Every-Flavor-Robotics/mm-launcher/mm-launch-hw/v3/renders/attempt-1/progress.md

tools: c2c282d
planner | PARTS line added to build_assembly.py; checks.json rewritten for v3 (rows tagged v3-A1) | cadcheck 0F/11W (--only flexures,assembly, run on the unchanged v2 A7 model: 10 vertical-hook flexure warns + 102 not-in-step objects that the work items delete) | 103 screws, 36 parts (PARTS 36 printed, 107 metal)

planner full check | v3 checks.json on the unchanged v2 A7 model (baseline for the work items; cadcheck_planner_baseline.json) | cadcheck 57F/111W: 24 fasteners + 15 slide + 5 clearance + 3 distances + 2 interference + 1 service are rows waiting for the v3 geometry; 7 parts fails are real layer-support fails under the c2c282d printcheck (base_shell 6.0 cantilever at world (-79.5,-108,45); jar_valve lug undersides 5.5 x3 at z 274.9; post_R 11.7 at z 244 and feeder_cover ears 10.5 x2, both removed by merges) | 103 screws, 36 parts

base | partition merged into PRT_base_floor (card guides 1.77+0.3, 2.0 header-side / 0.5 component-side, slot-bottom stop z 13; deck ribs x -62..-56 / -15..-9 end 0.5 over the MotorGo top); buck: flange strips under 2 floor hook rails (45 deg undercut lips, 0.2 gap) to +X end stops, -X held by 2 full-height shell wall ribs 0.3 off (CAPT, no tongue, no flexure); controller: +0.4 fences + 2 in-floor SNAP-IP tongues (L 32 w 2.5, lip 1.0 on the short-edge strips, 12.8/15.4 MPa); floor: 2 +Y SNAP-IP latches (L 35 w 2.5, square barb 1.5, finger-pad holes O9, 16.1/21.4 MPa) + 2 -Y 45/45 detents (L 30 w 3, 0.8, 14.0 MPa) in bridged keeper pockets on the shell wall feet (replaces the planner's -Y rigid hook tabs: a rigid hook cannot leave on the straight -Z drop the slide row tests), 8 shell columns removed; pan drive: plate on 4 deck-post pins O4 x 3.5 with 3 crush ribs (0.15), floor column top 27.8 under the idler boss, clamp deleted, pinion horn pocket 20.2 x 2.7 + 8 pins O2.0 x 2.4; FST_adapter = 2 x M3_pan x 10 (diagonal, cbore 2.4 flush) + 4 deck fences (+X fence from z 76 so the rail stem exits); base_shell anchor top 45 deg (baseline 6.0 cantilever gone); USB-C opening gable top; checks.json: flexures x6 exact, allows floor x shell 58 mm3 / pan mount x shell 3 mm3, 6 new slide rows (buck x4, controller, MotorGo out), 4 accepted_warns (barb/lip ledges, anchor knife edge). Base fails left are other items': FST_post_0..6 blocked by base_shell and base_shell x turntable 0.26 (pan_stage: posts merge, hub tube to hub_gear) | cadcheck 48F/106W full (baseline 57F/111W); --only parts,interference,clearance,fasteners,slide,assembly,insertion,flexures,distances 47F/98W, 0 on base-owned joints; printcheck base_shell,base_floor,pan_servo_mount,pan_pinion 0F/4W | 75 screws, 34 parts (79 metal)

pan_stage | posts merged into PRT_turntable (R_ID, bottom-down; 45 deg cone hub cavity + flat R12.3 roof z 100, 2 closed tunnels 93.6..100.3 with R15 bends, release-slotted hook slots); R20 hub tube on PRT_hub_gear (chamfered top, 3 SNAP-V fingers 12.6 MPa, 3 dogs); groove cap, post_R_cover, feeder_housing gone (beam z 252..263 with feeder.housing_geom, 4 SNAP-V hooks 9.2/12.9 MPa, 3 IF_CROWN_HOOKS slots, servo + idler tongues); servo pocket/idler/passage open to the top, journal plate top-open fork (IF_TILT_FORK_*, launcher.py 4-line edit); adapter HORN pocket 2.7 + 8 pins, key-down cone; splice l 20 z 72..92, every bus lead its own filleted route (params fillet_path); FST_feedmount/FST_fplate deleted with the housing (feeder adds crown hooks) | cadcheck --only interference,clearance,fasteners,slide,service,assembly,insertion,flexures,cables,distances 23F/52W (pan_stage-owned 0F; left: FST_jp x3 launcher, crown/feeder-servo slides + feeder_cover feeder, nip/gate/cover/enc/hinge rows launcher+feeder); printcheck turntable,hub_gear,beam,tilt_horn_adapter,thrust_ring 0F/2W | 38 screws, 29 parts (42 metal)

pan_stage full check | front beam hooks y 18.0 w 3.0 with 1.4 release slots (cleared the 1.9 ledges and 0.16 walls), adapter one solid of revolution, 5 wall/bevel warns triaged in accepted_warns, allow beam x turntable 8.5 (slide measures 7.97) | cadcheck 28F/80W full (45 untriaged; 0 F on pan_stage-owned rows; FST_jp_0..2 launcher, the rest launcher/feeder as before); printcheck turntable,hub_gear,beam,tilt_horn_adapter 0F/0W; stability 31.1 deg; held_poses [] | 38 screws, 29 parts (42 metal)

launcher | FST_nacelle/enc/jp/cover/hinge+nut/nipstop/nipcover/leaf deleted (launcher metal now FST_motor x4 M3_pan x10, FST_fw_bolt x2 M3_cap x20 + 2 nuts, FST_nip_stud M3_hex x16 + FST_tw_nut); nip_stop merged into launcher_body (v2 pad section over x 7.5..31.5; hood end face relieved 0.3 above the pad's top edge so the stop touches face-only, fits contact_normal [0,0.998,0.058]); nip_stop_sleeve = integral R3.6 spigot on nip_wheel (nut slides in a side slot); hinge: O5 body stub into the hood -X bore + hood O5 stub into a journal-plate bore (0.15 radial); journal plate on 3 O5 body pegs (3 crush ribs 0.1 per hole); encoder cap in a nacelle rear counterbore (nacelle +4 rearward, lobe keys the Plink) with 2 SNAP-IP arc arms L18 w1.5 0.6 (14.6 MPa) into groove segments; nip cover: +x 45 deg tongue (1.0 deep) in a land rebate + -x skirt lip in a 45 deg groove in the body's x 4 face (the -x undercut could not print left-wall-down), feet 0.15 off the land, slides off +V (rebates stop it at -V), SNAP-IP detent arm L16 w1.5 0.45 (13.8 MPa); leaf root block down to 0.25 over the land (captive: roof/land/end walls/stud fork); wheel cover: 2 hook tabs under journal-plate pockets + SNAP-IP latch L22 w1.5 hook 0.8 (13.0 MPa) behind a plate lip, slides +Y at tilt 45; checks: allows bounded (cover x jp 3, ecap x nacelle 8, nip cover x body 2.5, body x jp 2), hood bay rays replace the nearest rows, slide/insert dirs, flexure rows exact, stud captive, 6c merged into 6d, 13 accepted_warns (stale removed) | cadcheck 17F/73W full (29 untriaged; 0 F on launcher objects: all 17 are feeder-item rows); --only interference,clearance,fasteners,slide,service,flexures,distances,drop,sightlines,stacks,insertion,assembly 0 launcher F; swept entry arc 8.098/8.222/8.415 >= 8.0; drops 31/31 every pose, flattest 34.5; magnet stack 0.3; printcheck nacelle,launcher_body,journal_plate,launcher_cover,hood,nip_wheel,nip_cover,encoder_cap,nip_leaf 0F/3W | 21 screws, 27 parts (24 metal)

feeder | PRT_feeder_cover merged into PRT_feeder_crown (one top plane z 322: jar stack raised 36 mm, params JAR_LIFT, because the v2 lobe roof stood 36 over the 286 rim and could not print top-down; servo up into the open-bottom lobe, 4 crush ribs 0.1, roof stop + blind idler recess); 3 SNAP-V crown hooks (L16 t1.0 barb 0.55, 10.3/12.3 MPa) through the beam slots; pinion HORN pocket 2.7 + 8 pins, no centre screw; gate SNAP-IP finger (L15 w1.5 bump 0.4, 14.0 MPa) in a +Y cheek closed notch (open notch impossible: cheek face 30 long vs 52 travel; open = positive stop), ray row 0.1; valve-adapter option (b): push fit, key rib + groove, shoulder R28.3 on the cheek tops, 2 SNAP-V cheek fingers 11.0 MPa into a spout groove; valve lugs 50 deg undersides (baseline 5.5 mm cantilevers gone); FST_fcover/fhorn/valve/detent and PRT_gate_detent deleted; allows crown x beam 12, servo x crown 12; 7 accepted_warns (flexures x5 vertical, walls x3, 2 not-proven sampling) | cadcheck 0F/63W full (13 untriaged: 11 launcher/cable/insertion + 2 feeder not-proven, accepted after the run: --only interference 0F/18W, 4 untriaged, none feeder); printcheck beam,feeder_crown,feeder_pinion,feeder_disc,jar_adapter,jar_valve,jar_gate 0F/0W; stability 29.6 deg (31.1 before the jar lift) | 11 screws, 25 parts (PARTS 25 printed, 14 metal: 11 screws + 3 nuts; FASTENERS 4 distinct)

finish triage | 13 old substring accepts -> {check, kind, object, why} (summary.accept_suggestions, 2 stale v2 whys updated), 8 new accepts with measured whys (flywheel 2.9 nut-pocket roofs, journal-plate fork knife edges 0.22, launcher_cover edge-break clamp, 4 hood overtravel 'not proven' cells (cad q sweep >= 0.158/6.5/7.39/7.89), bundle/base hand-over 5.7 chord = v2 A6-02), stale allow BUY_horn_* x PRT_*horn_adapter removed, step 7 pose PIV_tilt 20 (pod insertion warn gone), CAB_encoder moved to S -1.6 in the journal bore (shared-tube warn gone), finish.bom_items rewritten (v3 splice z 72..92, roof z 100, bus z 92, encoder budget text), stale orient strings nip_wheel/nip_cover, v2-A5-03 splice why 25 -> 20 | cadcheck 0F/61W full (0 untriaged, 0 config, unused_allows {}, held_poses [], unordered []) | 11 screws, 25 parts (PARTS 25 printed, 14 metal: 11 screws + 3 nuts)

finish BOM | BOM_AND_ASSEMBLY.md rewritten for v3: evidence summary, purchased parts (17 + 14a), fastener table (5 screw rows + nut row), 25-part table with orientations / g / h / v3 change, assembly steps 1..16 in assembly_order order (24 labels), service table (tool-free except the 2.5 L-key and a flat screwdriver), renders, 61 triaged warns; cad bom PASS 5 rows, 0 disagree, 0 modelled screws in no row | cadcheck 0F/61W | 11 screws, 25 parts

finish renders + final | CAD_RENDER_FINAL view set (iso, iso_front_left, front, side, top, rear, exploded, 4 poses) + 4 sections (hub roof y 4.02, beam hook y 18, crown hook y 0, gate finger z 325.35) in renders/attempt-1; cad printcheck stl --manifest: PASS 25 parts 0F/9W, all fit P1S; final full cad check after the render rebuild: PASS 0F/61W, 0 untriaged, 0 config, unused_allows {}, held_poses [], unordered []; DESIGN_LOG 'Attempt 1 results (finish)' appended (joint table with measured rows, plan deltas, FASTENERS/PARTS lines) | cadcheck 0F/61W | 11 screws, 25 parts (PARTS 25 printed, 14 metal (11 screws, 3 nuts/pins); FASTENERS 11 screws, 4 distinct)

finish deliverables | cad printcheck stl --manifest re-run: PASS 25 parts 0F/9W (all 9 accepted); cad sheet -> renders/attempt-1/stl_sheet.png; blender/cadcheck.json (04:12 full run) copied to renders/attempt-1/cadcheck.json; cad bom PASS 5 rows 0 disagree; coverage/not_checked quotes appended to BOM section 8 and DESIGN_LOG Attempt 1 results | cadcheck 0F/61W | 11 screws, 25 parts

## Plan
Joint table and architecture: ../../DESIGN_LOG.md "Attempt 1: plan". Targets: 14 metal (10 screws + 4 nuts), 4 specs, 25 printed.
Kept metal: FST_motor x4 (M3 pan x10), FST_fw_bolt x2 + nut x2, FST_nip_stud + FST_tw_nut, FST_pinion_ctr + FST_tilt_horn_ctr (M3 cap x6), FST_adapter x2 (M3 pan x10, was 4 x csk 20).
Merges: post_L+post_R -> turntable; feeder_housing -> beam; feeder_cover -> crown; base_partition -> floor; nip_stop -> launcher_body; nip_stop_sleeve -> nip_wheel.
Eliminated: groove_cap (tunnels + bore roof, splice from below), post_R_cover (top-loaded tilt servo, beam locks it), pan_servo_clamp (floor column), gate_detent (finger in the gate).
Work items in order: 1 base, 2 pan_stage, 3 launcher, 4 feeder, 5 finish. Each: edit its module, cad build, cad check --only <its sections>, fix fails, append a line here.
Row ownership: every checks.json row tagged v3-A1 belongs to the item named in its text; `_todo` keys say what to make exact.

## Tool issues
- launcher: fits contact_normal only tests the first object's triangles, so any edge of the stop face lying inside the other part's face puts the neighbouring face in the contact and fails it (worked round with a 0.3 relief on the hood end face). slide_out `flex` names the stationary part, so a snap arm that rides ON the mover can only be bounded through its allow's max_mm3.
- none blocking. cadlib has no snap / bayonet / dovetail helper (snaps are built from G primitives); `flexures` warns (not fails) on vertical hooks under 15 MPa, so they go to accepted_warns with the stress.
- accepted_warns: all 22 carried entries use the deprecated substring "match" form (config warn); the finish item rewrites them as {check, kind, object, why}.
- feeder: distances `ray` rows cast +dir to b and -dir to a from the origin, so the origin must sit in the gap (an origin inside a reads the wrong face; checks-config does not say so). Planner joint-table items that were geometrically infeasible: crown top-down with the lobe roof on the bed (needs one top plane), gate open notch in the +Y cheek, valve bayonet keyed by the gate lug.
- finish: the acceptance line 'PARTS 25 printed, 14 metal (10 screws, 4 nuts/pins)' / 'FASTENERS 10 screws' cannot be met without relabelling the M3_hex nip stud as a pin; the build counts it as a screw (11 + 3 = the same 14 pieces, 4 specs). Left as built; DESIGN_LOG 'Deltas from the plan'.
