Every-Flavor-Robotics/mm-launcher/mm-launch-hw/DESIGN_BRIEF.md

# M&M Launcher Turret: Design Brief

> **Change notice (after attempt 1 started):** the encoder magnet goes on the motor's **rear** shaft, through the end-cap access hole. See the BLDC row. Any design that puts the magnet on the front shaft or flywheel must be updated, and reviewers should flag it.
>
> **Change notice 2:** the MotorGo Axis USB-C location is now confirmed. It is a vertical-mount port (see the MotorGo row), so the cable exits perpendicular to the board face. Designs must provide a plug cutout and cable exit path that match it, and reviewers should check it.
>
> **Change notice 4:** an exact MotorGo Axis model is now in `reference/mg_axis.step` / `.stl`. Use it for the placeholder, the standoff height (header pins reach 7.25 mm below the board), and the USB-C cutout position.
>
> **Change notice 3:** servo horn (round 8-hole disc, recess plus drill-through-as-template) and servo controller (58 x 42 PCB, drill-to-fit bosses plus a locating pocket) are now specified in the component table.

A desktop turret that holds a hopper of standard M&Ms (plain, about 13 mm across and 7 mm thick, lentil shaped), feeds them one at a time into a spinning flywheel, and launches them at an adjustable speed. Pan/tilt aiming. It's controlled from a browser over WebUSB, and the browser shows the CAD moving live, so moving parts must be separate objects with clean pivots.

## Hard constraints
- **Material:** all structure is PLA. No TPU. The wheel grip surface is hockey tape or similar wrapped on a PLA rim, so leave a tape land on the rim (flat, about 12–15 mm wide). Make wheel-to-hood compression adjustable (slots or shims), because grip and pressure will be tuned by hand.
- **Printers:** Bambu Lab H2D (single-nozzle build volume 325 x 320 x 325 mm) and P1S (256 x 256 x 256 mm). Prefer every printed part to fit the P1S. Parts must print without heavy supports: a flat face on the bed and overhangs of 45° or less, or bridges.
- **Assembly:** one person with a DeWalt hand drill and a full bit set, superglue, hot glue, M3 machine screws (use heat-set inserts only if needed; prefer nut traps or self-tapping M3 into 2.5 mm pilot holes), and self-tapping M3 screws. No other fasteners or bearings are assumed. If a 608 bearing or a lazy-susan bearing would help a lot, it may be listed as optional, but the design must work without it.
- **Cables:** every cable has a planned path: motor phase leads (3 x Ø4 bullet leads, 80 mm), JST 5-pin encoder cables, the servo bus daisy chain, 12 V power, and a USB-C cable from the MotorGo Axis out to a laptop. No visible loose wires. Cables crossing the pan axis need a defined pass-through and slack loop for ±90° pan or more.
- **Power:** a DeWalt 20V battery slides onto the DeWalt adapter, which feeds the 12 V buck converter, which feeds the MotorGo Axis (6–17 V input) and the servo controller board. The battery must be removable without tools. The buck converter needs airflow around its fins.

## Components (purchased, model as accurate placeholder solids in a `Purchased` collection)
Reference files are in `mm-launch-hw/reference/`. Read the PNG drawings.

| Part | Qty | Key dims (mm) | Notes |
|---|---|---|---|
| MotorGo Axis (ESP32-S3 BLDC driver) | 1 | **Exact model: `reference/mg_axis.step` / `mg_axis.stl` (user-supplied; import the STL as `BUY_motorgo_axis`, don't hand-model it).** Envelope 65.0 x 57.25 x 19.47. STEP frame: origin at the top-left mounting hole centre, +X along the 65 mm edge, the board extends toward -Y, and the PCB is at z 0 to about 1.7 (component side +Z). 4 x Ø3.4 mounting holes on a 58.0 x 49.0 rectangle. The tallest top part is the header strip along the top edge, reaching z = 9.0. **That header's pins stick out 7.25 mm under the board (to z = -7.25)**, so use standoffs of 8 mm or more, or a relief slot under that strip. Other undersides are flat. **USB-C measured from the STEP: a vertical receptacle centred at (57.6, -14.0) with its opening facing +Z at z = 7.97.** | `motorgo_axis_dims.png`. Motor phase pads (J6/J8) are along one long edge. **USB-C (user-confirmed, top-right of `motorgo_axis_dims.png`):** a **vertical-mount** receptacle. The cable plugs in perpendicular to the board face, not from an edge. In that image's orientation (header strip along the top edge, motor pads J6/J8 along the bottom edge), the port's centre sits 3.9 mm in from the right edge and 17.5 mm down from the top edge. Its 8.9 x 3.4 mm opening (r1.7 ends) runs with the long axis parallel to the 57.2 mm side. Mount the board so that, directly over the port, a cutout in the enclosure wall or lid clears a USB-C plug overmold (about 12.5 x 7 mm, 1 mm clearance all round). Leave about 25 mm of straight plug length, then a smooth exit path with a bend radius of 15 mm or more toward the rear of the base. A natural layout puts the board face against an enclosure wall so the plug passes straight through it. Add strain relief for the cable (a hot-glue or zip-tie anchor point) so tugs don't load the port. Two encoder JST connectors. |
| Plink magnetic encoder (MT6701), JST 5-pin cable | up to 2 | PCB 20.0 x 23.0 x 4.6 | `plink_encoder.step` / `.stl`. Sensor must face a diametric magnet (about Ø6 x 2.5) on the motor axis, 0.5–2 mm air gap, coaxial within 0.3 mm. `prior_plink*.stl` are earlier holders/cases you can learn from. |
| XTEAM XTI-3674 1900KV inrunner BLDC | 1 | Body Ø35.9 x 74; shaft Ø5 x 21 (14 mm D-flat), front only; front face 4 x M3 on a Ø25 circle; leads exit the rear side | `bldc_xteam_3674_drawing.png`. **Rear shaft access (user-confirmed):** the rear end cap has a small central opening that exposes the rear shaft end. Glue the diametric encoder magnet to the rear shaft end, and mount the Plink encoder behind the motor's rear face, coaxial and with a 0.5–2 mm air gap. Use parameters for the opening and shaft end: default access hole Ø8, shaft end flush to 1 mm recessed. The phase leads exit the rear side, so the encoder mount must clear them. Don't put the magnet on the front shaft or flywheel. |
| Hiwonder bus servo (HTS-35H class) | up to 3 | Body about 40 x 40 x 20.14; output spline on the top face (protrudes 3.9), a coaxial idler boss on the bottom face (3.9) | `servo_hiwonder_drawing.png`. The spline is offset toward one end. Mounting holes are tapped on the case faces, so take a pocket/clamp mount. **Horn (user-confirmed):** a standard round disc RC horn with 8 holes in a concentric pattern around the centre. Parameters: default disc Ø20 x 2.5 thick, 8 x Ø2.2 holes on a Ø14 bolt circle. Each driven part has a shallow (1.0 mm) locating recess sized to the disc (+0.2 mm) so the horn self-centres. Pilot marks only, no pre-printed holes: the user drills through using the horn as a template and fixes it with screws through the horn holes, plus superglue. Keep the horn interface a separate adapter part that's easy to modify. Daisy-chained 3-pin bus. |
| Hiwonder bus servo controller board | 1 | **PCB 58 x 42 (user-confirmed)**; about 14 mm tall components on top, 2 mm under; the white 3-pin ports overhang the long edges by about 1.5 mm | `servo_controller_board_photo.png`. **The M3 hole positions are unconfirmed.** From the photo, the best guess is 4 x Ø3.2 holes on a 51 x 35 rectangle, centred, about 3.5 mm from each edge. Design for drill-to-fit: solid bosses (Ø7) with only a centre-punch dimple at the guessed position, so the user drills pilot holes through the actual board and fixes it with self-tapping M3. Also add a perimeter lip or pocket (+0.4 mm) that locates the PCB without relying on hole position. Layout from the photo: 5 bus ports down each long edge (cables exit sideways), USB-A and micro-USB on the top edge, the power slide switch and Program/Run buttons on the bottom edge, and the blue 2-pole screw terminal at the bottom-right. Keep the power screw terminal, power switch, and 3-pin bus ports reachable. Connect its UART header to the MotorGo. |
| DeWalt 20V battery adapter | 1 | 86.6 x 59 x 23.4; 4 corner screw holes on top | `dewalt_adapter_buck_12v_dims.png`. The battery slides onto it (battery envelope about 115 x 76 x 70; keep clearance for 5Ah packs). |
| 12V buck converter (finned) | 1 | 73.8 x 73.8 x 31 with flange mounting holes | Same PNG. The wire bundle exits one side. |
| DeWalt 20V battery | 1 | about 115 x 76 x 70 envelope (fits both the user's 2Ah and 5Ah packs; keep it) | It's the heaviest item, so put it low for stability. |

## Functional requirements
1. The hopper holds at least 60 M&Ms and has a lid. It feeds reliably with no bridging: steep walls (≥ 50°), plus an agitating, indexed feeder (for example a pocketed rotary disk driven by servo #3) that releases exactly one M&M per fire command.
2. The feed path delivers the M&M into the wheel/hood nip at a defined point. A single PLA flywheel (rim about Ø60–80 mm with a tape land) is direct-driven by the 3674 on the 5 mm D-shaft (M3 set screw and nut trap, or a clamping hub). It needs a curved hood or backplate with an adjustable gap of about 9–12 mm before tape, and a muzzle that sets the exit direction. Target wheel speed is 3,000–6,000 rpm.
3. The wheel must be fully guarded except for the feed entry and the muzzle. Nothing should be able to fly off sideways.
4. Pan servo (≥ ±90°) and tilt servo (about 0 to +45° elevation), with the load path carried by printed structure, not the servo spline alone, wherever practical.
5. The encoder is mounted rigidly and coaxially with the motor shaft and is serviceable.
6. All electronics are mounted with screws and enclosed or tidily exposed, with access to the USB-C, servo controller ports, power switch, and battery. There is an air path for the buck converter and the MotorGo.
7. Stable: it doesn't tip at full tilt or pan, and it stays put when firing.

## Aesthetic goals
Looks designed, not slapped together: consistent fillets and chamfers, a coherent form language, aligned parting lines, hidden fasteners where practical, concealed cable channels, and visual unity between the base, turret, and launcher. Render with a restrained palette: printed parts in two coordinated PLA colors, and purchased parts in realistic neutral colors.

## Deliverables (all under `mm-launch-hw/`)
- `blender/build_assembly.py`: a **parametric** Blender Python script (Blender 5.1, run headless with `/Applications/Blender.app/Contents/MacOS/Blender -b --python <script>`) that builds the whole assembly from named parameters at the top. Use collections `Printed`, `Purchased`, and `Fasteners`. Name objects `PRT_<part>` / `BUY_<part>`. Moving links get empties as pivots: `PIV_pan`, `PIV_tilt`, `PIV_flywheel`, `PIV_feeder`, parented so that rotating an empty moves its subtree. Use bmesh/modifiers (booleans, bevels) so the printed parts are manifold solids.
- `blender/mm_launcher.blend`: the saved assembly.
- `stl/<part>.stl`: one file per printed part, in its print orientation, in mm.
- `blender/checks.py`: an automated report written to `renders/attempt-N/checks.json` covering every printed part's manifold status (non-manifold edge count), bounding box against the P1S and H2D volumes, pairwise interference between parts (BVH overlap), and estimated print time/filament (volume-based).
- `renders/attempt-N/`: PNG renders at 1600 px or more: iso, front, side, top, rear (cable side), exploded view, a section through the launcher (wheel, hood, feed), and pan at -90/+90 with tilt at 0/45.
- `BOM_AND_ASSEMBLY.md`: parts list, print settings per part (orientation, supports yes/no, infill), fastener list, and numbered assembly steps for one person.
