Every-Flavor-Robotics/mm-launcher/mm-launch-hw/v2/renders/attempt-2/progress.md

tools: 6b62667

## Tool issues
- Pin synced to 6b62667 (was 2197aac in attempt 1). The attempt-1 workaround for `distances` rows naming missing objects (KeyError in check_distances) still applies: every new distances row names only objects that already exist; rows for new parts (PRT_nip_stop, PRT_nip_stop_sleeve) are `fits` rows, which match by glob and don't crash.
- cadcheck can't express "line of sight from outside to a printed part is clear" (the ray_gap distances measure each object on its own BVH, `service` only tests FST_ objects, and `exposure` only covers cables and nuts). A1-02 (thumbwheel reachable through the nip cover) is therefore proved with `cad q ray` lines plus a section render, not a checks.json row.
- cadlib has no prismatic joint (asm.joint is rotary only), so the review's `PIV_gate 0..52` isn't possible. The gate's open (running) state is covered by the `slide_out` row "v2-A1-09 gate opens +X 52" with the valve present instead.
- cadcheck `slide_out` can't assert "must be blocked past X" (a blocked slide is always a fail), so the gate's open end stop is a design feature checked by a section, not a row.
- `cad q ray --pose` takes world-frame origin and direction, so a ray from a pod point has to be transformed by hand for tilt 45.
- Check config before modelling, run on the attempt-1 model.blend: 12 F / 36 W (/tmp/a2_precheck_full.json). New rows that fail on A1 geometry, and so would catch each issue: A1-01 (hood/body moving fit 0.39 at hood -0.51; hood/body 0.43 at the gap-5.3 stop, 0.23 at +1 deg past it; hood/wheel 3.23 at +1 deg past it), A1-03 (pocket rays 14.77/15.00 > 14.5), A1-04 (service FST_fhorn_ctr blocked by the housing at 8 mm), A1-05 (feedmount_0/1 to pinion 1.09/1.08 < 2.35), A1-11 (3 rays from the controller to the +X wall miss through the notch).

## Steps
checks | checks.json: attempt-2 rows (v2-A1-NN) for A1-01/02/03/04/05/06/07/09/11 plus the journal audit; precheck on the A1 model | cadcheck 12F/36W (expected: the new rows fail on A1 geometry)

## Plan
Attempt 2 fixes the 5 majors and the cheap minors from review 1 (7/7/6), without touching what it praised: the feed path and index, the jar handling, low CG, the service slides, and 0 fastener fails. Build order is params, pan_stage, launcher, feeder, base, then finish. For each one: edit, `cad build`, `cad check`, and append a line here. Every new row is tagged v2-A1-NN in checks.json.

0. **params (planner IF change).**
   - IF_FEED_BOLTS[0:2] (-36,±18) -> (-36,±21). The pilot sits 28.7 from the pinion axis, which leaves a 3.1 wall to the R24.35 chamber.
   - NIP_SET = (5.3, 7.0) and HOOD_GAP_MIN = 5.3, so HOOD_HI = solve_eps(5.3) = +1.315 deg.
   - New HOOD_LO = the leaf-lift limit above the static max: -0.558 - 1.49 = about -2.05 deg (gap about 8.4). Compute it in launcher_geom.report(). The leaf travel of 1.5 at the stud bottoms on the cover shell.
   - POCKET_D 15 -> 14.4, with POCKET_CH = 1.0.
   - JIG_SPIGOT_D 7.8 -> 7.9 and PLINK_PEG_D 2.4.
   - Gate tab params (R6, flush ±1).
   - Colour map: B (terracotta) = the candy path plus touch points: jar adapter, valve, gate, feeder housing/spout, disc, launcher_body (chute + muzzle), hood, flywheel, thumbwheel. A (grey) = static structure and drivetrain.
1. **pan_stage.** The beam holes follow IF_FEED_BOLTS. Add a step-7 note: the pod drops in nose-up at 20 deg (row v2-A1-06).
2. **launcher (A1-01, A1-02, A1-07, A1-08).**
   - Add PRT_nip_stop: a printed 3x20 land screwed to the guard bay floor (1 x M3 from outside), which the hood back face lands on at gap 5.3. It is a broad face away from the chute entry.
   - Open the bay so the hood keeps ≥ 0.5 to the body over the whole new PIV_hood range.
   - Add PRT_nip_stop_sleeve: a stud sleeve between the hood back face and the thumbwheel (carried on PIV_hood). The thumbwheel bottoms on it at gap 7.0.
   - Add a finger slot 22 x 7 in the nip cover over the thumbwheel rim, with the rim ≥ 2 proud. Put it where a 16 mm finger reaches at tilt 0 and 45; the -v end, away from the post, is the likely spot.
   - Hood nip edge ≥ 1.6; journal-plate ceiling as a 45 deg roof; declare the flywheel 1 mm flange ring.
3. **feeder (A1-03, A1-04, A1-05, A1-08, A1-09, A1-10).**
   - Pocket Ø14.4 + 1x45 rim chamfer.
   - Delete FST_fhorn_ctr: the 4 M2 screws hold the horn to the pinion, and the servo lifts +Z off the spline. Update BOM step 10b.
   - Crown pilots at ±21.
   - 0.8 flats on the baffle and blade knife edges (wall ≥ 1.2).
   - Gate: R6 EB1 tab flush with the valve OD ±1, a positive end stop at 52, and the valve guide clearance ≥ 0.3.
   - EB 1.0 on every feeder part; crown and cover corners R4 -> R6.
4. **base (A1-11).** Replace the 52x24 notch with switch and terminal cutouts plus a printed bezel, keeping them clear of the rows at y 32/50/68, z 14.
5. **finish (A1-12).** Reassign the colours, make BUY_jar a transmissive (alpha) material in the view set, rebuild cg_grid, renders + sections (nip stop, finger slot, pocket with --lentil pair), BOM/DESIGN_LOG.

Acceptance: 0 F, and every v2-A1 row passes. The reviewer's lentil-pair probe (review/add_mm_probe.py, moved to x 7.2/14.4) must overlap. Run `cad q ray` through the finger slot and confirm the first hit is PRT_nip_wheel at tilt 0 and 45.
Deferred:
- Gate detent bumps: a snap overlaps its guide by design, and an `allow` would hide the gate/valve fit. The end stop is enough for now.
- The base_shell x turntable contact fit, which hides the R20 journal: the thrust and journal faces share one pair, and the tool has no per-region fits.
- Stability pose cap (a tool limit); the 64-pose cg_grid stays as the evidence.
params (planner IF change) | IF_FEED_BOLTS -X pair y +/-21 (pilot 28.66 from pinion, wall 3.06; feedmount 3.52 >= 2.35 pass); NIP_SET (5.3,7.0), HOOD_GAP_MIN 5.3, HOOD_HI +1.315, HOOD_LO = -0.558 - 1.493 leaf lift = -2.051 (gap 8.35, HOOD_GAP_MAX derived; printed by launcher_geom.report()); POCKET_D 14.4 + POCKET_CH 1.0 (pocket rays 14.22/14.28 pass); JIG_SPIGOT_D 7.9, PLINK_PEG_D 2.4/HOLE 2.5; gate X1 34.5 flush with valve OD (+0.5), GATE_TAB_R 6, GATE_EB 1, GATE_STOP_X 25; COLOUR_B map + apply_colours() in build_assembly; stacks magnet 0.30<=0.30 no warn, pocket 0.67<=0.8 pass. New fail for launcher: body x nip_cover 29.4 mm3 (narrower bay hull pokes 0.75 past the land face at v 12..20) | cadcheck 9F/37W
pan_stage | beam csk holes already loop over IF_FEED_BOLTS, so the -X pair moved to (-36,±21) with the params change (cad q inside: (-36,±21,256) -> FST_feedmount_0/1 only; old (-36,18,256) -> PRT_beam solid); feedmount_0 straight 54-58 reach, feedmount_1 L-key arc 180 (nacelle at 23.9), both pass; feedmount-pinion 3.52 >= 2.35; step-7 nose-up 20 deg note in pan_stage docstring + BOM step 7 (slide v2-A1-06 passes, 0.2 to post_L at tilt 20); BOM step 11 text updated. No fails involve pan_stage objects; pan_stage warns (beam overhang 205 mm2, hub_gear wall 1.54, post_R x journal_plate at 47.5) identical to precheck | cadcheck 9F/37W
launcher (A1-01/02/08) pass 1 | PIV_nip_lift (leaf lift, thumbwheel+nut) splits PIV_hood (setting -0.558..+1.315, hood/stud/sleeve); PRT_nip_stop pad under the muzzle floor + hood front lug (3.4 x 20 land, contact at +1.315), FST_nipstop M3x6; PRT_nip_stop_sleeve R3.8 x 8.86 (contact at -0.558); STUD_L 16, STUD_HOLE_R 4.4; bay to +2.415 with true normal offset 0.55 (funnel was 0.46) and 48-gon boss; hood flange relief (arc about the flange corner, hood/flywheel 4.10 at +2.315); land-face slab cut (body x nip_cover 0); nip cover -v wall at v -6.5 + finger slot 22 x 7.5, leaf tip -3.5 (open fork); journal plate 1.6/45deg/1.6 lap, journal base re-added after the chamfer; checks.json: fits body x nip_wheel contact, 6c/6e assembly objects | cadcheck 4F/48W (no launcher fails; 4 = feeder FST_fhorn_ctr + 3 base servo_controller rays)
launcher (A1-01/02/08) pass 2 | hood: -v half of the stud hex pocket opened as a U-slot through the 26 deg back face (min wall 0.91 -> 2.25), spot 1.6 deep; relief as an R4.1 arc about each flange corner (step groove stalled 5/31 rays) -> drops 31/31; journal plate lap 1.6/45/1.6 + journal re-added after the chamfer (bridge 47 -> 11.4); nip stop pocket floor-cut 3 mm behind the face (0.2 sliver gone), pilot to the screw tip; DESIGN_LOG attempt-2 launcher section + flywheel flange ring declared | cadcheck 4F/47W (no launcher fails)
launcher acceptance (cad q, model after pass 2) | dist PRT_hood/PRT_nip_stop @hood+1.315 = 0.000 (+0.815: 0.603); dist PRT_nip_stop_sleeve/PRT_nip_wheel @hood-0.558 = 0.000 (-0.458: 0.107); sweep hood/body hood -0.558..2.4 (lift 0) and -0.558..1.315 (lift -1.493) min 0.50 (x wall); finger-slot rays origin nip(x 15.5/19.5/23.5, u 1/2.5/4, v -22) dir +V: tilt 0 first hit PRT_nip_wheel 9/9 (14.4-15.5 mm, e.g. 19.5,-2.330,111.274 -> 19.5,-6.917,124.924), tilt 45 first hit PRT_nip_wheel 9/9 (e.g. 19.5,77.315,143.401 dir 0,-0.895,0.445 -> 19.5,64.42,149.81) | cadcheck 4F/47W
feeder (A1-03/04/05/08/09/10) pass 1 | disc pockets as revolves Ø14.4 + 1x45 top rim chamfer, land top EB 1.0; FST_fhorn_ctr deleted (checks.json step 10b: no centre screw); crown lobe + cover plan corners R6, G.bevel EB 1.0 on housing, crown, cover before cuts; valve profile EBs (skirt foot 0.6, top 1.0), lead-in r0 30.4 -> 29.8, cheeks rooted 1 mm down + EB; baffle outer R31 -> R30.4 (coincident R31 facets with the skirt were the 0.02 slivers) + 0.8 ramp-foot flat; gate R6 plan corners, EB 0.6 blade / 1.0 tab, R6 tab to z 297, GATE_Z +0.35, CHEEK_Y 28.4, slot X0 -27.4, spout Z0 290.7; first open stop = lug under the blade in valve-floor grooves | cadcheck 3F/49W (feeder service fail gone; gate lug on the bed: 18 mm2 bed contact + 55 bridge; cover R6 corners 1.08 over the pocket corners)
feeder pass 2 | stop lug moved on top of the blade's -X end (1.5 x 6 x 1.2) riding in two spout-tip notches (through at -X, blind at +X, shoulder x 26.85 backed by a R28.6 OD boss, 45 deg back), pads raised clear of the lug; gate knife flat 0.8 -> 1.0 (0.8 left a 1.15 probe where the chamfer meets the side EB); COVER_BOX x0 -1, hy +1 (R6 keeps 2.2 over the pocket corners) | cadcheck 3F/47W
feeder pass 3 | adapter flange EB 1.0 -> 0.6 (1.6 flange keeps 1.6), pad bottoms at 292.0 (1.7 under the screw hole); crown land-bore/pinion-chamber fin removed for |y| < 7.3 (was 0.95) | cadcheck 3F/45W (no feeder fails; 3 = base servo_controller rays)
feeder acceptance (cad q / cadcheck, final model) | pocket rays x 14.40 / y 14.40 (13.6..14.5); lentil pair (add_mm_probe.py copy, /tmp/feeda2/probe.py) x 7.0/14.0 overlaps disc 0.577 mm3 each, x 7.2/14.4 0.073/8.439; index +60 1 window [50,60], -60 1 window [-60,-50], column 0 windows at drift 0/5/10/15; service FST_fhorn_ctr row matches nothing (8 ops), slide 'v2-A1-04 feeder servo lifts +Z' not blocked (0.00 = pocket floor); feedmount_0/1 to pinion 3.517/3.517; crown 0 wall samples < 1.6 anywhere (thin probe /tmp/feeda2/thin.py); slide 'v2-A1-09 gate opens +X 52' min 0.35 (adapter), probe slide to 54 blocked by PRT_jar_adapter at 52.5 (shoulder 52.35); gate +X end x 34.5 vs valve OD 34.0 (+0.5); walls: gate 1.31, valve 1.29, adapter 0 samples < 1.6 | cadcheck 3F/45W
base (A1-11) | 52x24 +X notch replaced by a switch window (y 42..57) and a terminal window (y 60..73.5), both z 15.5..22 (1.5 above the z 14 rows), square world-bottom edge (16 mm bridge printed deck-down), 0.8x45 lead-in, one integral bezel frame 2.5 wide x 1.2 proud (world-top side 32 deg from vertical, bottom side 0.5 bp so the rail under the windows keeps 1.6); CTRL_SW / CTRL_TB / CTRL_WIN_* / CTRL_BEZEL in params; BUY_servo_controller gains slide switch + lever (OFF) and 2-pole terminal on its +X (bottom) edge from the REF photo. Rows v2-A1-11 y 32/50/68 = 0.5/0.5/0.5 (0.3..6.0); battery slide 120 min 1.6 (>= 1.0); cad q ray 200,{32,50,68},14 -1,0,0 -> PRT_base_shell at x 120/121.2/121.2; ray 200,47.6,17.5 -> controller lever at x 112.5; ray 200,66,18 -> terminal at x 115.5; preview renders/attempt-2/base_ctrl_bezel.png. Earlier passes: lead-in rounded corners gave 156 mm2 overhang, bezel bottom rail 1.44 wall -> both fixed | cadcheck 0F/44W
finish pass 1 | parts/finish.py added as the last subsystem (owns apply_colours, moved out of build_assembly; BUY_jar glass JAR_GLASS_RGBA alpha 0.25, Workbench honours it: fill visible through the glass in /tmp/fin2/jar_test.png); cg_grid 64 poses worst tip 29.9 deg (jar 0, tilt 46, pan 180, 3935 g incl. jar 350 + fill 400 + band 15) -> renders/attempt-2/cg_grid.txt; cadcheck stability 33.5 deg | cadcheck 0F/44W
finish renders + sections | view set (iso, iso_front_left, front, side, top, rear, pan+90_tilt45; jar glass reads transmissive, fill visible), sections sec_nip_stop_x19.75_hood+1.315 (hood lug on the pad), sec_finger_slot_x19.5, sec_pocket_y18.19_lentil_pair (--lentil 7.2/14.4); cad q: hood/nip_stop @+1.315 0.000, sleeve/nip_wheel @-0.558 0.000, finger-slot rays tilt 0/45 first hit PRT_nip_wheel at 14.4, lentil pair 7.2/14.4 overlaps disc 0.073/8.439 mm3; 12 renders total | cadcheck 0F/44W
finish docs | BOM_AND_ASSEMBLY.md -> attempt 2 (evidence summary, nip stops, pocket/lentil probe, colour table from manifest + COLOUR_B, nipstop fastener, 6c/6e steps, finger-slot service row, renders, 44 warns, not-done); DESIGN_LOG '## Attempt 2' with every v2-A1 row -> value and the cg_grid result; no geometry change | cadcheck 0F/44W
finish final renders | 6c step label M3 x 10 -> M3 x 6 (matches FST_nipstop); CAD_RENDER_FINAL view set 1800x1350 (11 views incl. exploded, jar_unlocked, tilt45, pan-90_tilt0); stl_sheet.png 35 STLs; cadcheck.json copied | cadcheck 0F/44W
finish close-out | checks.json step 7 label (nose-up 20, v2-A1-06); BOM section 6 final set + stl_sheet, section 8 resolved items removed, line-of-sight note for v2-A1-02; DESIGN_LOG attempt 2 close-out + verbatim not_checked; cadcheck.json recopied (03:13) | cadcheck 0F/44W
