Every-Flavor-Robotics/mm-launcher/mm-launch-hw/reference/bldc_xteam_3674_drawing.png

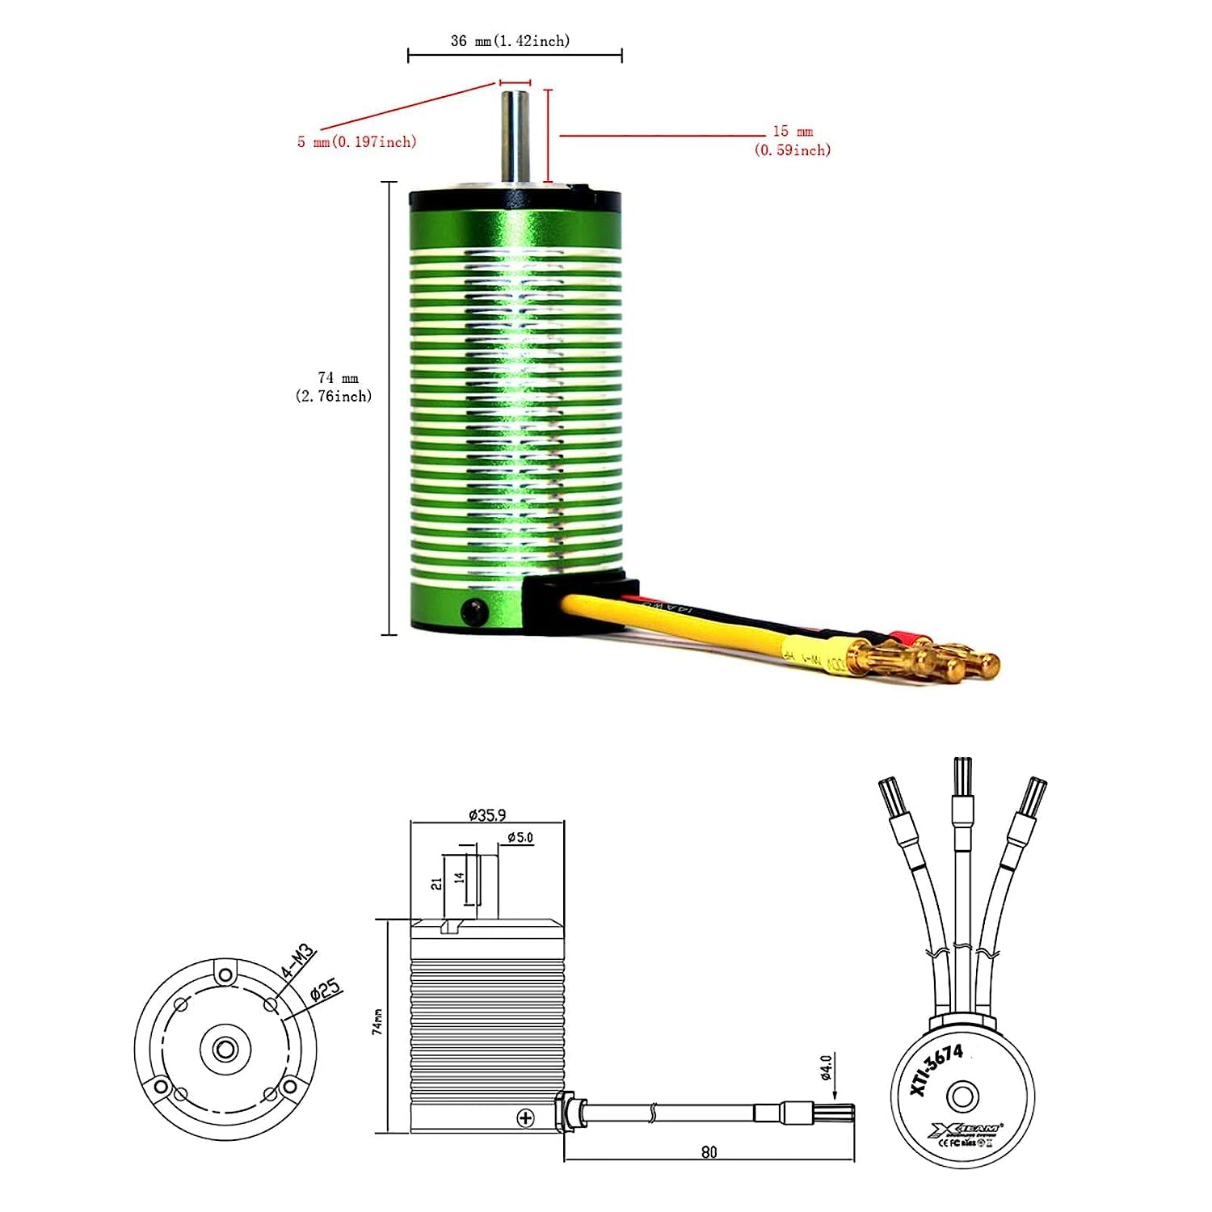
mm-launch-hw/reference/bldc_xteam_3674_drawing.png
