Every-Flavor-Robotics/mm-launcher/mm-launch-hw/reference/dewalt_adapter_buck_12v_dims.png

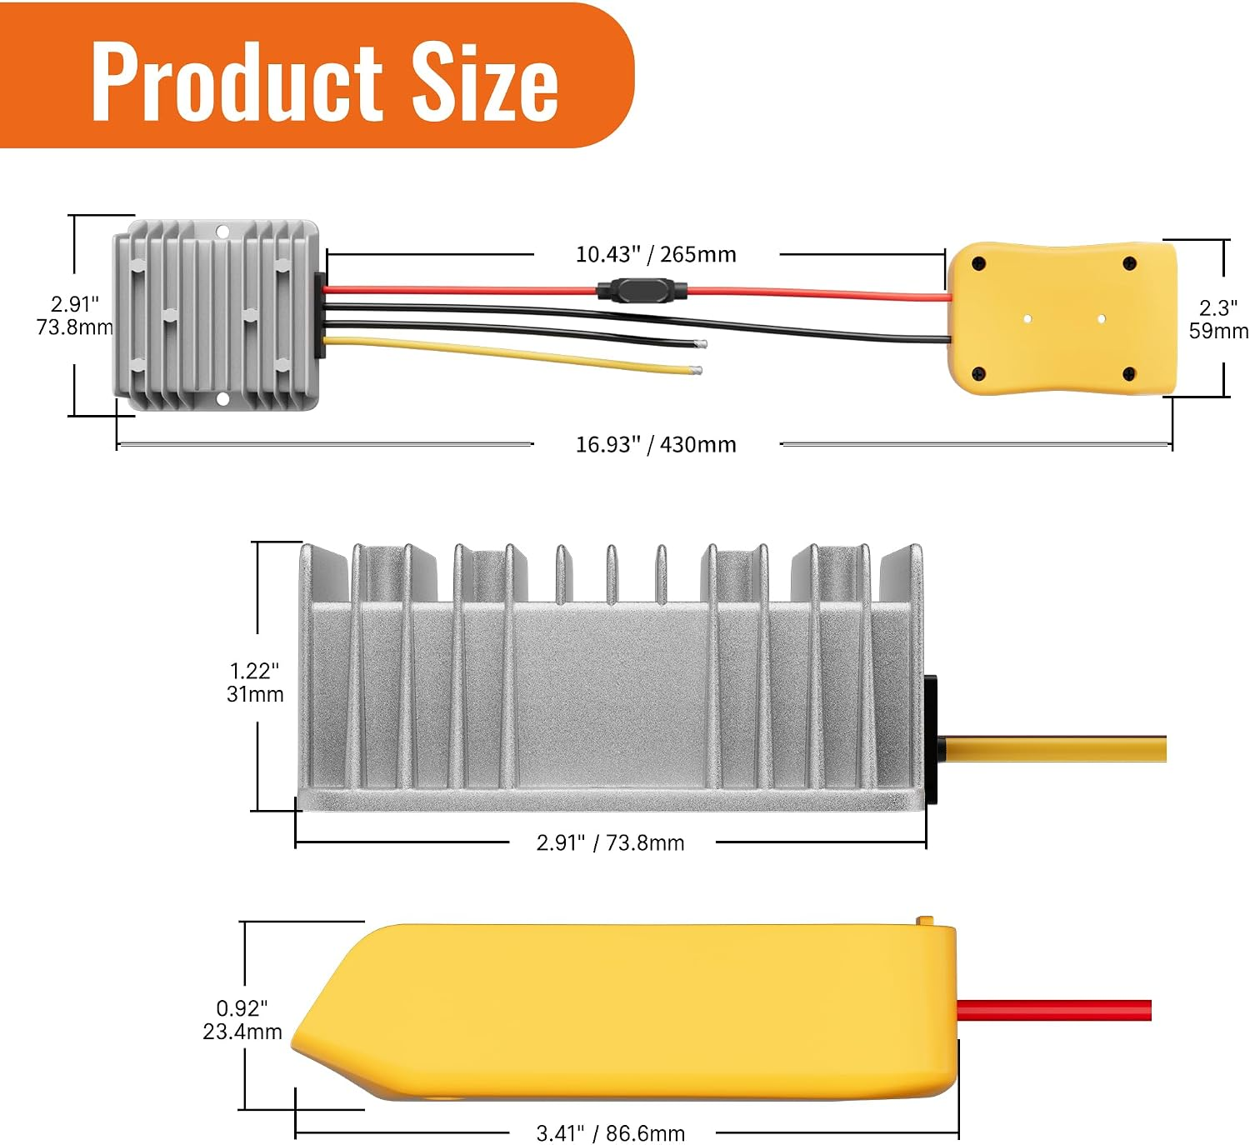
mm-launch-hw/reference/dewalt_adapter_buck_12v_dims.png
