Every-Flavor-Robotics/mm-launcher/mm-launch-hw/reference/motorgo_axis_dims.png

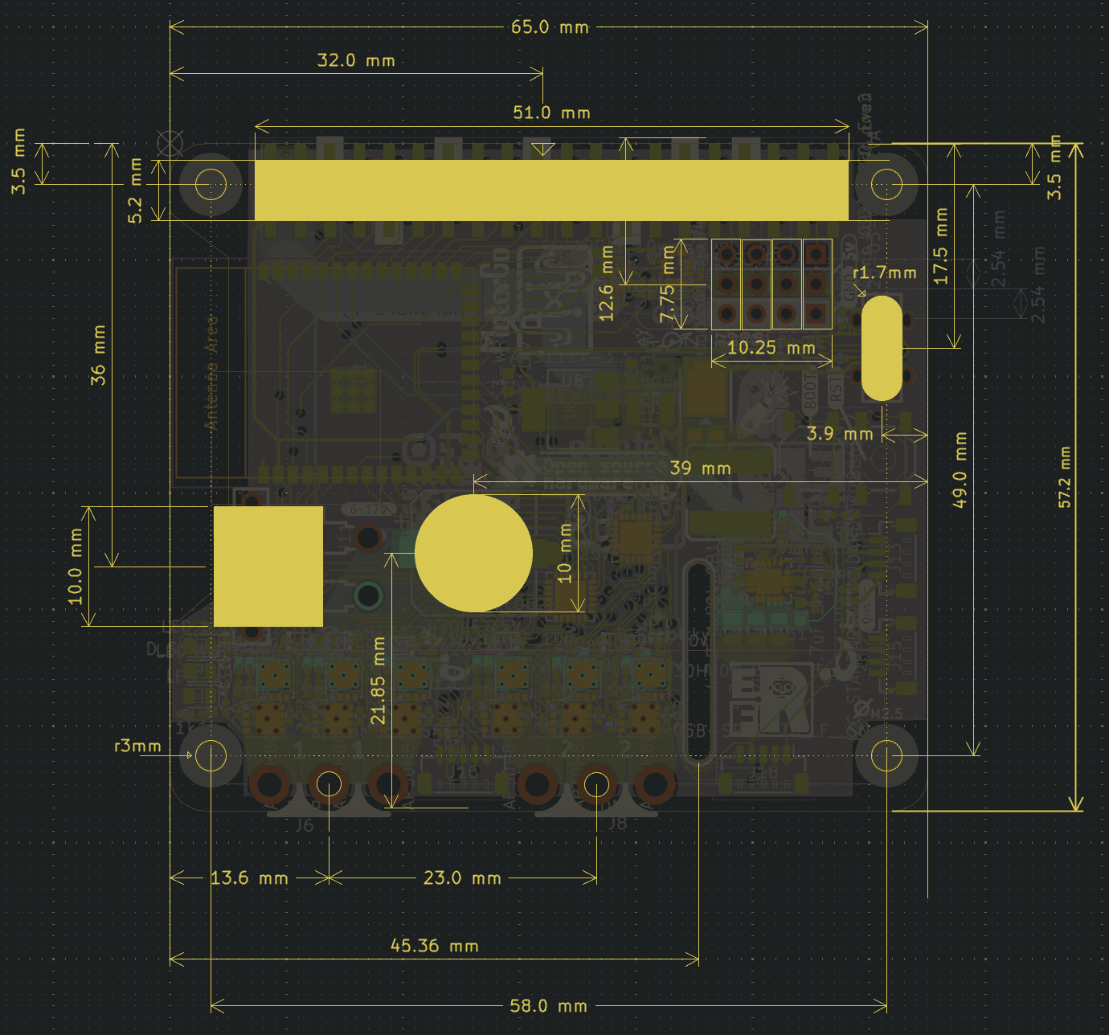
mm-launch-hw/reference/motorgo_axis_dims.png
