Every-Flavor-Robotics/mm-launcher/mm-launch-hw/reference/servo_controller_board_photo.png

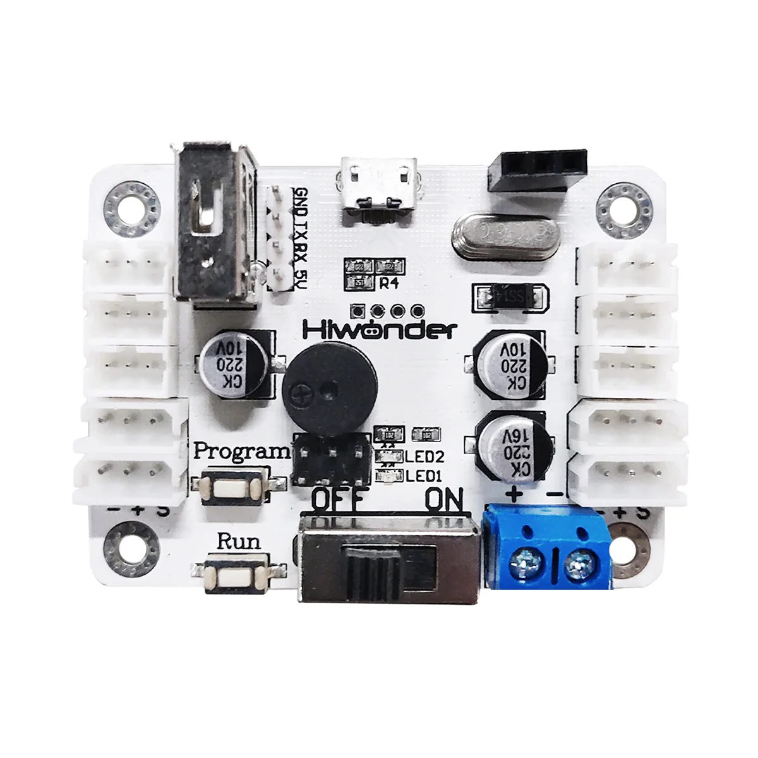
mm-launch-hw/reference/servo_controller_board_photo.png
