Every-Flavor-Robotics/mm-launcher/mm-launch-hw/reference/servo_hiwonder_drawing.png

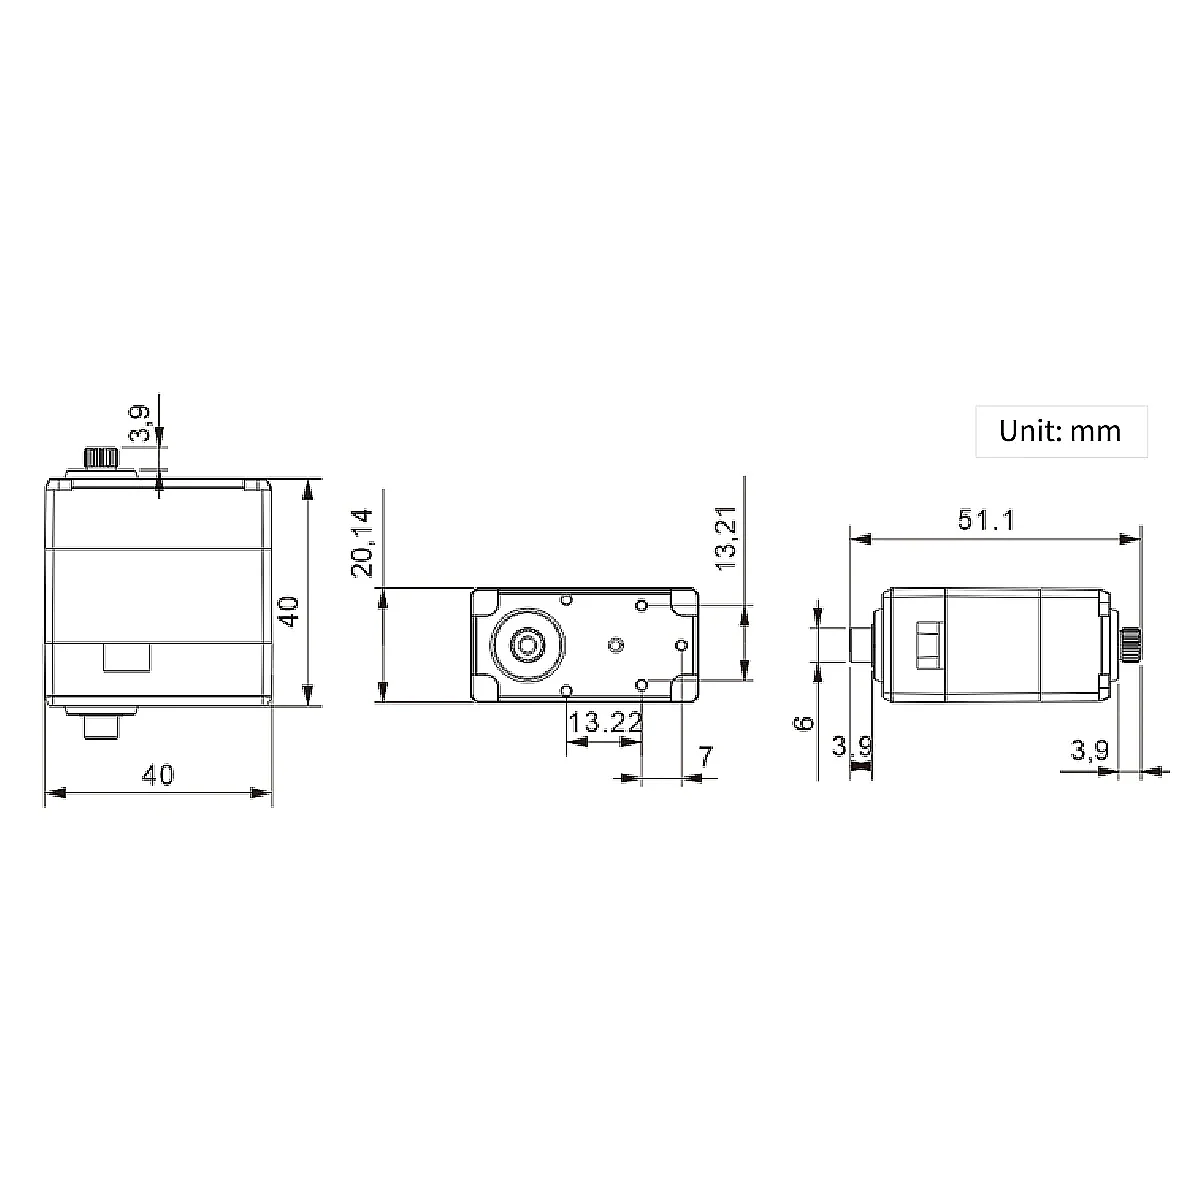
mm-launch-hw/reference/servo_hiwonder_drawing.png
