Every-Flavor-Robotics/mm-launcher/mm-launch-hw/renders/attempt-1/exploded.png

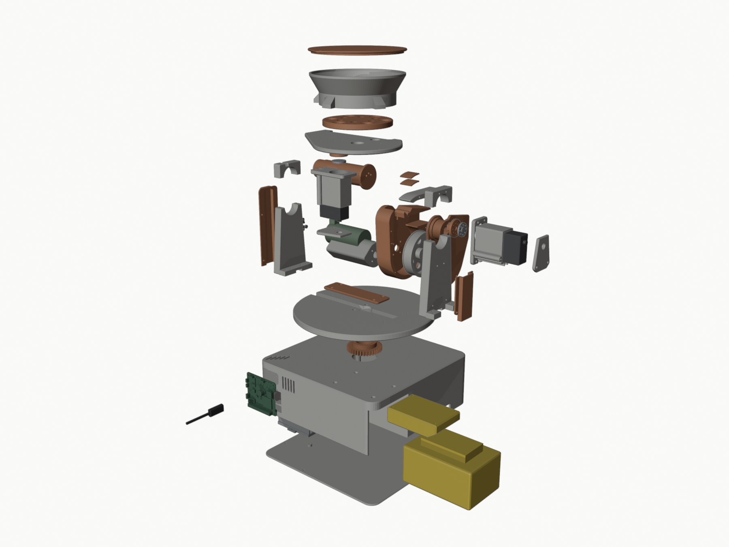
mm-launch-hw/renders/attempt-1/exploded.png
