Every-Flavor-Robotics/mm-launcher/mm-launch-hw/renders/attempt-1/front.png

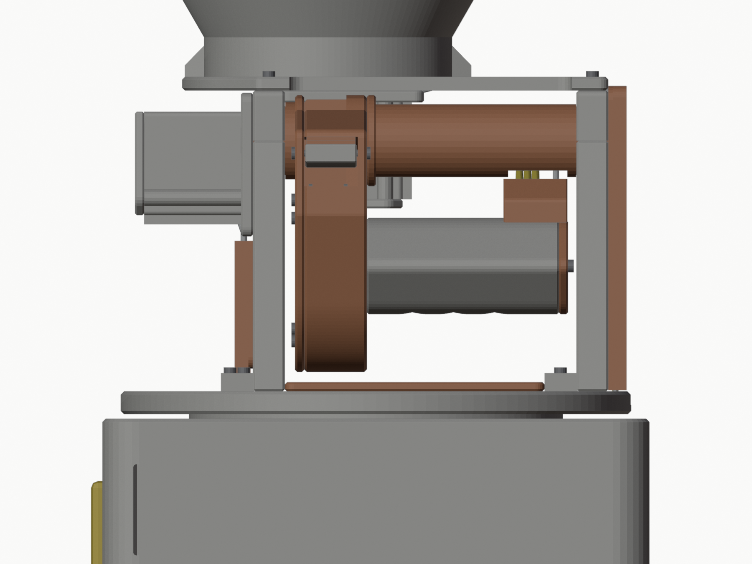
mm-launch-hw/renders/attempt-1/front.png
