Every-Flavor-Robotics/mm-launcher/mm-launch-hw/renders/attempt-1/iso.png

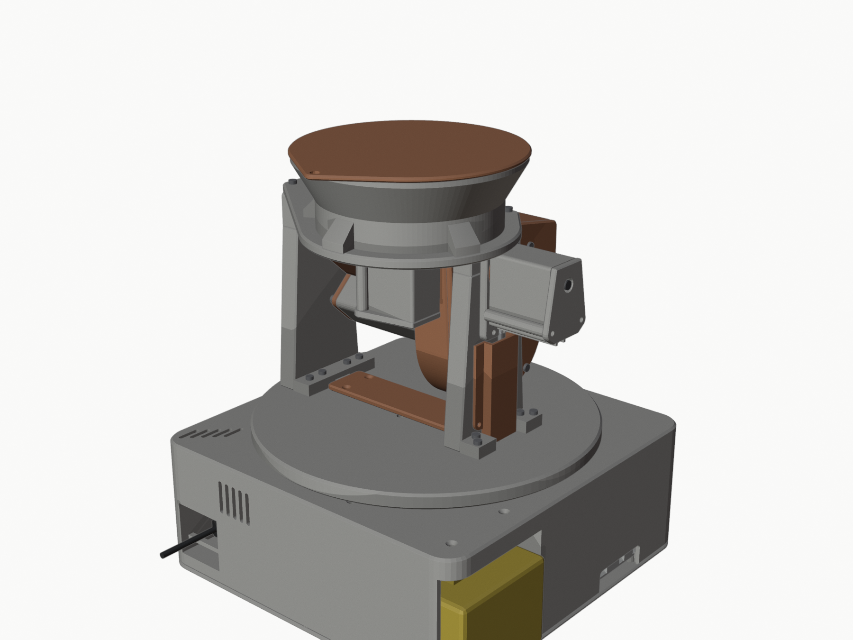
mm-launch-hw/renders/attempt-1/iso.png
