Every-Flavor-Robotics/mm-launcher/mm-launch-hw/renders/attempt-1/iso_front_left.png

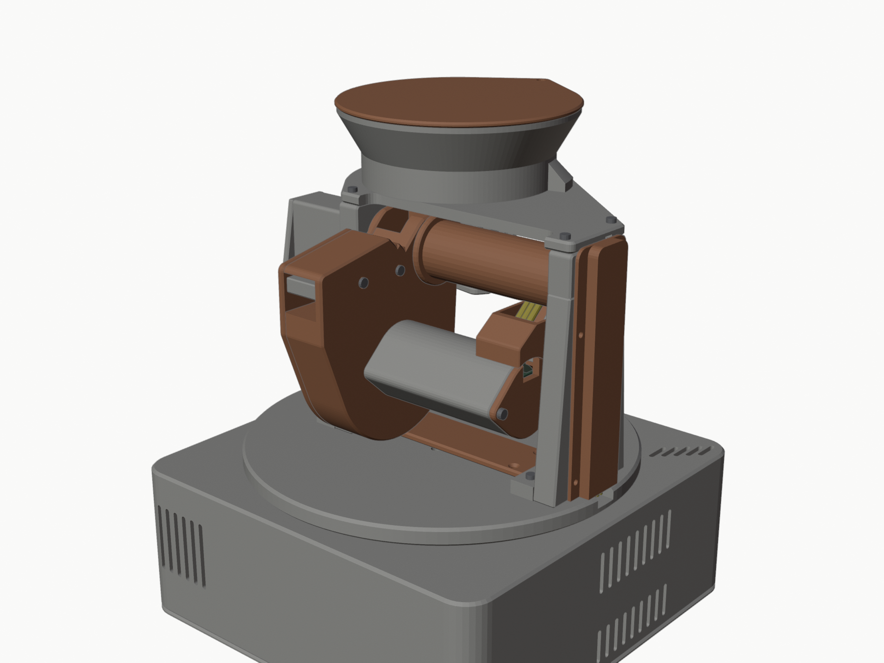
mm-launch-hw/renders/attempt-1/iso_front_left.png
