Every-Flavor-Robotics/mm-launcher/mm-launch-hw/renders/attempt-1/rear.png

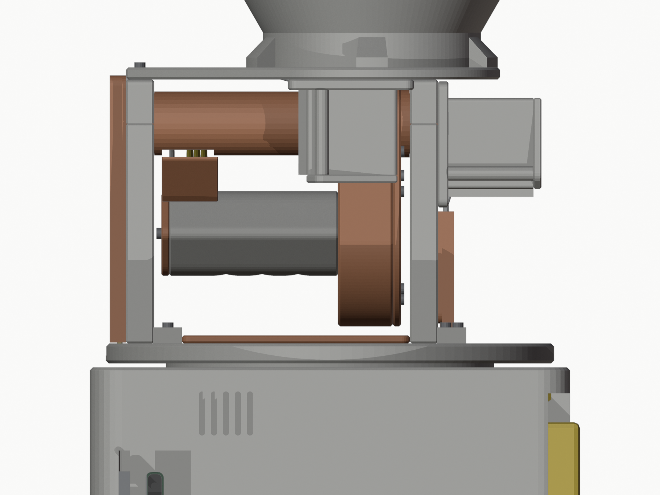
mm-launch-hw/renders/attempt-1/rear.png
