Every-Flavor-Robotics/mm-launcher/mm-launch-hw/renders/attempt-1/rear_cable_side.png

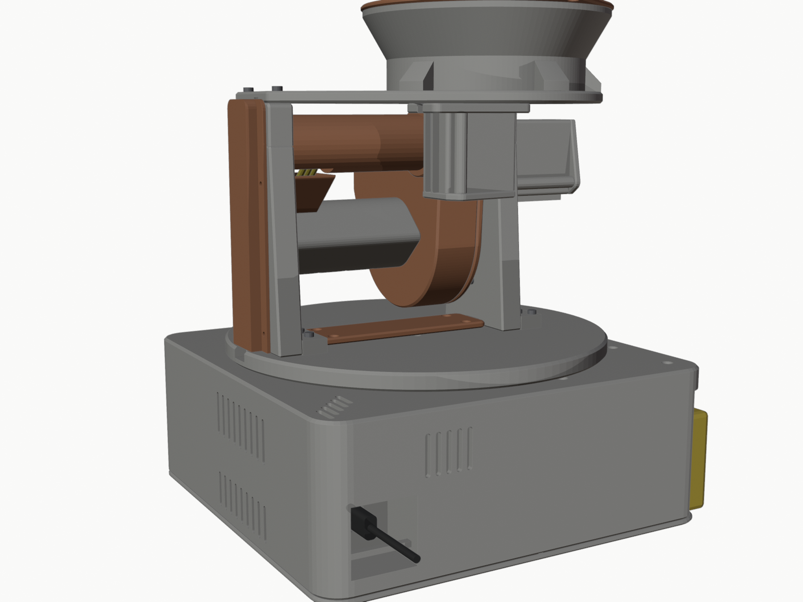
mm-launch-hw/renders/attempt-1/rear_cable_side.png
