Every-Flavor-Robotics/mm-launcher/mm-launch-hw/renders/attempt-1/review/battery_right_rear_corner.png

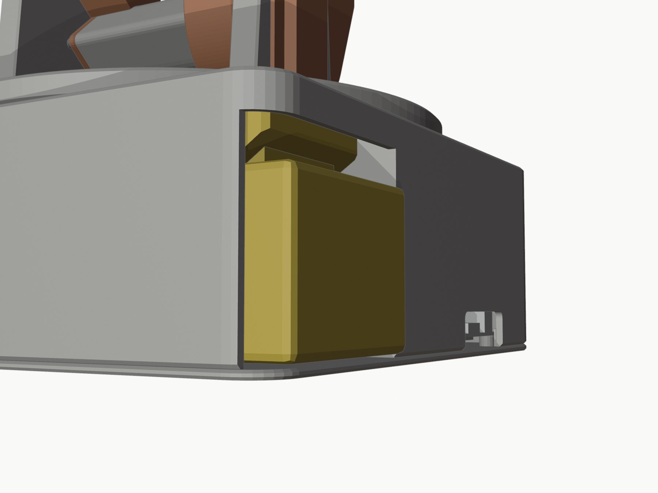
mm-launch-hw/renders/attempt-1/review/battery_right_rear_corner.png
