Every-Flavor-Robotics/mm-launcher/mm-launch-hw/renders/attempt-1/review/battery_right_side.png

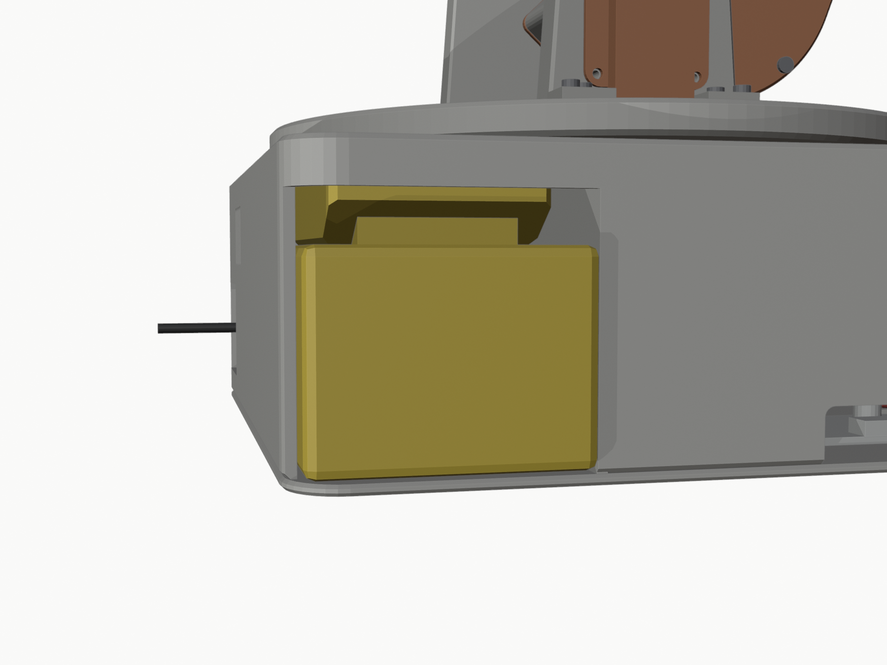
mm-launch-hw/renders/attempt-1/review/battery_right_side.png
