Every-Flavor-Robotics/mm-launcher/mm-launch-hw/renders/attempt-1/review/bonnet_cable_turn_closeup.png

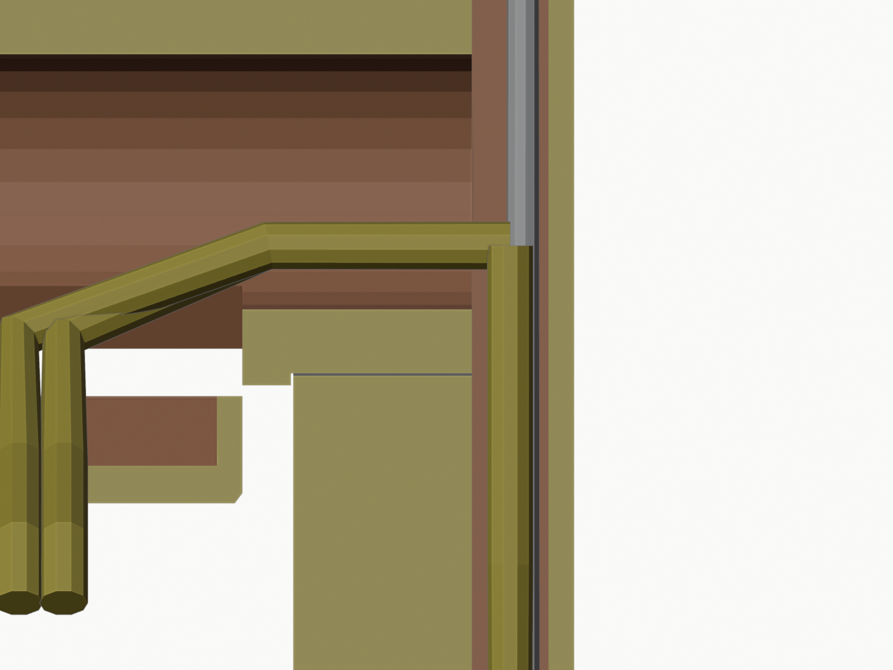
mm-launch-hw/renders/attempt-1/review/bonnet_cable_turn_closeup.png
