Every-Flavor-Robotics/mm-launcher/mm-launch-hw/renders/attempt-1/review/drum_fan_top_front_tilt0.png

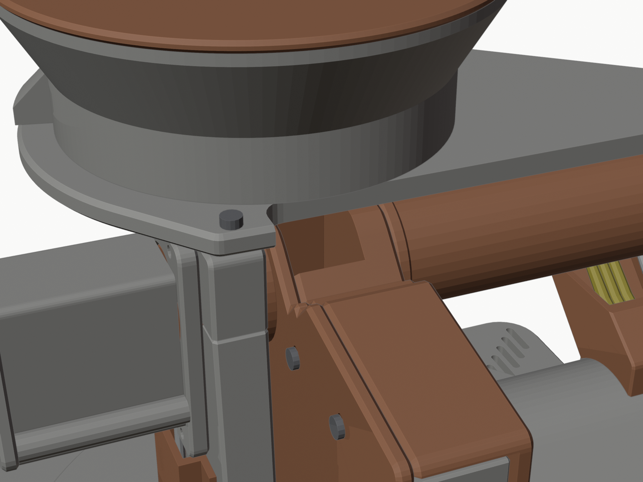
mm-launch-hw/renders/attempt-1/review/drum_fan_top_front_tilt0.png
