Every-Flavor-Robotics/mm-launcher/mm-launch-hw/renders/attempt-1/review/encoder_closeup.png

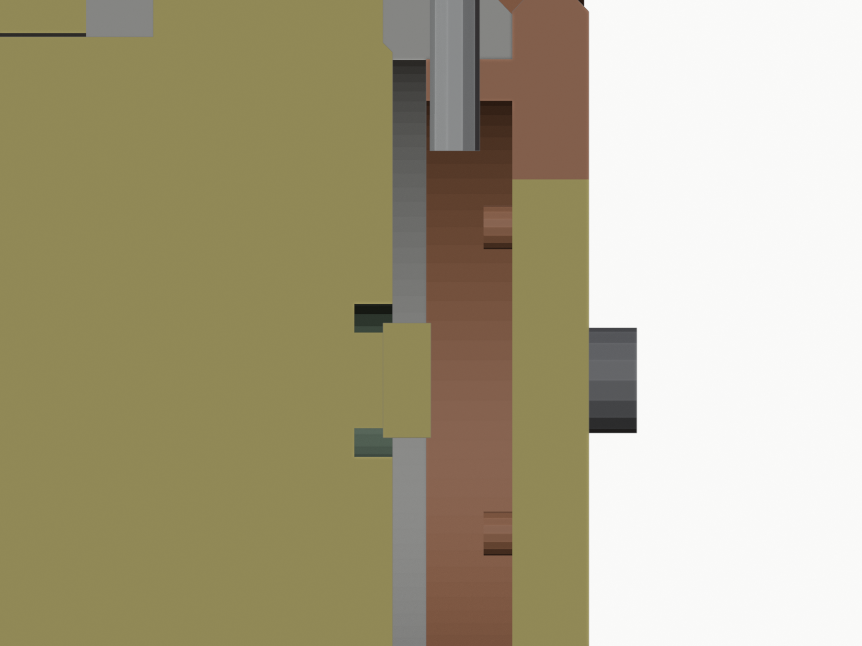
mm-launch-hw/renders/attempt-1/review/encoder_closeup.png
