Every-Flavor-Robotics/mm-launcher/mm-launch-hw/renders/attempt-1/review/feeder_disc_vs_cap_screw.png

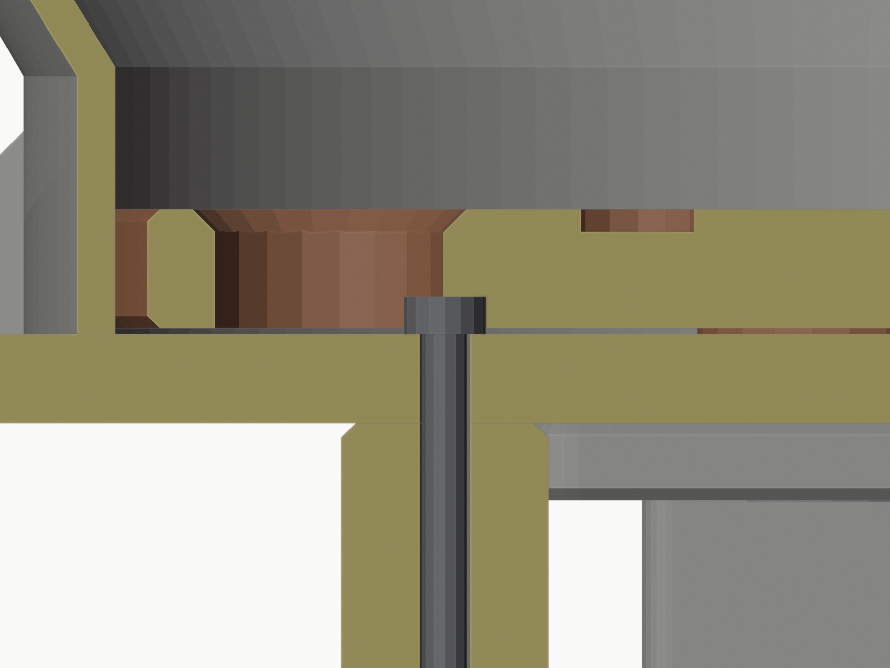
mm-launch-hw/renders/attempt-1/review/feeder_disc_vs_cap_screw.png
