Every-Flavor-Robotics/mm-launcher/mm-launch-hw/renders/attempt-1/review/muzzle_front.png

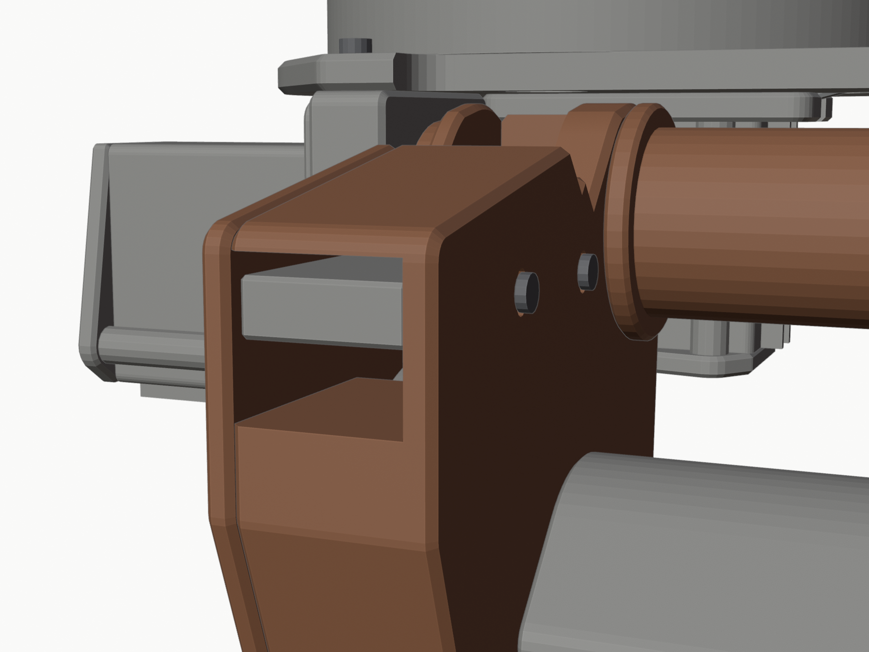
mm-launch-hw/renders/attempt-1/review/muzzle_front.png
