Every-Flavor-Robotics/mm-launcher/mm-launch-hw/renders/attempt-1/review/nip_section_tilt0.png

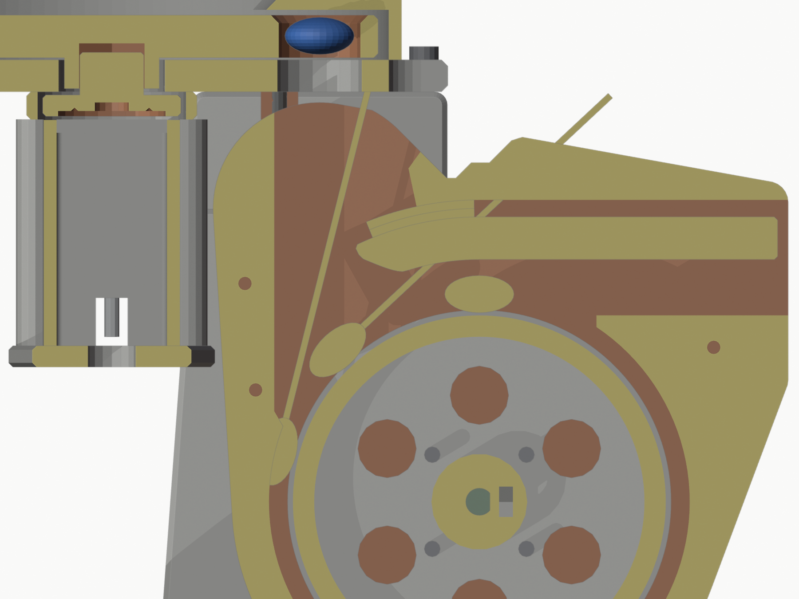
mm-launch-hw/renders/attempt-1/review/nip_section_tilt0.png
