Every-Flavor-Robotics/mm-launcher/mm-launch-hw/renders/attempt-1/review/nip_section_tilt45.png

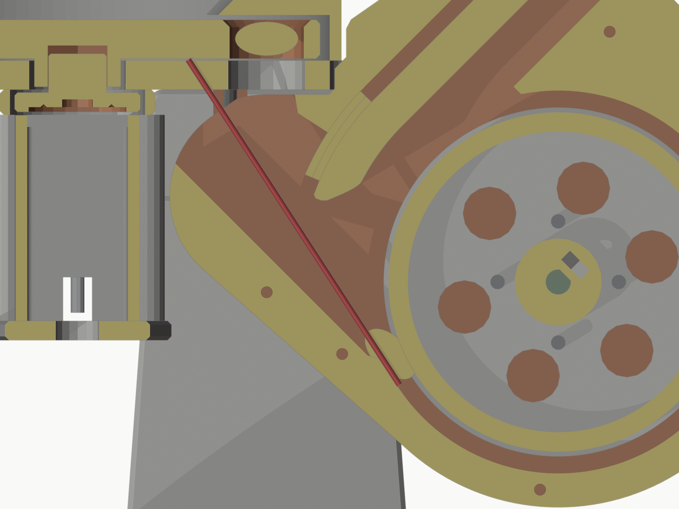
mm-launch-hw/renders/attempt-1/review/nip_section_tilt45.png
