Every-Flavor-Robotics/mm-launcher/mm-launch-hw/renders/attempt-1/review/tilt_axis_section_y0.png

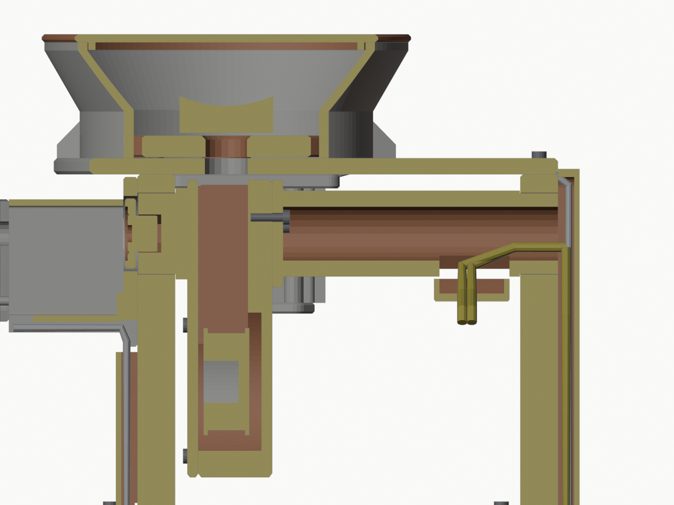
mm-launch-hw/renders/attempt-1/review/tilt_axis_section_y0.png
