Every-Flavor-Robotics/mm-launcher/mm-launch-hw/renders/attempt-1/review/tilt_horn_adapter_closeup.png

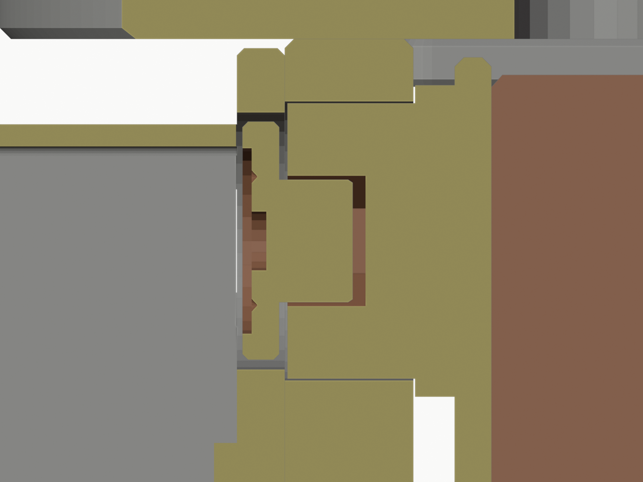
mm-launch-hw/renders/attempt-1/review/tilt_horn_adapter_closeup.png
