Every-Flavor-Robotics/mm-launcher/mm-launch-hw/renders/attempt-1/section_base_plan_z60.png

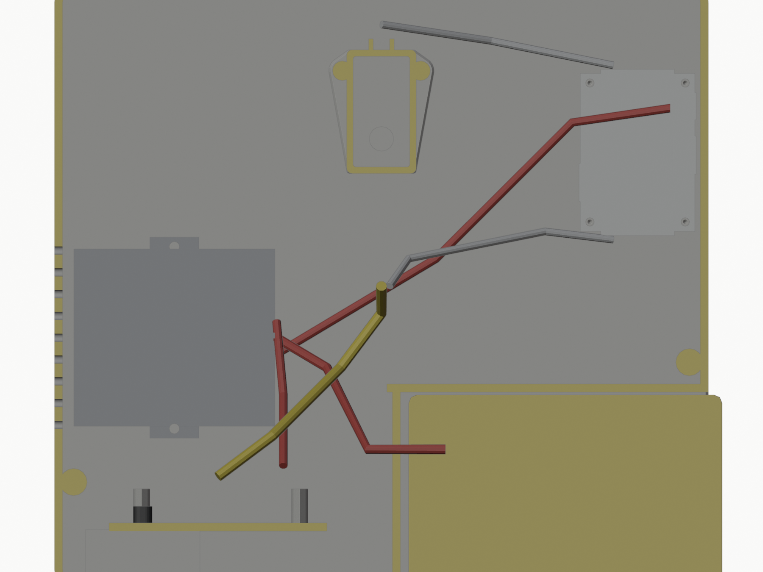
mm-launch-hw/renders/attempt-1/section_base_plan_z60.png
