Every-Flavor-Robotics/mm-launcher/mm-launch-hw/renders/attempt-1/section_full_wheel_plane.png

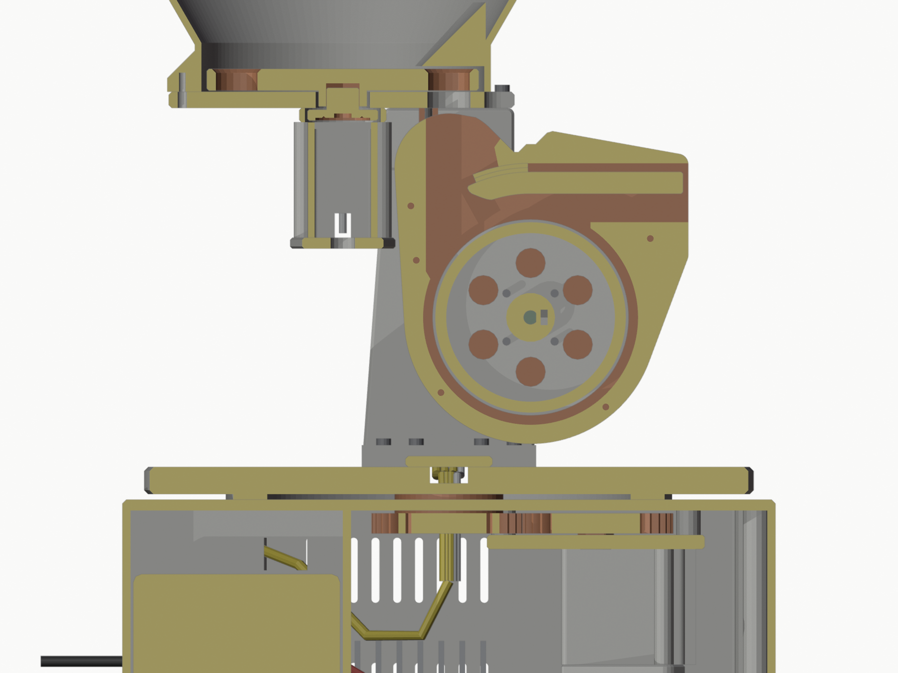
mm-launch-hw/renders/attempt-1/section_full_wheel_plane.png
