Every-Flavor-Robotics/mm-launcher/mm-launch-hw/renders/attempt-1/section_motor_encoder_axis.png

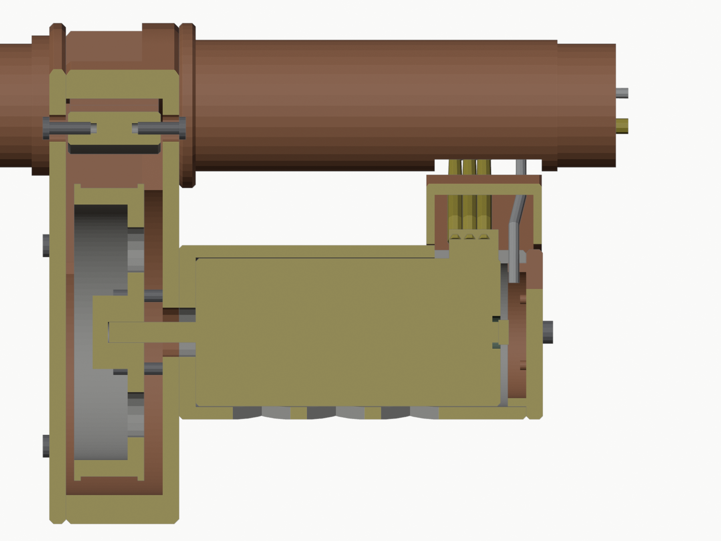
mm-launch-hw/renders/attempt-1/section_motor_encoder_axis.png
