Every-Flavor-Robotics/mm-launcher/mm-launch-hw/renders/attempt-1/side.png

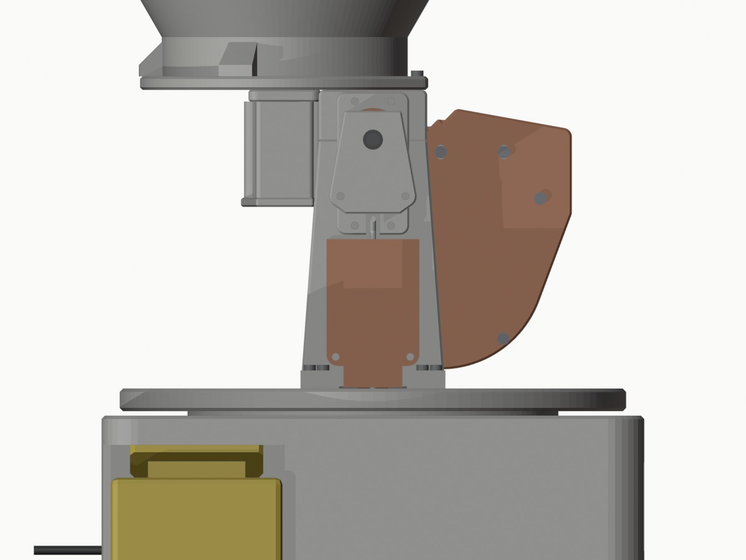
mm-launch-hw/renders/attempt-1/side.png
