Every-Flavor-Robotics/mm-launcher/mm-launch-hw/renders/attempt-1/top.png

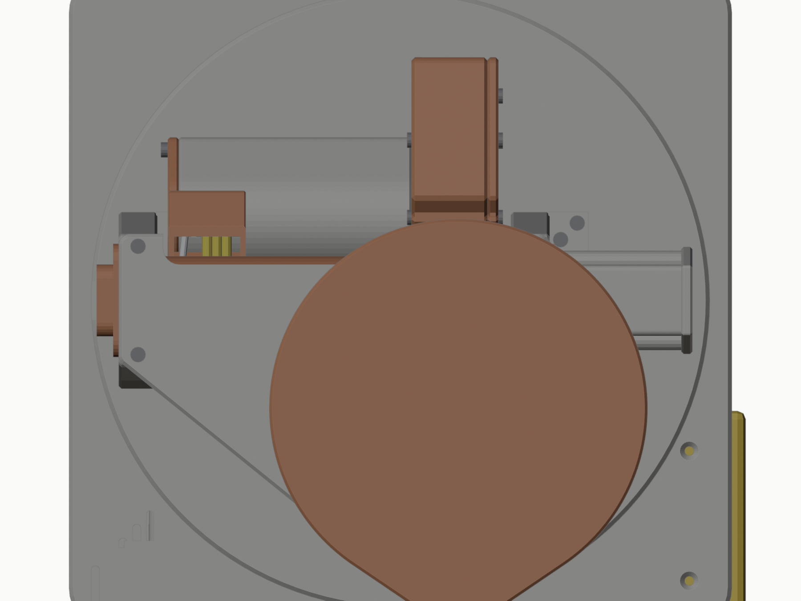
mm-launch-hw/renders/attempt-1/top.png
