Every-Flavor-Robotics/mm-launcher/mm-launch-hw/renders/attempt-2/exploded.png

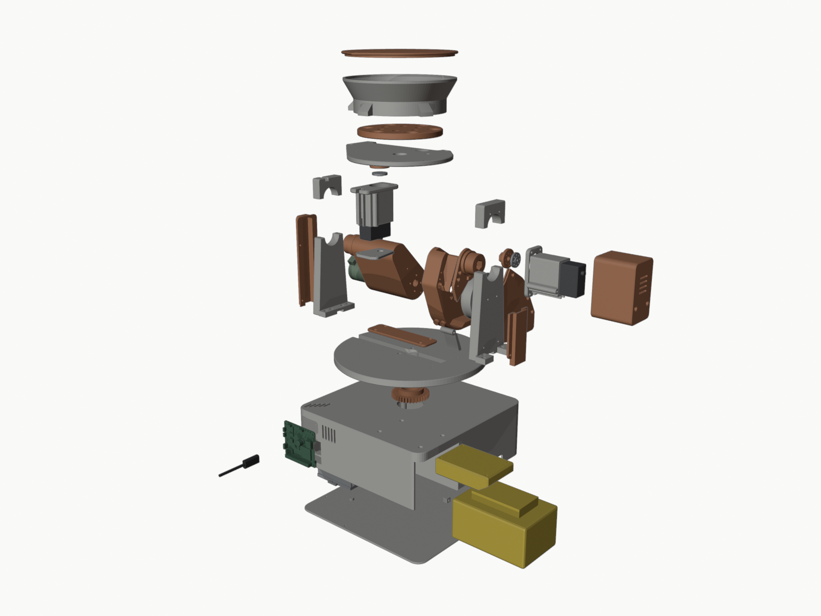
mm-launch-hw/renders/attempt-2/exploded.png
