Every-Flavor-Robotics/mm-launcher/mm-launch-hw/renders/attempt-2/front.png

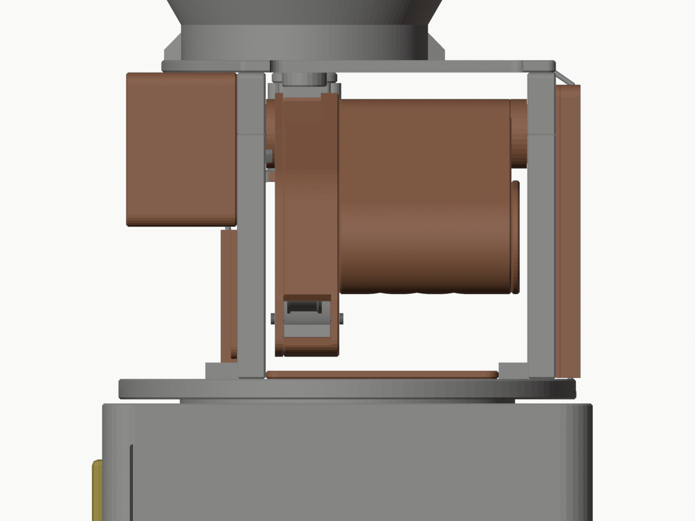
mm-launch-hw/renders/attempt-2/front.png
