Every-Flavor-Robotics/mm-launcher/mm-launch-hw/renders/attempt-2/pan-90_tilt0.png

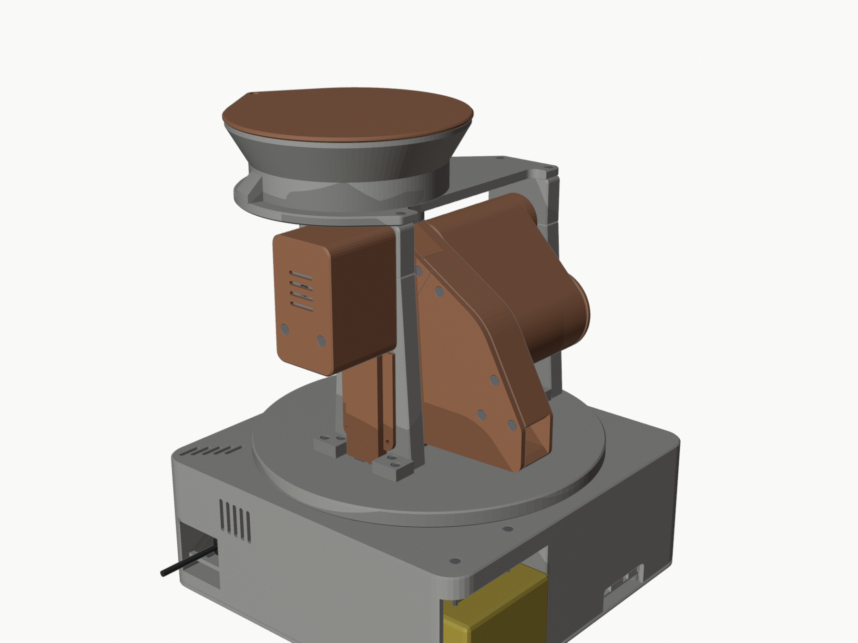
mm-launch-hw/renders/attempt-2/pan-90_tilt0.png
