Every-Flavor-Robotics/mm-launcher/mm-launch-hw/renders/attempt-2/rear.png

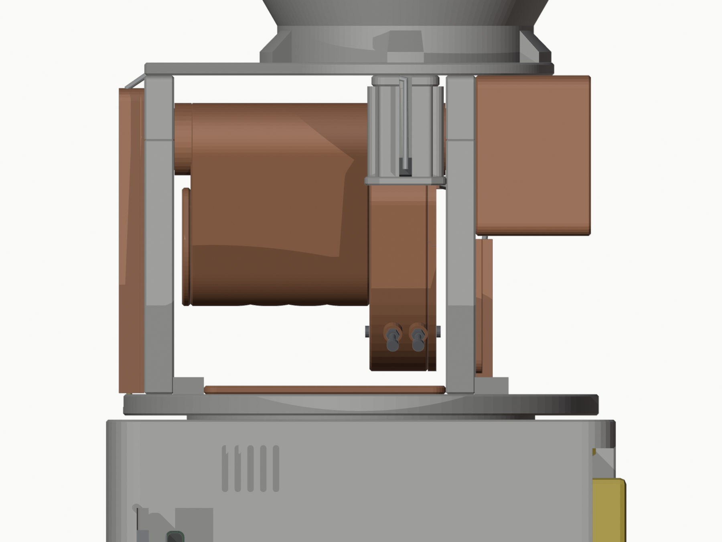
mm-launch-hw/renders/attempt-2/rear.png
