Every-Flavor-Robotics/mm-launcher/mm-launch-hw/renders/attempt-2/review/adapter_bolts_vs_battery_section.png

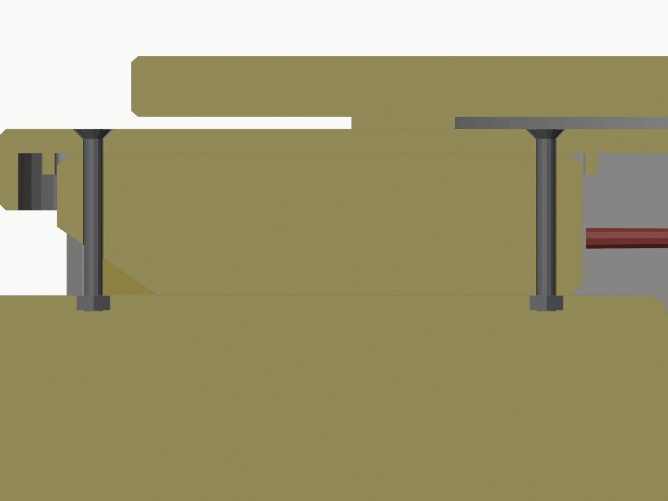
mm-launch-hw/renders/attempt-2/review/adapter_bolts_vs_battery_section.png
