Every-Flavor-Robotics/mm-launcher/mm-launch-hw/renders/attempt-2/review/exposed_bus_above_left_bonnet.png

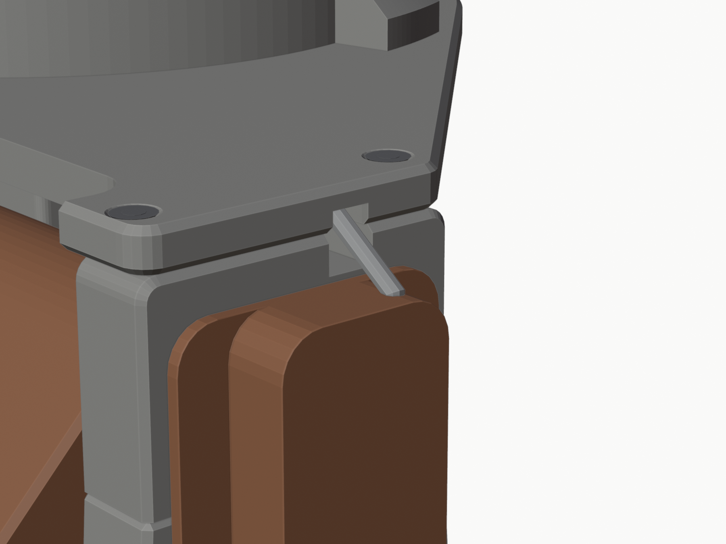
mm-launch-hw/renders/attempt-2/review/exposed_bus_above_left_bonnet.png
