Every-Flavor-Robotics/mm-launcher/mm-launch-hw/renders/attempt-2/review/feeder_documented_fire_60deg.png

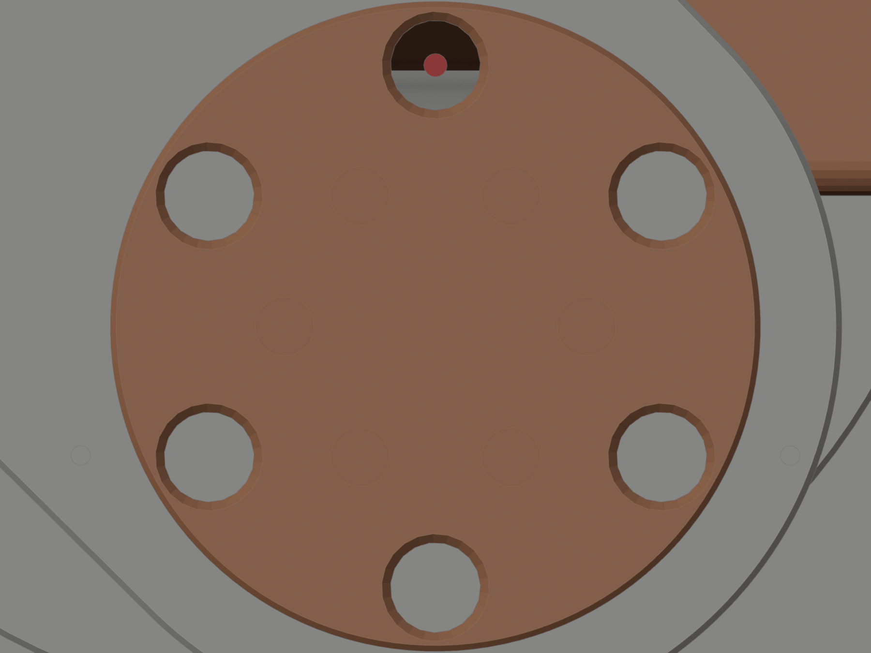
mm-launch-hw/renders/attempt-2/review/feeder_documented_fire_60deg.png
