Every-Flavor-Robotics/mm-launcher/mm-launch-hw/renders/attempt-2/review/feeder_suggested_park_30deg.png

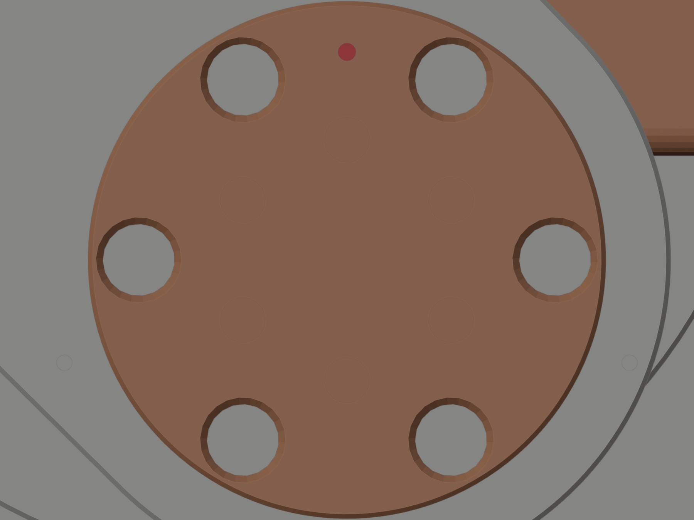
mm-launch-hw/renders/attempt-2/review/feeder_suggested_park_30deg.png
