Every-Flavor-Robotics/mm-launcher/mm-launch-hw/renders/attempt-2/review/flywheel_lkey_long_leg_vs_web.png

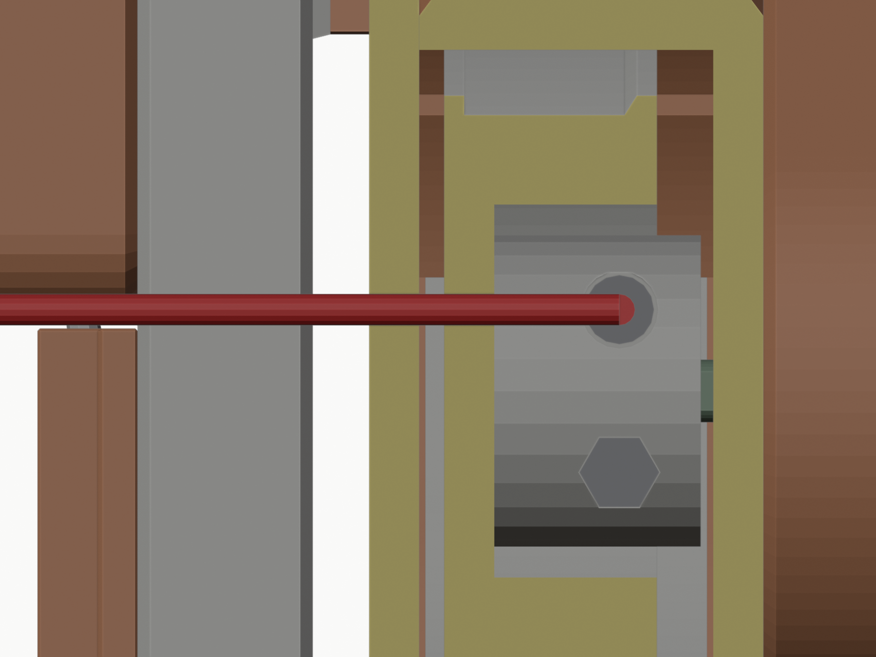
mm-launch-hw/renders/attempt-2/review/flywheel_lkey_long_leg_vs_web.png
