Every-Flavor-Robotics/mm-launcher/mm-launch-hw/renders/attempt-2/review/flywheel_pinch_bolt_plane_lkey.png

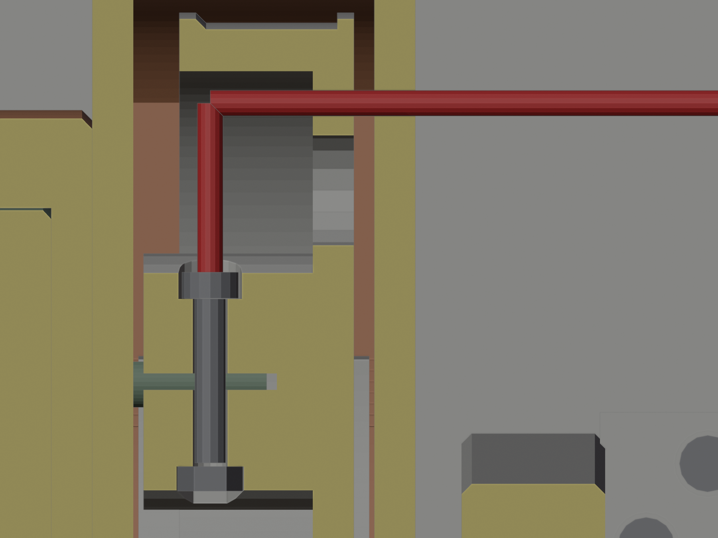
mm-launch-hw/renders/attempt-2/review/flywheel_pinch_bolt_plane_lkey.png
