Every-Flavor-Robotics/mm-launcher/mm-launch-hw/renders/attempt-2/review/pod_underside_jack_screws.png

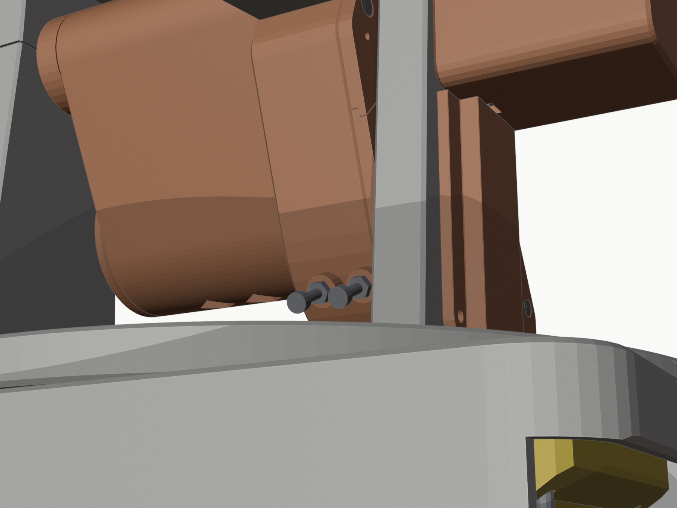
mm-launch-hw/renders/attempt-2/review/pod_underside_jack_screws.png
