Every-Flavor-Robotics/mm-launcher/mm-launch-hw/renders/attempt-2/review/right_clamp_screw_vs_arm_tilt0.png

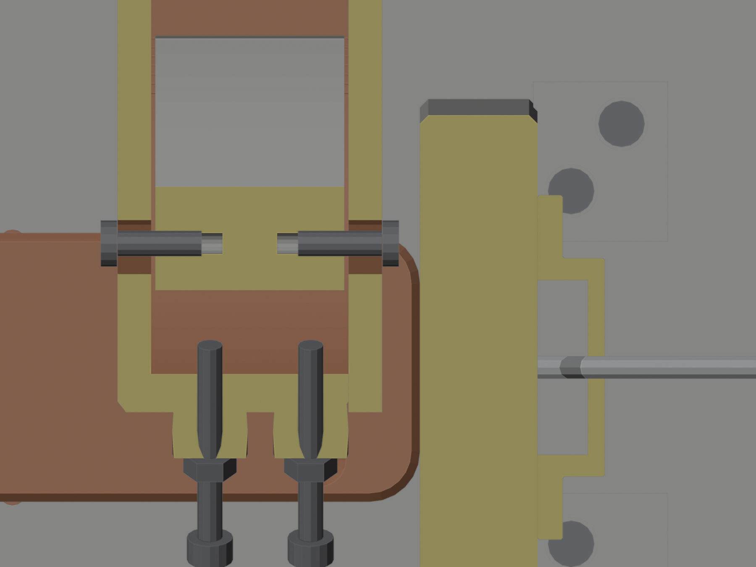
mm-launch-hw/renders/attempt-2/review/right_clamp_screw_vs_arm_tilt0.png
