Every-Flavor-Robotics/mm-launcher/mm-launch-hw/renders/attempt-2/section_launcher_tilt45.png

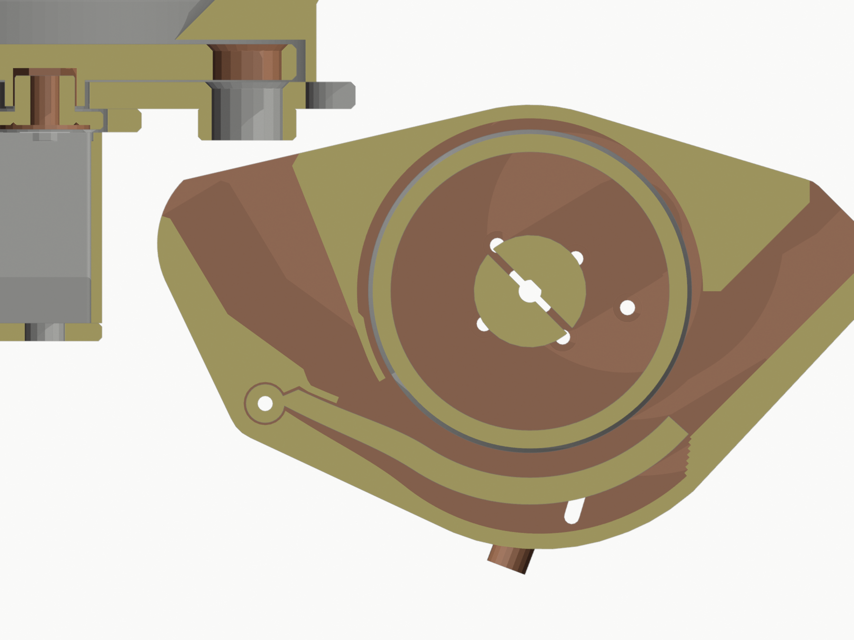
mm-launch-hw/renders/attempt-2/section_launcher_tilt45.png
