Every-Flavor-Robotics/mm-launcher/mm-launch-hw/renders/attempt-2/section_launcher_wheel_plane.png

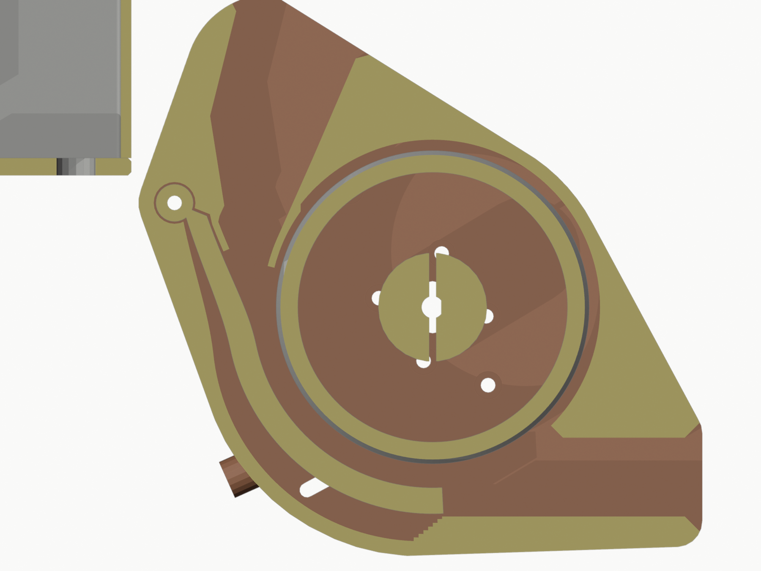
mm-launch-hw/renders/attempt-2/section_launcher_wheel_plane.png
