Every-Flavor-Robotics/mm-launcher/mm-launch-hw/renders/attempt-2/section_nacelle_duct.png

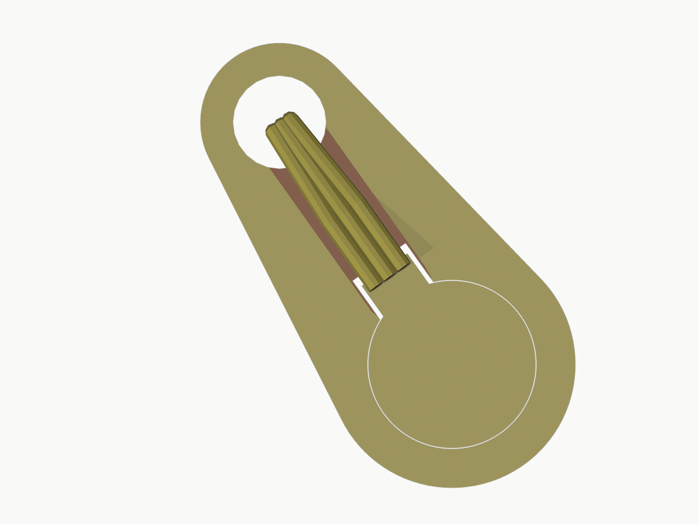
mm-launch-hw/renders/attempt-2/section_nacelle_duct.png
