Every-Flavor-Robotics/mm-launcher/mm-launch-hw/renders/attempt-2/service_cover_off_tilt45.png

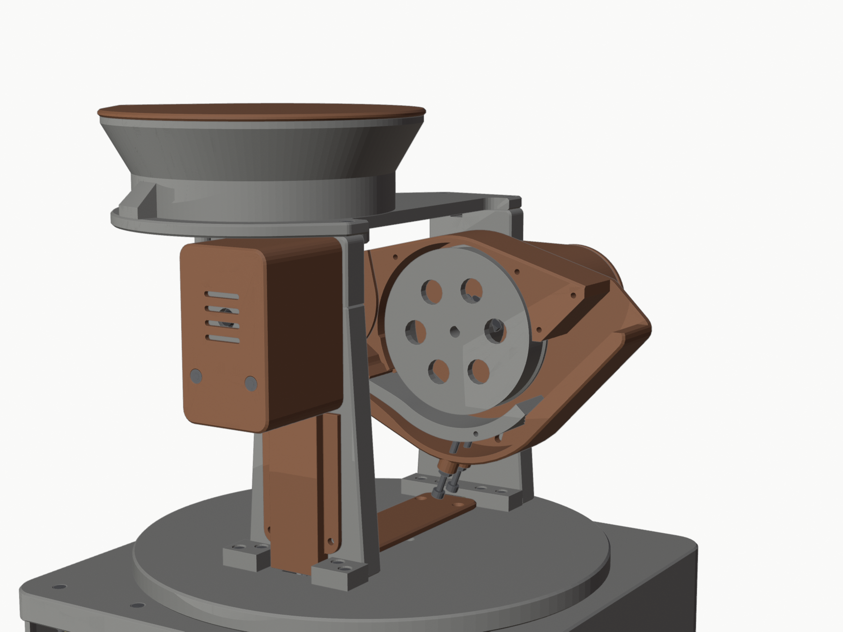
mm-launch-hw/renders/attempt-2/service_cover_off_tilt45.png
