Every-Flavor-Robotics/mm-launcher/mm-launch-hw/renders/attempt-2/side.png

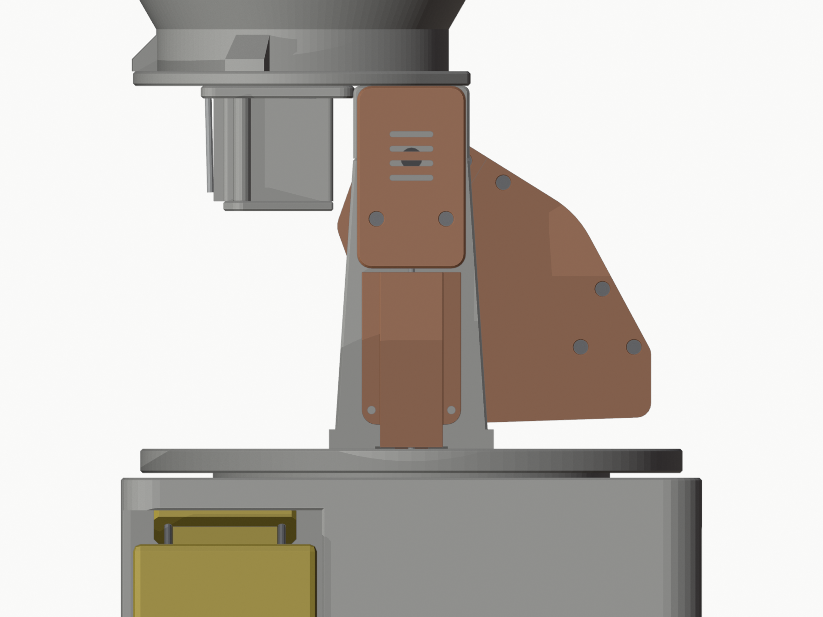
mm-launch-hw/renders/attempt-2/side.png
