Every-Flavor-Robotics/mm-launcher/mm-launch-hw/renders/attempt-2/top.png

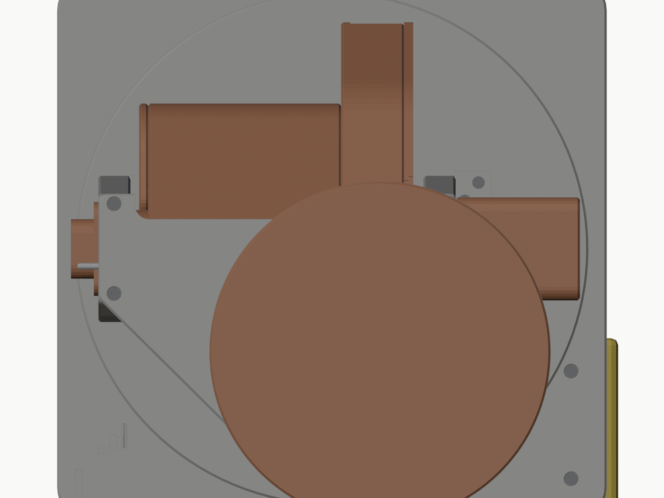
mm-launch-hw/renders/attempt-2/top.png
