Every-Flavor-Robotics/mm-launcher/mm-launch-hw/renders/attempt-3/flywheel_lkey_access_tilt45.png

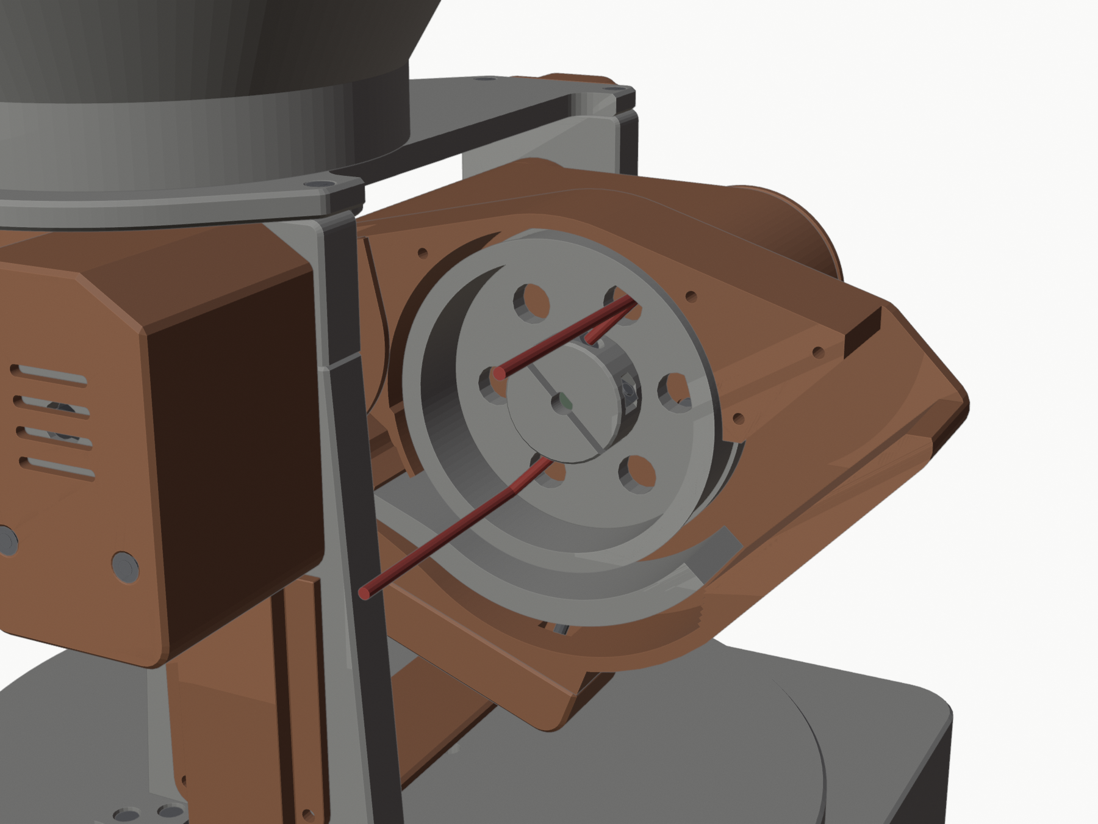
mm-launch-hw/renders/attempt-3/flywheel_lkey_access_tilt45.png
