Every-Flavor-Robotics/mm-launcher/mm-launch-hw/renders/attempt-3/front.png

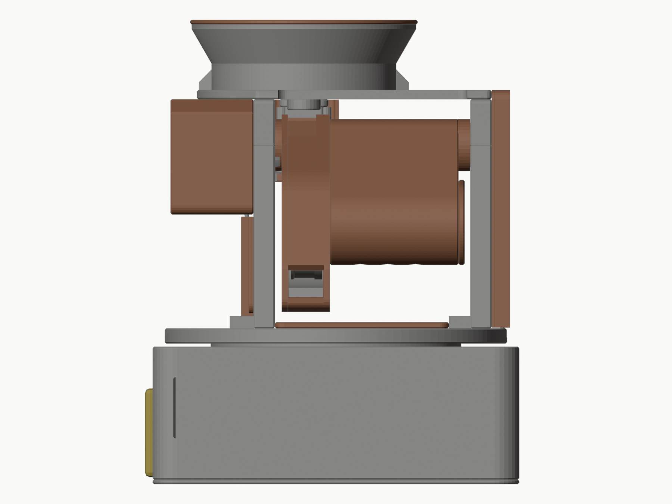
mm-launch-hw/renders/attempt-3/front.png
