Every-Flavor-Robotics/mm-launcher/mm-launch-hw/renders/attempt-3/pod_underside_nip_cover.png

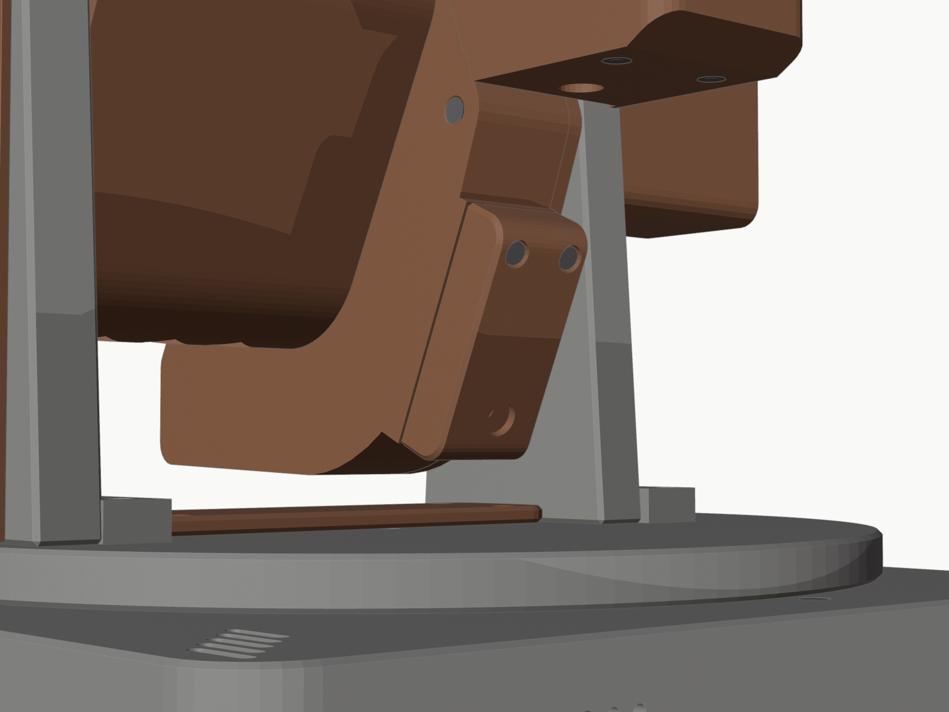
mm-launch-hw/renders/attempt-3/pod_underside_nip_cover.png
