Every-Flavor-Robotics/mm-launcher/mm-launch-hw/renders/attempt-3/rear.png

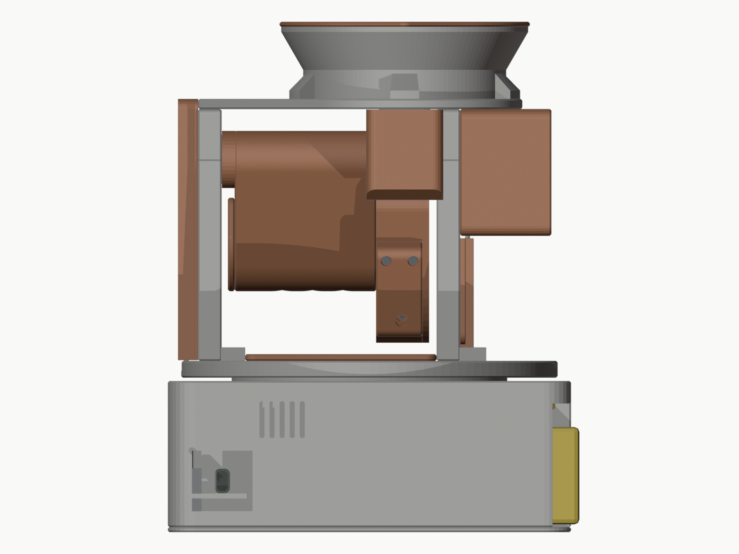
mm-launch-hw/renders/attempt-3/rear.png
