Every-Flavor-Robotics/mm-launcher/mm-launch-hw/renders/attempt-3/review/battery_bay_side.png

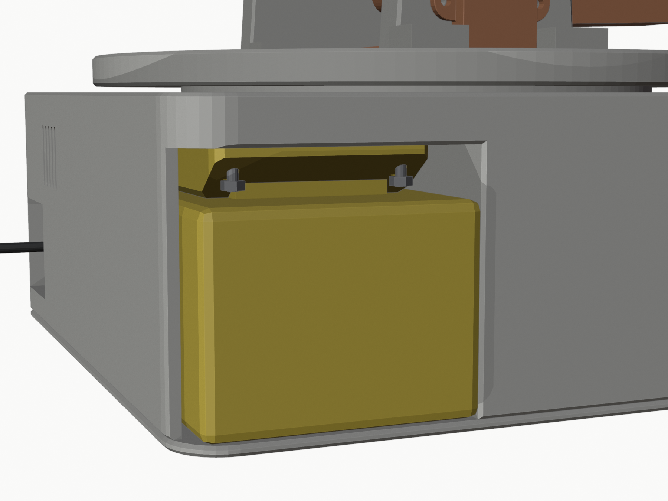
mm-launch-hw/renders/attempt-3/review/battery_bay_side.png
