Every-Flavor-Robotics/mm-launcher/mm-launch-hw/renders/attempt-3/review/bonnet_foot_turntable_closeup.png

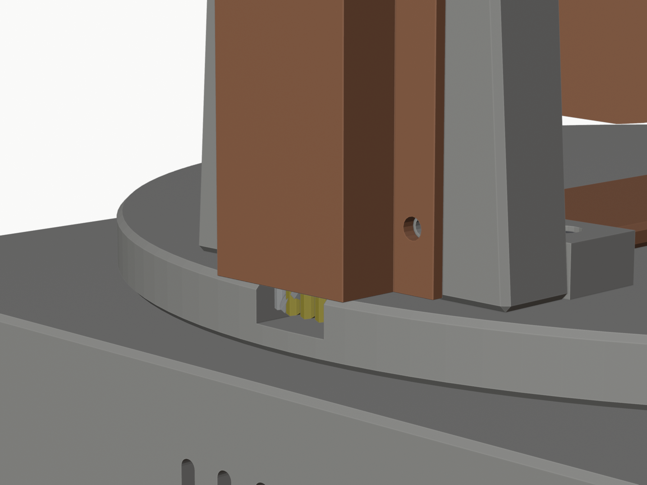
mm-launch-hw/renders/attempt-3/review/bonnet_foot_turntable_closeup.png
