Every-Flavor-Robotics/mm-launcher/mm-launch-hw/renders/attempt-3/review/bonnet_top_feeder_bus_closeup.png

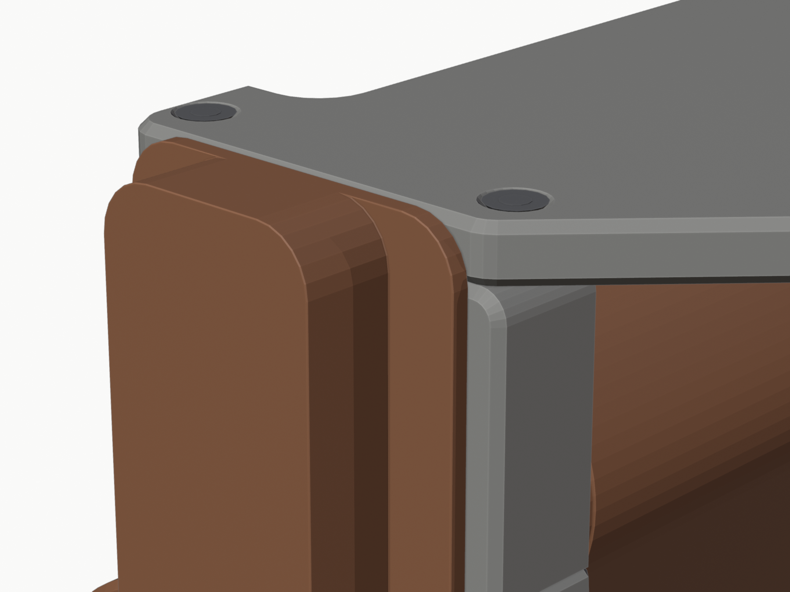
mm-launch-hw/renders/attempt-3/review/bonnet_top_feeder_bus_closeup.png
