Every-Flavor-Robotics/mm-launcher/mm-launch-hw/renders/attempt-3/review/feed_path_closeup_tilt0.png

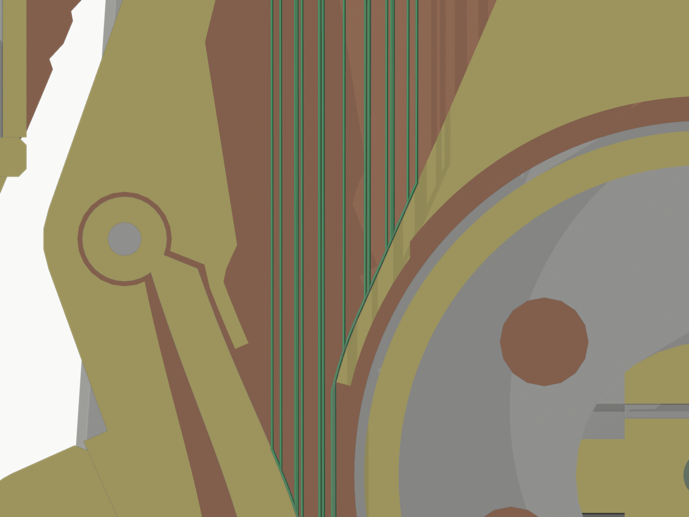
mm-launch-hw/renders/attempt-3/review/feed_path_closeup_tilt0.png
