Every-Flavor-Robotics/mm-launcher/mm-launch-hw/renders/attempt-3/review/feed_path_closeup_tilt22_5.png

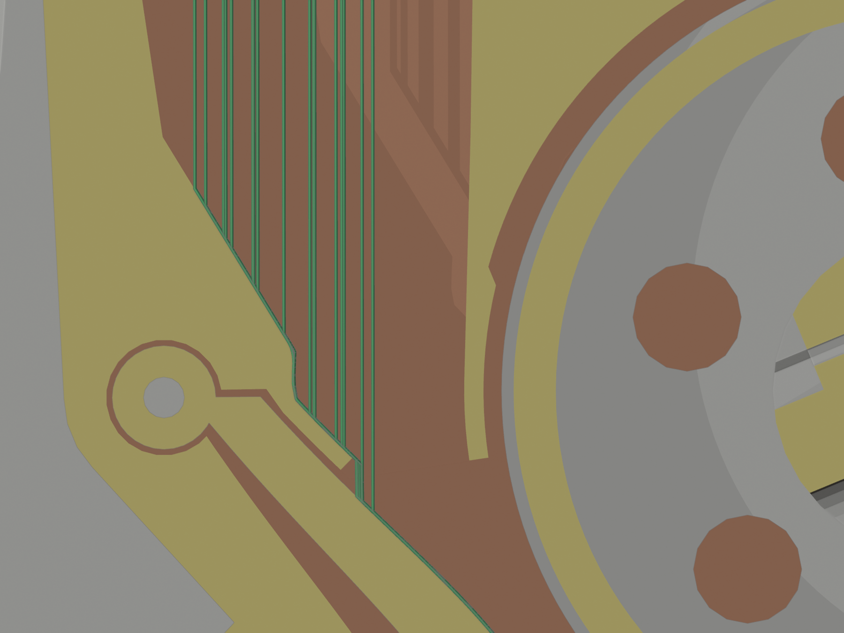
mm-launch-hw/renders/attempt-3/review/feed_path_closeup_tilt22_5.png
