Every-Flavor-Robotics/mm-launcher/mm-launch-hw/renders/attempt-3/review/feed_slide_on_backplate_tilt45.png

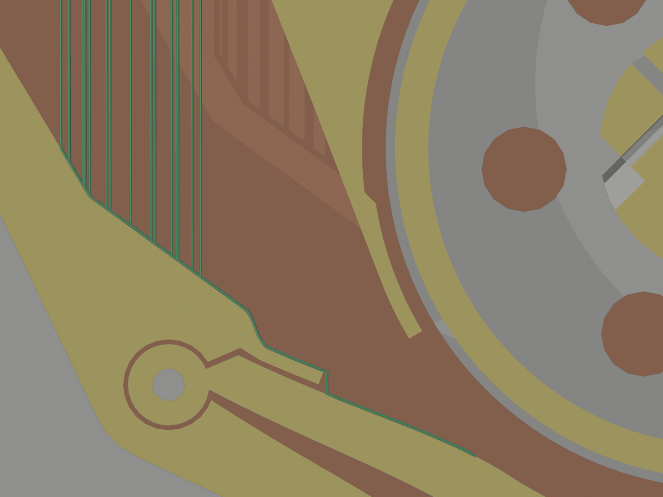
mm-launch-hw/renders/attempt-3/review/feed_slide_on_backplate_tilt45.png
