Every-Flavor-Robotics/mm-launcher/mm-launch-hw/renders/attempt-3/review/nip_cover_on_tilt0_rear_low.png

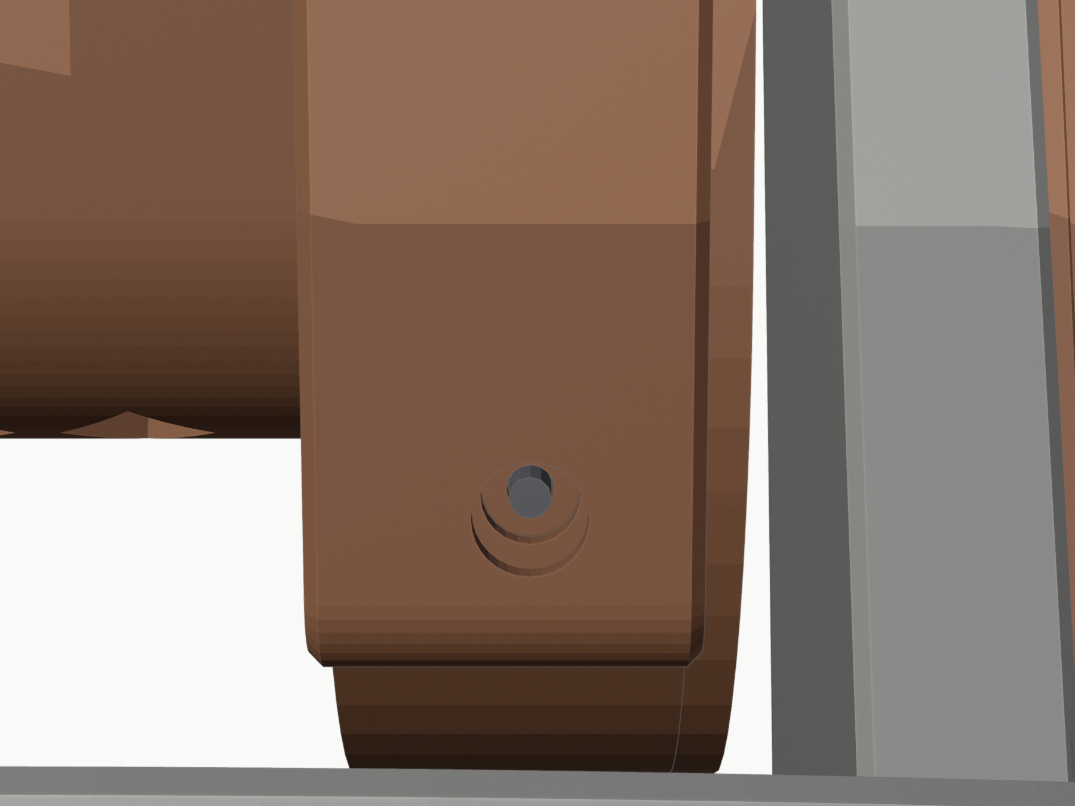
mm-launch-hw/renders/attempt-3/review/nip_cover_on_tilt0_rear_low.png
