Every-Flavor-Robotics/mm-launcher/mm-launch-hw/renders/attempt-3/section_flywheel_pinch_bolts.png

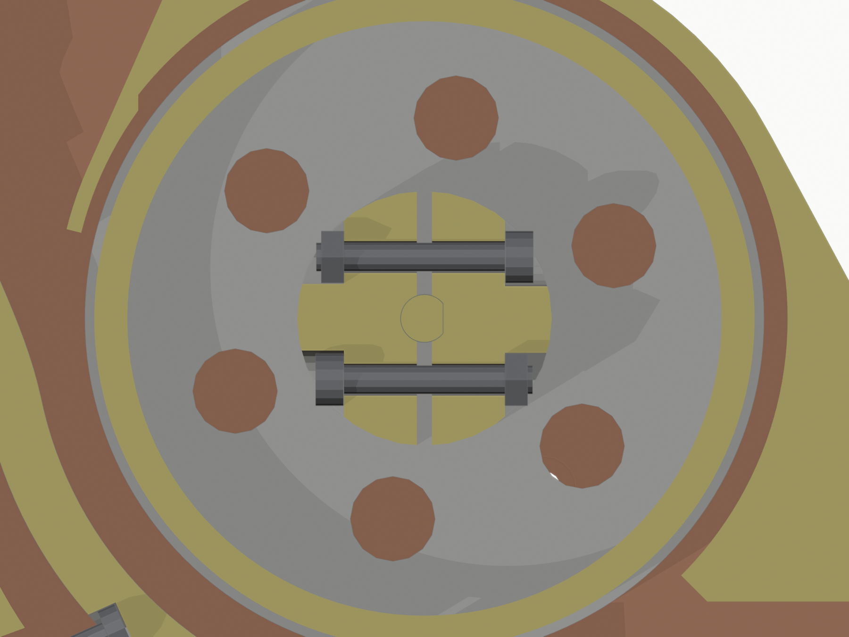
mm-launch-hw/renders/attempt-3/section_flywheel_pinch_bolts.png
