Every-Flavor-Robotics/mm-launcher/mm-launch-hw/renders/attempt-3/section_launcher_tilt45.png

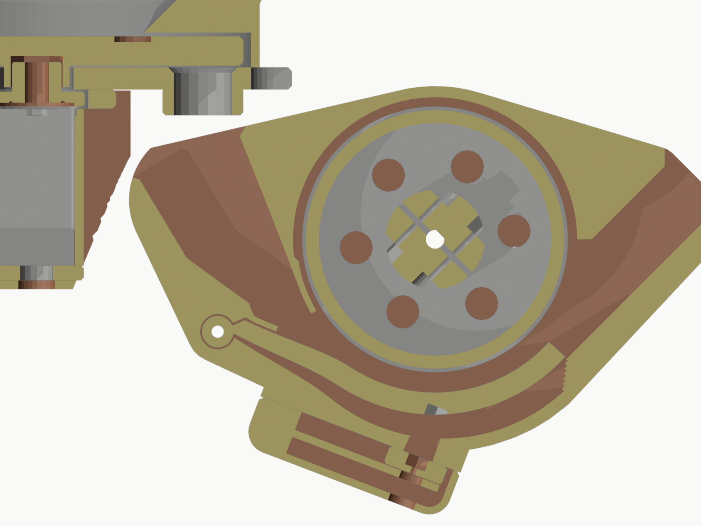
mm-launch-hw/renders/attempt-3/section_launcher_tilt45.png
