Every-Flavor-Robotics/mm-launcher/mm-launch-hw/renders/attempt-3/section_nip_stud_thumbwheel.png

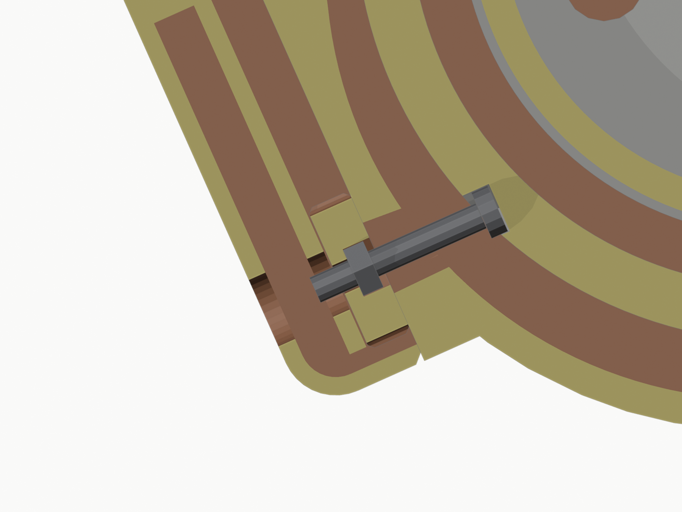
mm-launch-hw/renders/attempt-3/section_nip_stud_thumbwheel.png
