Every-Flavor-Robotics/mm-launcher/mm-launch-hw/renders/attempt-3/side.png

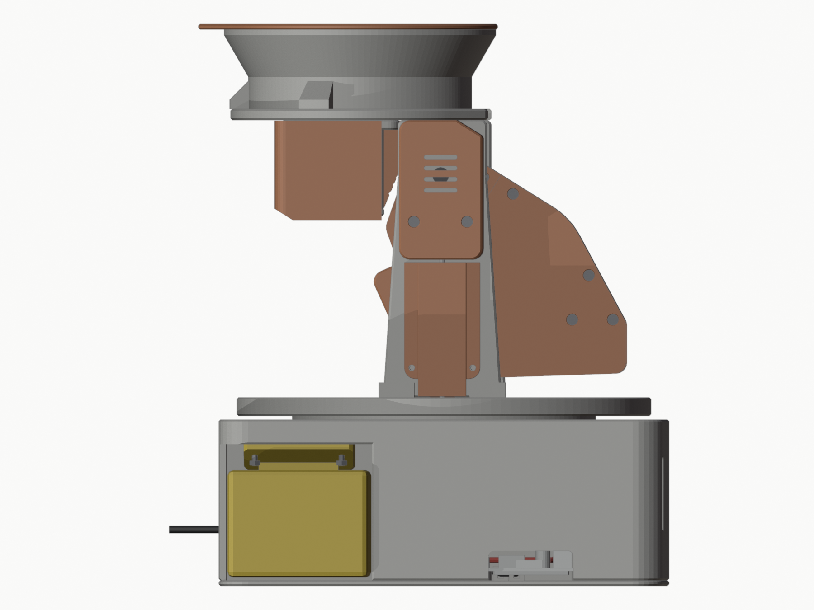
mm-launch-hw/renders/attempt-3/side.png
