Every-Flavor-Robotics/mm-launcher/mm-launch-hw/renders/attempt-3/side_left.png

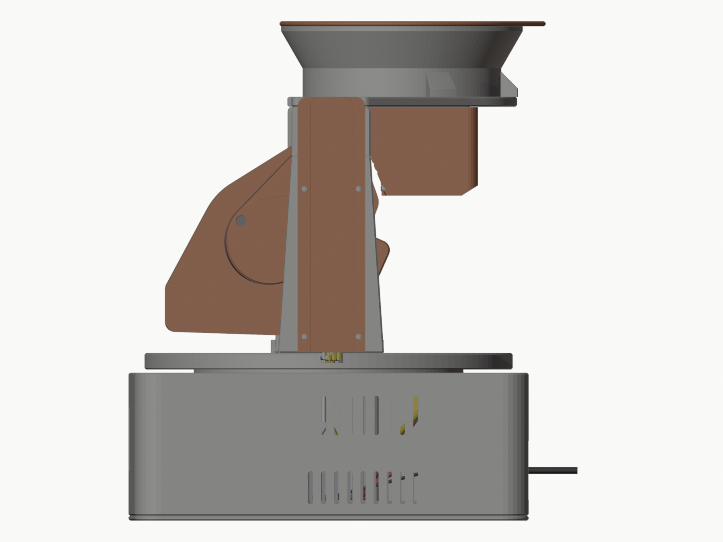
mm-launch-hw/renders/attempt-3/side_left.png
