Every-Flavor-Robotics/mm-launcher/mm-launch-hw/v3/BUILD/guide/screenshots/6_overview.png

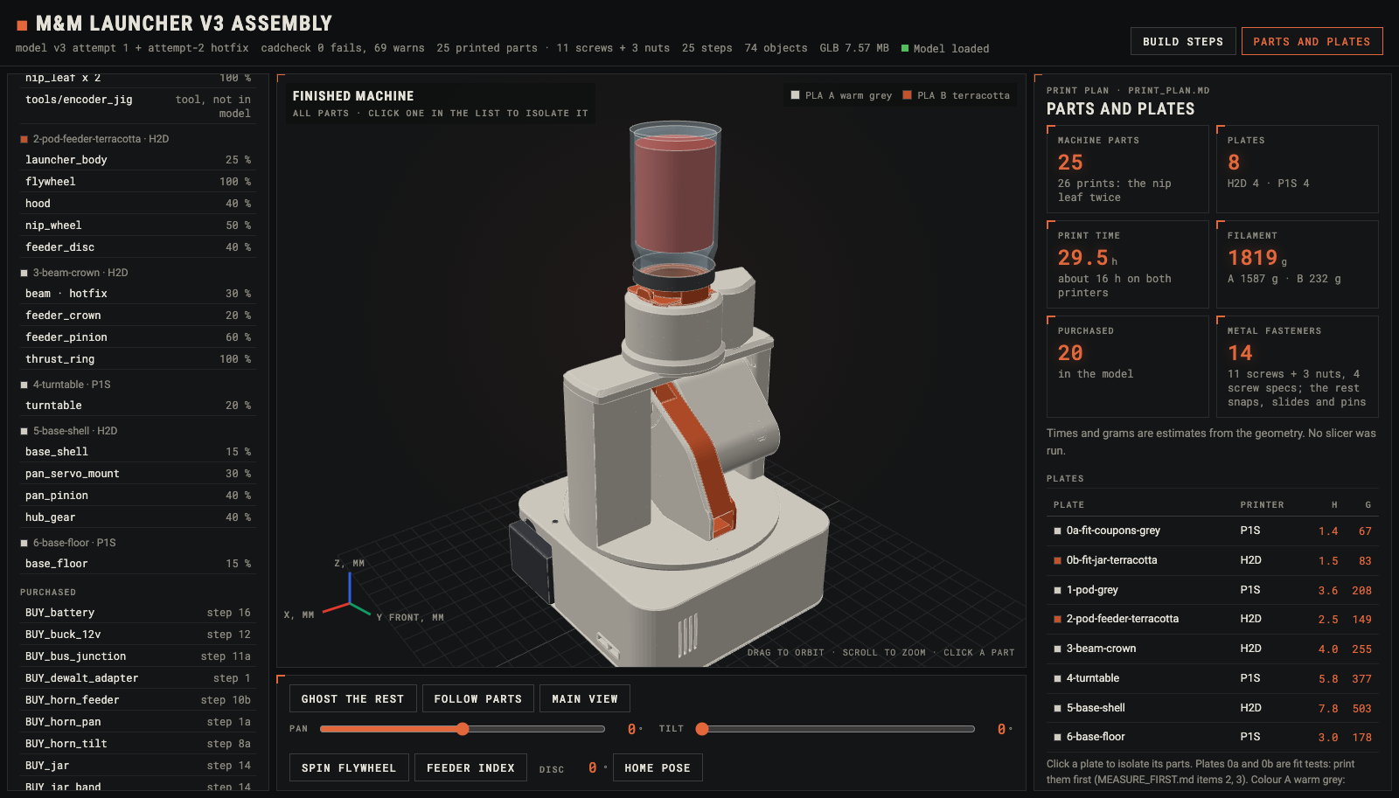
mm-launch-hw/v3/BUILD/guide/screenshots/6_overview.png
