Every-Flavor-Robotics/mm-launcher/mm-launch-hw/v3/renders/attempt-1/front.png

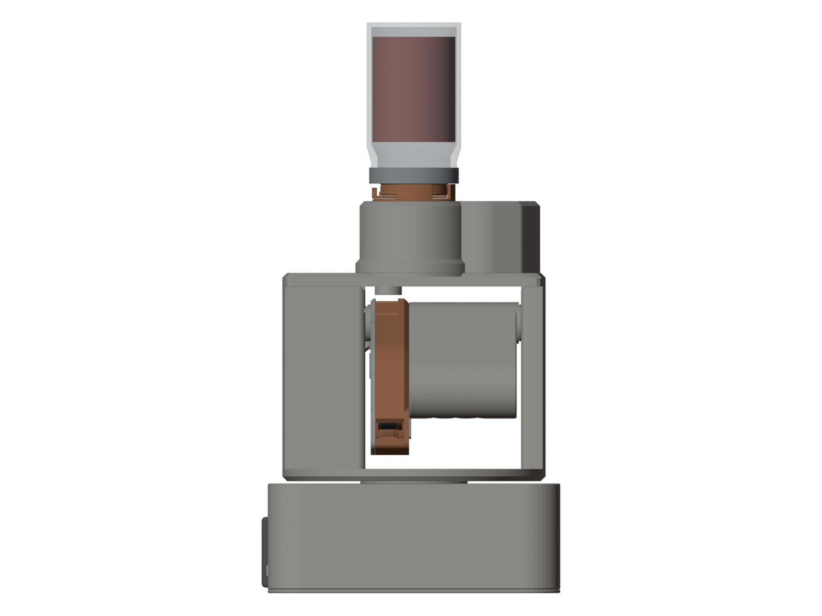
mm-launch-hw/v3/renders/attempt-1/front.png
