Every-Flavor-Robotics/mm-launcher/mm-launch-hw/v3/renders/attempt-1/pan_stage/sec_x2_hub.png

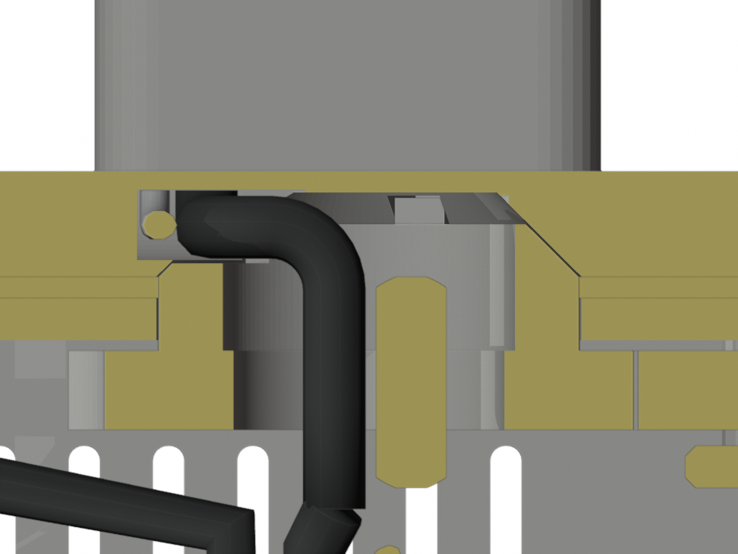
mm-launch-hw/v3/renders/attempt-1/pan_stage/sec_x2_hub.png
