Every-Flavor-Robotics/mm-launcher/mm-launch-hw/v3/renders/attempt-1/rear.png

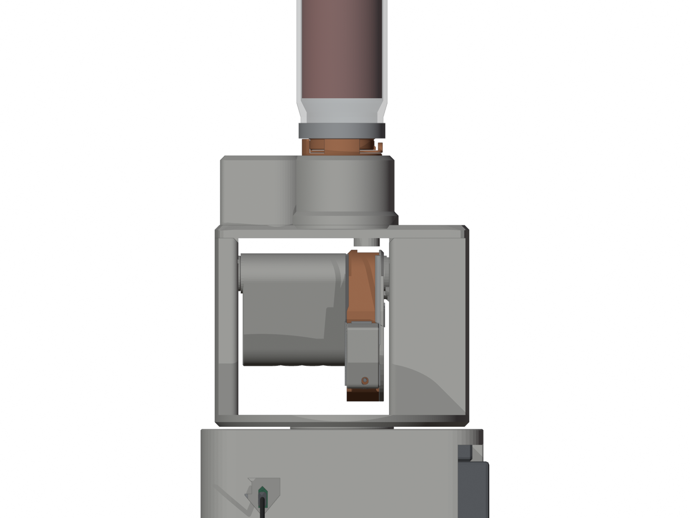
mm-launch-hw/v3/renders/attempt-1/rear.png
