Every-Flavor-Robotics/mm-launcher/mm-launch-hw/v3/renders/attempt-1/review/r02_sec_x42.7_beam_barb_in_release_slot.png

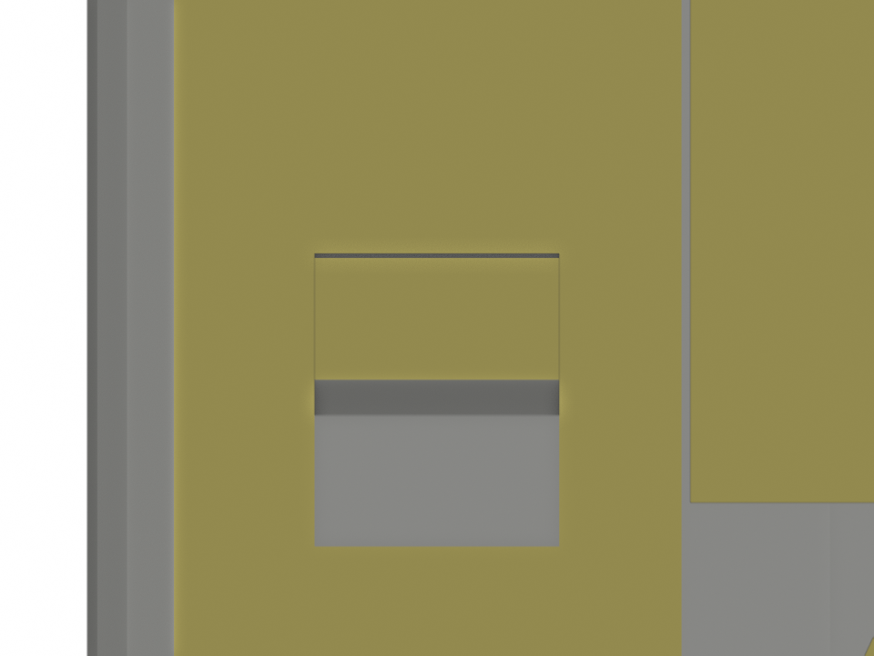
mm-launch-hw/v3/renders/attempt-1/review/r02_sec_x42.7_beam_barb_in_release_slot.png
