Every-Flavor-Robotics/mm-launcher/mm-launch-hw/v3/renders/attempt-1/sec_beam_hook_y18_xR.png

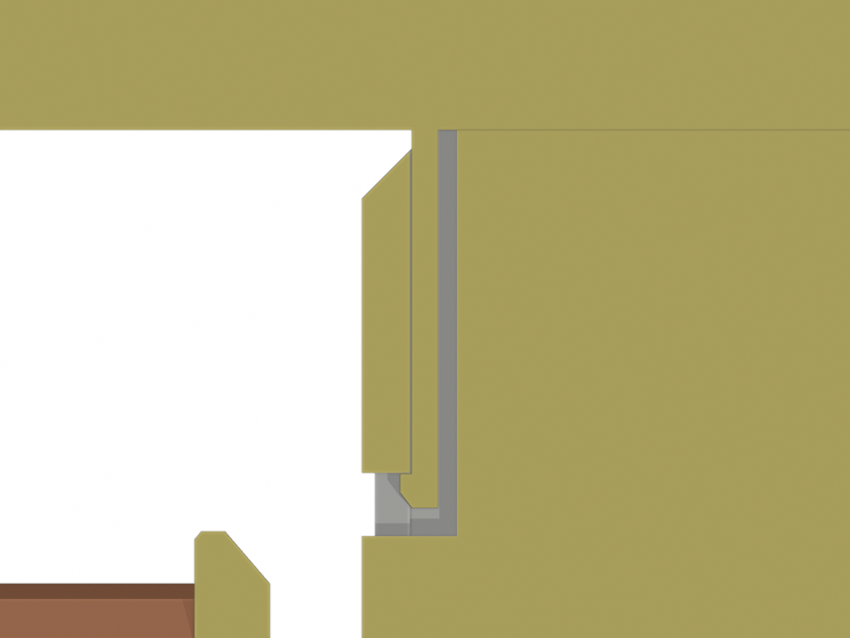
mm-launch-hw/v3/renders/attempt-1/sec_beam_hook_y18_xR.png
