Every-Flavor-Robotics/mm-launcher/mm-launch-hw/v3/renders/attempt-1/sec_crown_hook_y0_xR.png

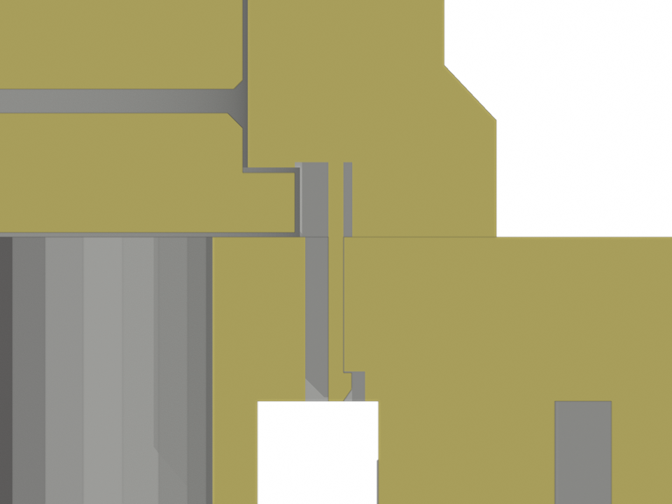
mm-launch-hw/v3/renders/attempt-1/sec_crown_hook_y0_xR.png
