Every-Flavor-Robotics/mm-launcher/mm-launch-hw/v3/renders/attempt-1/sec_gate_finger_z325.png

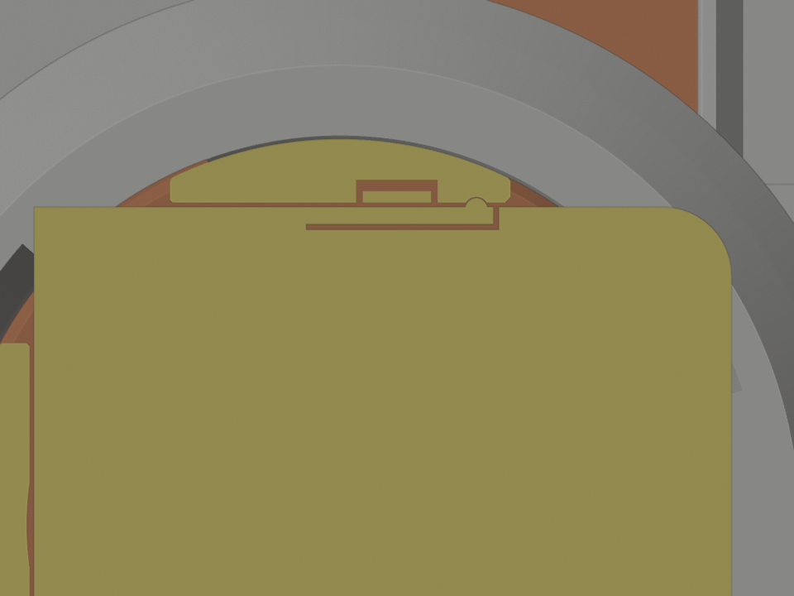
mm-launch-hw/v3/renders/attempt-1/sec_gate_finger_z325.png
