Every-Flavor-Robotics/mm-launcher/mm-launch-hw/v3/renders/attempt-1/sec_hub_roof_y4.0.png

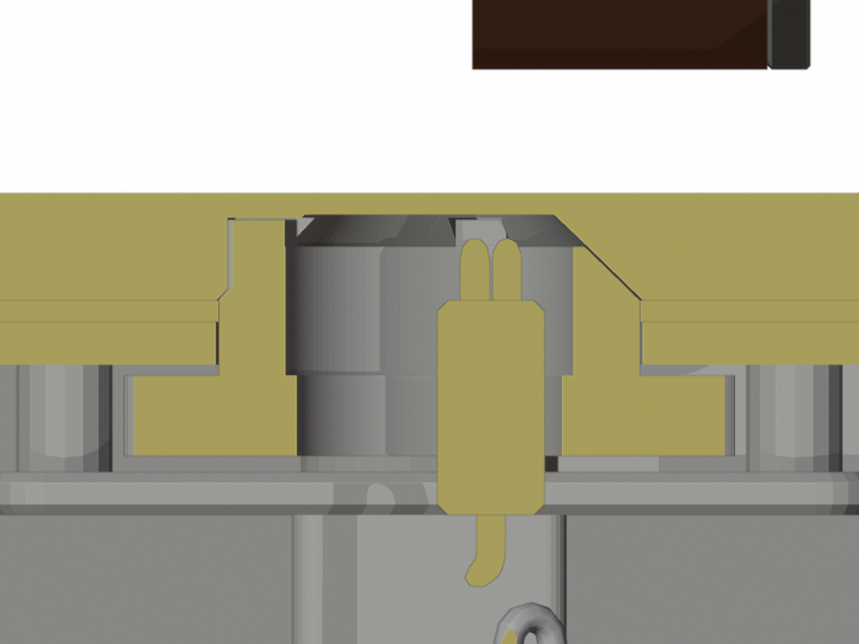
mm-launch-hw/v3/renders/attempt-1/sec_hub_roof_y4.0.png
