Every-Flavor-Robotics/mm-launcher/mm-launch-hw/v2/BOM_AND_ASSEMBLY.md

# M&M Launcher Turret v2: BOM and Assembly (attempt 7, print freeze)

**Print freeze (after review 7, 9/8/9).** The printed geometry is attempt 7's, byte for byte: the rebuild reproduced all
36 machine STLs, the encoder jig and the coupon, and `manifest.json`. Changes since review 7 do not touch a printed part:
step 11a.0 and the printed `stl/tools/tilt45_prop` (A7-01), the bus-lead dress text (A7-02), three new check rows and two
corrected `why` strings (A7-03), and the bundle hand-over swing note (A6-02). The print package is in `BUILD/`.

All dimensions in mm. Source of truth: `blender/params.py` (every number) and `blender/parts/*.py` (one module per subsystem).
Printed parts are in `stl/` in print orientation (36 STLs). Tool prints are in `stl/tools/`: the magnet jig, the pocket test
coupon and the 45 deg assembly prop (`tilt45_prop`, step 11a.0; `blender/tools/tilt45_prop.py`). Evidence: `blender/cadcheck.json` (tools 6025133, full run after the print-freeze rows; `renders/attempt-7/cadcheck.json` is the
run review 7 scored, identical except the new rows). Rows added after review 7 carry the tag `v2-A7-NN`. Rows added in attempt 7 carry the tag
`v2-A6-NN` (the review-6 item they close). Attempt-6 rows keep `v2-A5-NN`, attempt-5 rows `v2-A4-NN`, attempt-4 rows `v2-A3-NN`,
attempt-3 rows `v2-A2-NN`, attempt-2 rows `v2-A1-NN`. Each claim
below names the row it comes from:
`[slide: ...]`, `[service: ...]`, `[index: ...]`, `[distances: a-b @pose]`, `[payload: ...]`, `[sightlines: ...]`,
`[fasteners: FST_x]`, `[drop]`, `[stacks: ...]`, `[flexures: ...]`, `[stability]`, `[cables]`, or `[cad q ...]`.
`manifest.json` `parts.<name>.bom_item` names the purchased item behind `FST_nip_stud`, `FST_detent_0`, `CAB_encoder`,
`CAB_bus_*` (including `CAB_bus_pan_tail`, v2-A6-02) and `BUY_bus_junction` (v2-A5-03; its text is built from `params.BUS_JCT`,
and its step label, 11a, is read from `checks.json` `assembly_order`); `parts.PRT_hood.nip` holds the entry-arc minima and `parts.PRT_nip_leaf.operating` the leaf stress table (all
written by `parts/finish.py`, which re-asserts `NIP_PASS` over the entry arc).

## Evidence summary (cadcheck.json, quoted)

- **0 fails, 37 warns, 0 untriaged, 0 stale accepts** (`summary.pass: true`, tools 6025133; print-freeze run 2026-10-25, same
  37 warns as attempt 7).
  Every warn is in `accepted_warns` with a measured reason; section 7 groups them. `summary.poses_past_limits` is `[]` (the
  rows that pose a joint past its limit on purpose carry `past_limit_ok`). `assembly.unordered_solids_assumed_present` is `[]`
  (every solid has an assembly step). `cad bom BOM_AND_ASSEMBLY.md blender/manifest.json`: 18 rows, 0 disagree, 0 modelled
  screws in no row.
- **What was covered (`coverage`, quoted):**
  - parts: 36 printed objects (36 unique STLs): manifold, bed fit ['P1S', 'H2D'], overhang, wall probe, bed contact.
  - interference/clearance: 178 objects in ['Printed', 'Purchased', 'Fasteners', 'Cables'], 5046 pair-pose tests, joints swept
    ['PIV_feeder', 'PIV_flywheel', 'PIV_gate', 'PIV_hood', 'PIV_jar', 'PIV_nip_lift', 'PIV_pan', 'PIV_tilt'] with 2.5 deg overtravel
    (`PIV_gate` is the new prismatic gate joint, swept with 1 mm overtravel).
  - fasteners: 103 screws, 4 nuts; head-buried, thread engagement (bolt-to-nut pairing), shanks/nuts inside purchased parts, head
    stand-off, protruding thread, access (Ø6 bit to 14 mm hand clearance, else a 18/56 mm L-key with a 60 deg swing) at 16 poses,
    parts present per assembly_order (30 steps).
  - service: 10 ops, 38 screw accesses with the built assembly present (v2-A7-01 adds one op, 6 accesses).
  - drop: 4 tests (fall + slide on walls, no bounce or rolling).
  - index: 6 indexer timing tests (probe through the moving parts over the motion sequence).
  - slide: 18 slide-out sweeps (v2-A7-03 cap exit forward-up, v2-A7-01 post cover off).
  - payload: 4 payload-fit probes (rigid probe, no settling).
  - sightlines: 3 first-hit ray rows.
  - assembly: 30 steps, 178 objects placed, 0 in no step.
  - stacks: 4 tolerance stacks (declared terms only), 0 with a measured limit.
  - flexures: 2 declared springs or snap arms against print orientation.
  - stability: CG and tip angle over 3456 poses, footprint from static parts' lowest faces.
  - cables: 15 routes, 15 with path length, 3 chains; junctions on 15 routes with known ends (cadlib cab_ends), 2 waived with no
    modelled part (cable_junctions_ok); exposure (>= 8 of 26 rays escape, or 10% of the directions toward a viewer) at home pose.
  - (Not listed in `coverage`, but run: 90 `distances` rows, all passing. Of these, 9 are the three swept entry-arc rows at 3
    settings (psi 1..105 since v2-A6-03), 6 are the v2-A5-03 bus-junction rows and 7 are the v2-A6-02 pan-tail rows. New in
    attempt 7 elsewhere: 1 service op and 3 slide rows for v2-A6-01, 1 cable chain for v2-A6-02.)
- **What was not checked (`not_checked`, quoted):**
  - "fasteners: pilot/clearance hole diameters (use cadlib.features for those); wrench access to nuts"
  - "stability: dynamic loads (recoil, pan acceleration), friction/sliding"
  - "cables: bend radius, slack across joints, connector positions (review by section render)"
  - "not geometric: teardown step count, alignment-jig datums (declare stacks), aesthetics, BOM correctness"
- **Stability.** Worst tip 31.2 deg over 3456 poses (unchanged from attempt 6), at feeder -60, hood -0.558, jar 0, nip_lift -2.19, pan -90, tilt 45, gate 0
  (3948 g with the 8 g bus junction, CG (16.1, -13.8, 169.6), edge 102.9) [stability]. The supplementary `blender/tools/cg_grid.py`
  (same mass model, pan 0..315/45 x tilt -3/0/22.5/46 x jar 0/30, 64 poses, `renders/attempt-6/cg_grid.txt`, not re-run in attempt 7) reaches tilt 46 and
  -3, past the joint range: **worst 29.9 deg** at jar 0, tilt 46, pan 180 (3948 g, CG (8.6, -21.4, 169.8), edge 97.6). Acceptance
  (>= 20 deg) holds.
- **Pocket payload fit (v2-A3-A1-03).** Four `payload_fit` rows at the candy size limits (`MM_D` 12.5..13.5, `MM_T` 6.3..7.5) in the
  Ø13.75 pocket:
  - an edge-on MIN pair 12.5 x 6.3 is blocked, 0.253 mm3 overlap, margin 0.06, along x and along y;
  - an edge-on NOMINAL pair 13 x 7 is blocked, 17.553 mm3, margin 0.34;
  - one flat MAX 13.5 x 7.5 fits, margin 0.14 [payload: v2-A3-A1-03].
  - Section `renders/attempt-4/sec_pocket_y18.19_lentil_pair_12.5x6.3.png` (pocket geometry unchanged in attempt 5).
- **Estimated print totals** [parts]: about 1500 g PLA, about 31.6 h, from geometry only; no slicer was run.

## 0. How it works

- **Jar = hopper.** The user's Ball/Kerr regular-mouth pint jar hangs upside down on the pan axis. Its own metal band clamps a printed
  lid disc (`PRT_jar_adapter`). Nothing printed touches the glass or the band:
  - band to crown 14.5 at home and at jar 30 [distances: BUY_jar_band-PRT_feeder_crown];
  - glass to crown 16.6 [distances: BUY_jar-PRT_feeder_crown];
  - glass to the feeder servo cover 7.6 at home and 7.605 at jar 30 [distances: BUY_jar-PRT_feeder_cover].

  The worst-case radial stack from band to housing is 2.4 against a 3.0 design gap [stacks: jar band clears the housing].
- **Feeder index.** A 3-pocket disc (`PRT_feeder_disc`, PIV_feeder) sits under the column. Park is servo 0, where the disc is solid over the outlet.
  - **To fire:** disc +60, then back to 0. **Next shot:** -60, then 0.
  - Each stroke opens exactly one window: +60 opens at 50..60 deg, -60 at -60..-50 deg [index: feeder_fire_plus60_one_candy, feeder_fire_minus60_one_candy].
  - Over the whole 0, +60, 0, -60, 0 sequence the column is never open straight to the outlet, also with the jar drifted 5, 10 or 15 deg
    [index: feeder_column_never_open_to_outlet, v2 column never open, jar drifted 5/10/15 deg].
  - Pockets are Ø13.75 (v2-A3-A1-03, A3 Ø13.9) with a 1 x 45 rim chamfer: 13.75 along x and y at z 267.3 and 269.3, window
    13.65..13.85 [distances: v2-A3-A1-03 pocket diameter]. Two edge-on 12.5 x 6.3 M&Ms cannot sit side by side, and one flat
    13.5 x 7.5 drops through (payload rows above). Ø13.75 is a model value: set it from the printed coupon (section 8).
  - Pocket-over-outlet stack: worst case 0.67 against 1.125 = (16 - 13.75) / 2 [stacks: pocket over outlet at fire: v2-A1-03 / v2-A3-A1-03].
  - The disc is driven by servo #3 through a 30T pinion onto a 44T ring. Disc ±60 = servo ∓88 (`PIV_feeder_pinion` coupled -1.467).
- **Drop path.** The outlet sits at (21, 0), over the tilt axis in the wheel plane. The flywheel tape is modelled (`BUY_tape`, R35..35.5
  on the land, v2-A4), and every drop row lands on `PRT_flywheel` or `BUY_tape` (A1-A4 ended on the bare land, 0.5 conservative).
  - At tilt 0 / 15 / 22.5 / 30 / 40 / 45 / 46: 31/31 traced candies land, 0 stalls, flattest slide 64.7 / 65.5 / 58 / 50.5 / 40.5 /
    35.5 / 34.5 deg [drop: outlet_to_descending_rear_tape].
  - At both nip stops (gap 6.2 at hood +0.327, gap 7.0 at hood -0.558) and tilt -3 / 0 / 22.5 / 45 / 46: 31/31, 0 stalls, flattest
    34.5 at tilt 46 [drop: v2-A2-01/A2-05 drop at the min-gap stop; v2-A2-01 drop at the thumbwheel max].
  - The thickest candy (`MM_T` max 7.5) at both stops and tilt -3 / 0 / 45 / 46: 31/31, flattest 34.5 [drop: v2-A3-A2-01 thick
    candy drop at both hood stops].
  - The flattest slide anywhere is 34.5 deg, 6.5 above the 28 deg stall (target >= 33). The leaf is at rest in these drops: it
    lifts only while a candy is in the nip (`PIV_nip_lift` is `home_only_ok` with that reason); the full-lift case is the gap
    rows below.
- **Undershot nip** (v1 attempt-3 rig geometry, v2 deltas in params.py).
  - The gap is set by the thumbwheel inside the printed window **`NIP_SET` 6.2..7.0**. The minimum is `HOOD_GAP_MIN` 6.2. At full
    leaf lift the nip must pass the **declared thickest** candy on tape: `NIP_PASS` = `MM_T` max 7.5 + `TAPE_T` 0.5 = **8.0**.
  - **`NIP_PASS` is asserted over the whole entry arc** (v2-A4-A2-01 / A4-02). The hood pivots about `HINGE` at psi 112 for both the
    thumbwheel setting and the leaf lift, so the lift opens the arc near the hinge less than at BDC. A4 asserted only at BDC
    (`gap_bdc`, psi -2..+2) and the review found 7.50 at psi 80. `params.gap_arc(eps)` takes the minimum radial gap of the rotated
    hood profile over psi `BP_PSI0` -3 .. `PSI_TOP` 112 in 0.5 deg steps; params asserts `HOOD_GAP_LIFT` = gap_arc at the min stop,
    leaf solid = **8.105 >= `NIP_PASS` + 0.1**, and `parts/finish.py` re-asserts it at all three settings (manifest
    `parts.PRT_hood.nip`):

    | Setting | Hood (deg) | `gap_arc` at rest | `gap_arc` at full lift | Swept ray at full lift: min (psi) | Hood to tape at full lift: min (psi) | Swept ray at rest: min (psi) |
    |---|---|---|---|---|---|---|
    | min stop (printed `PRT_nip_stop`) | +0.327 | 6.180 | 8.105 | **8.098 (63)** | **7.598 (63)** | 6.175 (27) |
    | home (model pose) | 0 | 6.500 | 8.206 | 8.222 (91) | 7.722 (91) | 6.494 (27) |
    | max stop (stop sleeve) | -0.558 | 6.983 | 8.380 | 8.415 (91) | 7.915 (91) | 6.986 (49) |

    **Swept rows (v2-A5-02; stations moved to psi 1..105 in attempt 7, v2-A6-03).** One ray per row, radial through R38 in the
    wheel plane (x 21), turned about the wheel axis over psi **1..105** in 2 deg steps (53 stations); cadcheck reports the worst
    station and the whole profile. A6 swept psi 0..104, and at home and the max stop the psi 0 station ran past the hood's entry
    edge (`missed_deg [0]`, review 6, A6-03); from psi 1 every station lands on the hood at all 3 settings (0 missed). Psi 105
    adds the funnel station past the old 104. Profiles at the min stop, leaf solid (`renders/attempt-7/cadcheck.json`):
    - [distances: v2-A5-02 bare gap at FULL leaf lift over the whole ENTRY ARC, swept 1..105, min `NIP_PASS` 8.0]: psi 1 8.183,
      21-23 8.318 (max), 41 8.225, 51 8.108, 53..61 8.105..8.101, **63 8.098**, 71 8.105, 81 8.099, 91 8.108, 93 8.124, 95 8.269,
      101 9.425, 105 10.519. Home: 8.412 at psi 49, 8.340 at 63, 8.264 at 81, **8.222 at 91**, 8.232 at 93. Max stop: 8.904 at 49,
      8.544 at 81, **8.415 at 91** and 93 (psi 1 reads 14.26: the ray meets the hood's entry chamfer, not the land).
    - [distances: v2-A5-02 the physical pass criterion, hood to `BUY_tape`, swept 1..105, min `MM_T[1]` 7.5]: min stop 7.625 at
      psi 49, **7.598 at 63**, 7.599 at 81, 7.608 at 91; home 7.722 at 91; max stop 7.915 at 91 (each 0.5 = `TAPE_T` under the
      bare row).
    - [distances: v2-A5-02 REST grip profile, swept 1..105, min `HOOD_GAP_MIN` - 0.1 = 6.1]: min stop 6.204 at psi 1, **6.175 at
      27**, 6.218 at 49, 6.646 at 69, 7.267 at 89; home 6.494..6.504 to psi 49; max stop 6.986 at 49 (7.008 at 1).
    - The swept minimum (8.098 at psi 63; 8.099 at psi 81) is 0.007 under the `gap_arc` assert (8.105): the ray samples the
      faceted mesh, the helper the analytic profile. Both are >= `NIP_PASS` 8.0. A4 read 7.50 / 7.72 / 7.94 at psi 80 / 70 / 60
      at the min stop; A6's even stations read 8.099 at psi 90.
    - **Margin at the min stop is 0.098** (psi 63, swept row). That is about FDM tolerance on the hood's inner face and less than one extra
      tape layer, so the tape seam is butt-joined (step 6f) and the thickest-candy rule in section 8 moves the setting off the
      min stop when the calipered `MM_T` max is over 7.3.
  - **The hood profile.** The plan was `PSI_C` 78 -> 45 (the review's fix). That passed the arc (8.14) but stalled 14 drop rows: the
    7.0 candy met the tape only at psi 63-66, a 15-27 deg slide at tilt 45. The shipped profile is the lift-matched one
    (`params.GAP_PROFILE` "lift"): 6.5 to psi about 50; then, to psi about 94, the gap whose point, turned to the min stop with the
    leaf solid, sits `LIFT_FLOOR` 8.105 off the land; then a funnel to `G_IN` 13 at psi 112 whose taper angle stays <= psi - 82
    (`FUNNEL_PSI0`), so the hood slide is never flatter than 34 deg at tilt 46. Rest gap at psi 0..47 is the A4 6.18..7.05.
    `PSI_C` 45 now only feeds `gap_quad` (kept for reference).
  - **BDC at full lift** (A4 rows, unchanged): 8.282 / 8.592 / 8.781 / 9.123 at hood +0.327 / 0 / -0.2 / -0.558, lift -2.19, all
    >= 8.0 [distances: v2-A3-A2-01 bare gap at FULL leaf lift].
  - Section `renders/attempt-5/sec_nip_x21_minstop_fulllift_lentil13x7.5_psi50_80.png` (nip geometry unchanged in attempts 6 and 7): the nip in the wheel plane (x 21) at the
    min stop with the leaf solid, with a 13 x 7.5 candy marker on the tape at psi 50 and psi 80. Ellipsoid marker to the hood 0.113
    (psi 50) and 0.100 (psi 80), to the tape 0.004 / 0.007, no overlap (BVH probe in the section script, `DESIGN_LOG` attempt 5).
  - Two hard stops bound the setting:
    - min gap: the hood's front lug lands on `PRT_nip_stop` at hood +0.327; nip ray 6.202 (6.0..6.4)
      [distances: v2-A2-01 nip ray at the printed min-gap stop]; hood to stop 0.000 [distances: v2-A2-01 the hood lug lands on
      PRT_nip_stop].
    - max gap: the thumbwheel bottoms on `PRT_nip_stop_sleeve` at hood -0.558; nip ray 7.007 (6.8..7.2)
      [distances: v2-A1-01 nip ray at the thumbwheel static max].
  - **Jam relief: the leaf-solid lift stop (v2-A3-A2-01).** A jam lifts the leaf (`PIV_nip_lift` -2.190..0) with the thumbwheel
    riding along. The lift ends when the leaf stack goes solid: pad + strip (`LEAF_PAD_H` 2.0 + `LEAF_T` 2.3 = 4.3) between the
    thumbwheel top and the cover roof. Along the stud axis that gap is 6.500 at rest (6.4..6.6) and 4.288 at -2.19 (4.2..4.4)
    [distances: v2-A3-A2-01 hard stop / home].
    - **A jam opens the nip to about 9.0** at the gap-7.0 setting: 9.124 by the ray (8.8..9.3) [distances: v2-A3-A2-01 jam claim];
      9.0 is the solved `HOOD_GAP_MAX` 8.991.
    - The thumbwheel keeps 1.143 to the cover at full lift [cad q dist PRT_nip_wheel PRT_nip_cover --pose PIV_nip_lift=-2.18977].
  - **Leaf numbers** (`launcher_geom.leaf_numbers`, manifest `parts.PRT_nip_leaf.notes` and `.operating`): 21.9 wide x 34.0 long x
    2.3 thick, PLA E 3.5 GPa, rate 5.93 N/mm. Preload 7.1 N (12.5 MPa at the root) at `LEAF_PRE` 1.2; 20.2 N and **35.5 MPa** with
    the leaf solid (2.2 lift) [flexures: nip leaf spring, 2.2 deg to the bed, in the layer plane]. **Operating stress** (v2-A4-02:
    the lift each candy needs so that the entry-arc minimum `gap_arc` reaches candy + tape, not the BDC gap):

    | Setting | Nominal 7.0 candy: lift (of 2.2) / root stress | Thickest 7.5 candy: lift / root stress |
    |---|---|---|
    | min stop (gap 6.2) | 0.68 / 28.1 MPa | 0.94 / 34.2 MPa |
    | home (gap 6.5) | 0.53 / 24.7 MPa | 0.79 / 30.8 MPa |
    | max stop (gap 7.0) | 0.27 / 18.8 MPa | 0.54 / 24.9 MPa |
    | leaf solid | - | 35.5 MPa |

    A4 quoted 26.9 (nominal) / 30.4 (thickest) at the min stop from the BDC helper; at the min stop the thickest candy now uses 94%
    of the travel and keeps the 6% (0.13 mm at the stud) before solid. Preload is a rig-feedback value (A3 9.1 N).
  - **Leaf creep (v2-A5-04).** The PLA leaf holds 12.5 MPa of preload all the time and sees 28.1 MPa per shot at the min stop
    (34.2 with the thickest candy), about 50-60 % of printed PLA strength, so expect it to relax. Print a **spare leaf** (section 3,
    3.1 g) and keep it unloaded as the reference. **Preload log:** on day 0 and after 1 week in the rig, (a) read the force that
    starts the lift with a push gauge pushing the hood along the stud axis (7.1 N nominal at the leaf; log the same point each time); (b) take the leaf out and caliper its free set at the pad
    against the unused spare (`LEAF_PRE` 1.2 nominal). If either has dropped by more than about 10 % (under 6.4 N, or 0.12 less
    set), the leaf is relaxing: set `LEAF_L` 34 -> 40 (same deflection, x0.72 stress: about 20 MPa nominal at the min stop),
    rebuild and re-run `cad check`. The 40 leaf is not modelled or checked yet: the nip cover and screw block length must be
    re-checked when it is.
  - **`NIP_SET` table** (thumbwheel setting -> hood angle -> bare gap at BDC, stud tip u; `launcher_geom.report`):

    | Setting | Hood (deg) | Gap at rest (BDC ray) | Gap at full lift, BDC ray | Entry-arc min at full lift | Stud tip u at rest |
    |---|---|---|---|---|---|
    | min stop (printed `PRT_nip_stop`) | +0.327 | 6.2 (6.202) | 8.282 | 8.105 | 5.72 |
    | home (model pose) | 0 | 6.5 (6.493) | 8.592 | 8.206 | 6.05 |
    | - | -0.2 | about 6.7 | 8.781 | - | - |
    | max stop (stop sleeve) | -0.558 | 7.0 (7.007) | 9.123 | 8.380 | 6.61 |
    | max + full lift (jam) | -2.748 (`HOOD_LO`) | - | 8.991 solved, 9.124 ray | - | 8.82 |

  - **Rig feedback (v2-A4).** The brief keeps the rig and the turret on the same params, so the test rig's backplate must take the
    same hood profile: the lift-matched `gap_at` table (`GAP_PROFILE` "lift", `LIFT_FLOOR` 8.105, `FUNNEL_PSI0` 82, `G_IN` 13), not
    the A1-A4 `PSI_C` 78 quadratic. The review's `PSI_C` 45 (quadratic) passes the arc too but stalls the 7.0-candy drop at tilt
    >= 40 (progress.md params step), so do not use it on the rig either. Rig numbers still wanted: `NIP_SET`, `G_IN`, `LEAF_*`
    (preload 7.1 N), `STUD_L` 16, tape thickness.
  - The hood keeps 0.54 to the body at the min-gap stop and 0.541 1 deg past it, and 4.723 to the wheel 1 deg past it
    [distances: hood keeps 0.5 to the body; hood never nears the wheel, at +0.327 / +1.327]. At the static max it keeps 0.54 with
    the leaf at rest and 0.532 with the leaf solid [distances: v2-A3-A2-01 fix step 3].
  - Wheel to guard: 1.594 [distances: PRT_flywheel-PRT_launcher_body].
- **Motor direction:** the bottom of the wheel moves forward (+Y), so the rear of the tape descends into the nip (DESIGN_LOG payload path). This is
  design intent; cadcheck does not simulate it.
- **Tilt** 0..45 with hard stops at -3/+46. The firmware must clamp to 0..45.
  - Spout to the pod drum: 3.01 at -3, 3.0 at 0, 2.99 at 45, 2.71 at 46 [distances: PRT_feeder_housing-PRT_launcher_body].
  - Beam to the pod: 4.88 or more [distances: PRT_beam-PRT_launcher_body].
  - Left post to the encoder cap: 3.75 or more [distances: PRT_post_L-PRT_encoder_cap].

## 1. Purchased parts

| # | Part | Qty | Model object | Mass (g, model) | Notes |
|---|---|---|---|---|---|
| 1 | MotorGo Axis (ESP32-S3 BLDC driver) | 1 | `BUY_motorgo_axis` | 25 | On the rear partition, components toward the partition. **M2.5 screws** (see the fastener table). |
| 2 | XTEAM XTI-3674 1900KV inrunner | 1 | `BUY_motor` | 200 | Nacelle bore, crush ribs. |
| 3 | Plink MT6701 encoder + JST cable | 1 | `BUY_plink_encoder` | 3 | On the encoder cap pegs. |
| 4 | Diametric magnet Ø6 x 2.5 | 1 | `BUY_magnet` | 1 | Glued to the motor rear shaft with `stl/tools/encoder_jig`. |
| 5 | Hiwonder bus servo + round horn | 3 | `BUY_servo_pan/tilt/feeder`, `BUY_horn_*` | 66 + 4 each | Pan in the base, tilt inside the right post, feeder in the crown lobe. |
| 6 | Hiwonder bus servo controller | 1 | `BUY_servo_controller` | 30 | Floor plate. Located by +0.4 fences and drill-to-fit bosses; its holes are unconfirmed, so `FST_ctrl_*` is not modelled. Only its slide switch (y 42..57) and terminal (y 60..73.5) show, through two +X windows in a printed bezel; the wall stays closed over the PCB at y 32/50/68, 0.5 from the board [distances: v2-A1-11 +X wall closed]. |
| 7 | DeWalt 20V battery adapter | 1 | `BUY_dewalt_adapter` | 90 | 4 x M3 x 20 csk self-tap from the deck top, no nuts. |
| 8 | DeWalt 20V battery | 1 | `BUY_battery` | 620 | Slides out +X (section 5). |
| 9 | 12 V buck converter, finned 73.8 x 73.8 x 31 | 1 | `BUY_buck_12v` | 180 | Floor plate, flange holes ±33.4 (estimate, see section 8). |
| 10 | USB-C cable, straight plug | 1 | `BUY_usbc_plug`, `CAB_usb` | 10 | Vertical into the MotorGo, out through the rear niche. |
| 11 | Ball/Kerr regular-mouth pint jar + its metal band | 1 | `BUY_jar`, `BUY_jar_band` | 350 + 15 | The user's own. All `JAR_*` values are nominal; confirm them with calipers. About 400 g of M&Ms (`BUY_mm_fill`). |
| 12 | **Cloth hockey tape, 1 in (25 mm)**, trimmed to the land (v2-A5-05) | about 0.25 m | `BUY_tape` (v2-A4) | - | Flywheel land, modelled R35..35.5 (`TAPE_T` 0.5) and **13.8 wide** (x 14.1..27.9, between the flanges) on `PIV_flywheel` [cad q list BUY_tape]; the drop rows land on it. A5 listed 1/2 in (12.7) tape, 1.1 narrower than the model. Buy 1 in, wrap it, and trim it with a knife against the two flanges to the 13.8 land, so the model width (and every drop row) is what you build. **Butt-join the ends with no overlap** and caliper the wrapped tape at **0.5 or less** (v2-A5-02, step 6f): an overlapped seam doubles `TAPE_T` to 1.0 there, more than the 0.098 min-stop margin. |
| 13 | 16 AWG silicone wire, 3 colours, + braided sleeve | 3 x 700 | `CAB_phase_*`, `CAB_launcher_bundle`, `CAB_launcher_base` | - | Motor leads cut to about 55 and extended in the journal bore (lead 80, path 62.4). Bundle down the left post to the hub: lead 350, path 269.8. Base lead from the bundle/base meeting point to the MotorGo J6/J8 pads: lead 250, path 156.1 [cables] (v2-A6-02: inner U leg moved out to r 6.5). Each phase is one 16 AWG wire from the journal-bore splice to the pad, unspliced at the hub: 488.3 of 700 [cables.chains: phase conductors (BOM item 13)]. The encoder lead (item 15) shares the sleeve, on the far side from the phases. |
| 14 | 3-pin Hiwonder servo bus leads | 3 | `CAB_bus_pan` + `CAB_bus_pan_tail`, `CAB_bus_tilt`, `CAB_bus_feeder` | - | **Pan 350** (v2-A3-A2-02: the next stock length up; 300 left 9.5 spare), tilt 300, feeder 500. **The pan lead is one wire in two routes (v2-A6-02):** the static `CAB_bus_pan` (base pocket, riser, arch, U-loop) ends **on the pan axis** at (0, 0, 63) (`params.BUS_PAN_AX`), and `CAB_bus_pan_tail` (14.6, on `PIV_pan`, step 11a) carries on from there to the splice's bottom face at (5.73, 4.02, 74). The hand-over point is on the axis, so the two ends stay together at every pan: 0.011 / 0.008 / 0.013 at pan -90 / 0 / +90 (<= 1.0) [distances: v2-A6-02 CAB_bus_pan-CAB_bus_pan_tail]. A6 ended the static lead 1.2 under a splice at r 7 that swings 9.9 over ±90 (review 6, A6-02). The 350 lead covers both: 277.5 + 14.6 = **292.1 of 350** [cables.chains: pan bus lead (BOM item 14, CAB_bus_pan 350)]. Tilt and feeder routed 206.5 / 319.6 [cables]. Spare: pan 57.9, tilt 93.5, feeder 180.4. Each lead's hub-end plug is cut off and the wires go into the junction (14a) at step 11a. **Lead dress (v2-A7-02, text only):** before soldering, trim the tilt and feeder leads to their route + 70 (tilt about 277, so about 23 off the 300 lead's hub end; feeder about 390, about 110 off the 500 lead), measured from the servo plug to the bore centre at turntable-top level plus 70. The 70 is the solder working length; once the splice is seated it becomes a service loop: the tilt lead's in a flat S-fold in the turntable groove at x 10..60 (only the tilt lead runs there: `CAB_bus_tilt` is the one route with x > 7.1 in the groove), the feeder lead's pushed back up the left-post channel beside the launcher bundle. The pan lead is not trimmed: its 57.9 spare goes back into the U-loop under the hub gear (not modelled; cable slack is in `not_checked`). |
| 14a | **3-way bus junction** (v2-A5-03; made and seated at **step 11a**, v2-A6-01) | 1 | `BUY_bus_junction` | 8 | The Hiwonder bus is a parallel 3-wire bus, so a star is valid: cut the hub-end plug off each bus lead and join like wires, 3 x 3-to-1 solder splices, each under heat shrink, the three sleeved together. Modelled as a **Ø10 x 25 envelope on `PIV_pan`** (it turns with the turntable); **make it 20 long or less** (v2-A7-02): seated with its bottom at z 74, a 20 splice leaves 8.0 under the groove cap for the tilt and feeder leads to turn down onto its top at about R 4 (the 25 envelope leaves 3.0, and the model's lead tubes cross 0.11 under the cap). The model keeps 25: a params-only `BUS_JCT` `l` 20 build fails the captive-splice row (stopped at 8.5 by the cap, window 2.0..4.5), and offsetting the two lead tubes needs per-lead hub lists in `parts/` (review 7, A7-02 items 1-3, deferred), axis Z, in the R14 hub bore at r 7 / az 35, centre (5.73, 4.02), z 74..99 (`params.BUS_JCT`). `CAB_bus_tilt` and `CAB_bus_feeder` end on its top face (z 99); `CAB_bus_pan_tail` ends on its bottom face (z 74). **Installed at step 11a, after every lead is in the groove and before the groove cap** (A6 placed it at 10d, in a bore the cap at 2c and the floor at 3 had already closed: review 6, A6-01). Rows: the splice goes down into the bore with the cap off at tilt 45, min 1.0 to the hub gear [slide: v2-A6-01 bus splice lowered into the hub bore to its seat]; the cap then comes on and stops the splice at 3.5 if it rises [slide: v2-A6-01 the refitted groove cap keeps the splice captive, blocked by `PRT_groove_cap` at 3.5 (2.0..4.5)]; cap to splice 3.0 [cad q dist BUY_bus_junction PRT_groove_cap 3.0]. Clearances: turntable bore 1.945, hub-gear bore 1.000, launcher bundle 2.846 [distances: v2-A5-03]; static launcher base lead 3.286 / 6.979 / 5.203 at pan -90 / 0 / +90 (>= 1.0) [distances: v2-A5-03]; tail to the launcher base lead 1.362 / 2.789 / 2.430 (>= 1.0) [distances: v2-A6-02], swept min 1.236 at pan -92.5 [cad q sweep CAB_bus_pan_tail CAB_launcher_base PIV_pan -92.5 92.5 2.5]; tail to the hub gear 5.825 [distances: v2-A6-02]. 0 cable junction warns. `renders/attempt-7/sec_hub_bore_x5.73_pan-90.png`, `..._pan+90.png`. |
| 15 | **5-wire JST-SH encoder lead, >= 550, one piece, twisted** (v2-A3-A2-02) | 1 | `CAB_encoder` (+ the encoder conductors in `CAB_launcher_bundle`, `CAB_launcher_base`) | - | From the Plink's JST-SH to the MotorGo encoder JST, unspliced across the tilt and pan joints. Buy it twisted (or shielded) and route it **on the far side of the sleeve from the three phase wires**, tied to the sleeve wall opposite them, through the journal bore, the left post channel and the base. Length budget `ENC_LEAD` 550 = bundle 269.8 + base 156.1 + the Plink-to-journal route + 5 spare; `parts/finish.py` writes the Plink-to-journal share, 119.1, as `CAB_encoder` `lead_len` and asserts it covers that route (84.1, 35.0 spare) [cables: CAB_encoder 84.1 / 119.1]. The A3 150 mm extension ended at the journal bore, so 430 mm of encoder lead was in no row (A2-02). Since v2-A4 the whole run is one `cable_chains` row: Plink route + bundle + base 510.0 against the lead less 5 for the plugs, 545 [cables.chains: encoder signal (BOM item 15)]. |
| 16 | UART lead, 4-wire | 1 | `CAB_uart` | - | Lead 300, routed 213.8 [cables]. |
| 17 | 12 V leads | 3 | `CAB_12v_in/mg/ctrl` | - | Leads 200 / 100 / 250, routed 119.4 / 45.2 / 168.8 [cables]. |

**Lead lengths and the pan U-loop (v2-A2-02).** Every `A.cable` carries `lead_len` from `params.CABLE_LEADS` (the same table as
checks.json `cable_leads`), and every route is shorter than its lead [cables]. The pan axis gets its slack in a hanging U-loop under
the hub gear, on the static side of each hub junction:
- `CAB_launcher_base`: the bundle/base meeting point, moved off the pan axis in v2-A5-03 to az 235 / r 4, z 70 (-2.29, -3.28, 70;
  `params.BUS_LB_JCT`), the half of the bore away from the bus junction. From there the inner leg drops at r 6.5 (v2-A6-02, was
  r 3: near the axis it sat where the pan-bus tail now runs), a U of radius 4.75 centred at r 11.25 (bottom centreline z 41.75)
  under the hub gear, the outer leg up at r 16, then across the base to 0.5 over the MotorGo encoder JST and the J6/J8 phase pads.
  Loop 60.6 against a 12.2 chord: **+48.4** (>= `PAN_LOOP_ADD` 45, asserted) [manifest `parts.CAB_launcher_base.loop`]. It
  reaches the board (0.722 to `BUY_motorgo_axis`, <= 3.0) and meets the moving bundle at pan -90 / 0 / +90 (0.916 / 0.006 /
  0.760, <= 1.0) [distances: v2-A2-02].
  **The hand-over is off the pan axis (review 7, A6-02, kept as is).** At r 4 the moving bundle end swings a 2 x 4 x sin 45 =
  **5.66 chord** over ±90 pan while the static base end stays put. The row passes because the two Ø6 sleeves overlap, not
  because the ends coincide (0.916 at pan -90 against max 1.0). On the bench: join the bundle and base conductors with the
  sleeve loose over the joint (no zip tie at the hand-over) so it can flex 6 mm side to side. At step 11a, with the groove
  cap off, turn the turntable slowly to both pan stops and watch the joint through the hub bore: nothing should pull tight.
- `CAB_bus_pan` hub end (v2-A6-02): pocket exit, riser, arch, U, then in to (3, 59) and up the pan axis to `BUS_PAN_AX` (0, 0,
  63): 114.1 against a 55.9 chord, **+58.2** [manifest `parts.CAB_bus_pan.loop`]. The last 14.6 (`CAB_bus_pan_tail`) turns with
  the turntable. Static pan lead to the static launcher base lead 2.585 [cad q dist CAB_bus_pan CAB_launcher_base].
- 45 mm covers ±90 pan on an R14 path (π/2 x 14 x 2 = 44). Bend radius and slack across the joint are in `not_checked`; the
  routes are drawn, not simulated.

## 2. Fasteners (from `manifest.json`)

"ST" = self-tapping into a Ø2.5 printed pilot (M3) or a Ø2.1 pilot (M2.5). Clearance holes are Ø3.4 (M3) or Ø2.7 (M2.5).

| Size | Qty | Objects (assembly step) |
|---|---|---|
| M3 x 20 csk ST | 4 | `FST_adapter_*` (1) |
| M2 x 8 pan | 12 | `FST_pinion_*` (1a), `FST_tilt_horn_*` (8a), `FST_fhorn_*` (10a): horn to printed part |
| M3 x 6 cap | 3 | `FST_pinion_ctr` (1b), `FST_tilt_horn_ctr` (8b): servo centre screws. The feeder has none (v2-A1-04). `FST_nipstop` (6c): retains the nip stop pad, up from the skin (the pocket wall takes the load). |
| M3 x 12 cap ST | 9 | `FST_panclamp_*` (1b), `FST_panservo_*` (1c), `FST_hub_*` (2d) |
| **M2.5 x 10 cap ST** | 4 | `FST_mg_*` (2a). Board holes measure Ø2.5 in `REF/mg_axis.stl` (v2 brief); `MG_SCREW` / `MG_HOLE_D` / `MG_PILOT_D` in params. Engagement 8.0 [fasteners: FST_mg_*]. Access was checked with the M3 tool geometry (Ø6 bit, 2.5 mm L-key); the real driver is a 2 mm key. |
| M3 x 10 csk ST | 10 | `FST_partition_*` (2a), `FST_gcap_*` (**11a**, v2-A6-01: was 2c), `FST_leaf_*` (6e) |
| M3 x 8 pan ST | 2 | `FST_buck_*` (2b) |
| M3 x 16 csk ST | 18 | `FST_post_*` (2c), `FST_beam_*` (9), `FST_feedmount_*` (11) |
| M3 x 12 csk ST | 19 | `FST_floor_*` (3), `FST_enc_*` (6b), `FST_jp_*` (6d), `FST_cover_*` (6g), `FST_fcover_*` (10d) |
| M3 x 10 pan | 4 | `FST_motor_*` (6a), into the motor face |
| M3 x 12 pan ST | 2 | `FST_nacelle_*` (6a) |
| **M3 x 16 hex head, ISO 4017 (AF 5.5 x 2.0)** (stud) | 1 | `FST_nip_stud` (6c), `STUD_L` 16, modelled with the cadlib `M3_hex` spec (v2-A4: closes the A3-02 tool-limit deferral; A1-A4 carried an `M3_cap` stand-in). Captive head in the hood's hex pocket, never driven; the three +v flats key it against the thumbwheel's turning torque. Head stand-off 0, thread 2.4 in `FST_tw_nut`, hood pocket fit 0.1 [fasteners: FST_nip_stud; cad q dist]. `manifest parts.FST_nip_stud.spec` = `M3_hex`. |
| M3 x 35 csk | 1 | `FST_hinge` (6d), into `FST_hinge_nut` |
| M3 x 14 cap ST | 6 | `FST_nipcover_*` (6e), `FST_postcover_*` (8) |
| M3 x 20 cap | 2 | `FST_fw_bolt_*` (6f), through `FST_fw_nut_*` |
| M3 hex nut | 4 | `FST_fw_nut_0/1`, `FST_hinge_nut`, `FST_tw_nut` (captive in the thumbwheel) |
| M3 x 8 csk ST | 2 | `FST_fplate_*` (10c) |
| M3 x 10 cap ST | 3 | `FST_valve_*` (12), radial, counterbored flush with the valve OD |
| **M3 x 10 pan self-tap** (stock) | 1 | `FST_detent_0` (12): radial -Y through the gate detent clip's tab into the +Y valve cheek, head **flush** in a Ø6.6 x 2.4 counterbore (v2-A4-01; A4 sank 1.0 and stood 1.4 proud): back face y 39.9 = head top y 39.9 [cad q list FST_detent_0], bearing face y 37.5, tip y 27.5 as before. Engagement 4.0, stand-off 0 [fasteners: FST_detent_0]. Tip 2.652 above the closed gate blade and 14.867 at the open notch (>= 2.4), 1.142 off the adapter spout (>= 0.5) [distances: v2-A3-A3-01, v2-A4 FST_detent_0 to gate]. `renders/attempt-6/sec_detent_tab_x9.5_band.png`. |
| (not modelled) | 4 | `FST_ctrl_*`: drill to fit on the bench |

Every modelled screw passes head-buried, engagement (4.0 or more into plastic; `FST_nip_stud` takes the full 2.4 of `FST_tw_nut`), bolt-to-nut, purchased-part and access checks, at its step and at the
service poses [fasteners] (0 fails). One fastener warn remains, accepted (section 7): `FST_hinge` needs a 104 mm bit (bench step 6d;
the bit is in the tool list).

## 3. Printed parts (36, PLA, no supports)

Colour map (v2-A1-12, `params.COLOUR_B`, applied by `parts/finish.py` after every subsystem): **B = terracotta (`pla_b`) for the candy
path and the touch points** (jar adapter, valve, gate, feeder housing/spout, disc, launcher body with chute and muzzle, hood, flywheel,
thumbwheel). **A = warm grey (`pla_a`) for static structure and drivetrain** (base, turntable, posts, beam, crown, covers, nacelle,
journal plate, encoder cap, gears, pinions, stops). Grams and hours are the cadcheck estimates [parts]. Every part fits the P1S (256³) [parts].

| STL | Colour | Infill % | Orientation (from the manifest) | g | h |
|---|---|---|---|---|---|
| base_shell | A | 15 | upside down: deck face on the bed, walls up | 374.5 | 7.09 |
| base_floor | A | 15 | flat, bosses up | 135.4 | 2.63 |
| base_partition | A | 25 | rear face on the bed, standoffs up | 18.5 | 0.45 |
| pan_servo_mount | A | 30 | plate top on the bed, pocket walls up | 29.0 | 0.64 |
| pan_servo_clamp | A | 30 | flat | 4.8 | 0.19 |
| pan_pinion | A | 40 | gear top on the bed, horn recess up | 13.1 | 0.34 |
| thrust_ring | A | 100 | flat | 11.9 | 0.32 |
| turntable | A | 15 | top face on the bed, hub up (groove and cap rebate open to the bed) | 137.1 | 2.66 |
| groove_cap | A | 40 | flat, countersinks up | 12.6 | 0.34 |
| hub_gear | A | 40 | flat, screw heads' face down | 10.6 | 0.30 |
| post_L | A | 25 | upright, foot on the bed (U-bore opens to the top; channel cavity roofs bridge 6 mm) | 54.8 | 1.12 |
| post_R | A | 25 | upright, foot on the bed (servo pocket roof bridges 21 mm, teardrop passage, stop lugs drafted) | 157.1 | 3.03 |
| post_R_cover | A | 25 | flat inner face on the bed, arc face up | 15.5 | 0.39 |
| beam | A | 30 | top face on the bed, tongues up | 60.8 | 1.23 |
| tilt_horn_adapter | A | 60 | horn recess face on the bed, hex key up | 3.4 | 0.16 |
| nacelle | A | 25 | front plate on the bed, journal up (duct roof bridges 15 mm) | 121.5 | 2.37 |
| launcher_body | B | 25 | left (motor) wall outer face on the bed; profile extruded so every wall is vertical | 69.1 | 1.39 |
| journal_plate | A | 30 | inner face on the bed; lap step, journal, socket and stop lug grow up | 10.2 | 0.29 |
| launcher_cover | A | 25 | inner face on the bed; rebated edge steps in toward the top | 25.0 | 0.57 |
| hood | B | 40 | on its side face (profile extruded, all walls vertical; stud hex pocket has a vertex up); v2-A4 lift-matched inner profile | 10.2 | 0.29 |
| nip_stop | A | 100 | bottom (screw) face on the bed: pilot vertical, contact face a vertical wall | 1.1 | 0.12 |
| nip_stop_sleeve | A | 100 | end on the bed (tube upright) | 0.4 | 0.11 |
| nip_wheel | B | 50 | outer face on the bed, nut trap up (press the nut in) | 1.0 | 0.12 |
| nip_leaf | A | 100 | flat: strip's outer face on the bed, root block and pads up (bending stress in the layer plane); v2-A3-A2-01 `LEAF_T` 2.3, fork half width 4.0 round `FST_tw_nut`. **Print 2: one fitted, one spare** (v2-A5-04, see "Leaf creep" in section 0) | 3.1 | 0.16 |
| nip_cover | A | 30 | screw-block end on the bed; shell and end walls grow up as vertical walls; skirt bridges at the top; finger slot 22 x 8.3 (v2-A3-A2-01, A3 7.5) in the -v end wall over the thumbwheel rim (v2-A1-02); roof 0.5 higher (`SHELL_U0` 11.5) for the 2.2 leaf lift | 7.7 | 0.24 |
| flywheel | B | 100 | motor-side web face on the bed; rim and hub grow up (top flange has a 45 deg underside) | 41.2 | 0.87 |
| encoder_cap | A | 40 | back face on the bed, spigot and pegs up | 8.7 | 0.26 |
| feeder_housing | B | 30 | disc running face on the bed, spout up | 27.0 | 0.60 |
| feeder_crown | A | 25 | top (z 286) on the bed: lip, socket cone, slot ceilings and pocket floors all print as floors | 51.1 | 1.05 |
| feeder_cover | A | 20 | chamfered top on the bed, ears up | 14.7 | 0.37 |
| feeder_pinion | A | 60 | gear face on the bed, horn recess up | 11.5 | 0.32 |
| feeder_disc | B | 40 | gear band on the bed, fins up; 3 pockets Ø13.75 with a 1 x 45 rim chamfer (v2-A3-A1-03) | 17.0 | 0.42 |
| jar_adapter | B | 40 | lid disc (glass side) on the bed, spout up | 8.6 | 0.26 |
| jar_valve | B | 40 | skirt + baffle bottom on the bed (lug undersides bridge 5.5 mm) | 21.2 | 0.50 |
| jar_gate | B | 100 | flat, chamfer, tab and stop lug up; two R1.1 x 0.6 detent notches on the blade top (x 29.5 closed, -22.5 open) | 9.0 | 0.27 |
| gate_detent | A | 100 | flat +Y back face (screw-head face) on the bed: the beam along x and its bending lie in the layer plane (v2-A2-A1-09). v2-A3-A3-01: tab EB 1.0, plate EB 0.4, R3 plan end on the plate. v2-A5-01: the tab top is flat at z 299.5, 1.0 under the jar band lip (z 300.5), with EB 1.0 on every tab edge (A5's 45 deg chamfer sat 0.322 from the band) [distances: v2-A5-01 band to detent 1.000; stacks: v2-A5-01 worst case 0.8 / 1.0]; back face y 39.9 with a Ø6.6 x 2.4 counterbore, so the pan head sits flush; 1.7 of tab over the counterbore top (z 297.8), 0.7 at the back-face edge under the EB | 1.5 | 0.13 |

## 4. Assembly (the same steps, in the same order, as `checks.json` `assembly_order`)

cadcheck tests tool access for every screw at the step where it is driven, with only the parts listed up to that step present
[fasteners, 30 steps]. "Bench" steps are sub-assemblies, merged later. Step labels are the checks.json labels (there are no
steps 4 and 5). Every solid is in a step: `assembly.unordered_solids_assumed_present` is `[]` (v2-A2-04: A2 left
`PRT_nip_stop_sleeve`, `FST_valve_*` and `BUY_battery` present from step 1).

- **1** **Base shell upside down.** Put the adapter into its fence. Drive the 4 M3 x 20 self-tappers from the deck top. Tips sit 4.56 above the
    battery face [distances: FST_adapter_0/1-BUY_battery].
  - **1a** **Pan drive on the bench:** screw the horn into the pinion recess (4 x M2 x 8). With the horn hub in the way, cadcheck passes these
    only with the L-key fallback. Use a small Phillips.
  - **1b** **Pan drive on the bench:** servo into the pocket + clamp (2 x M3 x 12). Pinion onto the spline. Centre screw through the pinion.
  - **1c** **Pan drive onto the deck posts** (4 x M3 x 12).
- **2** **Floor plate on the bench.**
  - **2a** Partition (2 x M3 x 10 csk from below). MotorGo on its standoffs (4 x **M2.5 x 10** cap).
  - **2b** Buck (2 x M3 x 8 pan), servo controller (drill to fit).
  - **2c** **Turntable on the bench:** posts from the turntable underside (7 x M3 x 16 csk). **Posts only: the groove cap goes on
    at 11a** (v2-A6-01), after every bus lead is in the groove; leave it and its 6 screws in the bag.
  - **2d** Thrust ring on the hub. Turntable assembly into the deck hole. Hub gear meshed under the deck and screwed up into the hub
    (3 x M3 x 12). The floor is still off. The gear (R28.5) is wider than the R20.3 deck hole, so it goes on from below.
- **3** **Floor into the shell** (8 x M3 x 12 csk from below). Cables: 12 V, UART, USB-C, pan bus (with its U-loop under the hub
    gear and its hub-end plug still on; feed the plug end up through the hub bore and leave it coiled above the turntable: it is
    spliced at 11a), and the launcher base lead (v2-A2-02): from the bundle/base meeting point at (-2.29, -3.28, 70), inner leg
    down at r 6.5 (v2-A6-02), through a hanging U-loop under the hub gear, then
    across the base to the MotorGo J6/J8 phase pads and its encoder JST. Leave the loops hanging free: they are the ±90 pan slack.
- **6** **Pod on the bench.**
  - **6a** Motor into the nacelle bore (crush ribs). Body onto the nacelle plate. Motor screws (4 x M3 x 10 pan) and nacelle screws (2 x M3 x 12)
    from inside the guard. Phase leads into the journal bore.
  - **6b** Glue the magnet on the rear shaft with the jig (spigot in the 8 mm access hole). Plink onto the cap pegs. Encoder cap into the bore
    (2 x M3 x 12 csk). Centring stack: worst case 0.30 against a 0.30 limit, with the 7.9 jig spigot and 2.4 Plink pegs (v2-A1-07) [stacks: magnet centring], a pass.
  - **6c** Drop the **M3 x 16 hex head (ISO 4017, AF 5.5 x 2.0)** stud head into the hood's hex pocket, flats keyed (modelled as
    `M3_hex`, pocket fit 0.1). It is captive and never driven. Press the nip stop pad
    (`PRT_nip_stop`) into its pocket under the muzzle floor, top flush with the floor, and retain it with 1 x M3 x 6 cap up from the skin
    (v2-A1-01).
  - **6d** Backplate into its bay. Journal plate on (3 x M3 x 12 csk). Hinge axle M3 x 35 through the wall, boss and plate into its trapped nut.
    The bit needs 104 mm of reach from -X (warn); do this on the bench.
  - **6e** Stop sleeve over the stud (v2-A1-01), then the thumbwheel onto the stud (set the gap). Leaf screwed under the nip cover from outside (2 x M3 x 10 csk). Cover onto the land
    (2 x M3 x 14 cap).
  - **6f** **Tape the flywheel land first (v2-A5-02 / A5-05):** wrap 1 in cloth hockey tape once round the land, sticky side down,
    and **butt-join the ends with no overlap** (cut both ends square on the wheel). Trim both edges with a knife against the
    flanges to the 13.8 land. Caliper the tape over the land at three places and at the seam: it must read **0.5 or less** (`TAPE_T`).
    A thicker tape, or any overlap, eats the 0.098 min-stop entry-arc margin (section 0); re-wrap it. Then the flywheel onto the
    D-shaft. Two M3 x 20 pinch bolts through their nuts, with an L-key from +X.
  - **6g** Wheel-side cover (4 x M3 x 12 csk).
- **7** **Pod into the post U-slots, nose-up about 20 deg.** Hold the pod tilted nose-up about 20 deg and lower it straight down until
    both journals seat in the U-slots, then level it. Reversed, this is the +Z lift-out at tilt 20: it clears with 0.2 to post_L
    [slide_out: v2-A1-06 step 7 reversed].
  - **8a** **Tilt drive on the bench:** horn screwed to the adapter (4 x M2 x 8).
  - **8b** **Tilt drive on the bench:** adapter + horn onto the servo spline. Centre screw through the Ø6.5 key hole.
- **8** **Tilt servo + horn adapter slide in -X through the right post.** The hex key goes into the journal-plate socket. Then the post cover
    (4 x M3 x 14 cap).
- **9** **Beam closes the journal U-slots** (7 x M3 x 16 csk). Launcher bundle into the left post channel.
  - **10a** **Feeder drive on the bench:** horn screwed into the pinion recess (4 x M2 x 8).
  - **10b** **Crown upside down:** pinion + horn in from below. Then servo #3 goes into its pocket from the top, spline pressed into the
    horn. There is no centre screw (v2-A1-04): the 4 x M2 `FST_fhorn_*` hold the horn in the pinion recess, and the lobe cover (10d)
    holds the servo down on its pocket floor.
  - **10c** Disc in from below (the band meshes with the pinion). Floor plate on with 2 x M3 x 8 csk from below.
  - **10d** Feeder upright: bus into the channel, servo cover (2 x M3 x 12 csk). **Feeder cover only** (v2-A6-01): the feeder
    bus lead hangs free, plug on, until 11a.
- **11** **Feeder onto the beam:** 4 x M3 x 16 csk, up through the beam into the crown.
    - The -X pair sits at (-36, ±21) (v2-A1-05), 3.52 from the feeder pinion [distances: FST_feedmount_0/1-PRT_feeder_pinion].
      (-36, -21) takes a straight bit (58 mm reach). (-36, +21) takes the 2.5 mm L-key: the nacelle blocks a straight bit at 23.9, and
      the L-key arc is 180 deg. The (34, ±20) pair takes the L-key (journal plate at about 21 mm, arc 150-170 deg). Drive at tilt 0
      [fasteners: FST_feedmount_0..3].
- **11a** **Bus splice and groove cap (v2-A6-01, BOM 14a).** Every bus lead reaches the turntable groove only after step 8 (tilt),
    9 (bundle) or 11 (feeder), and the groove cap closes that groove and the hub bore, so the splice and the cap come last. Each
    sub-step cites its row; the step's objects (`BUY_bus_junction`, `CAB_bus_pan_tail`, `PRT_groove_cap`, `FST_gcap_*`) are
    checks.json step "11a" [assembly: 11a (v2-A6-01), 0 findings, 30 steps].
    0. **Free the pod and put it on the 45 deg prop (v2-A7-01, review 7).** The tilt servo is engaged in the journal-plate socket
       since step 8 and cannot be powered here (its lead is spliced at 11a.4, the battery goes in at step 14), so do not force the
       pod round against it: that back-drives the servo's gear train. Instead:
       - Take the right post cover off (4 x M3 x 14 cap, straight bit, reach 18) [service: tilt servo swap: right post cover
         off]; it slides off +X, 0.3 from the servo [slide: v2-A7-01 right post cover off +X].
       - Slide the tilt servo, horn and adapter out +X about 10 mm. The 12 AF key leaves its socket after 6.5 [slide: tilt servo
         out +X, min 0.10]. Don't turn the servo output while it is out.
       - The pod now swings freely. Unpowered, its motor end swings it nose-down onto the -3 stop. Lift the nose to the +46 stop,
         slide the printed prop (`stl/tools/tilt45_prop`, blue in `BUILD/renders/s11a0_*`) in on the turntable from the front,
         pad under the nip cover and foot against the right post's front face, and let the pod settle on it.
       - Seated (measured in a scratch copy of the model with the prop added, `blender/tools/tilt45_prop.py --blend`): the pad
         top is the plane of the nip cover's underside at tilt 45 (z = 168.98 - 0.497 y, flat to 0.000 over the pad); prop to
         nip cover -1.0 mm3 (face contact) at 45 and 1.04 at 46, so it slides in at the stop; foot 0.3 from the post (it bears
         after 0.3 of slide; the pod pushes it back as well as down); prop to the groove cap 8.5, to `FST_gcap_5` 12.3, to the
         thumbwheel 8.5 and to the leaf 5.4, so it never presses the gap setting. With the prop in place all 6 cap screws still
         take a straight bit at 14 [cad check --only service on the scratch blend: 0 fail, 0 warn], and the cap's
         forward-up exit still passes (min 0.2).
    1. **Pod at 45 on the prop.** All cap screws and the cap's lift-off are checked at this pose [service: v2-A6-01 groove cap off
       for the bus splice, pose tilt 45; service: v2-A7-01 groove cap screws at tilt 45 with the right post cover off: 6/6
       straight 14].
    2. Lay the tilt and feeder bus leads and the launcher bundle in the turntable groove, down to the hub bore [assembly: 11a
       (v2-A6-01): the cap and its screws are absent until this step, so the groove is open].
    3. **Pull the pan lead up the hub bore** until about 60 stands above the turntable: the 350 lead has **57.9 spare** over its
       292.1 route [cables.chains: pan bus lead (BOM item 14, CAB_bus_pan 350), v2-A6-02]. The bore is open from above because
       the cap is not on yet [assembly: 11a (v2-A6-01)]. Bring the tilt and feeder ends down to it (93.5 / 180.4 spare) [cables].
    4. Cut the three hub-end plugs off. **Trim the tilt and feeder leads to route + 70** (v2-A7-02, item 14: hold each end at the
       bore centre at turntable-top level and cut 70 beyond it); leave the pan lead long. Strip, solder like wires 3-to-1 (V+, GND,
       signal) **above the turntable** (lay card or foil round the bore so the iron never touches the PLA), heat-shrink each
       splice and sleeve the three together, **Ø10 x 20 or smaller** (the model's envelope is Ø10 x 25) [BOM 14a envelope,
       `params.BUS_JCT`]. Working above the
       turntable is possible because nothing closes the bore before this step: `BUY_bus_junction` first exists at 11a [assembly:
       11a (v2-A6-01)], and the splice then has its whole +Z 40 path out of the bore clear [slide: v2-A6-01 bus splice lowered
       into the hub bore].
    5. **Lower the splice into the hub bore at az 35** (the side away from the launcher bundle) until its bottom is at **z 74**
       (its top at z 99, 3.0 under the cap's underside). Going down it clears the hub gear by 1.0 and nothing else is closer
       [slide: v2-A6-01 bus splice lowered into the hub bore to its seat (z 74, az 35), reversed +Z 40, min 1.000 to
       `PRT_hub_gear`, at tilt 45]. Seated: turntable bore 1.945, hub gear 1.000, bundle 2.846 [distances: v2-A5-03].
    6. **Tie it to the bundle sleeve** so it turns with the turntable (2.846 apart in the bore [distances: v2-A5-03]), still at
       tilt 45 with the cap off [slide: v2-A6-01 bus splice lowered into the hub bore to its seat, pose tilt 45].
    7. **Push the spare pan lead back down into its U-loop** under the hub gear; the static loop carries +58.2 of slack for ±90 pan
       [manifest `parts.CAB_bus_pan.loop`], and the last 14.6 (`CAB_bus_pan_tail`, step 11a) runs from the pan axis at z 63 up to
       the splice [distances: v2-A6-02 CAB_bus_pan-CAB_bus_pan_tail 0.011 / 0.008 / 0.013 at pan -90 / 0 / +90]. The tail is an
       11a object [assembly: 11a (v2-A6-01)], so it is placed with the splice, before the cap.
    8. **Groove cap on: 6 x M3 x 10 csk, straight bit, pod still at tilt 45.** All 6 take a straight bit at 14 reach there
       [service: v2-A6-01 groove cap off for the bus splice: 6/6 straight 14 at tilt 45]; at home `FST_gcap_5` is blocked by the
       pod and `FST_gcap_2/3` need the L-key (accepted warn `FST_gcap_5 reachable only at tilt=45`) [fasteners: FST_gcap_*].
       The cap goes down over the posts with 0.2 to `PRT_post_L` [slide: v2-A6-01 groove cap lifts +Z off the turntable at tilt
       45, reversed, min 0.2].
    9. **Retention:** the cap's underside is 3.0 over the splice top [cad q dist BUY_bus_junction PRT_groove_cap 3.0] and stops it
       at 3.5 if it rides up [slide: v2-A6-01 the refitted groove cap keeps the splice captive: blocked at 3.5 by
       `PRT_groove_cap`, inside the row's 2.0..4.5 window]. With a 20 splice seated at z 74 the gap is 8.0, so it stops at
       about 8.5 instead: still captive, outside the model's row window (the model carries the 25 envelope).
       Before the cap goes on: dress the service loops (item 14: tilt S-fold in the groove at x 10..60, feeder back up the
       left-post channel) and check the bundle hand-over swing (U-loop paragraph, A6-02).
    10. **Back to tilt 0 (v2-A7-01).** Lift the pod nose to the +46 stop, take the prop out, and lower the pod onto the -3 stop.
       Slide the tilt servo back -X until its hex key re-enters the journal-plate socket (rock the pod a degree to line up the
       flats), then refit the post cover (4 x M3 x 14). The pod now holds wherever the servo was left; set the true zero at
       power-up (`ASSEMBLY.md` step 15).
- **12** **Jar on the bench:** adapter in the band. Lay the gate on the valve's gate floor, closed, with its stop lug up at the -X end.
    Then put the valve on the spout (3 x M3 x 10 cap, radial). The spout tip closes over the lug, so the gate is captive from here on
    (v2-A1-09). **Gate detent clip** (v2-A2-A1-09): hold `PRT_gate_detent`'s tab on the +Y cheek's outside face, with the gate closed,
    so its R1 bump drops into the blade's closed notch (x 29.5), and drive 1 x **M3 x 10 pan self-tap** radially (-Y) into the cheek,
    head down into the tab's Ø6.6 x 2.4 counterbore until it sits flush with the tab back face (v2-A4-01) [fasteners: FST_detent_0,
    engagement 4.0, stand-off 0];
    the tip ends 2.652 above the blade and 1.142 off the spout [distances: v2-A3-A3-01]. Seated bump to blade 0.10 in the closed
    notch and 0.10 in the open notch at `PIV_gate` 52 (<= 0.15) [distances: v2-A2-A1-09 detent clip bump seated; v2-A4 detent bump
    seated in the open notch]. The clip's 1.2 x 12.5 plate lifts 0.4 to ride the blade between the notches: 16.1 MPa, beam in the layer plane
    [flexures: gate detent clip, 0.0 deg to the bed].
- **13** **Jar onto the feeder:** drop it in at +30 and twist to 0. The twist is swept in the interference check (PIV_jar 0..30, no fails).
- **14** **Battery** slides onto the adapter rail, +X to -X, last (checks.json step 14, v2-A2-04). Reversed, it slides out +X 120 past
    every fastener with 1.60 to the floor [slide: battery out +X].

## 5. Service (each row is a cadcheck `service` or `slide_out` result)

| Task | How | Evidence |
|---|---|---|
| Set the nip gap | **Cover on.** Roll the thumbwheel with a fingertip through the 22 x 8.3 slot in the nip cover's -v end wall. The slot top sits 0.3 over the rim, and an R8.5 finger scallop (v2-A2-03) is cut from the guard shelf beside it, so an R8 fingertip resting on the rim crest clears the shelf. Travel is bounded by the two printed stops: **gap 6.2..7.0** (`NIP_SET`). | [distances: v2-A2-03 thumbwheel rim crest on the finger approach line] 24.511 (24.0..25.0); [distances: v2-A2-03 R8 fingertip clears the guard shelf at u -4.5 / -6 / -8] 25.160 / 24.637 / 22.999 (>= 24.9 / 24.4 / 22.7); [cad q ray 19.5,-2.33,111.274 0,-0.316,0.949 -> PRT_nip_wheel at 14.4 (tilt 0)]; [cad q ray 19.5,77.315,143.401 0,-0.895,0.445 --pose PIV_tilt=45 -> PRT_nip_wheel at 14.4]; [sightlines: v2-A3-A2-03 fingertip line reaches the thumbwheel rim first] 3/3 rays hit `PRT_nip_wheel` first at home (13.75 / 14.4 / 13.75), at tilt 45 (same) and at full lift nip_lift -2.19 (14.58 / 14.84 / 14.58; v2-A4: origins moved 0.25 along U with the nip); the rim keeps 1.143 to the cover at full lift [cad q dist]; `renders/attempt-3/sec_x19p5_finger_scallop.png` |
| Nip leaf | Tilt to 45. Remove the nip cover (2 x M3 x 14 cap) and the leaf (2 x M3 x 10 csk), straight bit. Swap in the spare (v2-A5-04) if the preload log shows relaxation (section 0, leaf creep). | [service: v2-A1-02 replace the nip leaf] reach 18 / 14, straight |
| Tape / flywheel | Tilt to 45. Remove the pod cover (4 screws, straight bit). Loosen the pinch bolts with the L-key (arc 80 / 100 deg). The wheel slides off +X. | [service: pod cover off], [service: re-tighten the flywheel pinch bolts], [slide: flywheel off +X at tilt 45] 140 mm, min 1.59 |
| Encoder | Tilt to 45. Remove 2 screws. The cap comes off -X. | [service: encoder cap off], [slide: encoder cap off -X] not blocked (0.00 is the seat it slides off, row min 0.0) |
| Nip cover + leaf removal path | The cover and leaf drop out downward at tilt 45. | [slide: nip cover + leaf off] not blocked (0.00 is the seat, row min 0.0) |
| Tilt servo | Remove the right post cover (4 screws). The servo, horn and adapter slide out +X 60 mm. The pod stays in. | [service: tilt servo swap] reach 18, straight; [slide: tilt servo out +X] not blocked, min 0.10 (accepted warn: at rest, the tips of the four M2 x 8 horn screws 0.10 from the journal plate's counterbore floor, same body; then the 12 AF key leaves its 12.3 AF socket at 0.15 per flat for 6.5 mm) |
| Feeder servo | Remove the lobe cover (2 screws, reach 44). The servo lifts +Z off the horn spline; the horn and pinion stay in the crown. No other screw is involved (v2-A1-04: A1's centre screw was only reachable with the feeder off the beam). | [service: v2-A1-04 feeder servo swap: lobe cover off] reach 44, straight; [slide: v2-A1-04 feeder servo lifts +Z] 60 mm, not blocked (0.00 is the pocket floor it rests on); the `FST_fhorn_ctr` service row matches nothing |
| Bus splice (v2-A6-01) | **Groove cap off at tilt 45.** If the bus works, command tilt 45 and leave the servo powered while you work. If the bus is the fault (the servo can't hold), power off and use step 11a.0: post cover off, tilt servo slid +X out of its socket, pod on the 45 deg prop. Then remove the 6 x M3 x 10 csk with a straight bit and lift the cap off forward-up (-Y +Z) [slide: v2-A7-03 groove cap leaves the machine forward-up, min 0.2]. Cut the tie, lift the splice +Z out of the hub bore (the pan lead's U-loop gives the slack), re-solder or swap it above the turntable, then step 11a 5-9 again. | [service: v2-A6-01 groove cap off for the bus splice (BOM 11a / 14a)] 6/6 straight 14 at tilt 45; [slide: v2-A6-01 groove cap lifts +Z off the turntable at tilt 45] 40 mm, min 0.2 to `PRT_post_L`; [slide: v2-A6-01 bus splice lowered into the hub bore to its seat] +Z 40 with the cap off, min 1.000 to `PRT_hub_gear`; [slide: v2-A6-01 the refitted groove cap keeps the splice captive] blocked at 3.5 by `PRT_groove_cap` |
| Base floor | 8 screws from below. The floor plate drops -Z with the partition, MotorGo, buck and servo controller on it (and their screws); unplug the leads as it comes down. | [service: base floor off]; [slide: v2-A3-A3-03 base floor plate with its electronics drops -Z after the 8 floor screws] 40 mm, not blocked (`blocked_at_mm` null; 0.00 is the seat, closest `PRT_base_shell`) |
| Refill | Push the gate closed with the R6 tab (the model's home pose). The tab is flush with the valve OD when closed. Twist the jar to 30 and lift it. Flip it, unscrew the band. To open, pull the tab +X until the lug meets the spout shoulder at +52.35 (the positive stop). The detent clip (v2-A2-A1-09) clicks into a notch at both ends, so the gate holds closed and open. v2-A4: the gate is the prismatic joint `PIV_gate` (0 closed .. 52 open notch), so its open state is in every interference sweep and has posed rows. | [slide: v2-A1-09/A2 gate opens +X 52] min 0.08 to `PRT_gate_detent`, which rides the blade on `flex` (<= 1.0 mm3), valve and clip present; [fits: v2-A5-06 detent x gate] contact only on the blade's top face (Z normal), min 0.10 over the gate sweep (A5's unbounded `allow` is deleted); [slide: v2-A4 gate open stop] blocked at 52.5 by `PRT_jar_adapter`; [distances: v2-A4 hard stop] lug to adapter 0.000 at 52.35, blade to valve 0.000 at the -0.4 closed stop; [distances: detent bump seated] 0.10 closed and 0.10 at 52; [distances: FST_detent_0-PRT_jar_gate] 2.652 at 0, 14.867 at 52 (>= 2.4); [fits] blade 0.35 to the valve and the adapter over the slide; [flexures: gate detent clip] 16.1 MPa, 0.0 deg; [slide: jar group lifts off when unlocked] not blocked (0.00 is the seat) |
| Battery | Last on (step 14). Slides out +X 120 mm past every fastener. | [slide: battery out +X] min 1.60 |

The pod cover, encoder cap, nip cover, jar group, feeder servo, lobe cover and base floor rows read 0.00: the resting contact at the start of each
move. Their rows now carry `min_clearance` 0.0 with that reason in the name, so they are not warns. Of the 16 slides, two are
blocked, as they expect (`expect: blocked`): the gate open stop (by `PRT_jar_adapter` at 52.5) and the captive bus splice (by
`PRT_groove_cap` at 3.5, v2-A6-01).

## 6. Renders and sections (`renders/attempt-7/`)

- Final view set, 1800 x 1350 (`CAD_RENDER_FINAL=1`): `iso`, `iso_front_left`, `front`, `side`, `top`, `rear`, `pan-90_tilt0`,
  `pan+90_tilt45`, `tilt45`, `jar_unlocked`, `exploded`. `BUY_jar` is a transmissive glass material (RGBA alpha 0.25,
  `params.JAR_GLASS_RGBA`, set in `parts/finish.py`), so the M&M fill shows through (v2-A1-11).
- **`front.png` and `side.png` are re-framed (v2-A5-05).** `render.view_set` sets the elevations' ortho width to 1.25 x the largest
  extent, which leaves a 0.94 x height window for the 432.6 tall machine, so A5's side (and front) cut off the jar top and the
  base bottom. `parts/finish.py elevations()` (called by `build_assembly.py` right after `view_set`) re-renders both with the
  frame fitted to the scene bounds + 8 %: z 0.0..432.6 inside a 467.2 tall window (ortho 622.9), 17.3 of margin above the jar
  and below the base (build log `FINISH elevation front/side`).
- `stl_sheet.png`: all 36 STLs in print orientation, with the P1S bed (256 x 256) for scale (`cad sheet stl ...`).
- `renders/attempt-6/cg_grid.txt`: the 64-pose tip-angle grid (worst 29.9 deg); not re-run, the mass model is unchanged (3948 g,
  the same worst cadcheck pose and CG [stability]).
- Sections (960 px):
  - `sec_hub_bore_x5.73_pan-90.png`, `sec_hub_bore_x5.73_pan+90.png` (v2-A6-01 / A6-02, attempt 7): cut at x 5.73 (the splice
    axis at pan 0), seen from +X, at pan -90 and +90. At -90 the splice is cut (it has swung to (4.02, -5.73)); at +90 it stands
    whole behind the plane. Both show the white pan-bus tail rising from the static lead's end on the pan axis (z 63) to the
    splice's bottom face (z 74), the launcher base lead's inner leg beside it, and the groove cap over the splice top.
    `cad q section x 5.73 ... 300,0,78 70 --pose PIV_pan=-90 / 90`. The numbers behind them are rows: tail to base lead 1.362 /
    2.430 at pan -90 / +90 [distances: v2-A6-02], splice to cap 3.0 [cad q dist].
  - From attempt 6 (geometry unchanged): `renders/attempt-6/sec_detent_tab_x9.5_band.png` (v2-A5-01): the detent tab on the screw axis with the jar band in view: the flat tab top
    (z 299.5) 1.0 under the band lip (z 300.5), EB 1.0, the pan head flush in the Ø6.6 x 2.4 counterbore, the shank into the +Y
    valve cheek, the tip above the gate blade. (`sec_detent_tab_x9.5_feeder_step.png` is the closer crop from the feeder step.)
  - `renders/attempt-6/sec_hub_bore_z88_bus_junction.png` (v2-A5-03): the hub bore cut at z 88, seen from above: the Ø10 bus junction at r 7 / az
    35 and the Ø6 launcher bundle on the az 235 side inside the turntable's R14 bore and the R13 hub-gear bore.
  - Still current from attempt 5: `renders/attempt-5/sec_nip_x21_minstop_fulllift_lentil13x7.5_psi50_80.png` (nip unchanged;
    the review's `review/r01_nip_x21_minstop_fulllift_lentil13x7.5_psi85_90.png` shows the psi 90 minimum); from attempt 4:
    `sec_pocket_y18.19_lentil_pair_12.5x6.3.png`, `launcher_tongue_hood_lo_x22.png`, `sec_stud_hex_pocket_y4.83.png` (A4
    cap-head stand-in; the model now carries `M3_hex`); from attempt 3: `sec_x19p5_finger_scallop.png`.

## 7. Warns (37, all triaged in `checks.json` `accepted_warns`)

Each accept is a substring of the warn plus a measured reason; a fixed warn would show up as a stale accept (there are none: the
six A4 accepts for bridges and ray-vs-nearest rows stopped matching under tools dea6536 and were removed).
- **Thin walls under 1.6 (A1-08), 12.** Each sample is located (cadcheck `where`) and explained:
  - gear tooth tips 1.54 (pan_pinion, hub_gear, feeder_disc, feeder_pinion): involute tips, not walls.
  - jar_valve 1.29: the roof between the three `FST_valve_*` cap-head counterbores (z 295.5) and the cheek tops (z 300).
  - journal_plate 1.29: the floor of the `FST_hinge_nut` trap (x 31.5..32.8), solid bottom layers loaded in compression.
  - gate_detent 1.20: all 64 samples on the 1.2 plate, the designed detent beam [flexures] (A5 66 with the chamfered tab); the
    flat-topped tab reads none (its counterbore rim, 1.65..1.7 under the top, is measured by `cad q ray`, see the accept). jar_gate 1.40: blade under the two detent notches.
  - feeder_cover 1.40: the roof over the servo idler-boss recess, printed first on the bed.
  - nip_cover 1.48: the 45 deg slot-end chamfer and one counterbore edge.
  - nip_wheel 1.50: the thumbwheel's outer face over the captive-nut trap. nip_leaf 1.49: between `FST_leaf_1`'s pilot and the
    leaf's +X end.
- **Overhang, 1.** beam 205 mm2: loft-seam facets at the four R6 plan corners where the top chamfer ends.
- **Overtravel, 20 (12 collide, 3 touch, 5 clearance).** All are 2.5 deg (1 mm on the gate slide) past a limit that is itself a
  printed stop: hood -3.06 or +2.83, nip_lift -4.69 or +2.5, tilt 47.5, gate -1 or 53. Each accept quotes the in-range value: hood
  to body 0.54 at both stops (0.532 with the leaf solid), sleeve to body 0.584-0.595, wheel to cover 1.143 at full lift, sleeve to
  leaf 1.782, hood to `FST_nipstop` 2.0, tilt lugs 0.000 at +46, hood to tape 5.674 at +0.327 (v2-A4), gate blade to valve 0.000 at
  the -0.4 closed stop and lug to adapter 0.000 at the 52.35 open stop (v2-A4). New in attempt 6: detent touches the gate at gate
  -1 only (v2-A5-06: the A5 `allow` became a `fits` rule, so this overtravel pose is now reported; -1 is past the -0.4 closed stop).
- **Fasteners, 2.** `FST_hinge` needs a 104 mm bit (bench step 6d). New in attempt 7: `FST_gcap_5 reachable only at tilt=45
  (blocked at home pose)`: the cap now goes on at 11a with the pod in place, and 11a is done at tilt 45, where all 6 take a
  straight bit at 14 [service: v2-A6-01 groove cap off].
- **Slide, 1.** Tilt servo 0.10: the horn-screw tips at rest, same body (section 5).
- **Cables, 1 (new in attempt 7).** `CAB_bus_pan_tail` has no `lead_len`: it is the last 14.6 of the pan 350 lead, not a
  separate purchase, and the `cable_chains` row "pan bus lead" (CAB_bus_pan + CAB_bus_pan_tail, 292.1 / 350) is its length
  check. The junction rule finds no shared end point (`cables.junctions` `[]`): the bus leads end on `BUY_bus_junction`
  (modelled, v2-A5-03), the pan lead's static/tail pair is declared by its chain, and the bundle/base pair meets at (-2.29,
  -3.28, 70), off the bus ends. `cable_junctions_ok` is `CAB_phase_*` only. One wire per conductor across each hand-over is
  checked by three `cable_chains` rows: encoder 510.0 / 545, phases 488.3 / 700, pan bus 292.1 / 350.
- **Drop, bridges.** None.

## 8. Not done / to confirm

- **After review 7 (print freeze, no printed geometry changed):**
  - A7-01 (major): step 11a.0 frees the pod (post cover off, tilt servo +X 10 out of its socket) and holds it on the printed
    `stl/tools/tilt45_prop` (`blender/tools/tilt45_prop.py`, 49 x 31 x 51, 24.6 cm3). Rows: [service: v2-A7-01 groove cap screws
    at tilt 45 with the right post cover off] 6/6 straight 14; [slide: v2-A7-01 right post cover off +X] min 0.3. The prop is a
    tool, not in the model (at tilt < 45 the pod would sweep through it, and cadcheck has no fixture concept), so its numbers
    come from a scratch blend: face contact with the nip cover at 45, 1.04 clear at 46, 8.5 to the cap, 12.3 to `FST_gcap_5`,
    and the cap service and slide rows re-run with it present: 0 fail, 0 warn (step 11a.0).
  - A7-02 (minor): BOM text only (item 14, 14a, step 11a.4 and 11a.9): tilt and feeder leads trimmed to route + 70 with stated
    service-loop homes, a 20 mm splice. The model change (`BUS_JCT` `l` 25 -> 20, lead tubes offset ±1.5, two lead-to-cap
    rows) is deferred: params-only `l` 20 fails the captive-splice row (8.5 against 2.0..4.5), and the offsets need parts/ edits.
  - A7-03 (minor): the reviewer's forward-up exit row is adopted [slide: v2-A7-03 groove cap leaves the machine forward-up]
    min 0.2 to `PRT_post_L`; the two v2-A6-02 `why` strings now say z 63 and r 6.5.
  - A6-02 (minor, kept): the 5.66 swing of the bundle hand-over is documented (U-loop paragraph, section 1); no model change.
- **Resolved in attempt 7** (each with its row):
  - v2-A6-01 (major): the splice went into a hub bore that the groove cap (2c) and the floor (3) had already closed. The cap and
    its 6 screws, the splice and the pan tail now go on at **step 11a**, after the feeder (11), at tilt 45: [assembly: 11a,
    0 findings]; [service: v2-A6-01 groove cap off] 6/6 straight 14 at tilt 45; [slide: v2-A6-01 groove cap lifts +Z] min 0.2
    (post_L); [slide: v2-A6-01 bus splice lowered into the hub bore] min 1.000 (hub gear); [slide: v2-A6-01 captive] blocked at
    3.5 by `PRT_groove_cap`. Step 2c is posts only, 10d the feeder cover only.
  - v2-A6-02: the static pan lead ends on the pan axis (0, 0, 63) and a 14.6 `PIV_pan` tail carries it to the splice:
    static-to-tail 0.011 / 0.008 / 0.013, tail to the launcher base lead 1.362 / 2.789 / 2.430 at pan -90 / 0 / +90, tail to
    the hub gear 5.825 [distances: v2-A6-02]; chain 292.1 / 350 [cables.chains: pan bus lead]. The launcher base lead's inner leg
    moved r 3 -> 6.5 to make room (loop +48.4 >= 45; meeting point unchanged, 0.916 / 0.006 / 0.760 to the bundle).
  - v2-A6-03: the three swept entry-arc rows run psi 1..105 (53 stations, 0 missed at all 3 settings): full lift 8.098 / 8.222
    / 8.415, tape 7.598 / 7.722 / 7.915, rest 6.175 / 6.494 / 6.986 (section 0).
- **Deferred in attempt 7:** the optional 2 mm tie slot in the hub-gear bore (A6-01 fix item 3). The cap stops the splice
  rising (3.5); downward it hangs from the tilt and feeder leads pinned in the groove and is tied to the bundle. The slot would
  need a radial window through the gear's bore ring (z 77.5..85), and the splice's lower 3.5 (z 74..77.5) hangs below the gear.
- **Resolved in attempt 6** (each with its row):
  - v2-A5-01 (major): detent tab capped flat at z 299.5: band to tab 1.000 (>= 1.0; A5 0.322) [distances: v2-A5-01]; vertical
    stack worst case 0.8 / RSS 0.418 against 1.0 [stacks: v2-A5-01]; head flush (stand-off 0, engagement 4.0), tip 2.652 / 14.867
    off the gate, seated 0.10 / 0.10.
  - v2-A5-02: entry arc swept psi 0..104 at 3 settings (A6 numbers; psi 1..105 since attempt 7): 8.099 / 8.211 / 8.397 (>= 8.0),
    hood to tape 7.599 / 7.711 / 7.897 (>= 7.5), rest 6.176 / 6.493 / 6.987 (>= 6.1). Tape seam butt-joined and calipered <= 0.5 (step 6f); the thickest-candy
    rule below.
  - v2-A5-03: the bus junction is modelled (`BUY_bus_junction`, item 14a) with 6 distance rows, 0 junction warns (step 10d in
    attempt 6; 11a since attempt 7).
  - v2-A5-04: spare leaf and the preload log (section 0, leaf creep). `LEAF_L` 40 stays conditional on the log.
  - v2-A5-05: item 12 is 1 in tape trimmed to the 13.8 land (model width kept, drops unchanged: 31/31, flattest 34.5); front and
    side re-framed (section 6).
  - v2-A5-06: the detent x gate `allow` is a `fits` rule (contact on Z faces only, min 0.10 over the gate sweep).
- **Thickest-candy rule for the nip setting (v2-A5-02).** After calipering (below), if the `MM_T` max is **over 7.3**, run the
  thumbwheel at **home or above** (gap 6.5..7.0), not at the min stop. At the min stop the declared 7.5 candy passes the full-lift
  entry arc with only **0.098** (8.098 at psi 63 against `NIP_PASS` 8.0, swept row psi 1..105), about the hood's FDM tolerance.
  At home the same candy keeps 0.222 (8.222 at psi 91) and at the max stop 0.415; a 7.3 candy at the min stop keeps 0.298. The min stop is
  for small candies only.
- **Resolved in attempt 5** (each with its row):
  - v2-A4-A2-01 (major): the full-lift entry arc. 15 rays at psi 50 / 55 / 60 / 70 / 80 x 3 settings, min 8.105 (>= 8.0);
    `NIP_PASS` asserted over `gap_arc` (8.105 >= 8.1); drops 31/31 at every row, flattest 34.5; BDC 8.282..9.123, jam 9.124.
  - v2-A4-01: detent tab chamfer (band 0.322) and flush pan head (stand-off 0, head top y 39.9 = back face).
  - v2-A4-02: leaf operating stresses from the entry arc (table above), `NIP_PASS` claim from `gap_arc`, `PRT_nip_cover` orient
    text from `FINGER_SLOT` (manifest: "finger slot 22 x 8.3").
  - A4 tool-limit deferrals: the gate is a prismatic joint with posed rows at both notches and both stops; the stud is `M3_hex`.
- **Bus junction (item 14a): modelled in attempt 6** as the solder star splice (Ø10 x 25). A bus hub board would also do if it
  fits that envelope; the daisy chain (controller -> pan -> tilt -> feeder servo) remains the alternative and would re-route
  `CAB_bus_feeder` to the tilt servo.
- **Calipering and the pocket coupon (do this before printing the feeder disc).**
  1. Caliper 20 M&Ms: diameter across the flat face and thickness at the centre. Write the min and max into `params.py` `MM_D` and
     `MM_T` (now 12.5..13.5 and 6.3..7.5, nominal).
  2. Print `stl/tools/test_pocket_coupon.stl` like the feeder disc (same PLA, same slicer profile, flat, chamfered face up). It is
     an 8 mm disc, OD 51.1, with four through pockets Ø13.6 / 13.75 / 13.9 / 14.1 (smallest first; pocket k has k + 1 rim notches),
     each with the disc's 1 x 45 rim chamfer. Re-export with `cd blender && cad py tools/pocket_coupon.py` (writes `stl/tools/`).
  3. For each pocket: one flat candy of the largest diameter must drop through; two of the thinnest candies stood edge-on side by
     side must not both enter (push gently; they ride on the rim).
  4. Set `POCKET_D` to the smallest pocket that passes the flat candy and still blocks the pair, rebuild and `cad check`: the 4
     `payload_fit` rows and the 4 pocket-diameter ray rows follow `POCKET_D` (the ray rows' 13.65..13.85 window must move with it).
  5. If `MM_T` max changes, `NIP_PASS` and the full-lift rows follow (params and `parts/finish.py` assert the entry-arc minimum
     >= `NIP_PASS` + 0.1; `LIFT_FLOOR` must move with it).
- **Nip window width.** The static window stays 6.2..7.0; the rig's 5..12 range waits for rig numbers. With the hood hinged at psi
  112, a wider static window costs entry-arc lift margin (progress.md params step: the static-max rest gap is tied to the
  min-stop full-lift gap by a fixed hood turn).
- **Not modelled:** `FST_ctrl_*` (drill to fit); the bayonet detent nub (the L-slots have hard ends with 3 deg of margin); the
  optional open-gate interlock; the encoder lead's position inside the sleeve (cables are drawn as one route each); the conditional
  `LEAF_L` 40 leaf (section 0, leaf creep).
- **Deferred (tool limit):** `post_R x journal_plate` `contact_normal` (the 0.156 journal row stays). A wafer- or button-head
  detent screw: cadlib has no such spec, and the 2.4 counterbore makes the pan head flush instead.
- **Confirm with calipers:** all `JAR_*`; `MM_D` / `MM_T` (above); the MotorGo hole size (`MG_*`: M2.5 now, components.json
  says Ø3.4) and its J6/J8 pad position (`MG_PHASE_PAD_STEP`, not in components.json); adapter corner holes (6 inset);
  `BATT_STEM_INSET`; buck flange holes ±33.4; the servo controller's switch and terminal positions (`CTRL_SW`, `CTRL_TB`).
- **Deviations from the plan:**
  - Attempt 5: the hood uses the lift-matched profile, not the planned `PSI_C` 45 quadratic (that stalled 14 drop rows); the tape
    is modelled (`BUY_tape`) and the drops land on it.
  - The baffle ramps are 45 deg from horizontal, not 30. 30 gave 325 mm² of supported overhang on the valve.
  - The baffle sits on the valve, so it covers the outlet only when the bayonet is locked at 0.
  - Detent plate edge break 0.4, not the review's 0.6 (0.6 on the 1.2 plate meets in a knife edge).
- **Launch rig feedback still to come:** `NIP_SET` 6.2..7.0, `G_IN`, `LEAF_*` (preload 7.1 N, and the 1-week preload log), `STUD_L` 16, tape thickness; the
  rig backplate takes the lift-matched hood profile (section 0).
