Every-Flavor-Robotics/mm-launcher/mm-launch-fw/web/model/feeder.stl

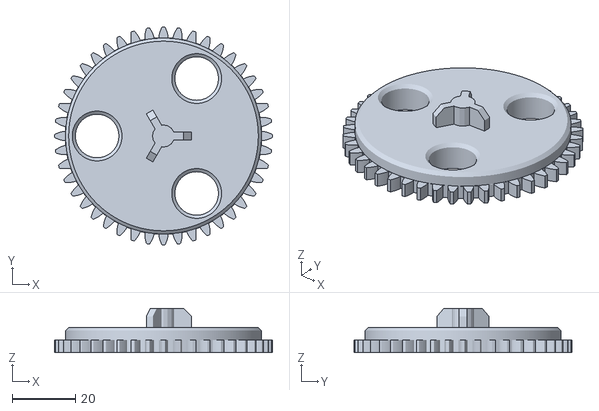
[picture p98: CAD file, 2026-11-02]
mm-launch-fw/web/model/feeder.stl
69.0 x 69.0 x 14.0
