Every-Flavor-Robotics/mm-launcher/mm-launch-hw/reference/prior_plink_case_-_part_2.stl

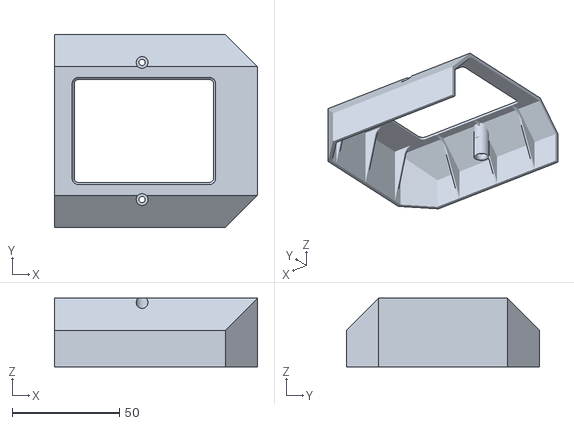
[picture p99: CAD file, 2026-11-02]
mm-launch-hw/reference/prior_plink_case_-_part_2.stl
94.7 x 90.0 x 32.0
