Every-Flavor-Robotics/mm-launcher/mm-launch-hw/stl/launcher_body.stl

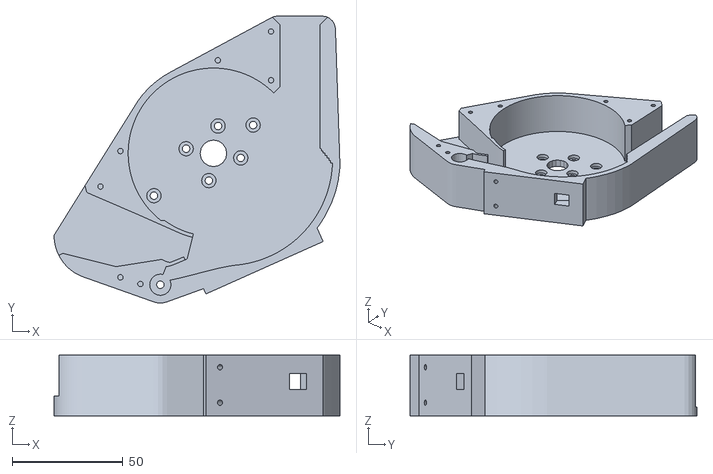
[picture p100: CAD file, 2026-11-02]
mm-launch-hw/stl/launcher_body.stl
129.1 x 129.6 x 27.5
