Every-Flavor-Robotics/mm-launcher/mm-launch-hw/test-prints/launch-rig/stl/backplate.stl

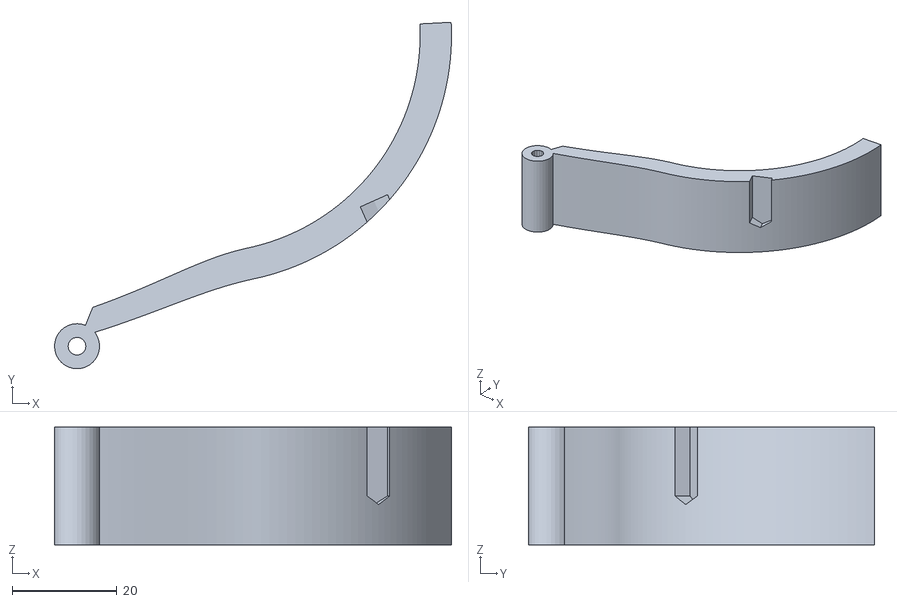
[picture p101: CAD file, 2026-11-02]
mm-launch-hw/test-prints/launch-rig/stl/backplate.stl
75.8 x 66.1 x 22.5
