Every-Flavor-Robotics/mm-launcher/mm-launch-hw/v3/BUILD/plates/0a-fit-coupons-grey/c2_hub_socket.stl

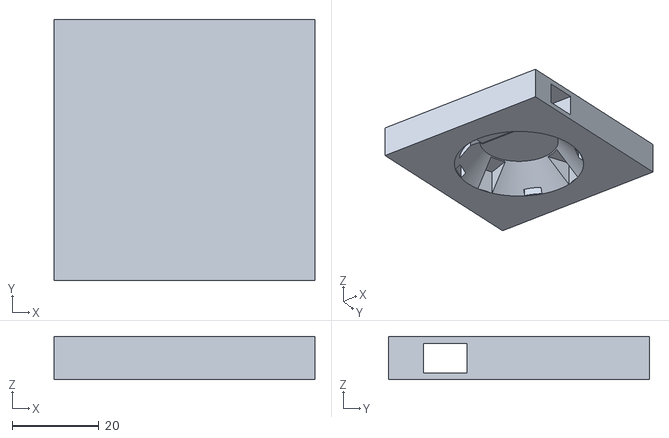
[picture p102: CAD file, 2026-11-02]
mm-launch-hw/v3/BUILD/plates/0a-fit-coupons-grey/c2_hub_socket.stl
60.0 x 60.0 x 10.0
