Every-Flavor-Robotics/mm-launcher/mm-launch-hw/v3/BUILD/plates/0b-fit-jar-terracotta/jar_adapter.stl

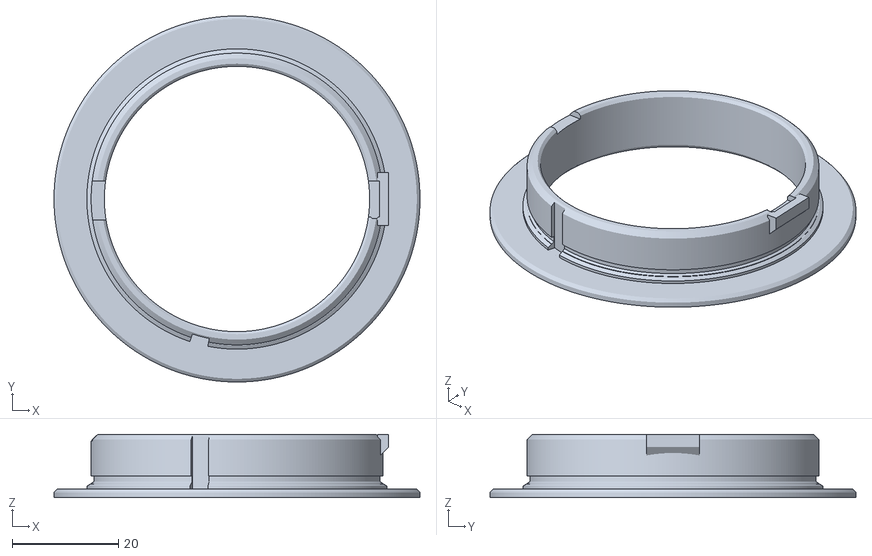
[picture p103: CAD file, 2026-11-02]
mm-launch-hw/v3/BUILD/plates/0b-fit-jar-terracotta/jar_adapter.stl
69.0 x 69.0 x 11.9
