Every-Flavor-Robotics/mm-launcher/mm-launch-hw/v3/BUILD/plates/1-pod-grey/nip_leaf_spare.stl

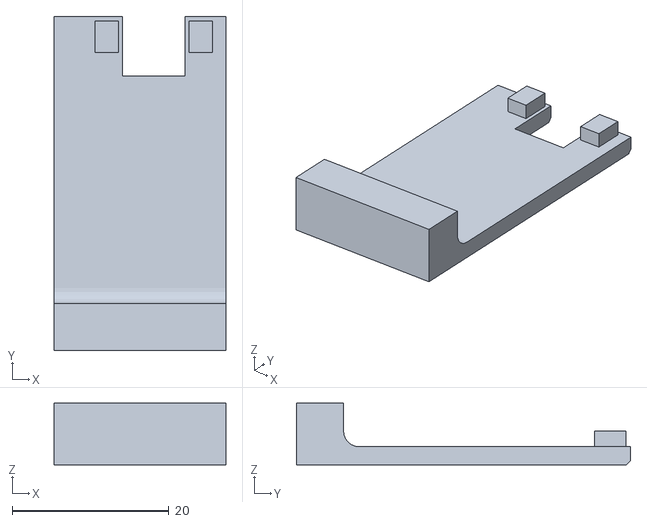
[picture p104: CAD file, 2026-11-02]
mm-launch-hw/v3/BUILD/plates/1-pod-grey/nip_leaf_spare.stl
21.9 x 42.6 x 7.85
