Every-Flavor-Robotics/mm-launcher/mm-launch-hw/v3/BUILD/plates/2-pod-feeder-terracotta/hood.stl

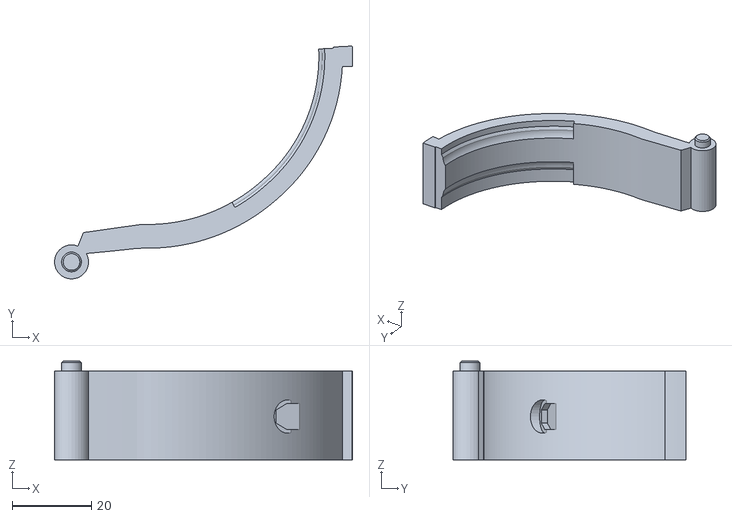
[picture p105: CAD file, 2026-11-02]
mm-launch-hw/v3/BUILD/plates/2-pod-feeder-terracotta/hood.stl
75.3 x 58.8 x 25.0
