Every-Flavor-Robotics/mm-launcher/mm-launch-hw/v3/BUILD/plates/3-beam-crown/feeder_pinion.stl

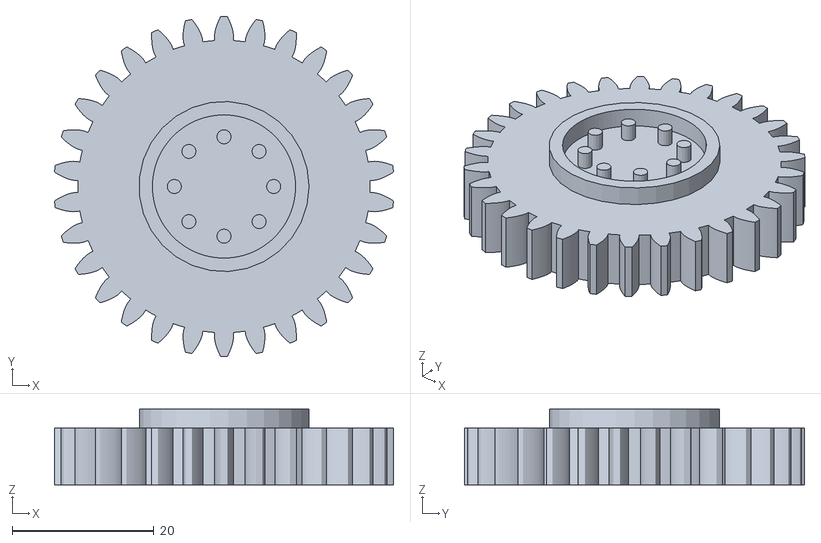
[picture p106: CAD file, 2026-11-02]
mm-launch-hw/v3/BUILD/plates/3-beam-crown/feeder_pinion.stl
47.8 x 48.0 x 10.7
