Every-Flavor-Robotics/mm-launcher/mm-launch-hw/v3/BUILD/plates/4-turntable/turntable.stl

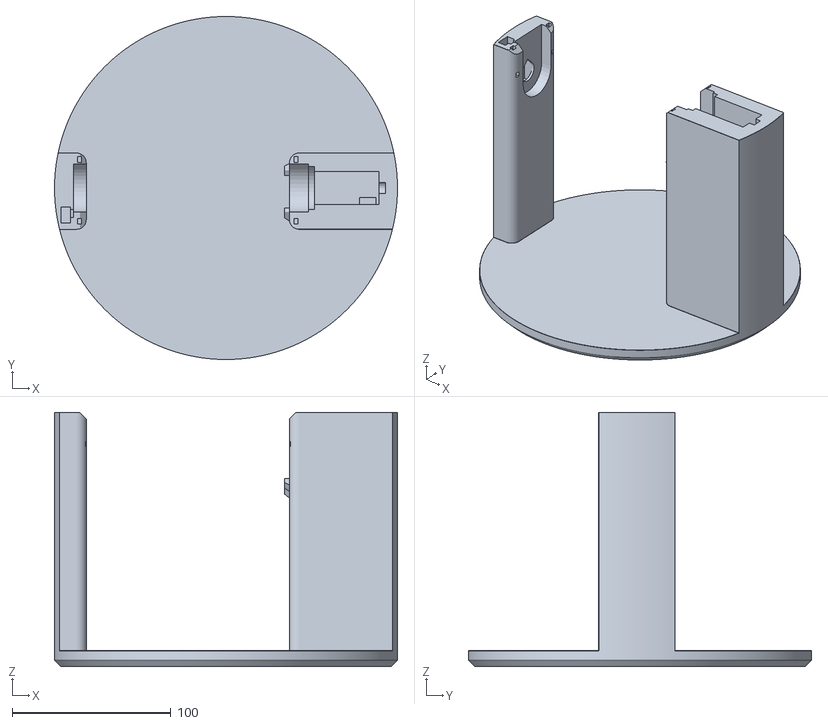
[picture p107: CAD file, 2026-11-02]
mm-launch-hw/v3/BUILD/plates/4-turntable/turntable.stl
216.0 x 216.0 x 160.0
