Every-Flavor-Robotics/mm-launcher/mm-launch-hw/v3/BUILD/plates/5-base-shell/hub_gear.stl

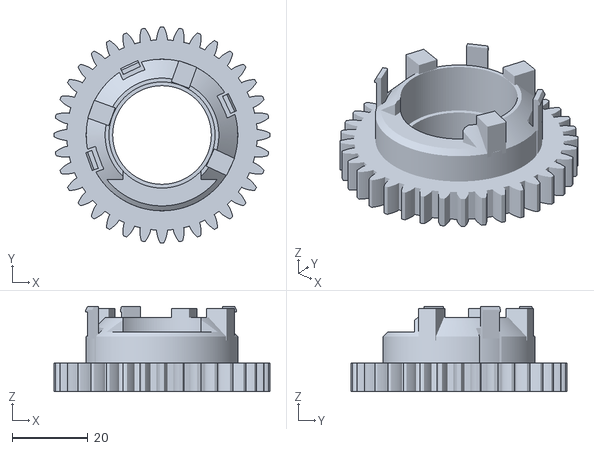
[picture p108: CAD file, 2026-11-02]
mm-launch-hw/v3/BUILD/plates/5-base-shell/hub_gear.stl
57.0 x 57.0 x 22.5
