Every-Flavor-Robotics/mm-launcher/mm-launch-hw/v3/BUILD/plates/6-base-floor/base_floor.stl

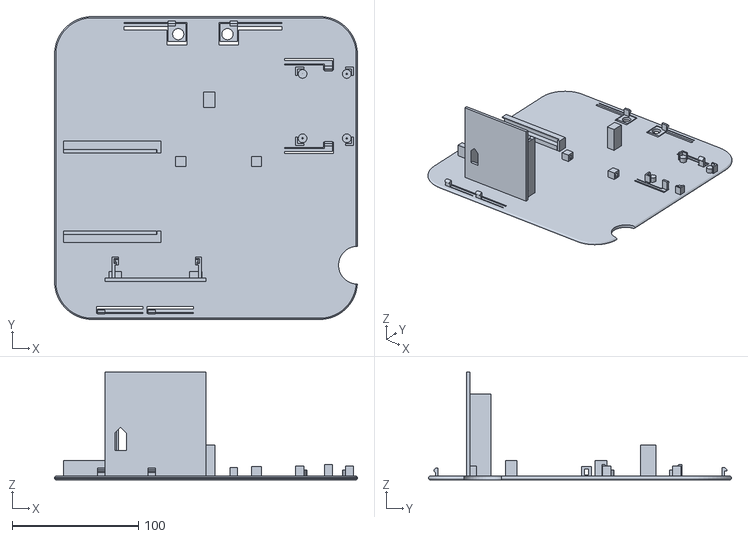
[picture p109: CAD file, 2026-11-02]
mm-launch-hw/v3/BUILD/plates/6-base-floor/base_floor.stl
240.0 x 240.0 x 85.5
