Every-Flavor-Robotics/mm-launcher/mm-launch-hw/v3/stl/tilt_horn_adapter.3mf

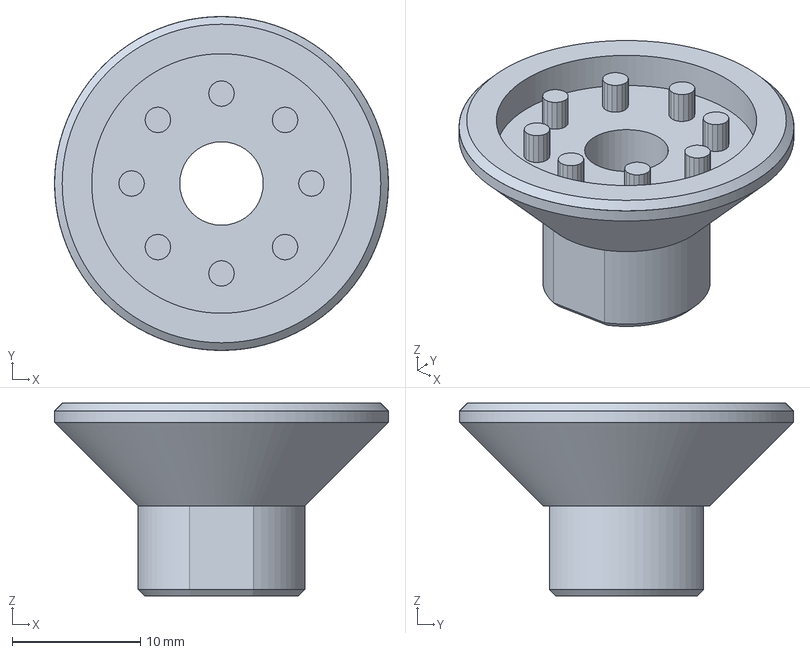
[picture p110: CAD file, 2026-11-02]
mm-launch-hw/v3/stl/tilt_horn_adapter.3mf
26.0 x 26.0 x 15.0 mm
