Every-Flavor-Robotics/mm-launcher/mm-launch-hw/v3/stl/tools/tilt45_prop.stl

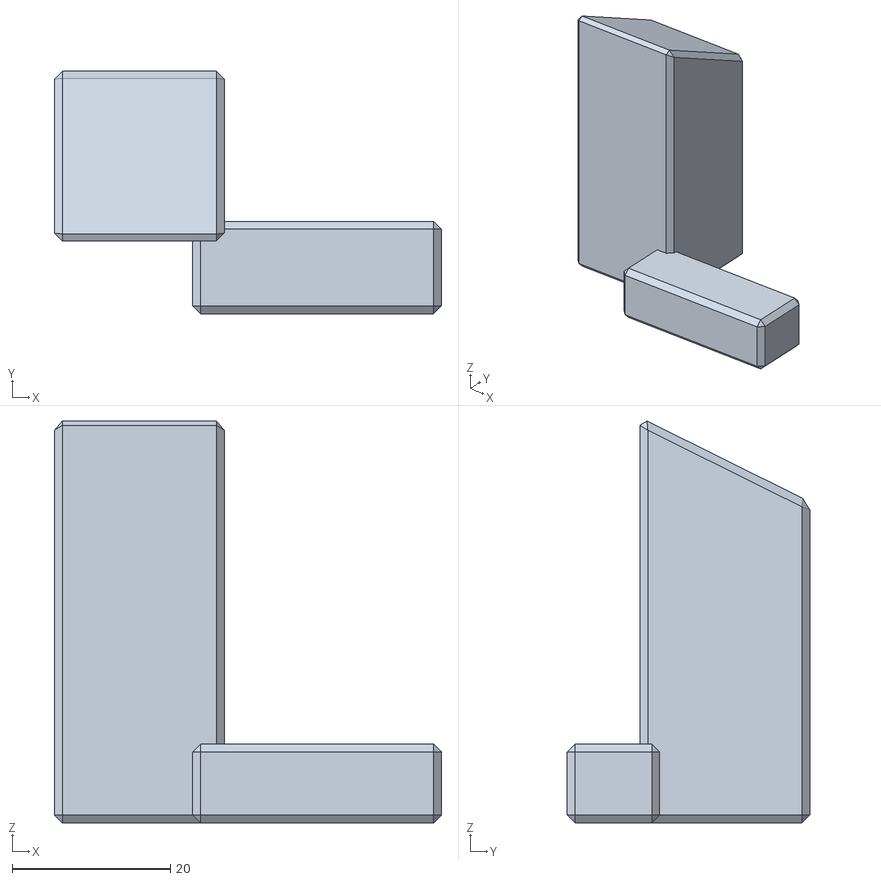
[picture p111: CAD file, 2026-11-02]
mm-launch-hw/v3/stl/tools/tilt45_prop.stl
49.0 x 30.7 x 50.9
