Every-Flavor-Robotics/mm-launcher/mm-launch-fw/web/model/flywheel.stl

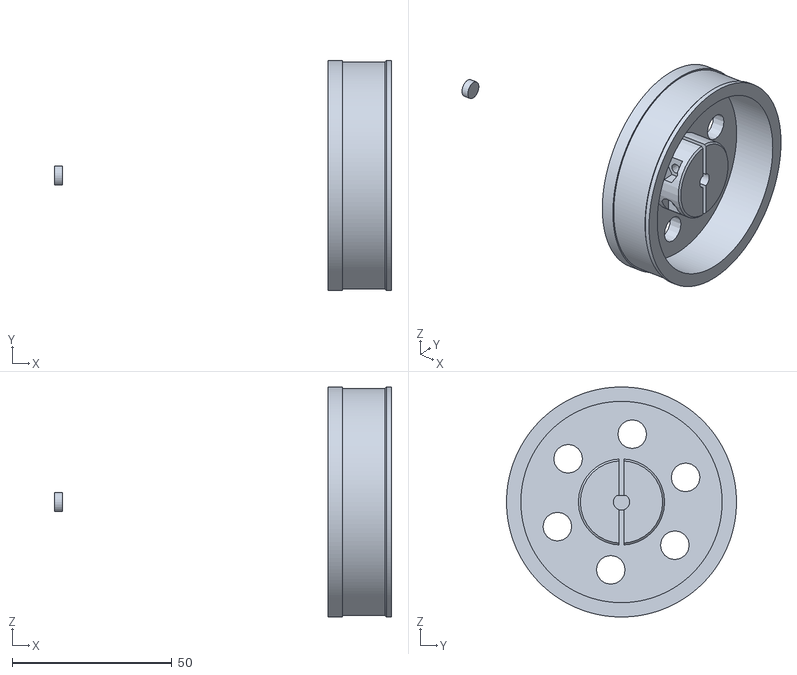
[picture p112: CAD file, 2026-11-02]
mm-launch-fw/web/model/flywheel.stl
105.5 x 72.0 x 72.0
