Every-Flavor-Robotics/mm-launcher/mm-launch-hw/reference/prior_plink_case_gooder.stl

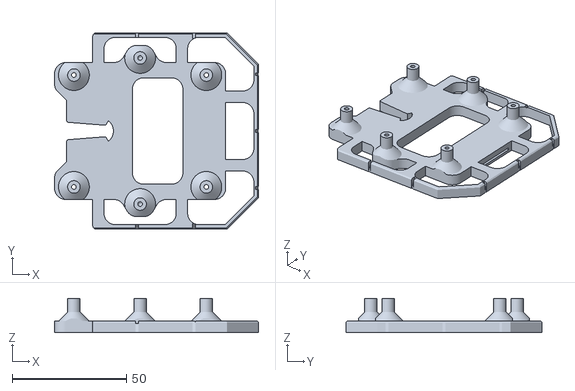
[picture p113: CAD file, 2026-11-02]
mm-launch-hw/reference/prior_plink_case_gooder.stl
89.3 x 86.0 x 15.0
