Every-Flavor-Robotics/mm-launcher/mm-launch-hw/stl/feeder_disc.stl

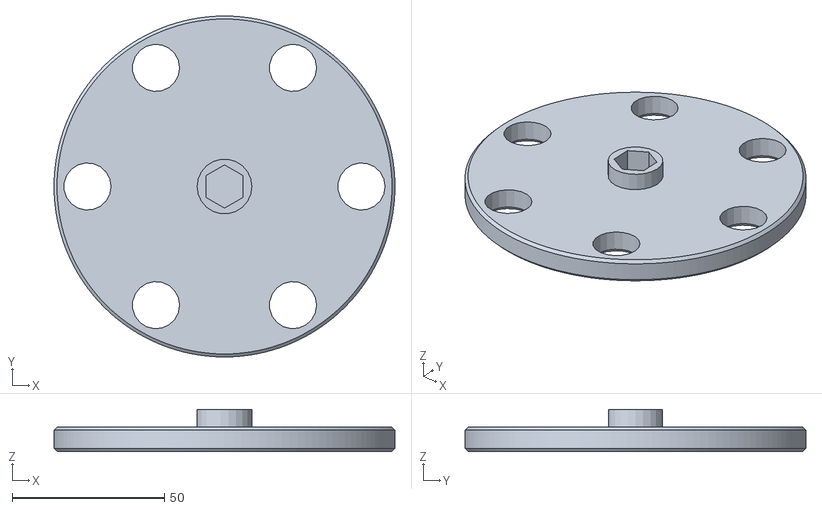
[picture p114: CAD file, 2026-11-02]
mm-launch-hw/stl/feeder_disc.stl
112.0 x 112.0 x 13.8
