Every-Flavor-Robotics/mm-launcher/mm-launch-hw/test-prints/launch-rig/stl/rig_cover.stl

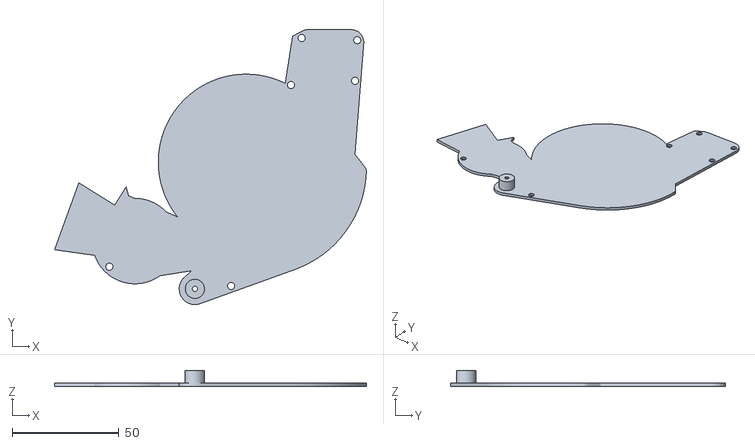
[picture p115: CAD file, 2026-11-02]
mm-launch-hw/test-prints/launch-rig/stl/rig_cover.stl
146.0 x 128.7 x 7.60
