Every-Flavor-Robotics/mm-launcher/mm-launch-hw/v3/BUILD/plates/0b-fit-jar-terracotta/jar_valve.stl

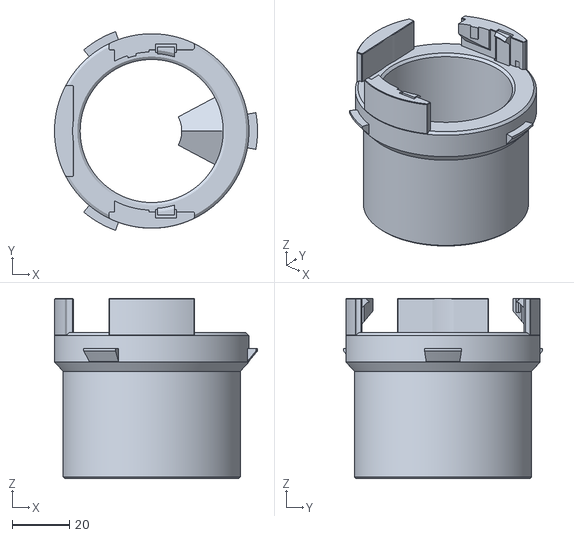
[picture p116: CAD file, 2026-11-02]
mm-launch-hw/v3/BUILD/plates/0b-fit-jar-terracotta/jar_valve.stl
71.0 x 69.5 x 63.1
