Every-Flavor-Robotics/mm-launcher/mm-launch-hw/v3/BUILD/plates/1-pod-grey/launcher_cover.stl

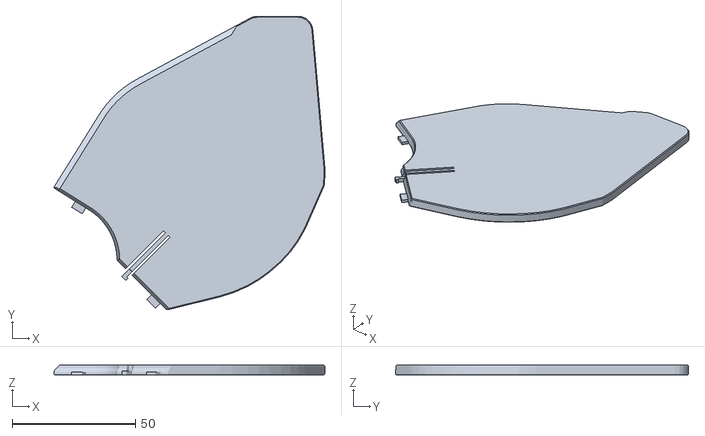
[picture p117: CAD file, 2026-11-02]
mm-launch-hw/v3/BUILD/plates/1-pod-grey/launcher_cover.stl
109.9 x 119.0 x 4.00
