Every-Flavor-Robotics/mm-launcher/mm-launch-hw/v3/BUILD/plates/2-pod-feeder-terracotta/flywheel.stl

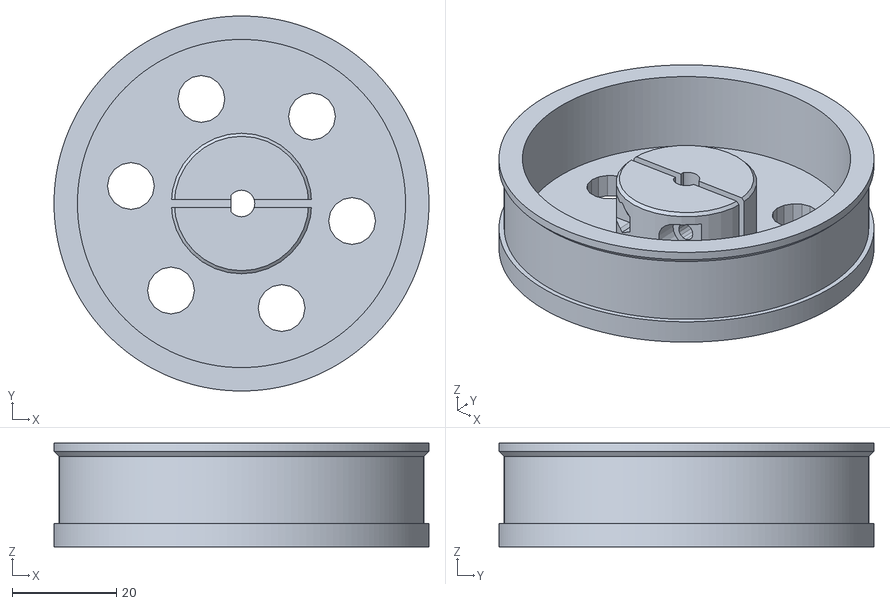
[picture p118: CAD file, 2026-11-02]
mm-launch-hw/v3/BUILD/plates/2-pod-feeder-terracotta/flywheel.stl
72.0 x 72.0 x 19.9
