Every-Flavor-Robotics/mm-launcher/mm-launch-hw/v3/BUILD/plates/3-beam-crown/thrust_ring.stl

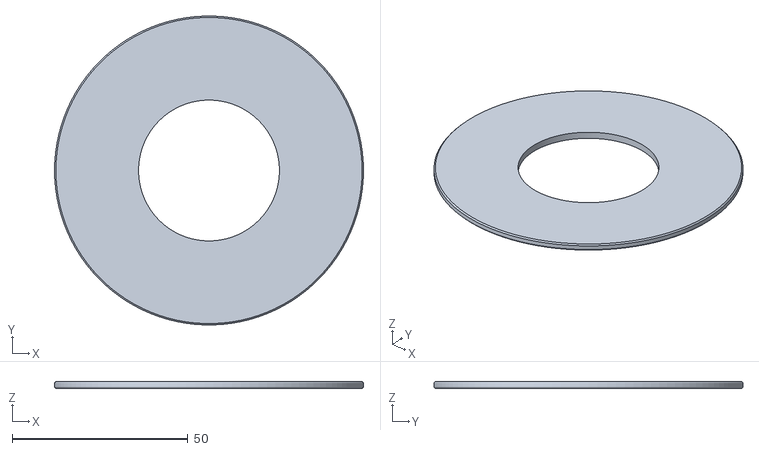
[picture p119: CAD file, 2026-11-02]
mm-launch-hw/v3/BUILD/plates/3-beam-crown/thrust_ring.stl
88.0 x 88.0 x 2.00
