Every-Flavor-Robotics/mm-launcher/mm-launch-hw/v3/BUILD/plates/5-base-shell/base_shell.stl

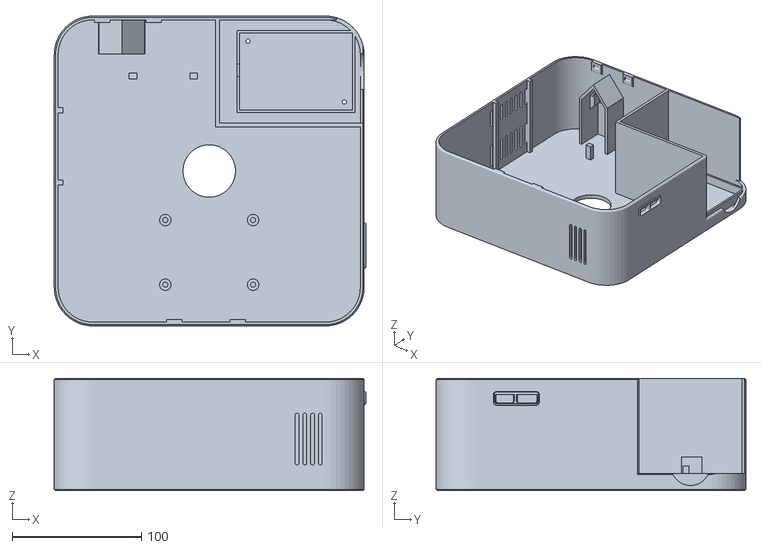
[picture p120: CAD file, 2026-11-02]
mm-launch-hw/v3/BUILD/plates/5-base-shell/base_shell.stl
241.2 x 240.0 x 87.0
