Every-Flavor-Robotics/mm-launcher/mm-launch-hw/v3/stl/jar_gate.3mf

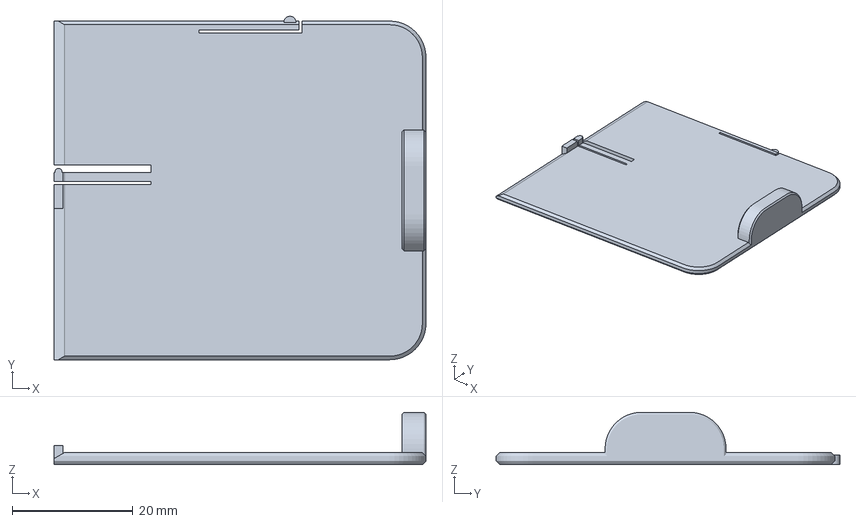
[picture p121: CAD file, 2026-11-02]
mm-launch-hw/v3/stl/jar_gate.3mf
61.5 x 56.8 x 8.65 mm
