Every-Flavor-Robotics/mm-launcher/mm-launch-fw/web/model/pan.stl

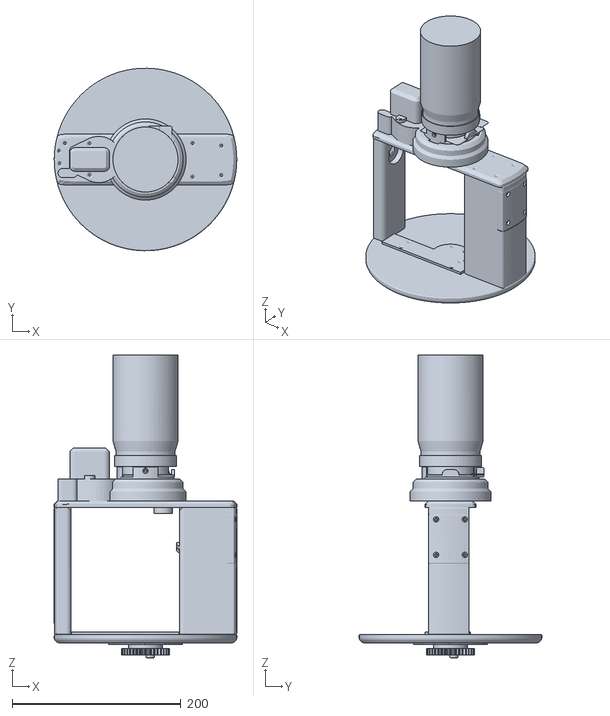
[picture p122: CAD file, 2026-11-02]
mm-launch-fw/web/model/pan.stl
216.0 x 216.0 x 358.6
