Every-Flavor-Robotics/mm-launcher/mm-launch-hw/reference/prior_plink_case_-_part_3.stl

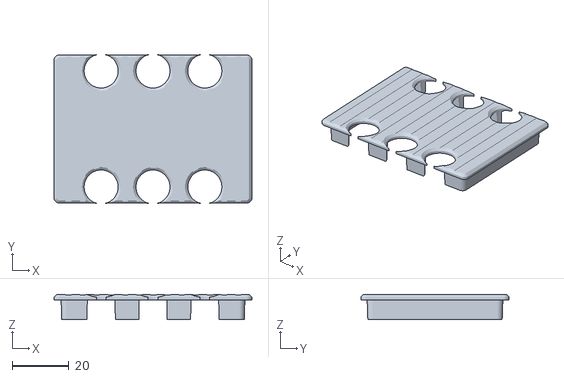
[picture p123: CAD file, 2026-11-02]
mm-launch-hw/reference/prior_plink_case_-_part_3.stl
70.0 x 52.5 x 9.00
