Every-Flavor-Robotics/mm-launcher/mm-launch-hw/stl/servo_pocket.stl

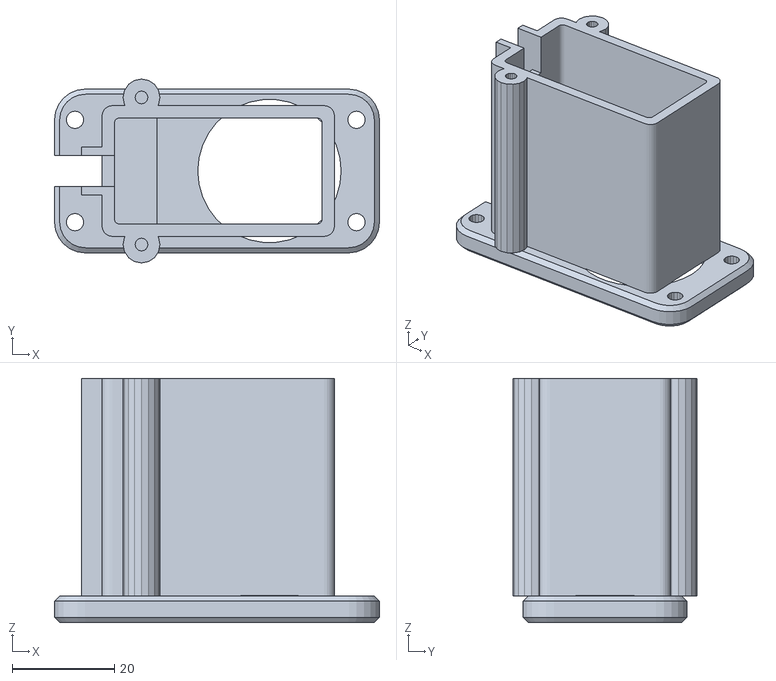
[picture p124: CAD file, 2026-11-02]
mm-launch-hw/stl/servo_pocket.stl
63.5 x 35.9 x 47.7
