Every-Flavor-Robotics/mm-launcher/mm-launch-hw/test-prints/launch-rig/stl/nip_wheel.stl

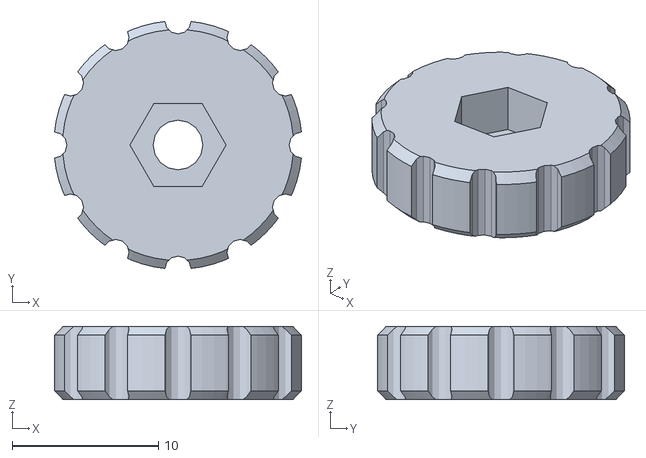
[picture p125: CAD file, 2026-11-02]
mm-launch-hw/test-prints/launch-rig/stl/nip_wheel.stl
16.9 x 16.9 x 5.00
