Every-Flavor-Robotics/mm-launcher/mm-launch-hw/v3/BUILD/plates/0a-fit-coupons-grey/c1_beam_hook_post.stl

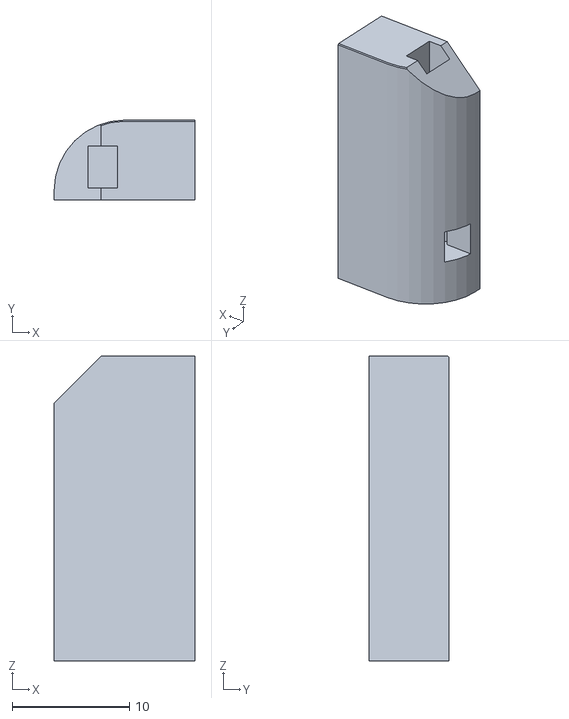
[picture p126: CAD file, 2026-11-02]
mm-launch-hw/v3/BUILD/plates/0a-fit-coupons-grey/c1_beam_hook_post.stl
12.0 x 6.80 x 26.0
