Every-Flavor-Robotics/mm-launcher/mm-launch-hw/v3/BUILD/plates/1-pod-grey/journal_plate.stl

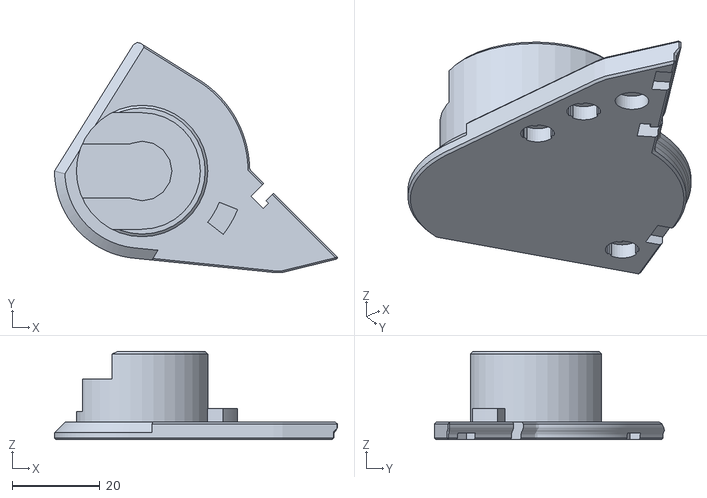
[picture p127: CAD file, 2026-11-02]
mm-launch-hw/v3/BUILD/plates/1-pod-grey/journal_plate.stl
64.6 x 52.5 x 20.2
