Every-Flavor-Robotics/mm-launcher/mm-launch-hw/v3/BUILD/plates/2-pod-feeder-terracotta/nip_wheel.stl

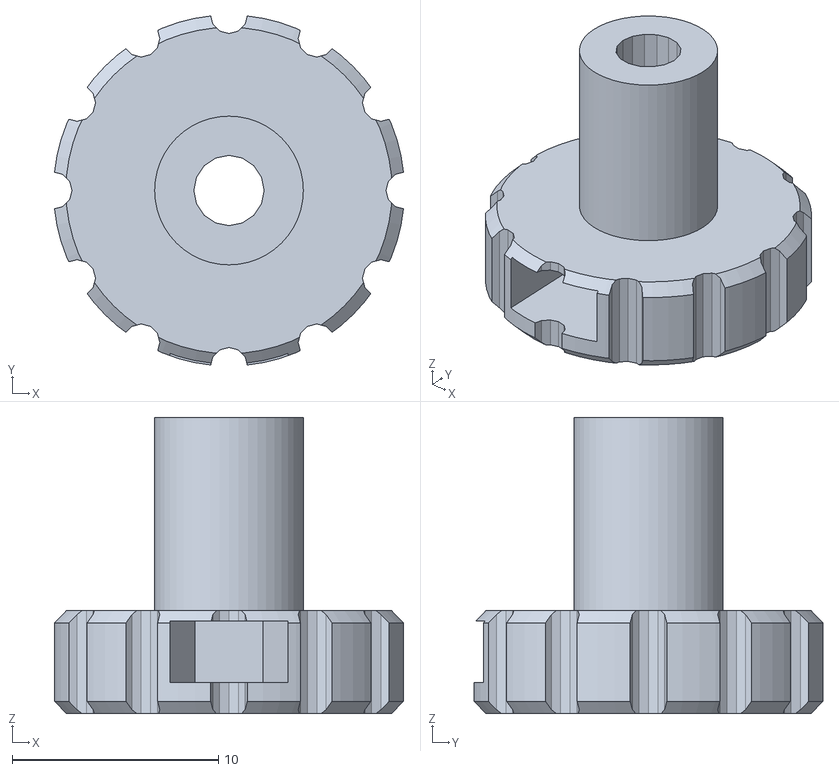
[picture p128: CAD file, 2026-11-02]
mm-launch-hw/v3/BUILD/plates/2-pod-feeder-terracotta/nip_wheel.stl
16.9 x 16.9 x 14.4
