Every-Flavor-Robotics/mm-launcher/mm-launch-hw/v3/BUILD/plates/3-beam-crown/beam.stl

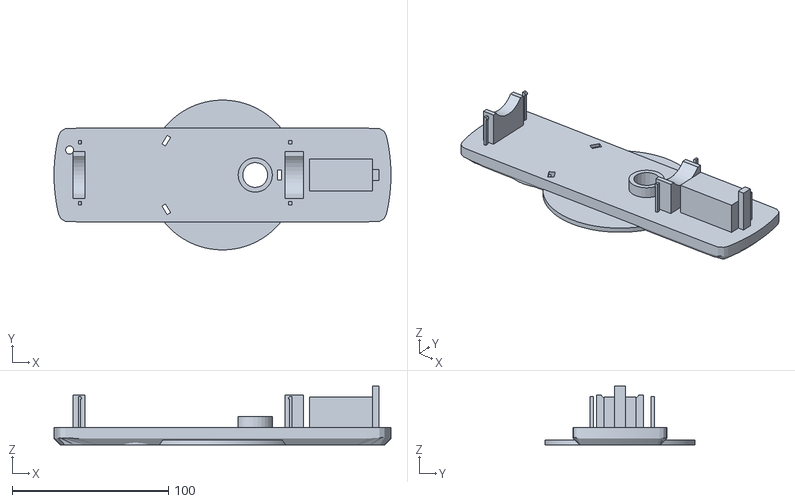
[picture p129: CAD file, 2026-11-02]
mm-launch-hw/v3/BUILD/plates/3-beam-crown/beam.stl
216.0 x 96.0 x 37.5
