Every-Flavor-Robotics/mm-launcher/mm-launch-hw/v3/BUILD/plates/5-base-shell/pan_pinion.stl

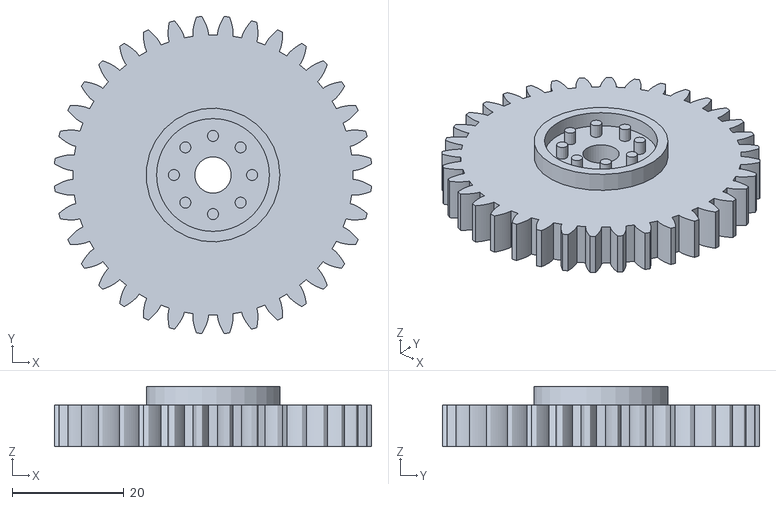
[picture p130: CAD file, 2026-11-02]
mm-launch-hw/v3/BUILD/plates/5-base-shell/pan_pinion.stl
56.9 x 56.9 x 10.8
