Every-Flavor-Robotics/mm-launcher/mm-launch-hw/v3/stl/encoder_cap.3mf

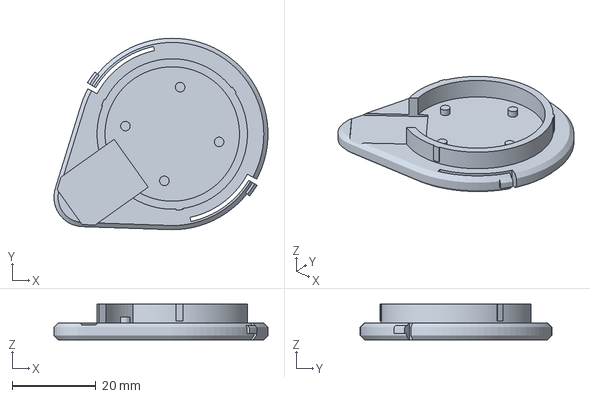
[picture p131: CAD file, 2026-11-02]
mm-launch-hw/v3/stl/encoder_cap.3mf
51.0 x 45.6 x 8.50 mm
