Every-Flavor-Robotics/mm-launcher/mm-launch-fw/web/model/feeder_pinion.stl

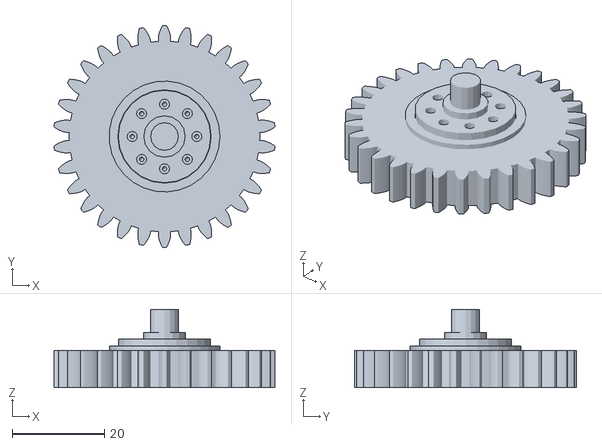
[picture p132: CAD file, 2026-11-02]
mm-launch-fw/web/model/feeder_pinion.stl
47.8 x 48.0 x 16.9
