Every-Flavor-Robotics/mm-launcher/mm-launch-hw/reference/plink_encoder.step

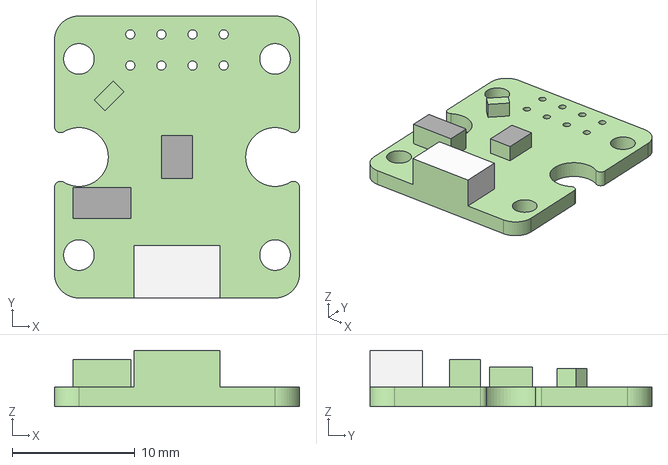
[picture p133: CAD file, 2026-11-02]
mm-launch-hw/reference/plink_encoder.step
20.0 x 23.0 x 4.60 mm
