Every-Flavor-Robotics/mm-launcher/mm-launch-hw/stl/pan_pinion.stl

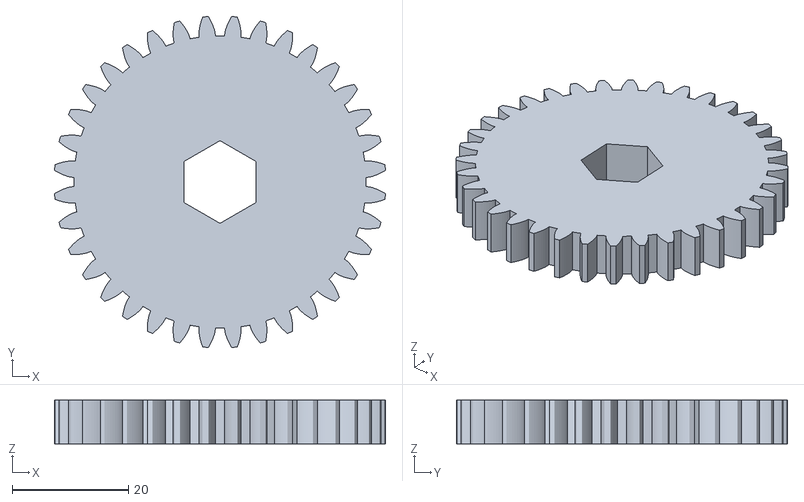
[picture p134: CAD file, 2026-11-02]
mm-launch-hw/stl/pan_pinion.stl
56.9 x 56.9 x 7.50
