Every-Flavor-Robotics/mm-launcher/mm-launch-hw/test-prints/launch-rig/stl/flywheel.stl

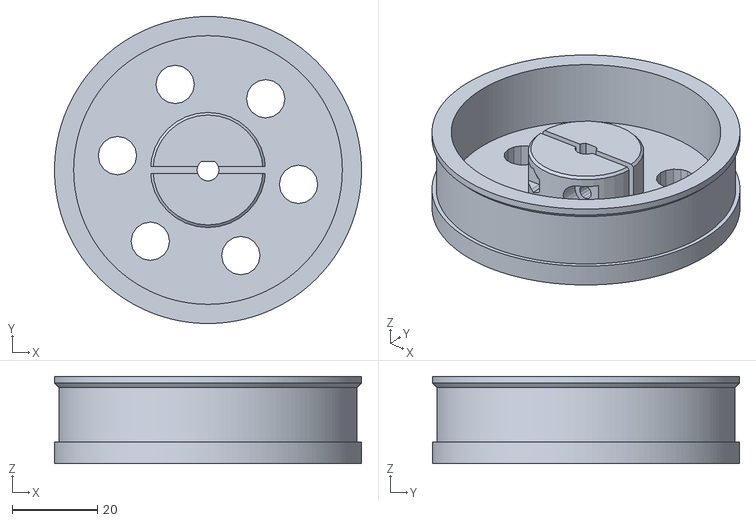
[picture p135: CAD file, 2026-11-02]
mm-launch-hw/test-prints/launch-rig/stl/flywheel.stl
72.0 x 72.0 x 20.5
