Every-Flavor-Robotics/mm-launcher/mm-launch-hw/v3/BUILD/plates/0a-fit-coupons-grey/c4_card_guides.stl

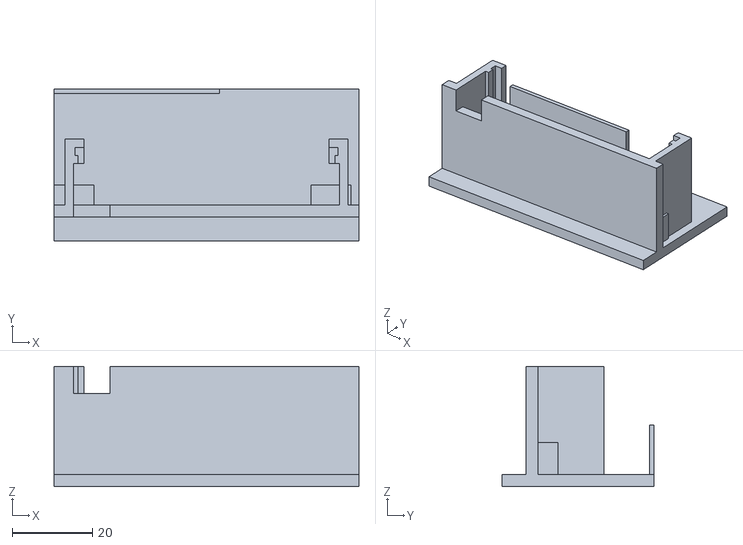
[picture p136: CAD file, 2026-11-02]
mm-launch-hw/v3/BUILD/plates/0a-fit-coupons-grey/c4_card_guides.stl
76.0 x 38.0 x 30.0
