Every-Flavor-Robotics/mm-launcher/mm-launch-hw/v3/BUILD/plates/0b-fit-jar-terracotta/test_pocket_coupon.stl

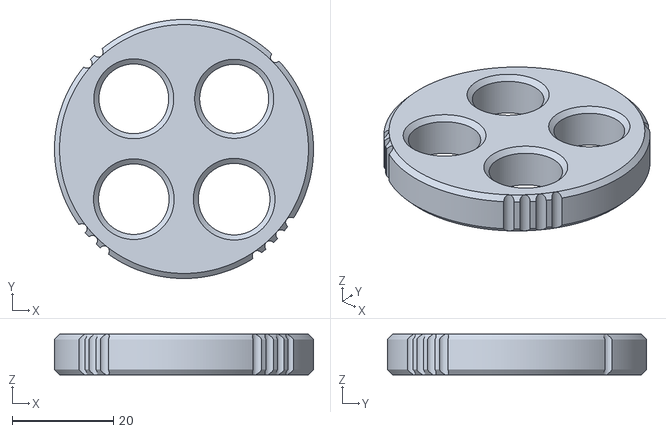
[picture p137: CAD file, 2026-11-02]
mm-launch-hw/v3/BUILD/plates/0b-fit-jar-terracotta/test_pocket_coupon.stl
51.1 x 51.1 x 8.00
