Every-Flavor-Robotics/mm-launcher/mm-launch-hw/v3/BUILD/plates/2-pod-feeder-terracotta/launcher_body.stl

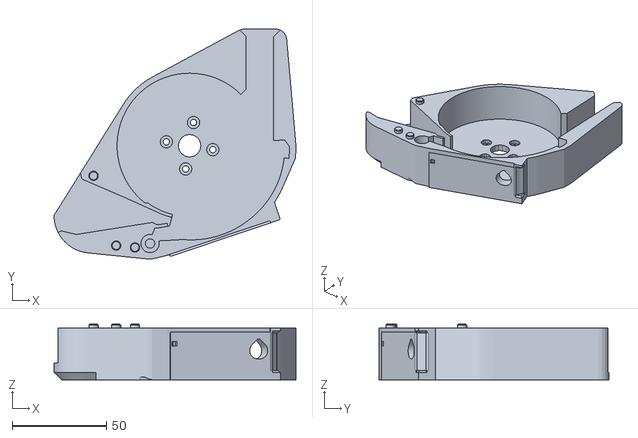
[picture p138: CAD file, 2026-11-02]
mm-launch-hw/v3/BUILD/plates/2-pod-feeder-terracotta/launcher_body.stl
128.5 x 122.2 x 29.6
