Every-Flavor-Robotics/mm-launcher/mm-launch-hw/v3/BUILD/plates/3-beam-crown/feeder_crown.stl

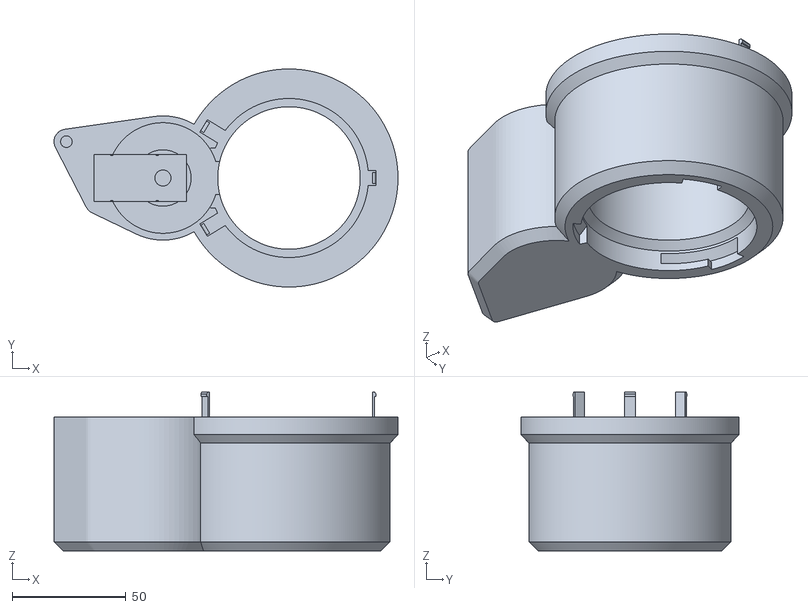
[picture p139: CAD file, 2026-11-02]
mm-launch-hw/v3/BUILD/plates/3-beam-crown/feeder_crown.stl
151.5 x 96.0 x 70.0
