Every-Flavor-Robotics/mm-launcher/mm-launch-hw/v3/BUILD/plates/5-base-shell/pan_servo_mount.stl

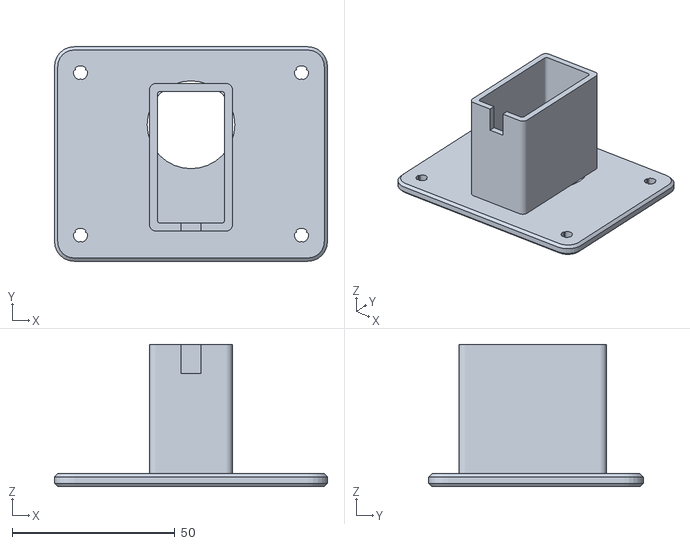
[picture p140: CAD file, 2026-11-02]
mm-launch-hw/v3/BUILD/plates/5-base-shell/pan_servo_mount.stl
84.0 x 66.0 x 43.7
