Every-Flavor-Robotics/mm-launcher/mm-launch-fw/web/model/tilt.stl

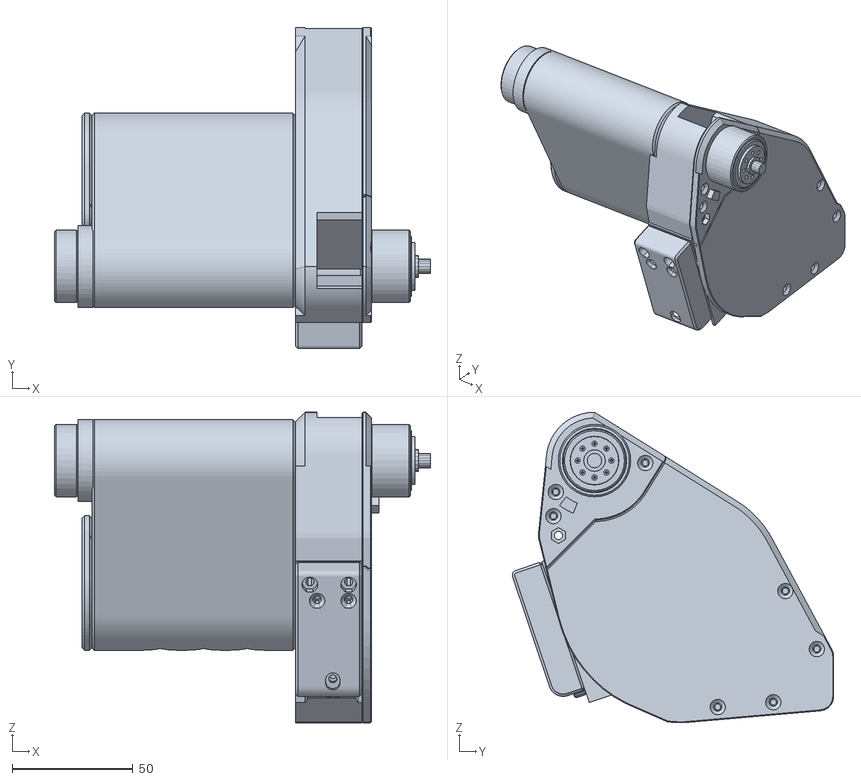
[picture p141: CAD file, 2026-11-02]
mm-launch-fw/web/model/tilt.stl
155.6 x 133.0 x 128.5
