Every-Flavor-Robotics/mm-launcher/mm-launch-hw/reference/mg_axis.step

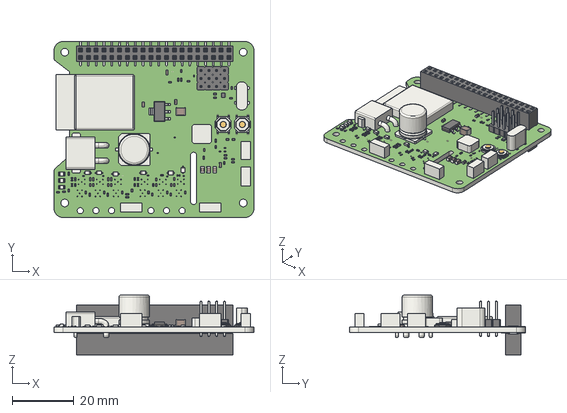
[picture p142: CAD file, 2026-11-02]
mm-launch-hw/reference/mg_axis.step
65.0 x 57.2 x 19.5 mm
