Every-Flavor-Robotics/mm-launcher/mm-launch-hw/stl/pan_hub.stl

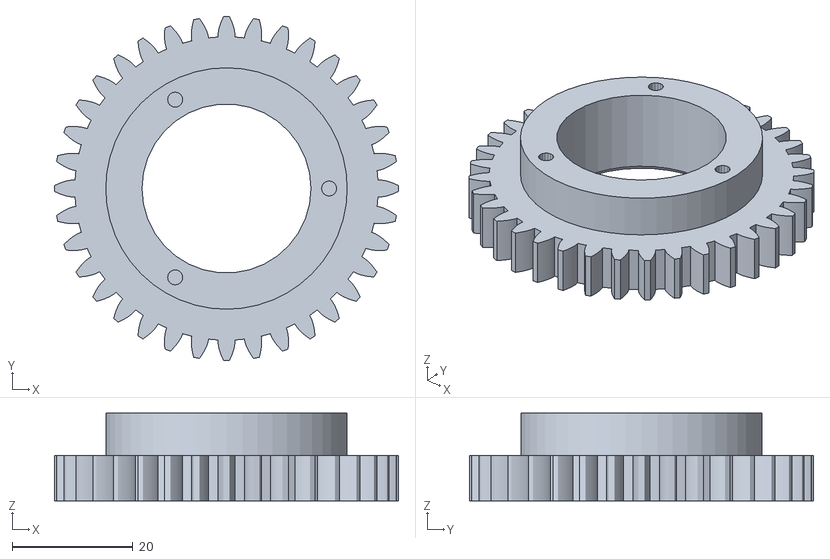
[picture p143: CAD file, 2026-11-02]
mm-launch-hw/stl/pan_hub.stl
57.0 x 57.0 x 14.5
