Every-Flavor-Robotics/mm-launcher/mm-launch-hw/test-prints/launch-rig/stl/rig_rear_cup.stl

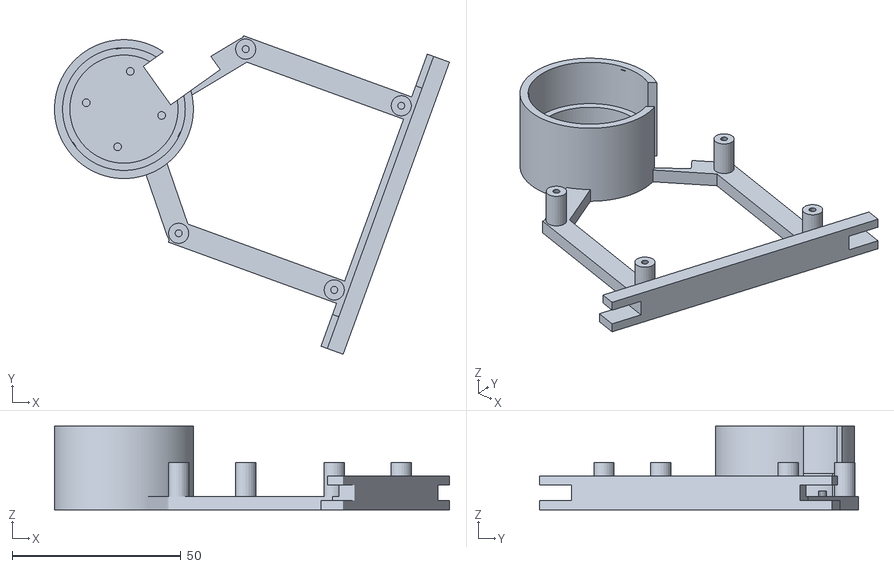
[picture p144: CAD file, 2026-11-02]
mm-launch-hw/test-prints/launch-rig/stl/rig_rear_cup.stl
116.9 x 94.3 x 24.8
