Every-Flavor-Robotics/mm-launcher/mm-launch-hw/v3/BUILD/plates/1-pod-grey/nip_cover.stl

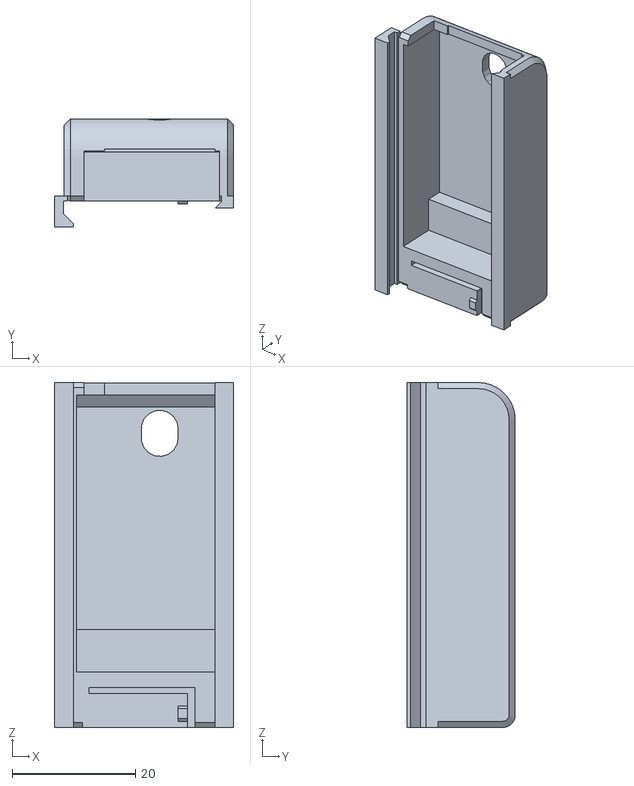
[picture p145: CAD file, 2026-11-02]
mm-launch-hw/v3/BUILD/plates/1-pod-grey/nip_cover.stl
29.1 x 17.6 x 56.0
