Every-Flavor-Robotics/mm-launcher/mm-launch-fw/web/model/base.stl

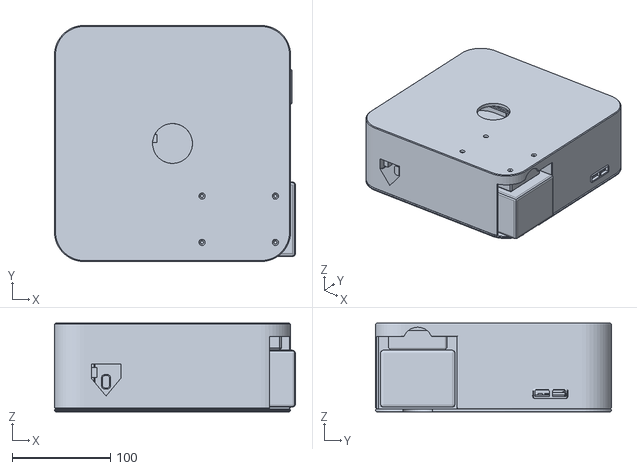
[picture p146: CAD file, 2026-11-02]
mm-launch-fw/web/model/base.stl
245.0 x 240.0 x 90.0
