Every-Flavor-Robotics/mm-launcher/mm-launch-hw/reference/prior_plinkholder.stl

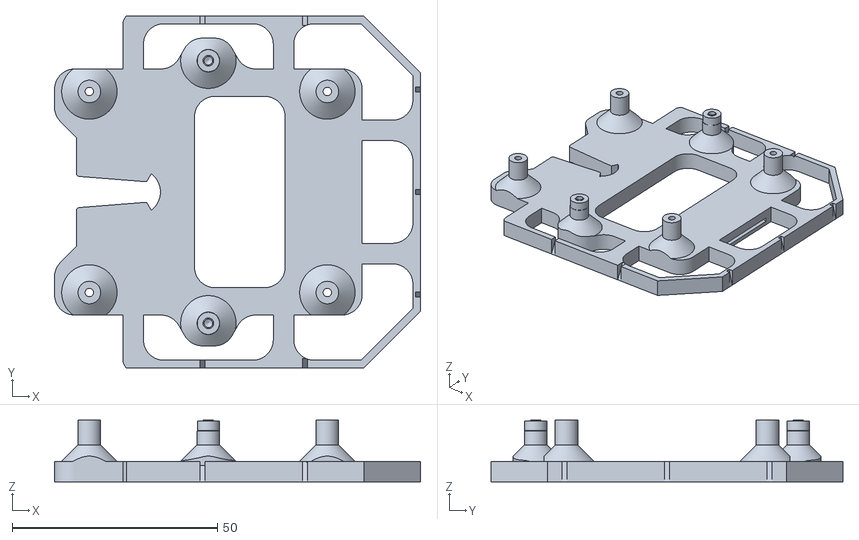
[picture p147: CAD file, 2026-11-02]
mm-launch-hw/reference/prior_plinkholder.stl
89.2 x 85.7 x 15.0
