Every-Flavor-Robotics/mm-launcher/mm-launch-hw/stl/launcher_cover.stl

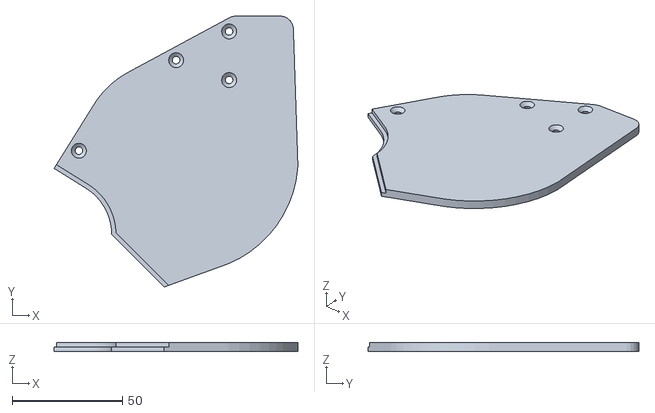
[picture p148: CAD file, 2026-11-02]
mm-launch-hw/stl/launcher_cover.stl
110.4 x 122.7 x 4.00
