Every-Flavor-Robotics/mm-launcher/mm-launch-hw/test-prints/launch-rig/stl/rig_guard.stl

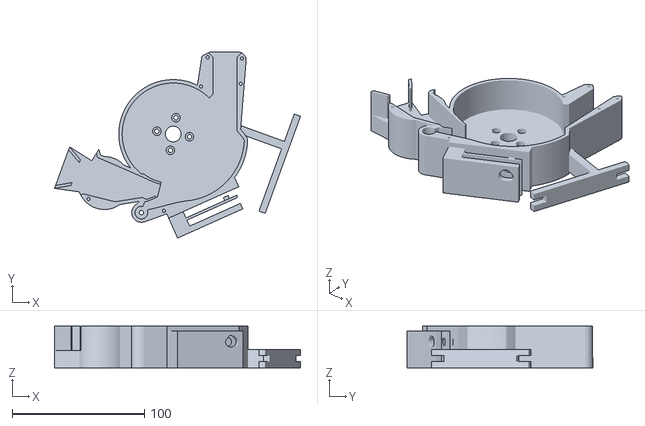
[picture p149: CAD file, 2026-11-02]
mm-launch-hw/test-prints/launch-rig/stl/rig_guard.stl
185.8 x 140.6 x 31.5
