Every-Flavor-Robotics/mm-launcher/mm-launch-hw/v3/BUILD/plates/0a-fit-coupons-grey/c1_beam_hook_beam.stl

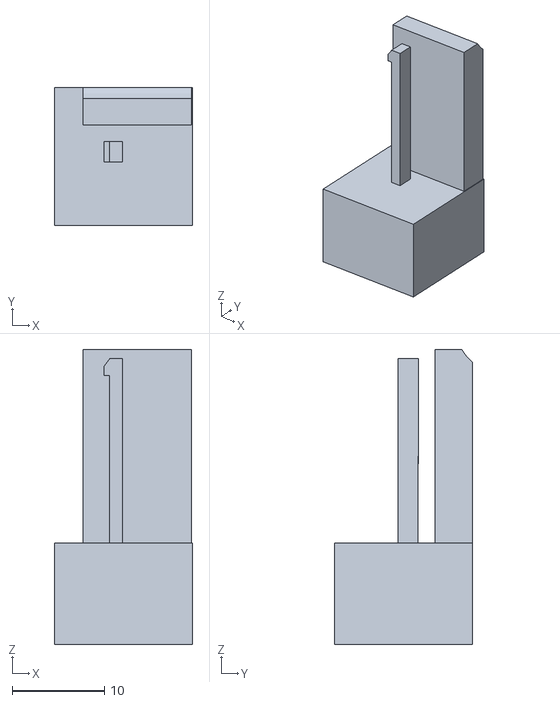
[picture p150: CAD file, 2026-11-02]
mm-launch-hw/v3/BUILD/plates/0a-fit-coupons-grey/c1_beam_hook_beam.stl
15.0 x 15.0 x 32.0
