Every-Flavor-Robotics/mm-launcher/mm-launch-hw/v3/BUILD/plates/1-pod-grey/nacelle.stl

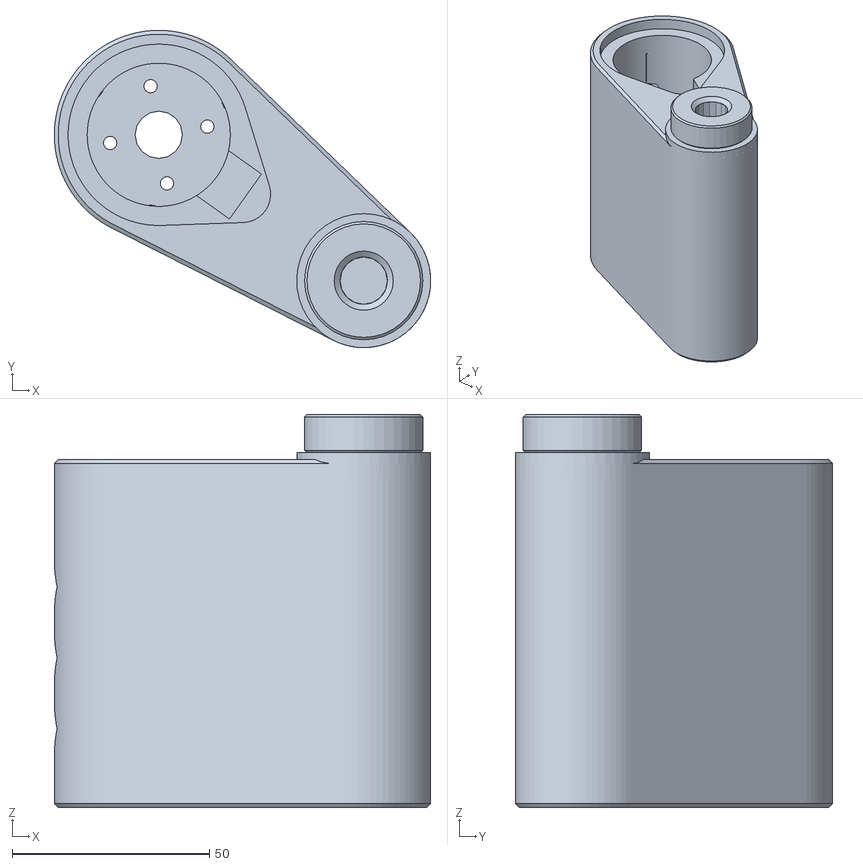
[picture p151: CAD file, 2026-11-02]
mm-launch-hw/v3/BUILD/plates/1-pod-grey/nacelle.stl
95.5 x 80.5 x 99.7
