Every-Flavor-Robotics/mm-launcher/mm-launch-fw/web/model/pan_pinion.stl

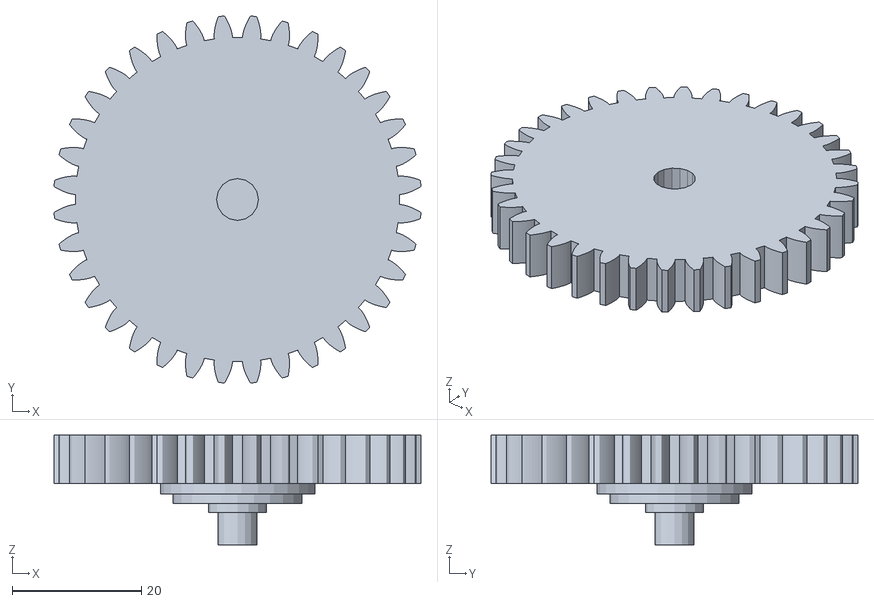
[picture p152: CAD file, 2026-11-02]
mm-launch-fw/web/model/pan_pinion.stl
56.9 x 56.9 x 17.0
