Every-Flavor-Robotics/mm-launcher/mm-launch-hw/v3/BUILD/plates/0a-fit-coupons-grey/c3_crown_hook_crown.stl

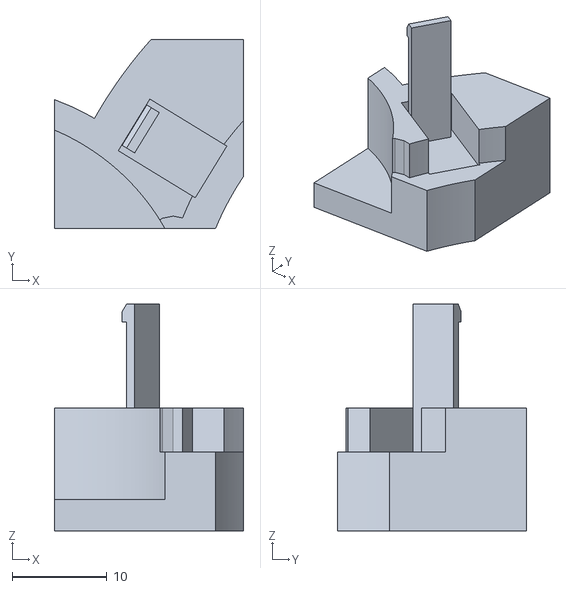
[picture p153: CAD file, 2026-11-02]
mm-launch-hw/v3/BUILD/plates/0a-fit-coupons-grey/c3_crown_hook_crown.stl
20.0 x 20.0 x 24.0
