Every-Flavor-Robotics/mm-launcher/mm-launch-hw/stl/nip_cover.stl

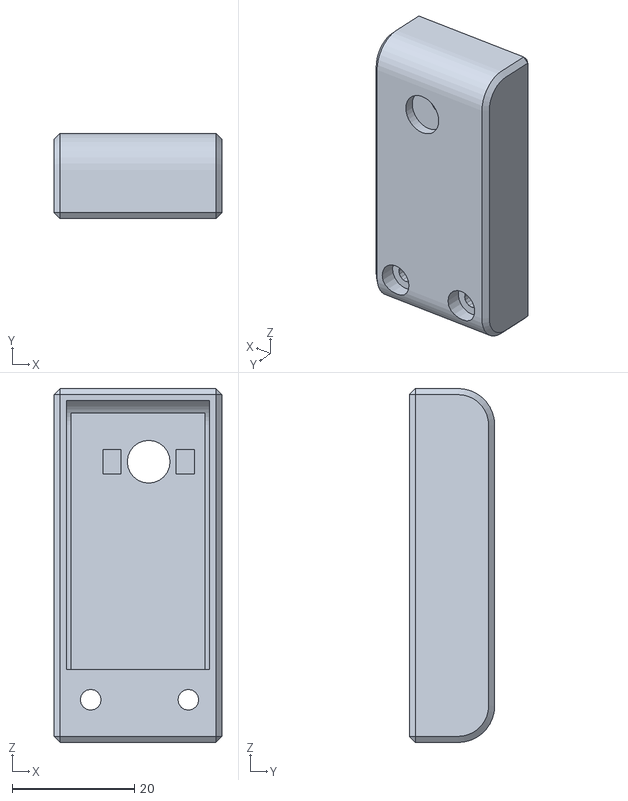
[picture p154: CAD file, 2026-11-02]
mm-launch-hw/stl/nip_cover.stl
27.5 x 14.0 x 58.0
