Every-Flavor-Robotics/mm-launcher/mm-launch-hw/v3/BUILD/plates/1-pod-grey/encoder_jig.stl

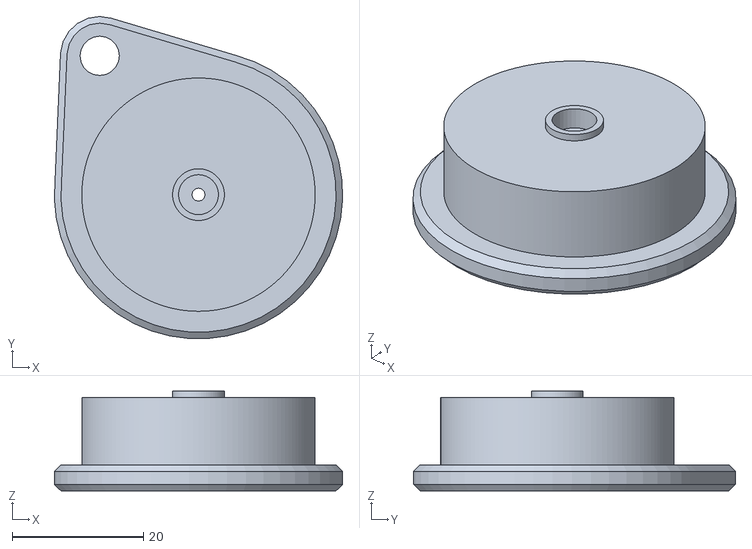
[picture p156: CAD file, 2026-11-02]
mm-launch-hw/v3/BUILD/plates/1-pod-grey/encoder_jig.stl
44.0 x 49.1 x 15.2
