Every-Flavor-Robotics/mm-launcher/mm-launch-hw/stl/journal_plate.stl

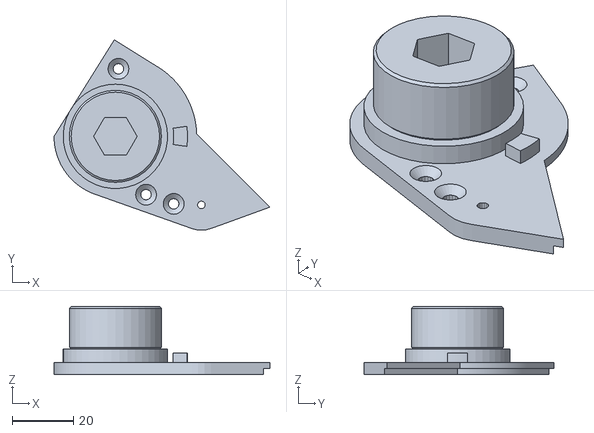
[picture p157: CAD file, 2026-11-02]
mm-launch-hw/stl/journal_plate.stl
70.4 x 62.0 x 22.2
