Every-Flavor-Robotics/mm-launcher/mm-launch-hw/stl/horn_adapter.stl

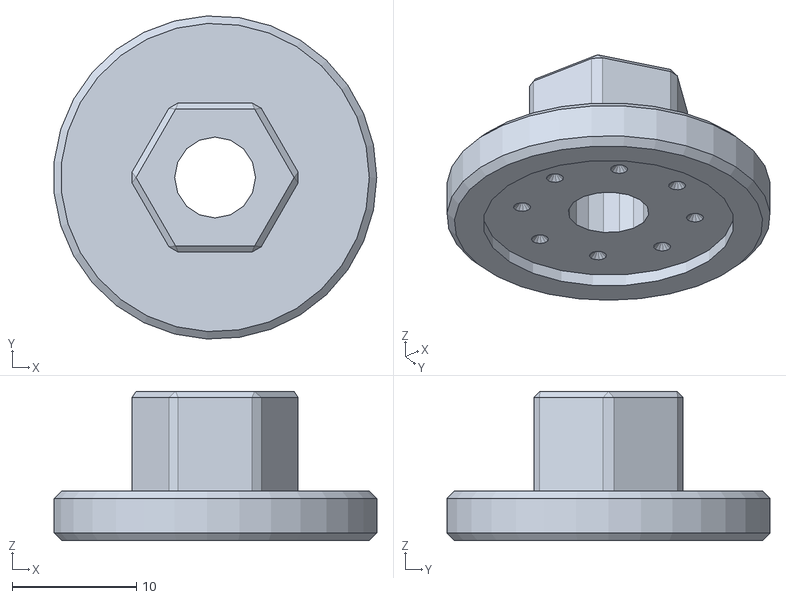
[picture p158: CAD file, 2026-11-02]
mm-launch-hw/stl/horn_adapter.stl
25.9 x 26.0 x 12.0
