Every-Flavor-Robotics/mm-launcher/mm-launch-hw/stl/yoke_arm_r.stl

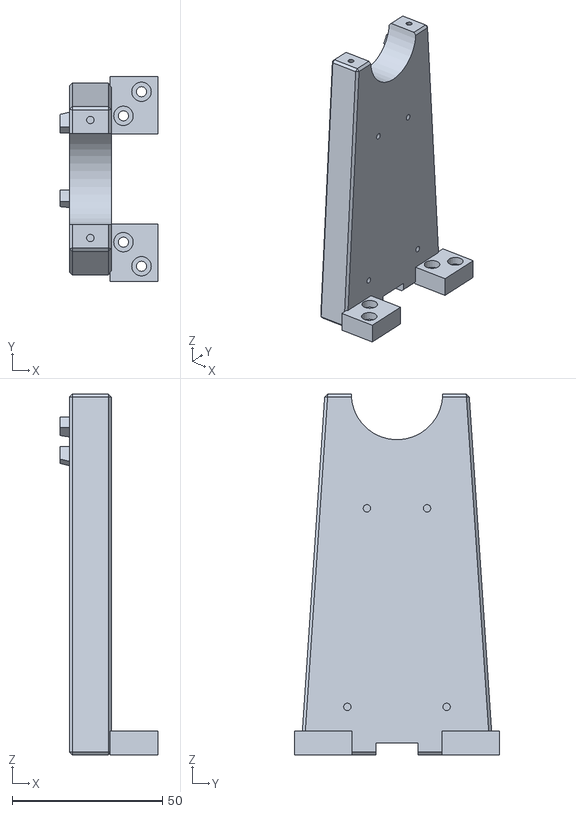
[picture p159: CAD file, 2026-11-02]
mm-launch-hw/stl/yoke_arm_r.stl
32.6 x 68.0 x 120.0
