Every-Flavor-Robotics/mm-launcher/mm-launch-hw/stl/arm_cover_r.stl

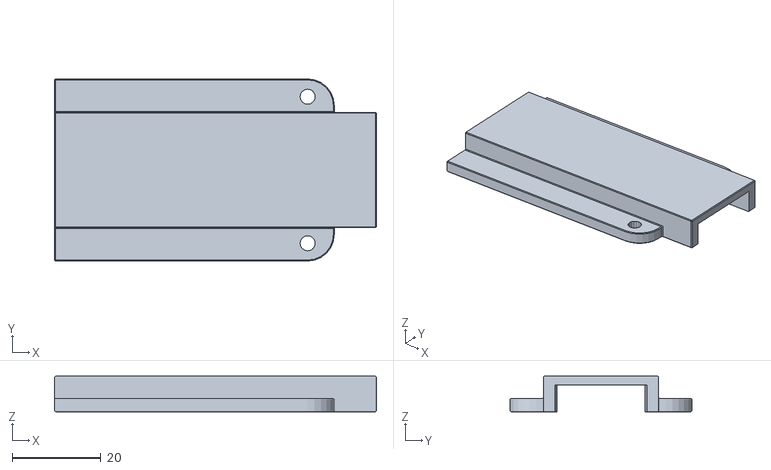
[picture p160: CAD file, 2026-11-02]
mm-launch-hw/stl/arm_cover_r.stl
72.5 x 41.0 x 8.00
