Every-Flavor-Robotics/mm-launcher/mm-launch-hw/stl/base_floor.stl

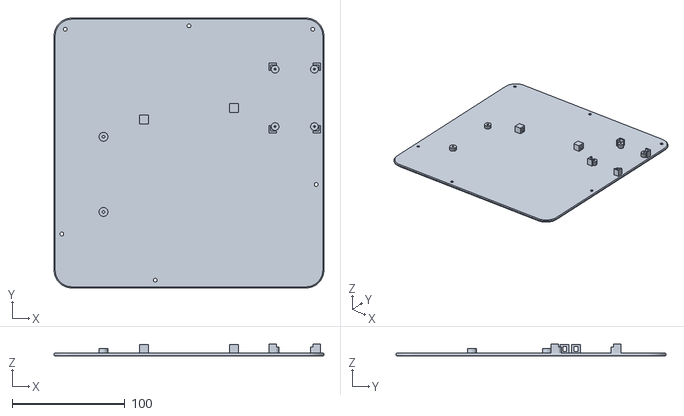
[picture p161: CAD file, 2026-11-02]
mm-launch-hw/stl/base_floor.stl
240.0 x 240.0 x 11.0
