Every-Flavor-Robotics/mm-launcher/mm-launch-hw/stl/tilt_servo_cover.stl

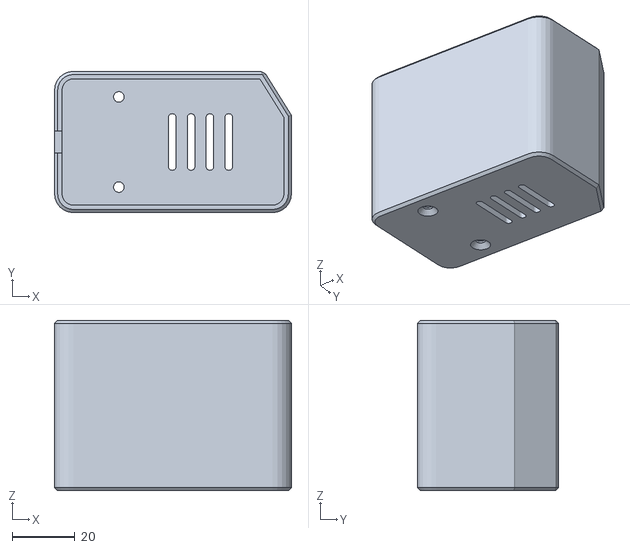
[picture p162: CAD file, 2026-11-02]
mm-launch-hw/stl/tilt_servo_cover.stl
75.5 x 45.0 x 54.3
