Every-Flavor-Robotics/mm-launcher/mm-launch-hw/stl/base_shell.stl

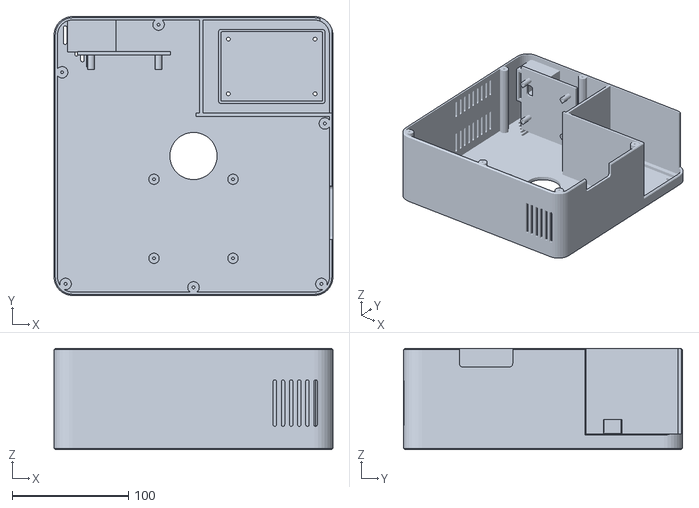
[picture p163: CAD file, 2026-11-02]
mm-launch-hw/stl/base_shell.stl
240.0 x 240.0 x 87.0
