Every-Flavor-Robotics/mm-launcher/mm-launch-hw/stl/feeder_shroud.stl

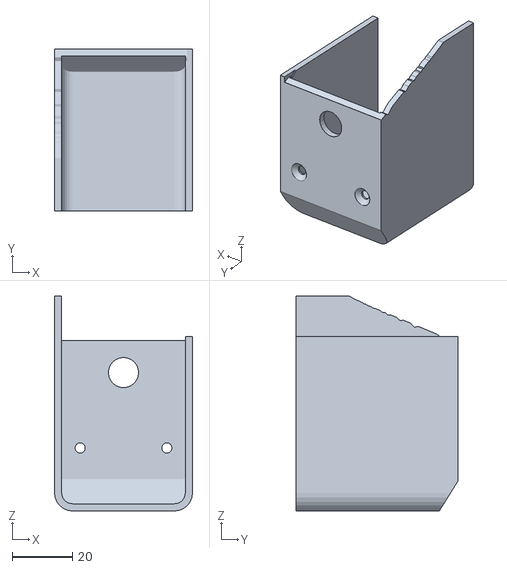
[picture p164: CAD file, 2026-11-02]
mm-launch-hw/stl/feeder_shroud.stl
45.8 x 53.8 x 71.3
