Every-Flavor-Robotics/mm-launcher/mm-launch-hw/stl/arm_cover_l.stl

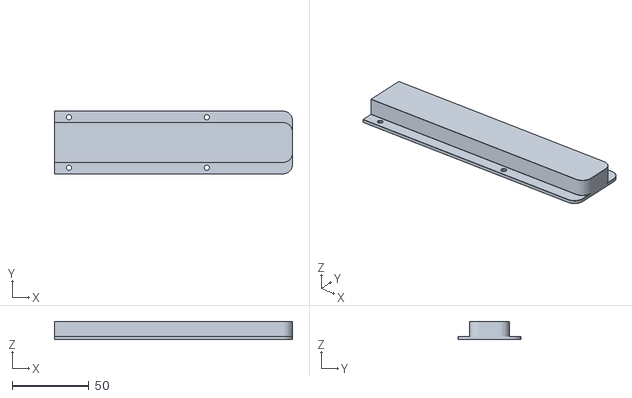
[picture p166: CAD file, 2026-11-02]
mm-launch-hw/stl/arm_cover_l.stl
155.5 x 41.0 x 12.0
