Every-Flavor-Robotics/mm-launcher/mm-launch-hw/stl/hopper.stl

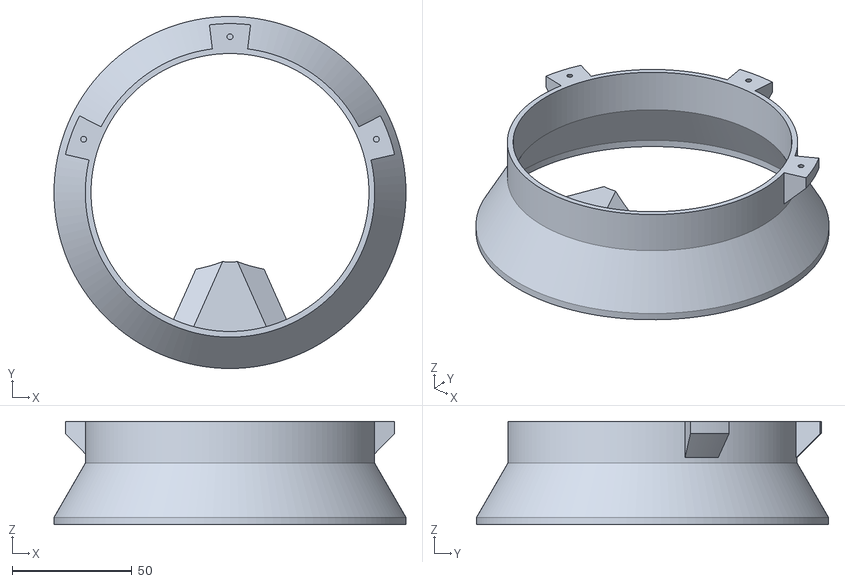
[picture p167: CAD file, 2026-11-02]
mm-launch-hw/stl/hopper.stl
146.9 x 146.9 x 43.0
