Every-Flavor-Robotics/mm-launcher/mm-launch-hw/stl/hopper_lid.stl

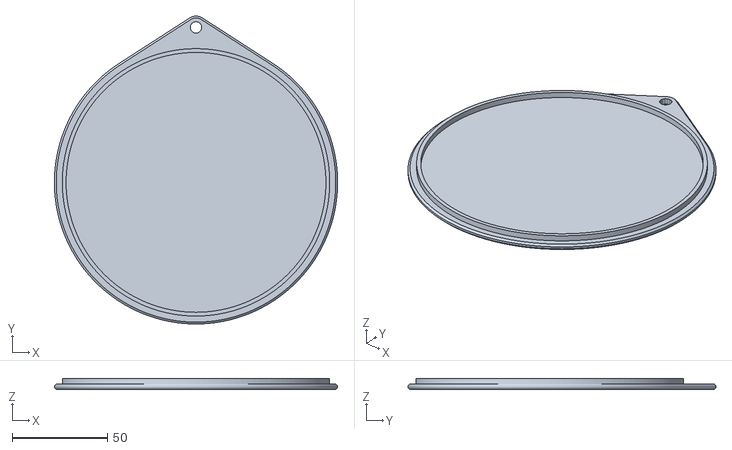
[picture p168: CAD file, 2026-11-02]
mm-launch-hw/stl/hopper_lid.stl
148.9 x 161.9 x 5.80
