Every-Flavor-Robotics/mm-launcher/mm-launch-hw/stl/turntable_spine.stl

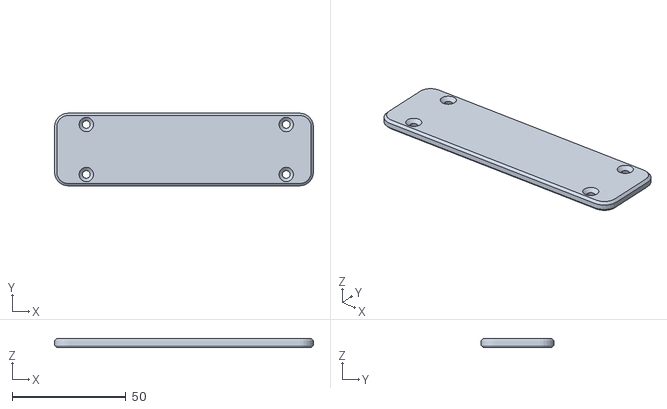
[picture p169: CAD file, 2026-11-02]
mm-launch-hw/stl/turntable_spine.stl
114.0 x 32.0 x 4.00
