Every-Flavor-Robotics/mm-launcher/mm-launch-hw/stl/yoke_arm_l.stl

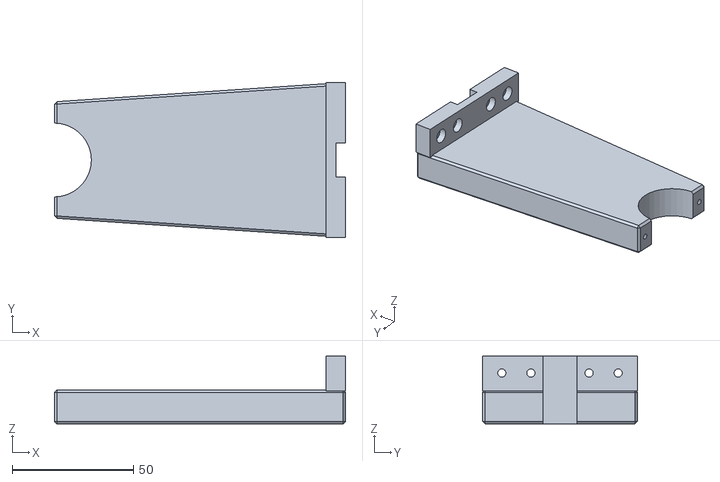
[picture p170: CAD file, 2026-11-02]
mm-launch-hw/stl/yoke_arm_l.stl
120.0 x 64.0 x 28.0
