Every-Flavor-Robotics/mm-launcher/mm-launch-hw/stl/turntable.stl

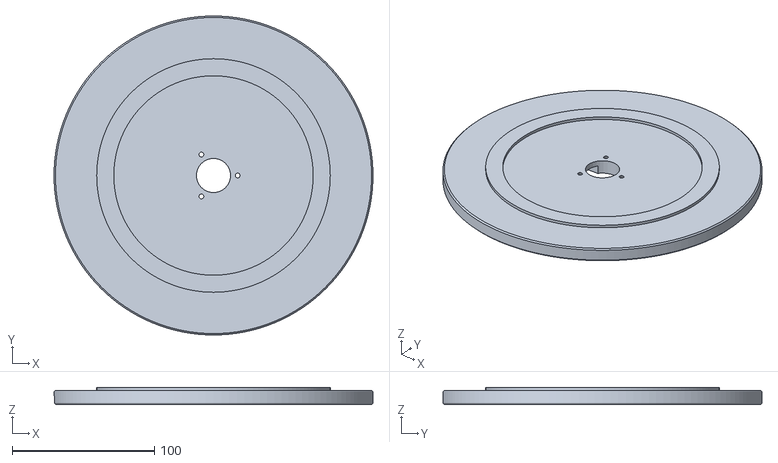
[picture p171: CAD file, 2026-11-02]
mm-launch-hw/stl/turntable.stl
224.0 x 224.0 x 12.0
