Every-Flavor-Robotics/mm-launcher/mm-launch-hw/stl/nacelle.stl

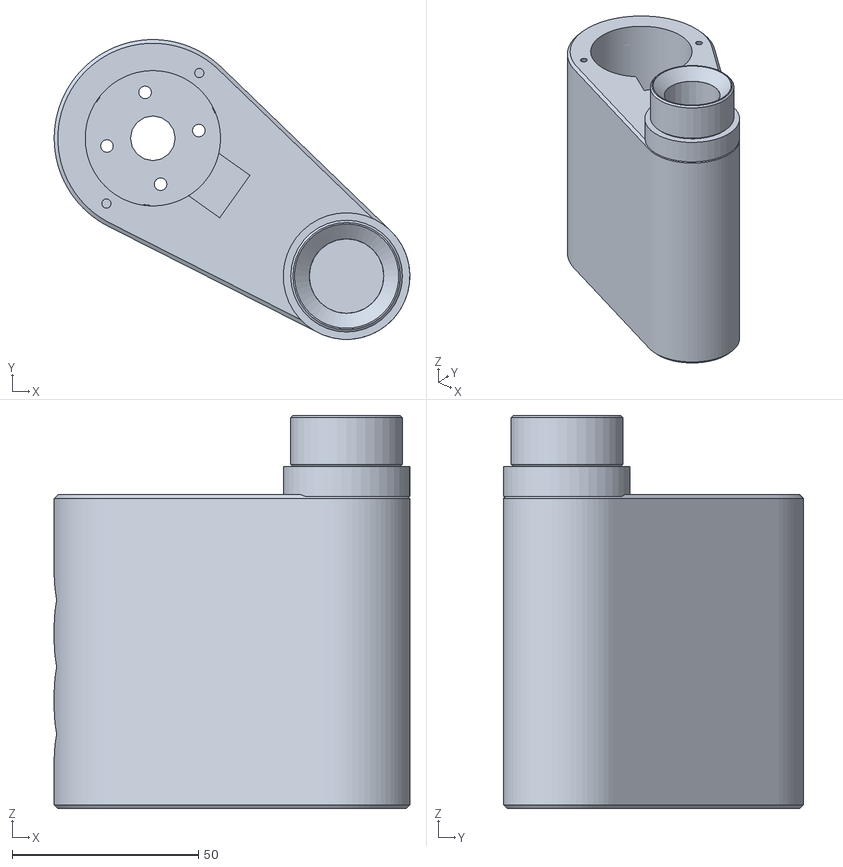
[picture p172: CAD file, 2026-11-02]
mm-launch-hw/stl/nacelle.stl
95.5 x 80.5 x 105.5
