Every-Flavor-Robotics/mm-launcher/mm-launch-hw/stl/arm_cap_l.stl

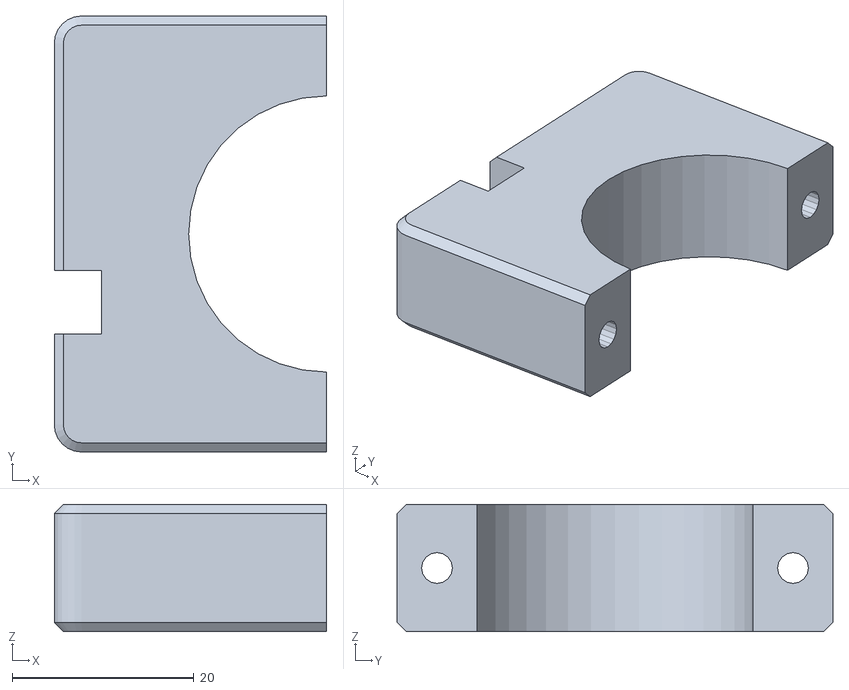
[picture p173: CAD file, 2026-11-02]
mm-launch-hw/stl/arm_cap_l.stl
30.0 x 48.0 x 14.0
