Every-Flavor-Robotics/mm-launcher/mm-launch-hw/stl/feeder_plate.stl

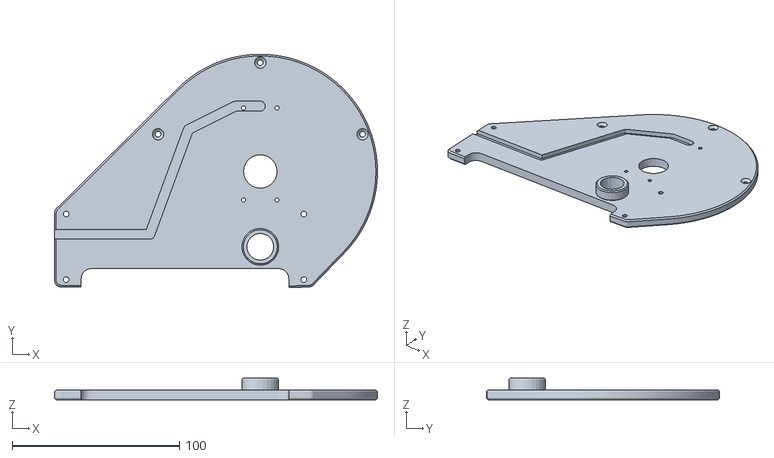
[picture p174: CAD file, 2026-11-02]
mm-launch-hw/stl/feeder_plate.stl
193.0 x 139.4 x 13.0
