Every-Flavor-Robotics/mm-launcher/mm-launch-hw/stl/servo_clamp.stl

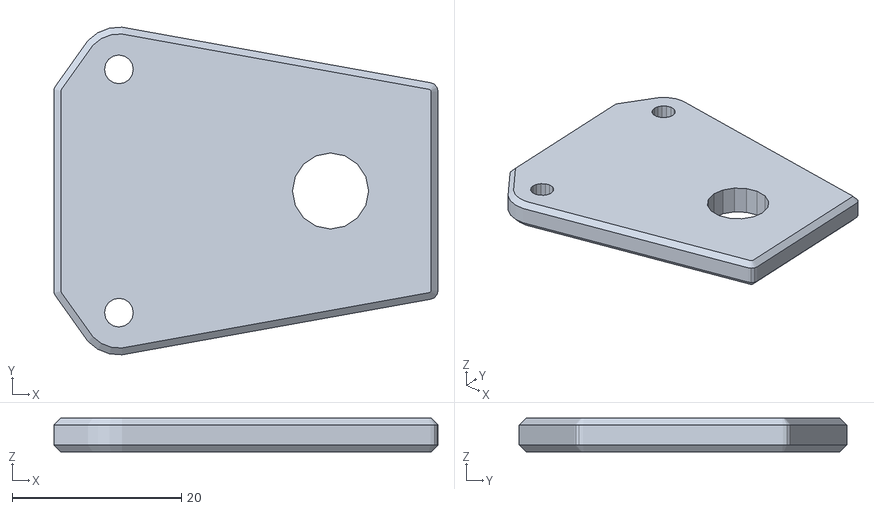
[picture p175: CAD file, 2026-11-02]
mm-launch-hw/stl/servo_clamp.stl
45.4 x 38.7 x 4.00
