Every-Flavor-Robotics/mm-launcher/mm-launch-hw/stl/encoder_cap.stl

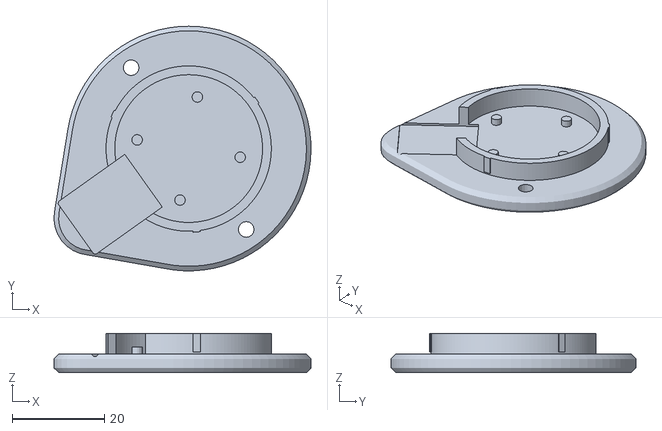
[picture p176: CAD file, 2026-11-02]
mm-launch-hw/stl/encoder_cap.stl
55.7 x 53.0 x 8.50
