Every-Flavor-Robotics/mm-launcher/mm-launch-hw/stl/encoder_jig.stl

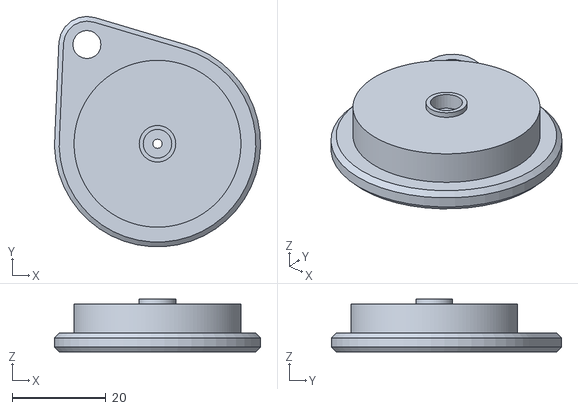
[picture p177: CAD file, 2026-11-02]
mm-launch-hw/stl/encoder_jig.stl
44.0 x 49.1 x 11.2
