Every-Flavor-Robotics/mm-launcher/mm-launch-hw/stl/servo_pocket_pan.stl

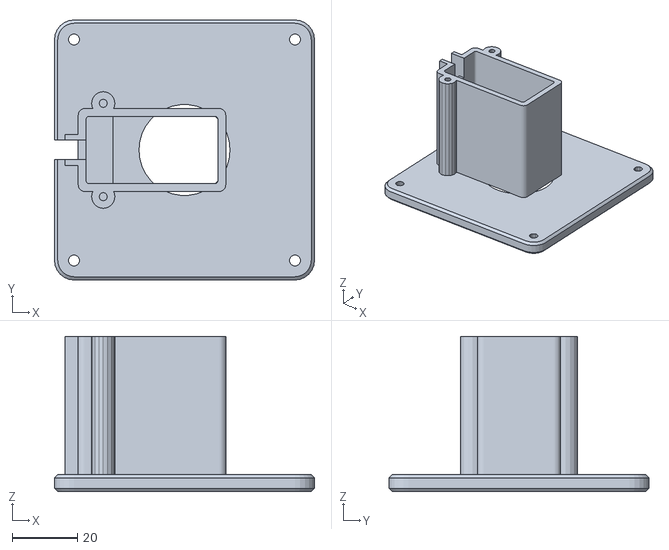
[picture p178: CAD file, 2026-11-02]
mm-launch-hw/stl/servo_pocket_pan.stl
80.0 x 80.0 x 47.7
