Every-Flavor-Robotics/mm-launcher/(list of files, cad)

Other CAD files:
mm-launch-hw/v3/BUILD/plates/0b-fit-jar-terracotta/jar_gate.stl
mm-launch-hw/v3/stl/pan_pinion.3mf
mm-launch-hw/v3/BUILD/plates/0a-fit-coupons-grey/tilt_horn_adapter.stl
mm-launch-hw/v3/BUILD/plates/2-pod-feeder-terracotta/feeder_disc.stl
mm-launch-hw/v3/stl/nip_cover.3mf
mm-launch-hw/v3/stl/beam.3mf
mm-launch-hw/stl/nip_wheel.stl
mm-launch-hw/v3/BUILD/plates/1-pod-grey/encoder_cap.stl
mm-launch-hw/v3/stl/feeder_crown.3mf
mm-launch-hw/v3/stl/jar_valve.3mf
mm-launch-hw/v3/stl/feeder_pinion.3mf
mm-launch-hw/v3/stl/journal_plate.3mf
mm-launch-hw/v3/stl/hub_gear.3mf
mm-launch-hw/v3/stl/hood.3mf
mm-launch-hw/v3/stl/thrust_ring.3mf
mm-launch-hw/v3/stl/launcher_body.3mf
mm-launch-hw/v3/stl/base_floor.3mf
mm-launch-hw/v3/stl/nip_wheel.3mf
mm-launch-hw/v3/stl/flywheel.3mf
mm-launch-hw/v3/stl/nip_leaf.3mf
mm-launch-hw/v3/stl/pan_servo_mount.3mf
mm-launch-hw/v3/stl/jar_adapter.3mf
mm-launch-hw/stl/flywheel.stl
mm-launch-hw/v3/stl/turntable.3mf
mm-launch-hw/v3/stl/launcher_cover.3mf
mm-launch-hw/v3/stl/nacelle.3mf
mm-launch-hw/v3/stl/base_shell.3mf
mm-launch-hw/v3/stl/feeder_disc.3mf
mm-launch-hw/stl/hood.stl
mm-launch-hw/blender/mm_launcher.blend
mm-launch-hw/reference/mg_axis.stl
mm-launch-hw/reference/plink_encoder.stl
mm-launch-hw/test-prints/launch-rig/launch_rig.blend
mm-launch-hw/v2/BUILD/plates/1-pod-grey/encoder_cap.stl
mm-launch-hw/v2/BUILD/plates/1-pod-grey/encoder_jig.stl
mm-launch-hw/v2/BUILD/plates/1-pod-grey/journal_plate.stl
mm-launch-hw/v2/BUILD/plates/1-pod-grey/launcher_cover.stl
mm-launch-hw/v2/BUILD/plates/1-pod-grey/nacelle.3mf
mm-launch-hw/v2/BUILD/plates/1-pod-grey/nacelle.stl
mm-launch-hw/v2/BUILD/plates/1-pod-grey/nip_cover.stl
mm-launch-hw/v2/BUILD/plates/1-pod-grey/nip_leaf.stl
mm-launch-hw/v2/BUILD/plates/1-pod-grey/nip_leaf_spare.stl
mm-launch-hw/v2/BUILD/plates/1-pod-grey/nip_stop.stl
mm-launch-hw/v2/BUILD/plates/1-pod-grey/nip_stop_sleeve.stl
mm-launch-hw/v2/BUILD/plates/2-pod-terracotta/hood.stl
mm-launch-hw/v2/BUILD/plates/2-pod-terracotta/launcher_body.stl
mm-launch-hw/v2/BUILD/plates/2-pod-terracotta/nip_wheel.stl
mm-launch-hw/v2/BUILD/plates/3-feeder-jar-terracotta/feeder_housing.stl
mm-launch-hw/v2/BUILD/plates/3-feeder-jar-terracotta/jar_adapter.stl
mm-launch-hw/v2/BUILD/plates/3-feeder-jar-terracotta/jar_gate.stl
mm-launch-hw/v2/BUILD/plates/3-feeder-jar-terracotta/jar_valve.stl
mm-launch-hw/v2/BUILD/plates/4-feeder-grey/feeder_cover.stl
mm-launch-hw/v2/BUILD/plates/4-feeder-grey/feeder_crown.stl
mm-launch-hw/v2/BUILD/plates/4-feeder-grey/feeder_pinion.stl
mm-launch-hw/v2/BUILD/plates/4-feeder-grey/gate_detent.stl
mm-launch-hw/v2/BUILD/plates/5-pan-turntable-beam/beam.stl
mm-launch-hw/v2/BUILD/plates/5-pan-turntable-beam/hub_gear.stl
mm-launch-hw/v2/BUILD/plates/5-pan-turntable-beam/thrust_ring.stl
mm-launch-hw/v2/BUILD/plates/5-pan-turntable-beam/tilt_horn_adapter.stl
mm-launch-hw/v2/BUILD/plates/5-pan-turntable-beam/turntable.stl
mm-launch-hw/v2/BUILD/plates/6-pan-posts/groove_cap.stl
mm-launch-hw/v2/BUILD/plates/6-pan-posts/post_L.stl
mm-launch-hw/v2/BUILD/plates/6-pan-posts/post_R.stl
mm-launch-hw/v2/BUILD/plates/6-pan-posts/post_R_cover.stl
mm-launch-hw/v2/BUILD/plates/7-base-shell/base_shell.stl
mm-launch-hw/v2/BUILD/plates/7-base-shell/pan_pinion.stl
mm-launch-hw/v2/BUILD/plates/7-base-shell/pan_servo_clamp.stl
mm-launch-hw/v2/BUILD/plates/8-base-floor/base_floor.stl
mm-launch-hw/v2/BUILD/plates/9-base-mounts/base_partition.stl
mm-launch-hw/v2/BUILD/plates/9-base-mounts/pan_servo_mount.stl
mm-launch-hw/v2/blender/model.blend
mm-launch-hw/v2/stl/base_floor.stl
mm-launch-hw/v2/stl/base_partition.stl
mm-launch-hw/v2/stl/base_shell.stl
mm-launch-hw/v2/stl/beam.stl
mm-launch-hw/v2/stl/encoder_cap.stl
mm-launch-hw/v2/stl/feeder_cover.stl
mm-launch-hw/v2/stl/feeder_crown.stl
mm-launch-hw/v2/stl/feeder_housing.stl
mm-launch-hw/v2/stl/feeder_pinion.stl
mm-launch-hw/v2/stl/gate_detent.stl
mm-launch-hw/v2/stl/groove_cap.stl
mm-launch-hw/v2/stl/hood.stl
mm-launch-hw/v2/stl/hub_gear.stl
mm-launch-hw/v2/stl/jar_adapter.stl
mm-launch-hw/v2/stl/jar_gate.stl
mm-launch-hw/v2/stl/jar_valve.stl
mm-launch-hw/v2/stl/journal_plate.stl
mm-launch-hw/v2/stl/launcher_body.stl
mm-launch-hw/v2/stl/launcher_cover.stl
mm-launch-hw/v2/stl/nacelle.stl
mm-launch-hw/v2/stl/nip_cover.stl
mm-launch-hw/v2/stl/nip_leaf.stl
mm-launch-hw/v2/stl/nip_stop.stl
mm-launch-hw/v2/stl/nip_stop_sleeve.stl
mm-launch-hw/v2/stl/nip_wheel.stl
mm-launch-hw/v2/stl/pan_pinion.stl
mm-launch-hw/v2/stl/pan_servo_clamp.stl
mm-launch-hw/v2/stl/pan_servo_mount.stl
mm-launch-hw/v2/stl/post_L.stl
mm-launch-hw/v2/stl/post_R.stl
mm-launch-hw/v2/stl/post_R_cover.stl
mm-launch-hw/v2/stl/thrust_ring.stl
mm-launch-hw/v2/stl/tilt_horn_adapter.stl
mm-launch-hw/v2/stl/turntable.stl
mm-launch-hw/v3/blender/model.blend
