Every-Flavor-Robotics/mm-launcher/mm-launch-hw/v3/BUILD/guide/assembly_guide.html

# M&M launcher v3 assembly

Build steps Parts and plates

Drag to orbit · scroll to zoom · click a part

◀ Prev Next step ▶

Step0/ 0

Hold apart 0%

Ghost the rest Follow parts Main view

Pan 0° Tilt 0°

Spin flywheel Feeder index

Disc0°

Home pose
