Every-Flavor-Robotics/mm-launcher/mm-launch-hw/renders/attempt-2/feed_trace_tilt45_operating.png

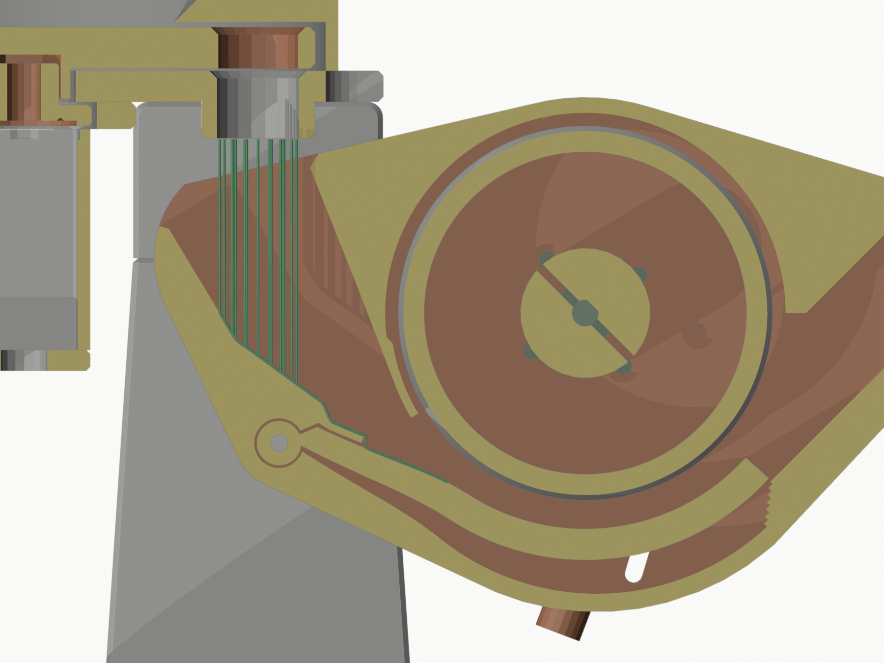
mm-launch-hw/renders/attempt-2/feed_trace_tilt45_operating.png
