Every-Flavor-Robotics/mm-launcher/mm-launch-hw/renders/attempt-3/review/nip_cover_print_orientation_section.png

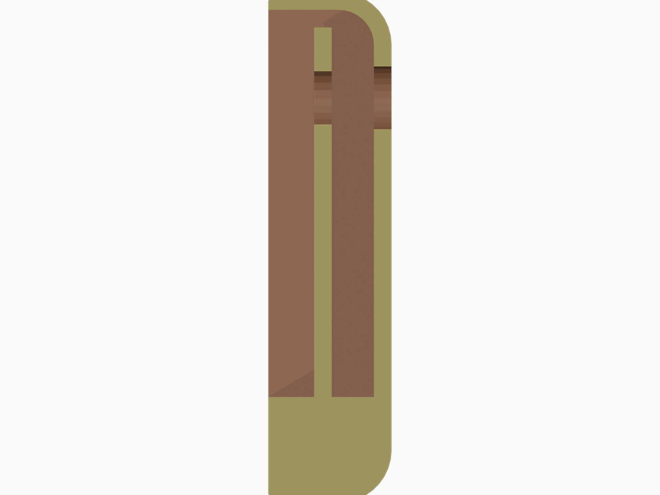
mm-launch-hw/renders/attempt-3/review/nip_cover_print_orientation_section.png
