Every-Flavor-Robotics/mm-launcher/mm-launch-hw/test-prints/launch-rig/renders/exploded.png

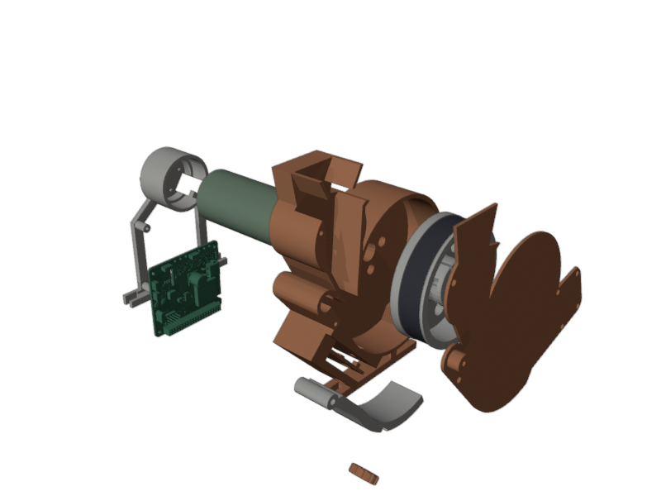
mm-launch-hw/test-prints/launch-rig/renders/exploded.png
