Every-Flavor-Robotics/mm-launcher/mm-launch-hw/test-prints/launch-rig/renders/iso.png

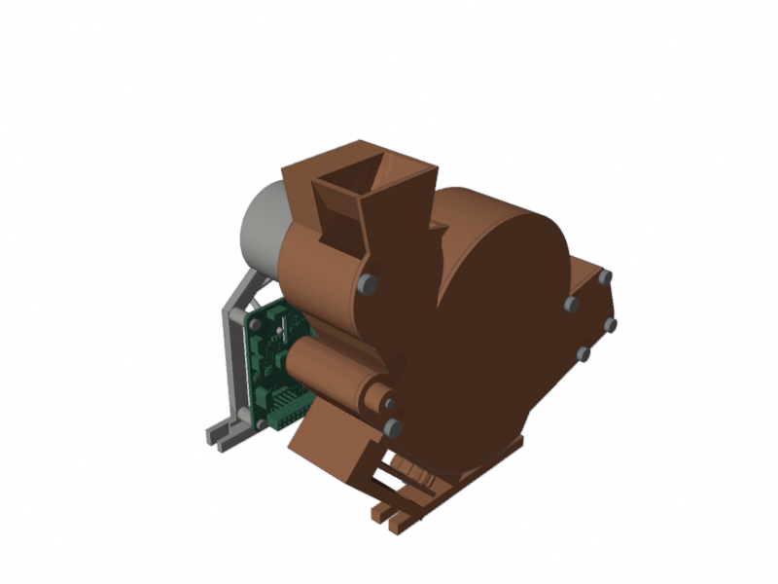
mm-launch-hw/test-prints/launch-rig/renders/iso.png
