Every-Flavor-Robotics/mm-launcher/mm-launch-hw/test-prints/launch-rig/renders/iso_low_cover_side.png

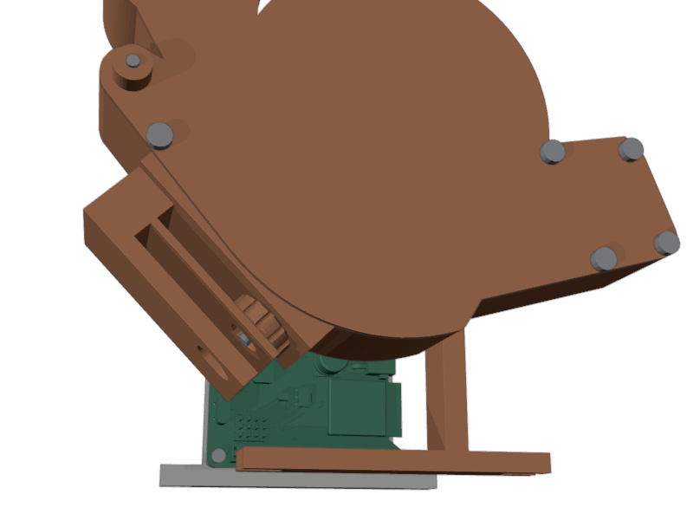
mm-launch-hw/test-prints/launch-rig/renders/iso_low_cover_side.png
