Every-Flavor-Robotics/mm-launcher/mm-launch-hw/test-prints/launch-rig/renders/iso_rear_left.png

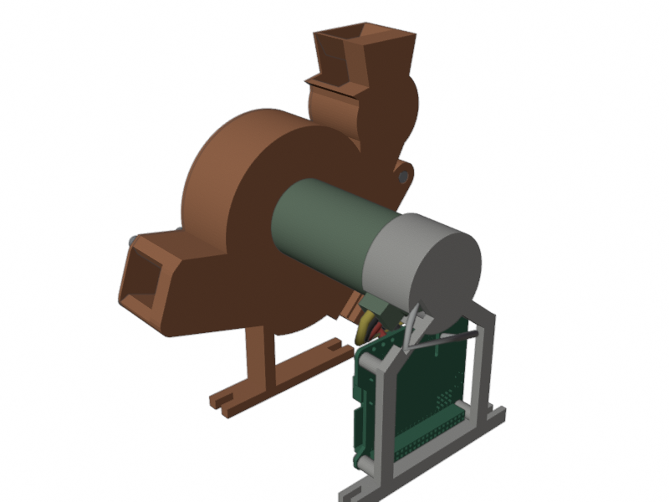
mm-launch-hw/test-prints/launch-rig/renders/iso_rear_left.png
