Every-Flavor-Robotics/mm-launcher/mm-launch-hw/test-prints/launch-rig/renders/section_motor_encoder_axis.png

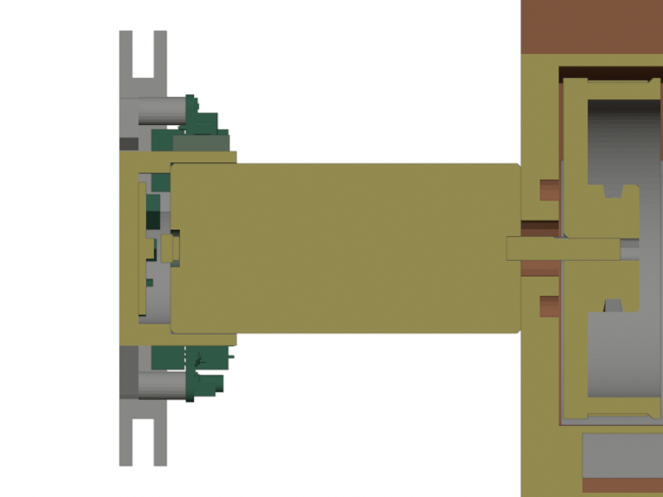
mm-launch-hw/test-prints/launch-rig/renders/section_motor_encoder_axis.png
