Every-Flavor-Robotics/mm-launcher/mm-launch-hw/test-prints/launch-rig/renders/section_nip_gap_5.png

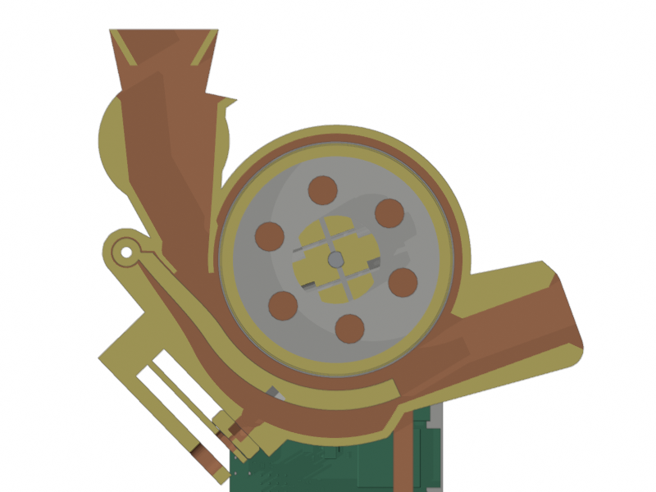
mm-launch-hw/test-prints/launch-rig/renders/section_nip_gap_5.png
