Every-Flavor-Robotics/mm-launcher/mm-launch-hw/test-prints/launch-rig/renders/section_stud_leaf_plane.png

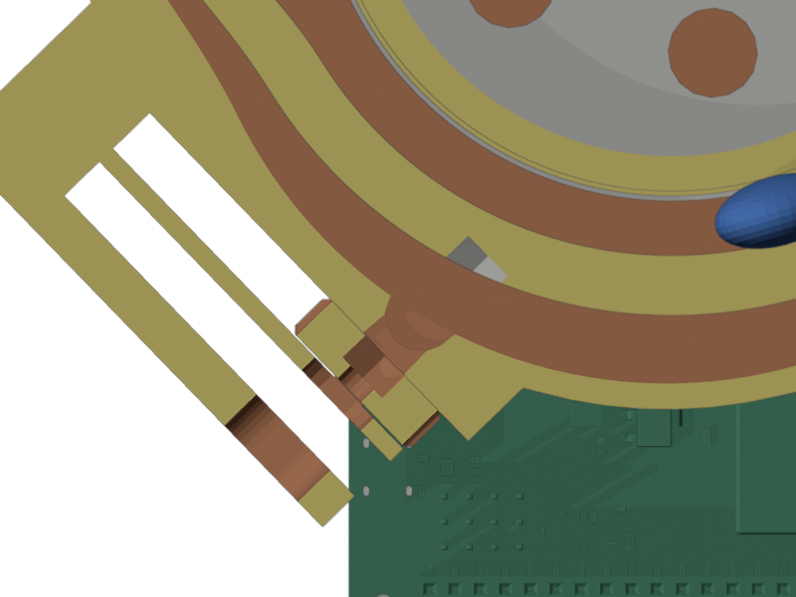
mm-launch-hw/test-prints/launch-rig/renders/section_stud_leaf_plane.png
