Every-Flavor-Robotics/mm-launcher/mm-launch-hw/v3/BUILD/guide/screenshots/0_start_lift_warning.png

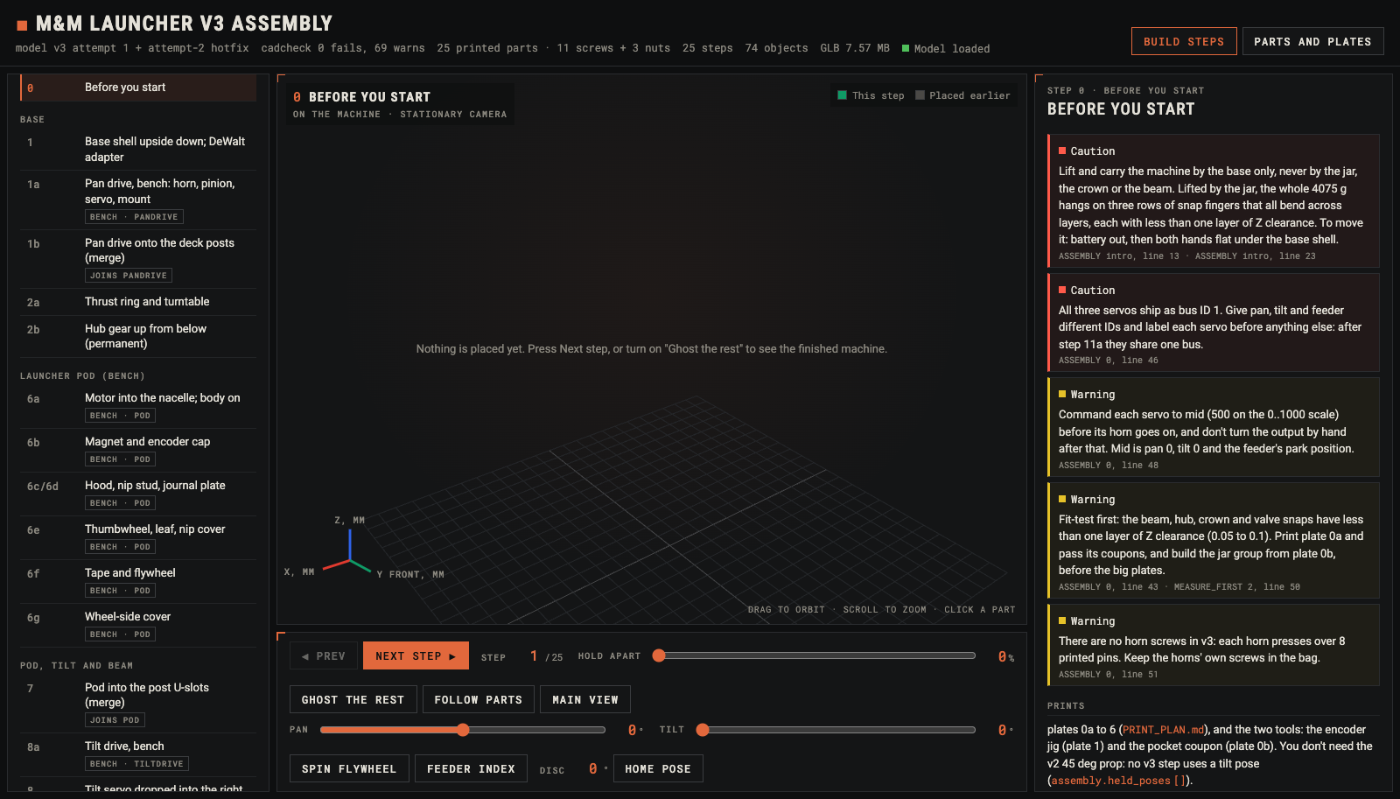
mm-launch-hw/v3/BUILD/guide/screenshots/0_start_lift_warning.png
