Every-Flavor-Robotics/mm-launcher/mm-launch-hw/v3/BUILD/guide/screenshots/4_follow_mid_6e.png

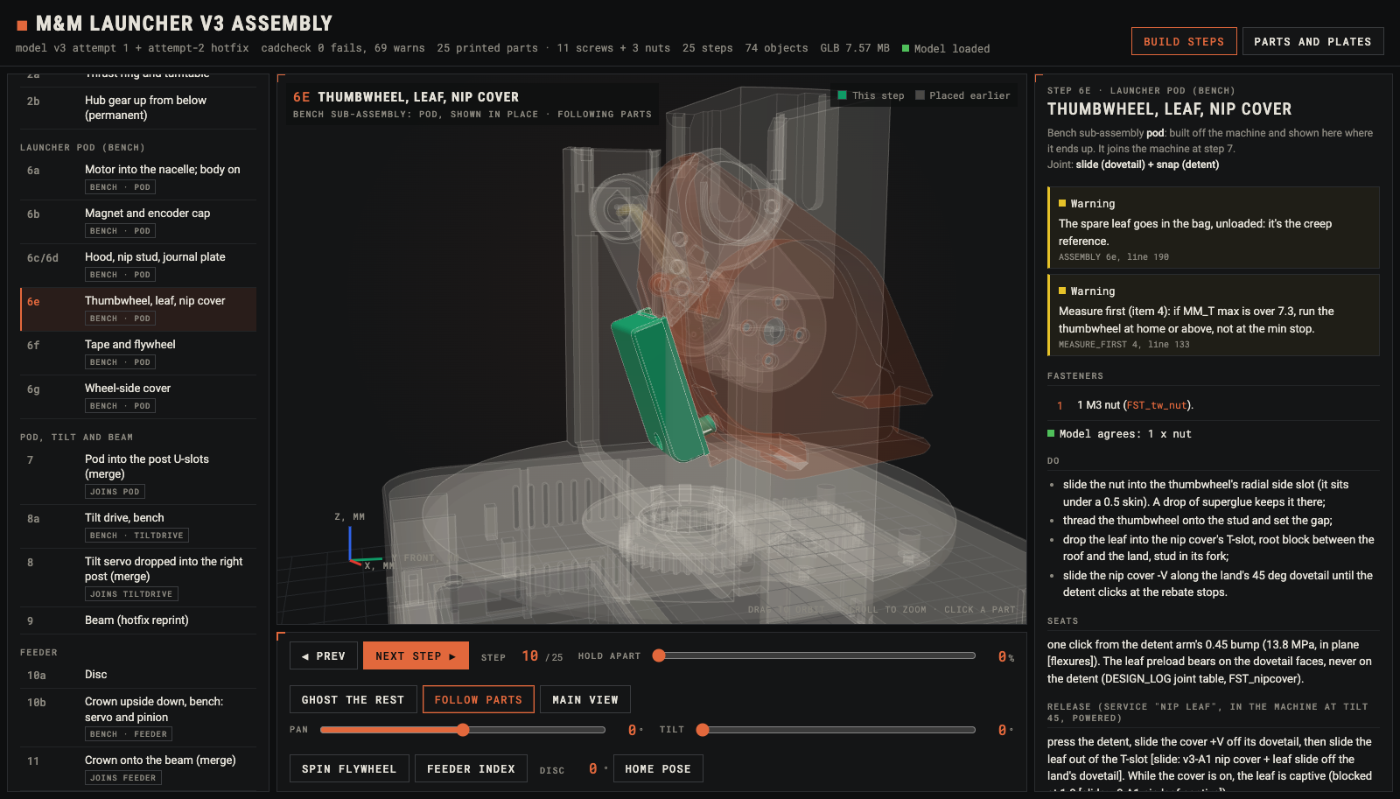
mm-launch-hw/v3/BUILD/guide/screenshots/4_follow_mid_6e.png
