Every-Flavor-Robotics/mm-launcher/mm-launch-hw/v3/BUILD/guide/screenshots/8_final_step16_pan45_tilt30.png

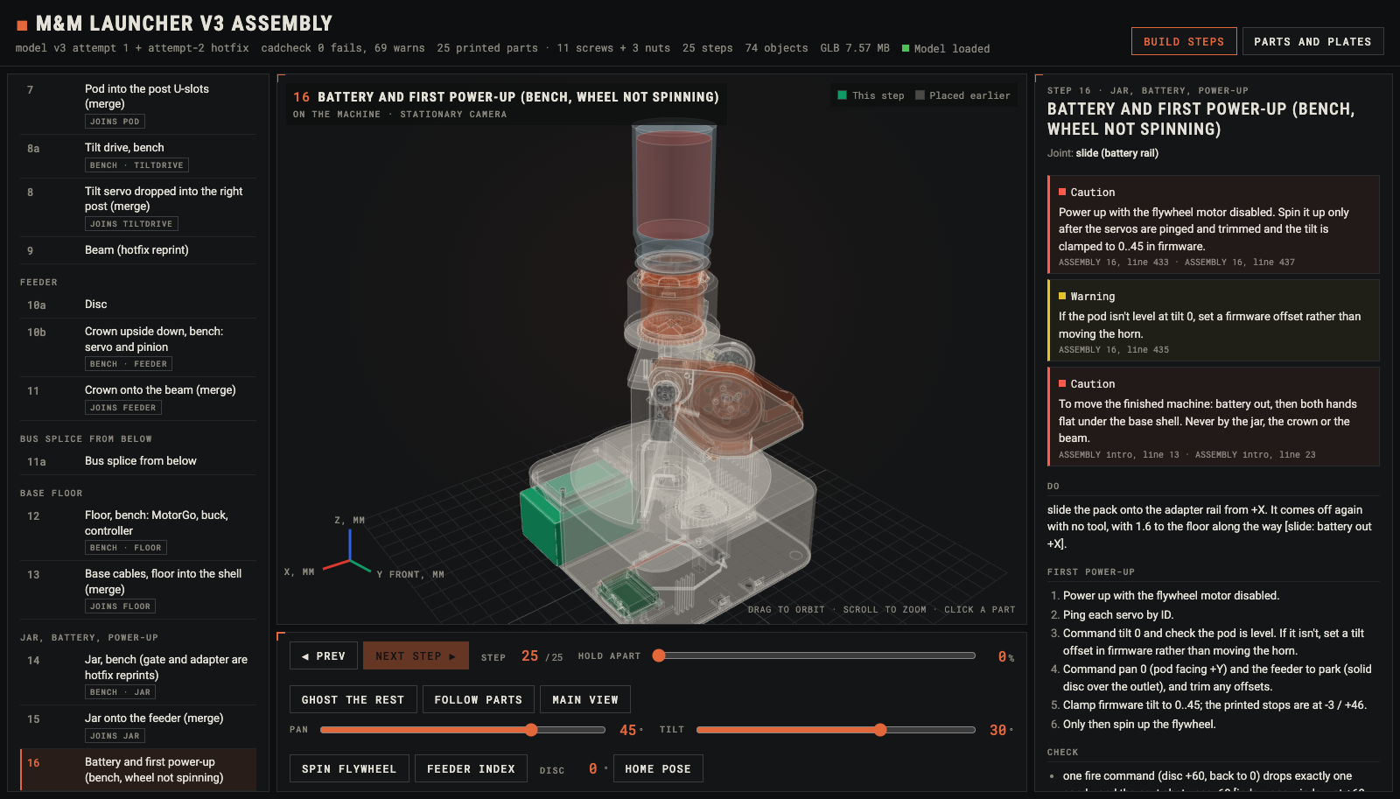
mm-launch-hw/v3/BUILD/guide/screenshots/8_final_step16_pan45_tilt30.png
