Every-Flavor-Robotics/mm-launcher/mm-launch-hw/v3/BUILD/guide/screenshots/steps/01_1_midflight.png

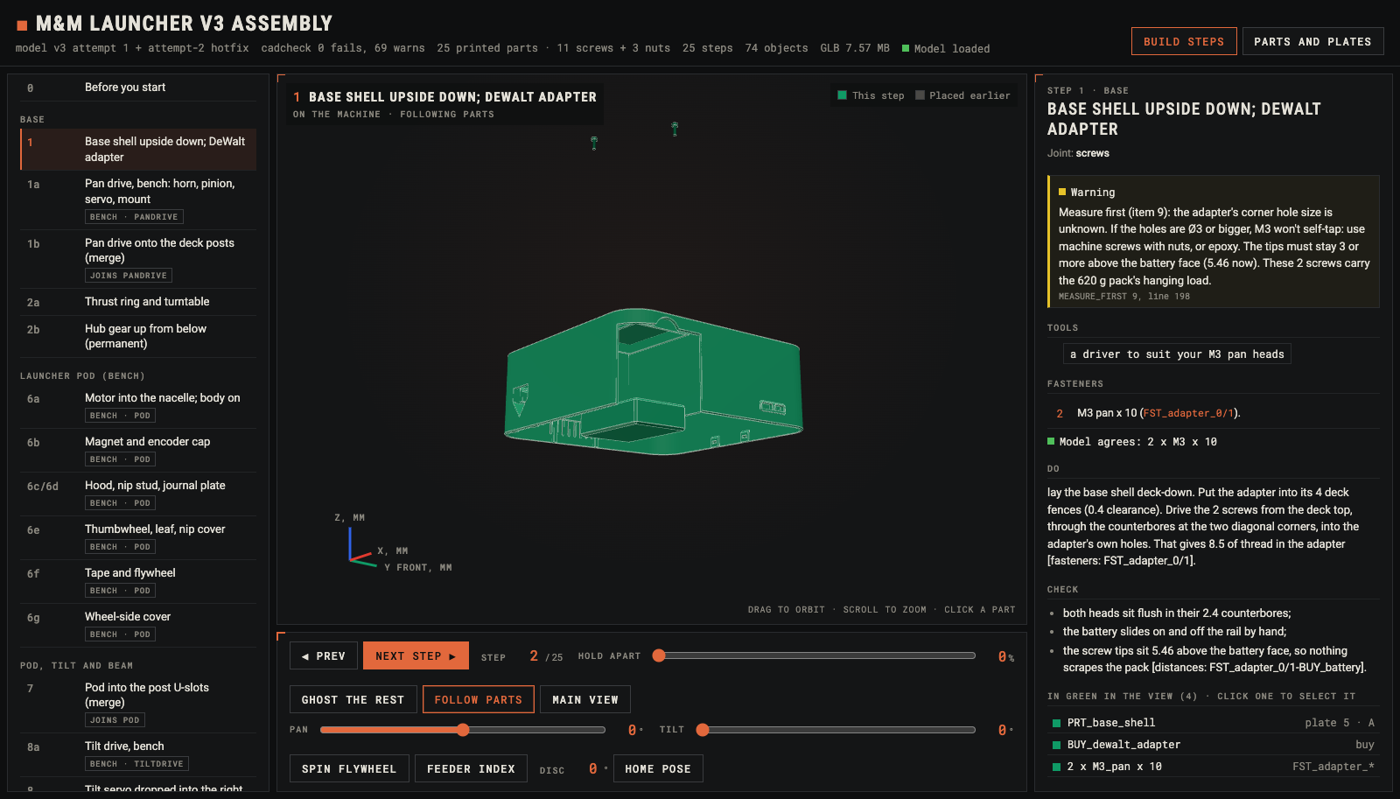
mm-launch-hw/v3/BUILD/guide/screenshots/steps/01_1_midflight.png
