Every-Flavor-Robotics/mm-launcher/mm-launch-hw/v3/BUILD/guide/screenshots/steps/03_1b_midflight.png

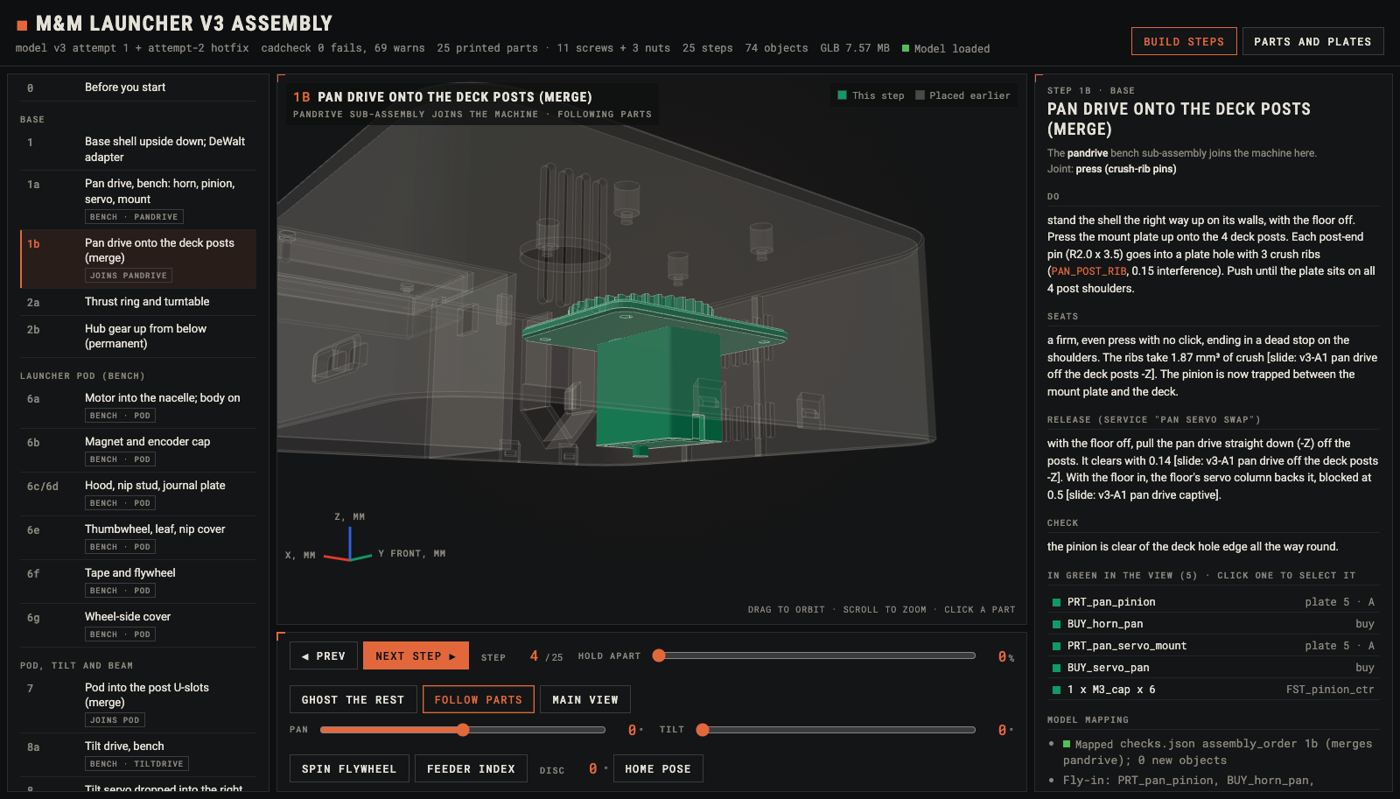
mm-launch-hw/v3/BUILD/guide/screenshots/steps/03_1b_midflight.png
