Every-Flavor-Robotics/mm-launcher/mm-launch-hw/v3/BUILD/guide/screenshots/steps/04_2a_midflight.png

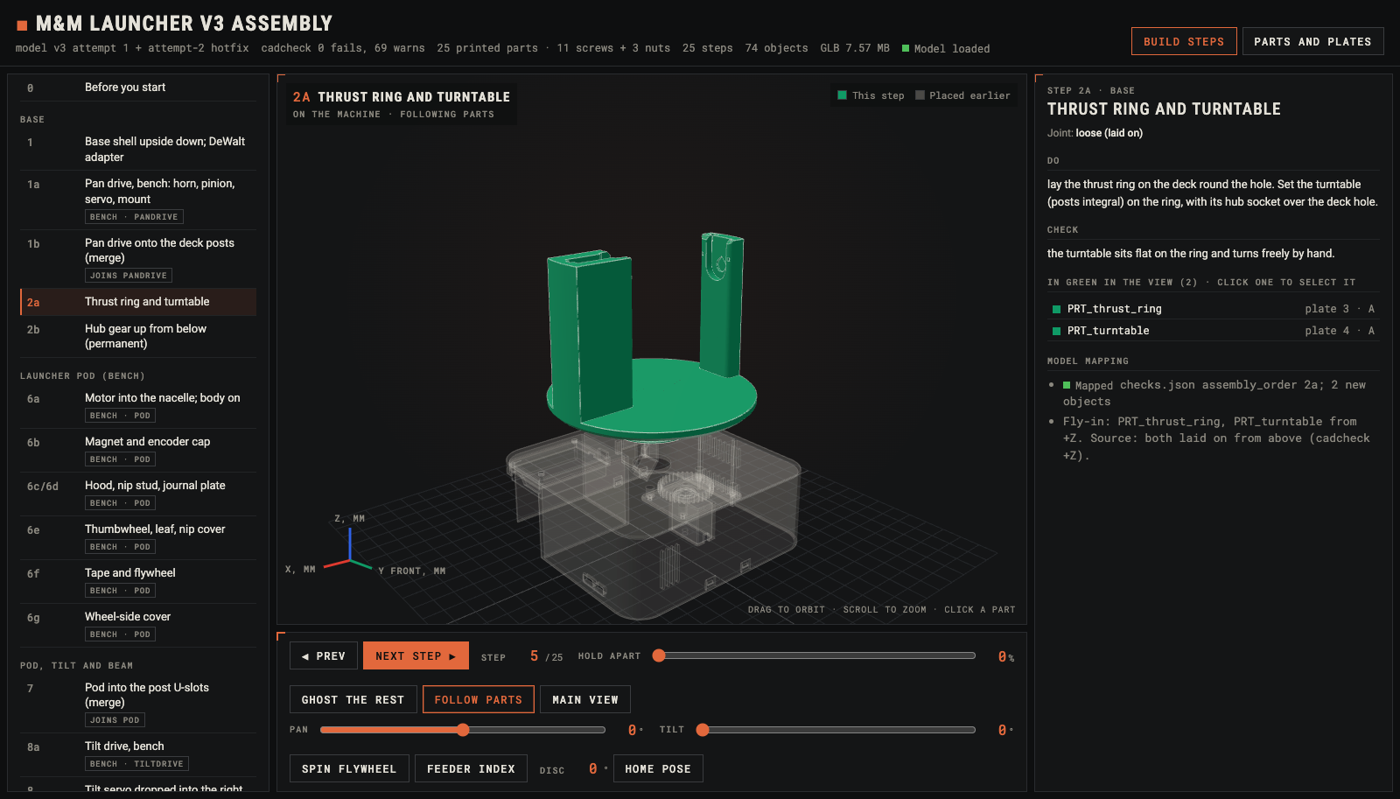
mm-launch-hw/v3/BUILD/guide/screenshots/steps/04_2a_midflight.png
