Every-Flavor-Robotics/mm-launcher/mm-launch-hw/v3/BUILD/guide/screenshots/steps/06_6a_midflight.png

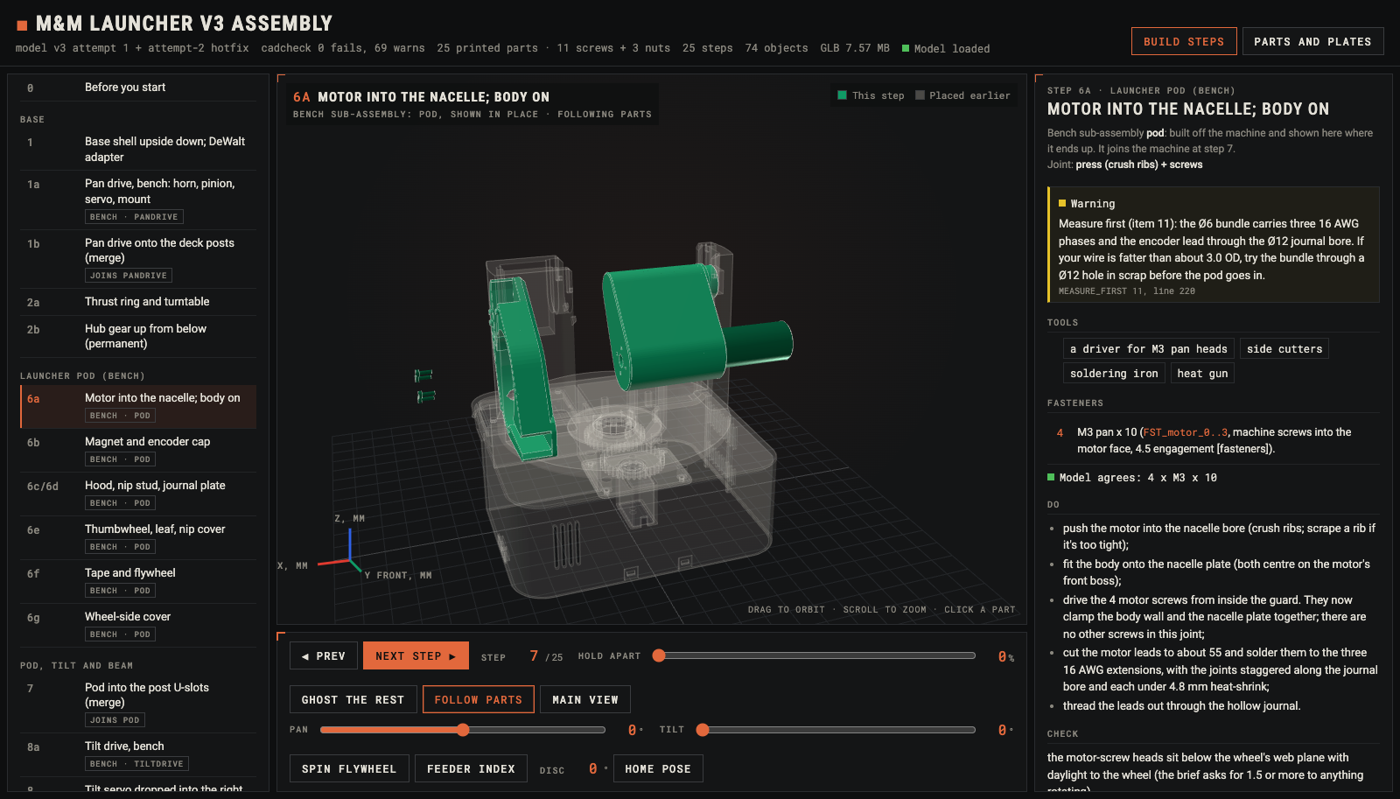
mm-launch-hw/v3/BUILD/guide/screenshots/steps/06_6a_midflight.png
