Every-Flavor-Robotics/mm-launcher/mm-launch-hw/v3/BUILD/guide/screenshots/steps/07_6b_midflight.png

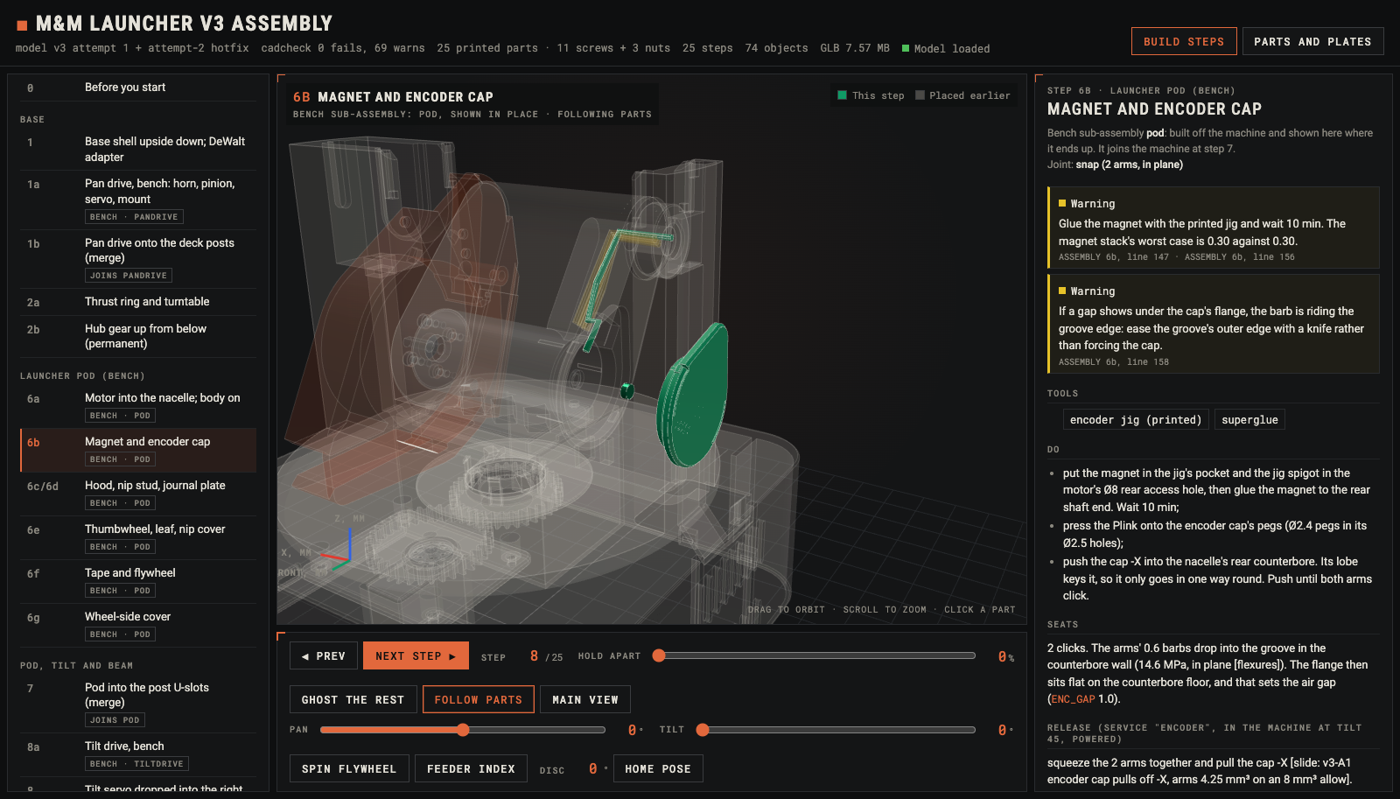
mm-launch-hw/v3/BUILD/guide/screenshots/steps/07_6b_midflight.png
