Every-Flavor-Robotics/mm-launcher/mm-launch-hw/v3/BUILD/guide/screenshots/steps/08_6c-6d_midflight.png

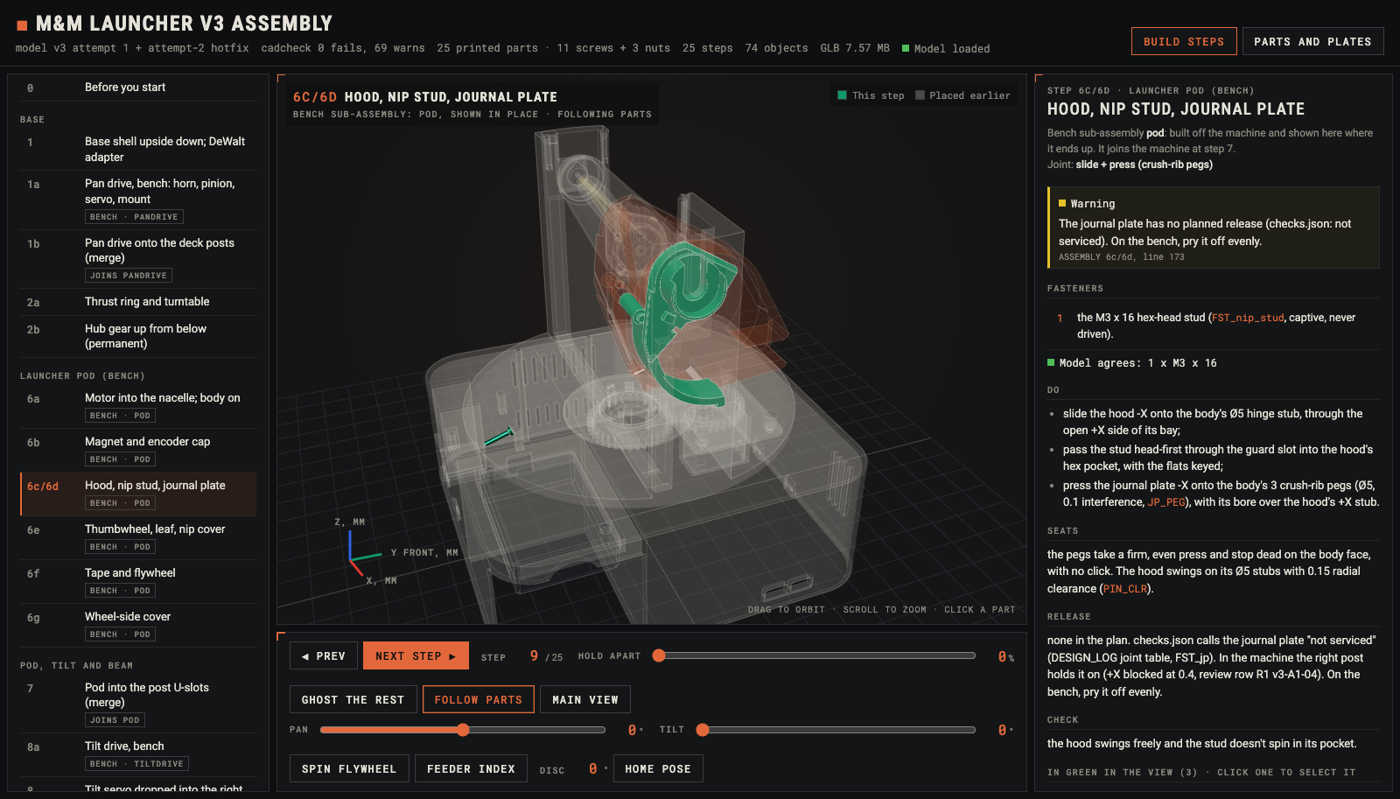
mm-launch-hw/v3/BUILD/guide/screenshots/steps/08_6c-6d_midflight.png
