Every-Flavor-Robotics/mm-launcher/mm-launch-hw/v3/BUILD/guide/screenshots/steps/10_6f_midflight.png

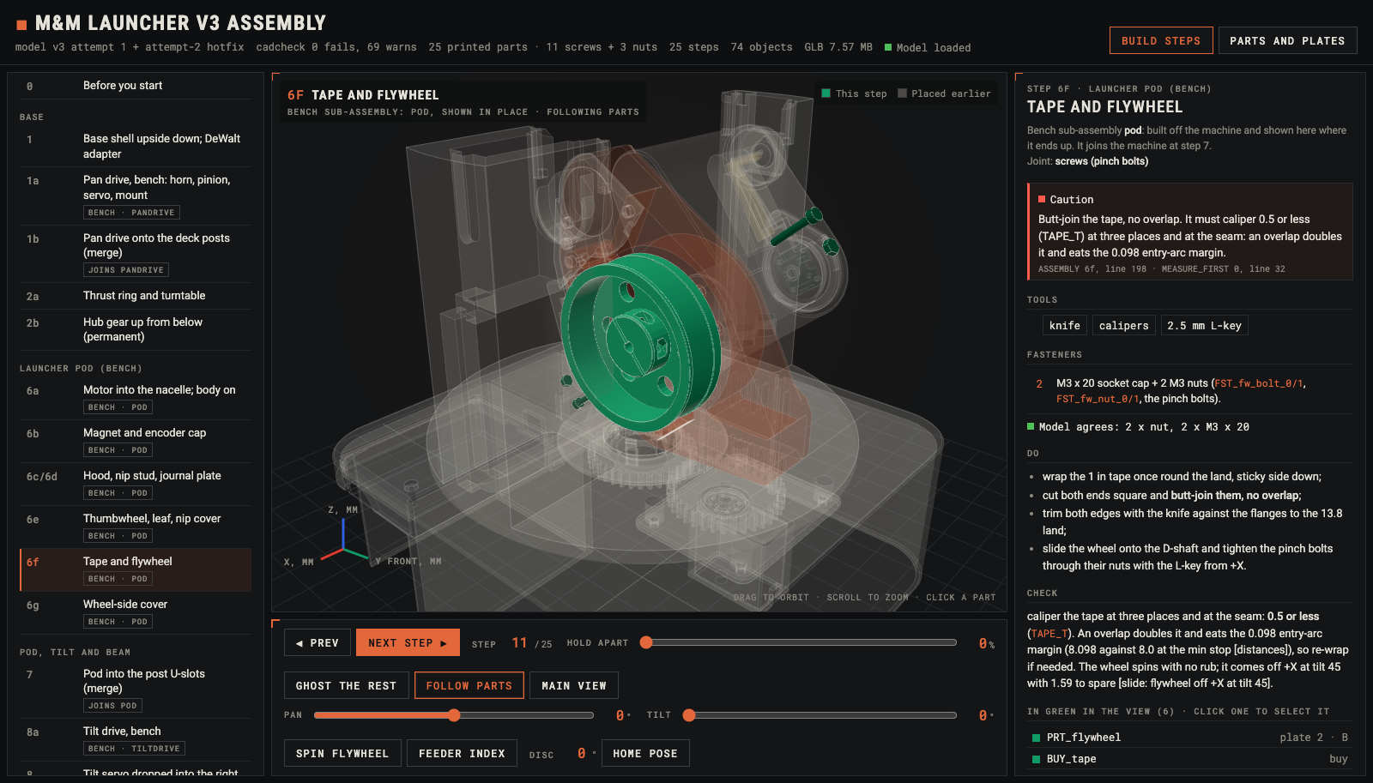
mm-launch-hw/v3/BUILD/guide/screenshots/steps/10_6f_midflight.png
