Every-Flavor-Robotics/mm-launcher/mm-launch-hw/v3/BUILD/guide/screenshots/steps/11_6g_midflight.png

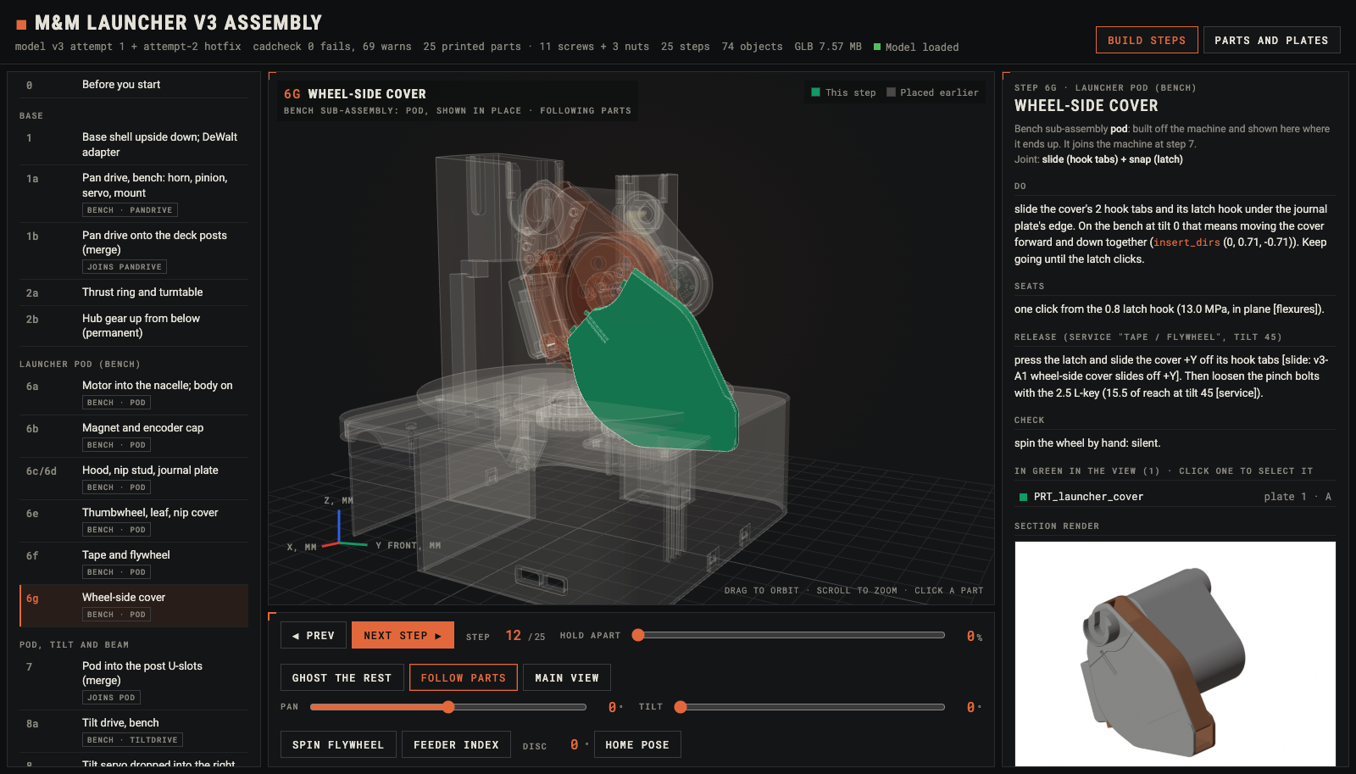
mm-launch-hw/v3/BUILD/guide/screenshots/steps/11_6g_midflight.png
