Every-Flavor-Robotics/mm-launcher/mm-launch-hw/v3/BUILD/guide/screenshots/steps/12_7_midflight.png

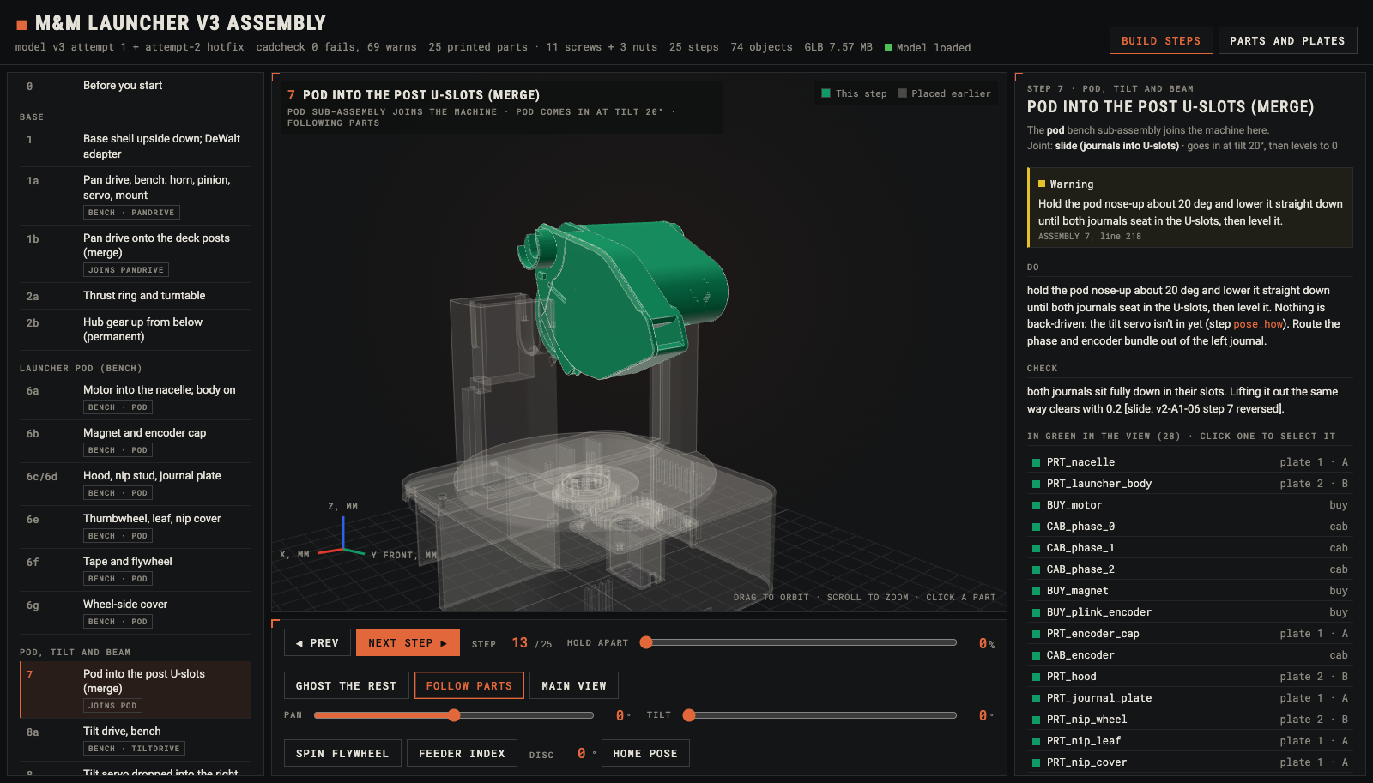
mm-launch-hw/v3/BUILD/guide/screenshots/steps/12_7_midflight.png
