Every-Flavor-Robotics/mm-launcher/mm-launch-hw/v3/BUILD/guide/screenshots/steps/13_8a_midflight.png

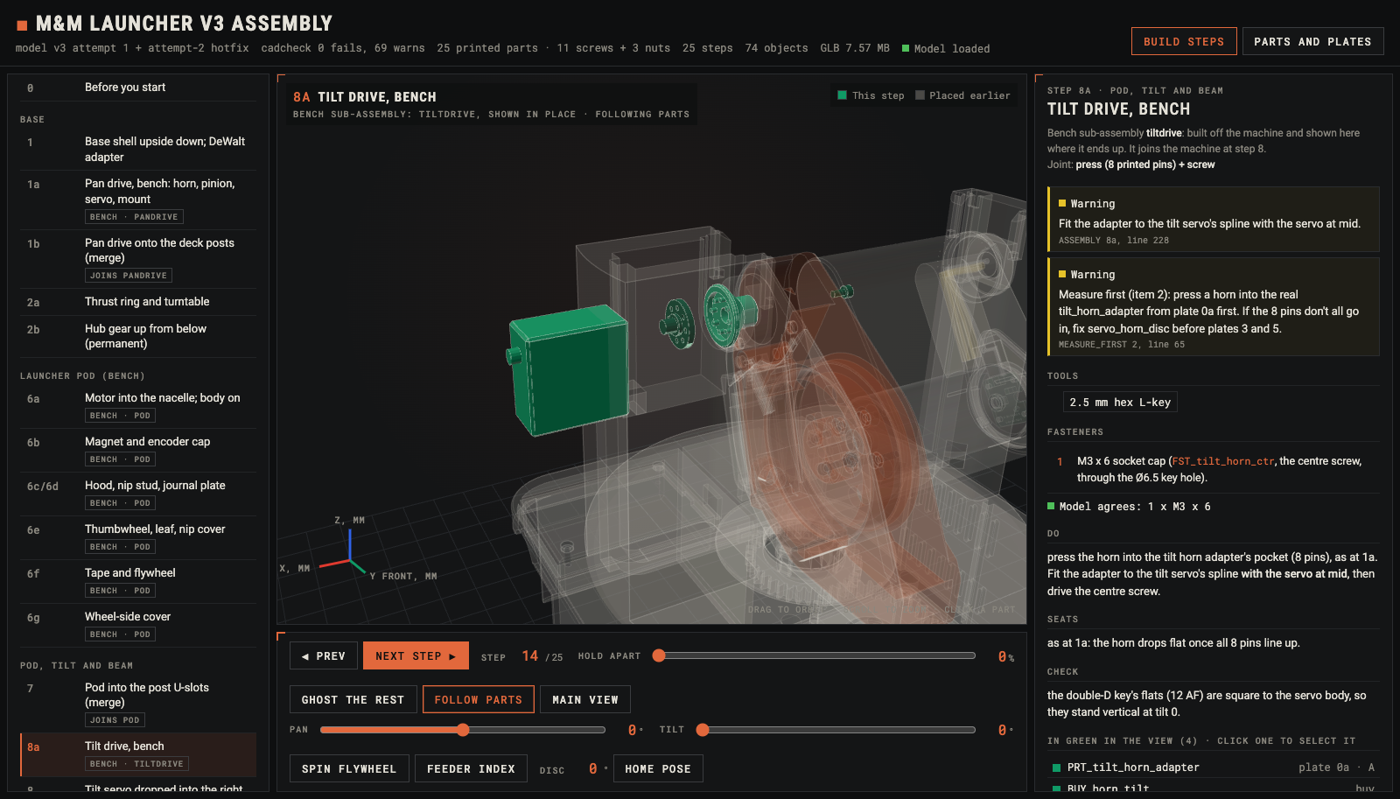
mm-launch-hw/v3/BUILD/guide/screenshots/steps/13_8a_midflight.png
