Every-Flavor-Robotics/mm-launcher/mm-launch-hw/v3/BUILD/guide/screenshots/steps/16_10a_midflight.png

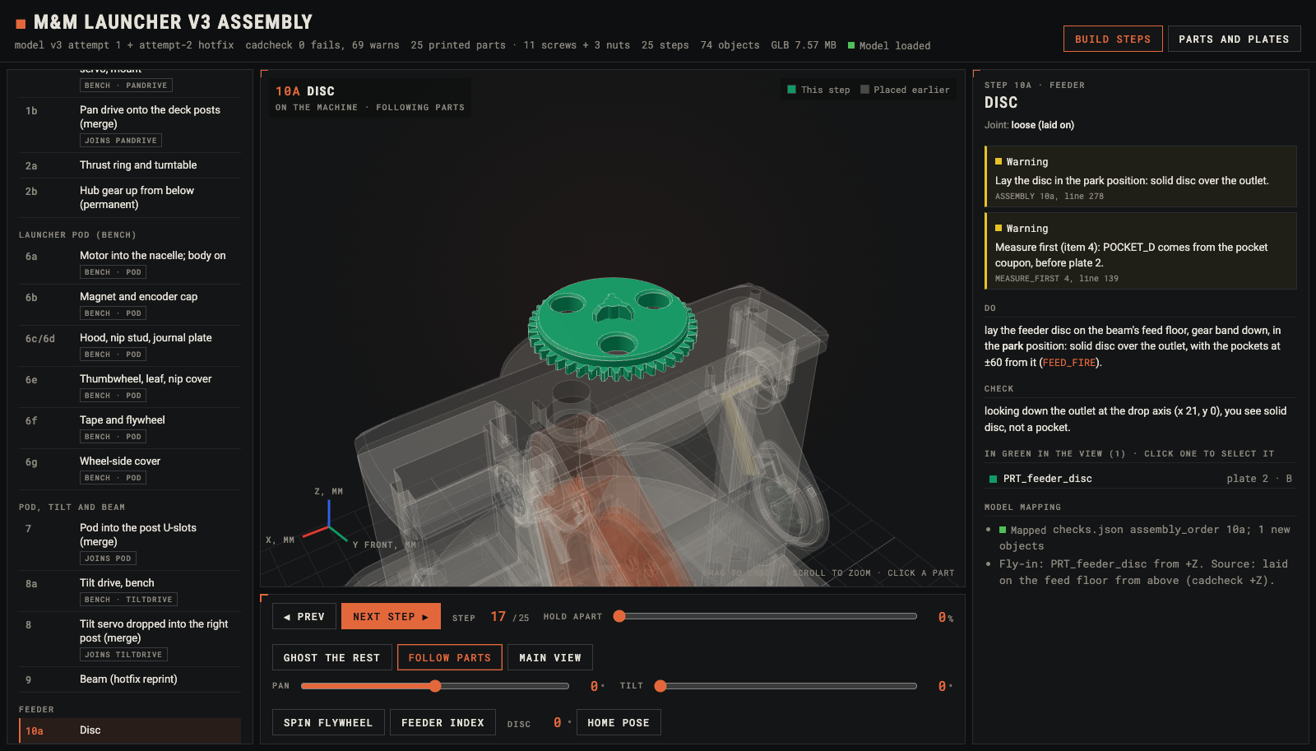
mm-launch-hw/v3/BUILD/guide/screenshots/steps/16_10a_midflight.png
