Every-Flavor-Robotics/mm-launcher/mm-launch-hw/v3/BUILD/guide/screenshots/steps/19_11a_midflight.png

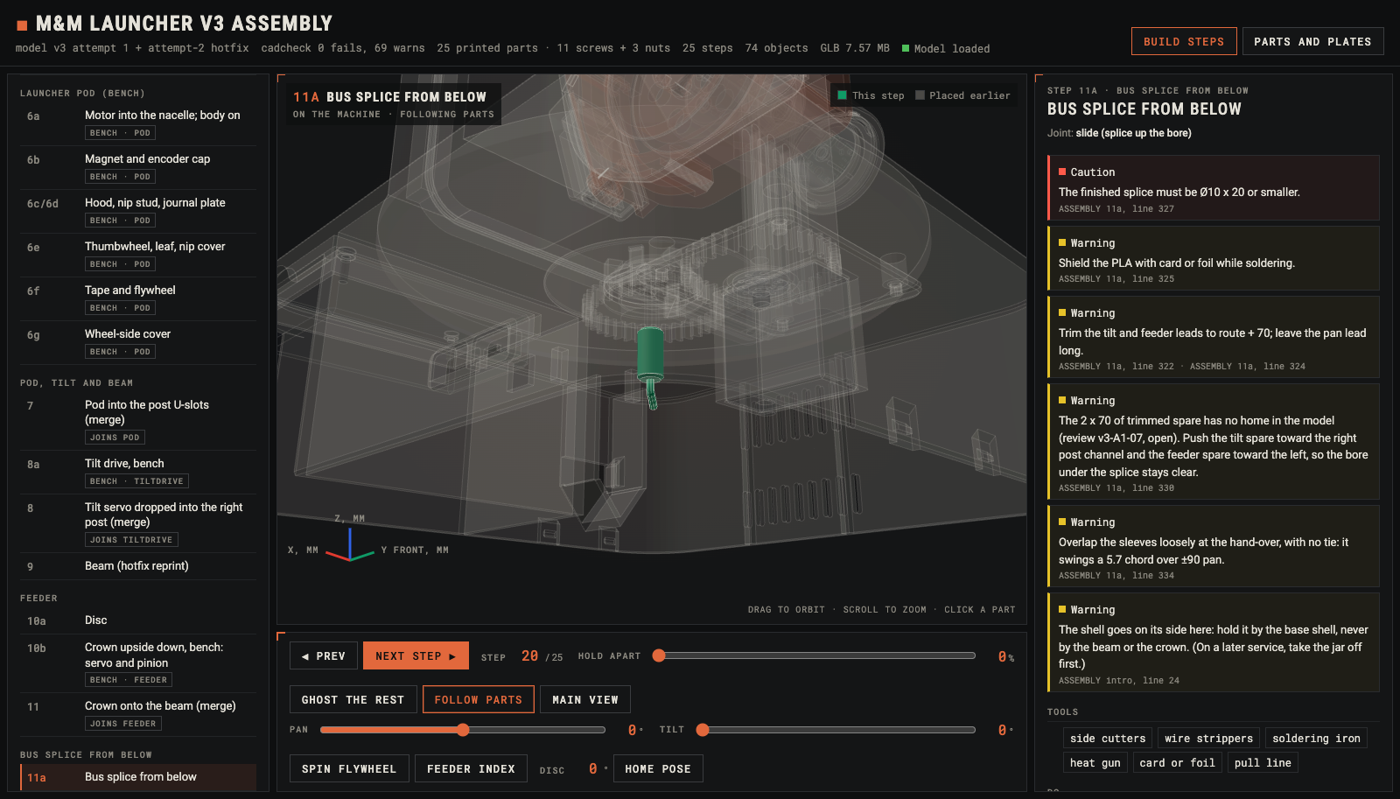
mm-launch-hw/v3/BUILD/guide/screenshots/steps/19_11a_midflight.png
