Every-Flavor-Robotics/mm-launcher/mm-launch-hw/v3/BUILD/guide/screenshots/steps/20_12_midflight.png

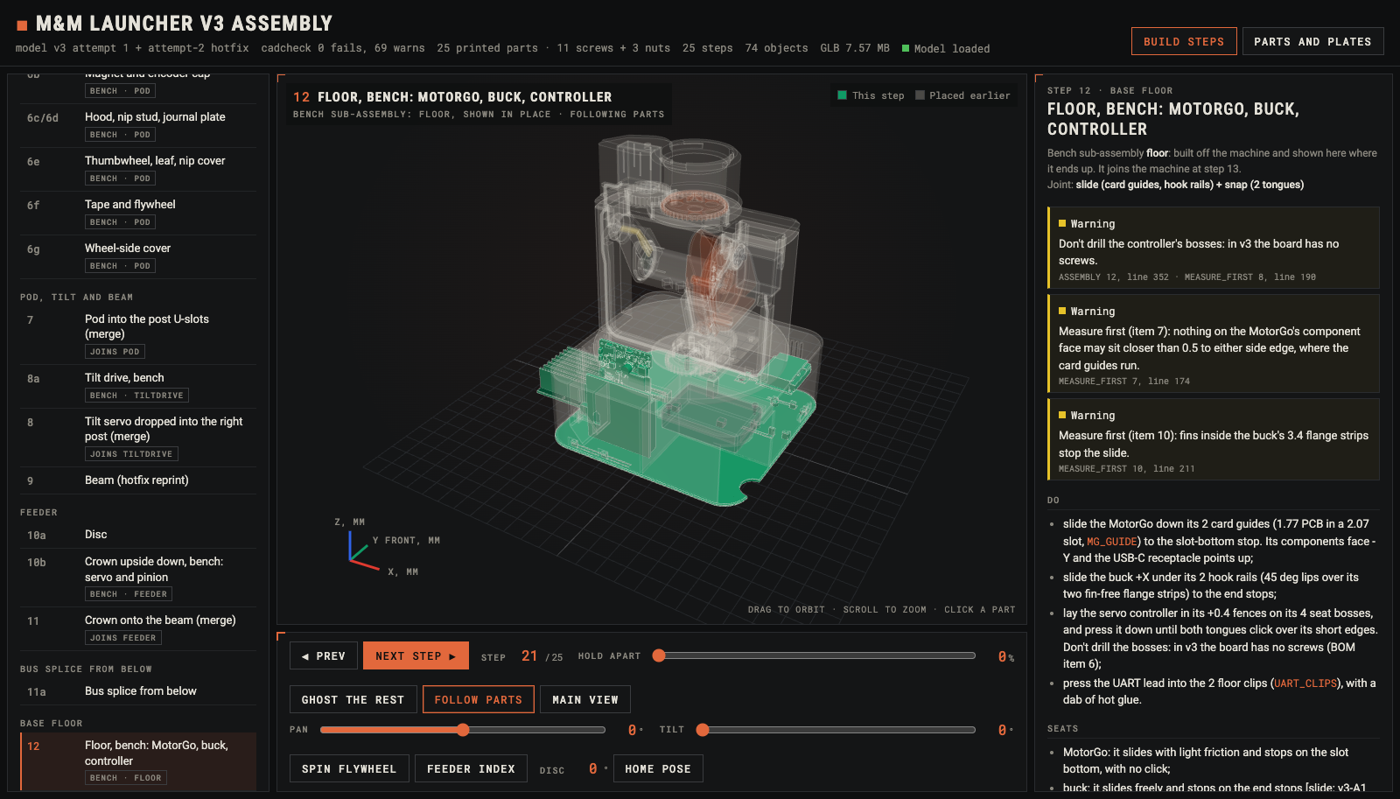
mm-launch-hw/v3/BUILD/guide/screenshots/steps/20_12_midflight.png
