Every-Flavor-Robotics/mm-launcher/mm-launch-hw/v3/BUILD/guide/screenshots/steps/22_14_midflight.png

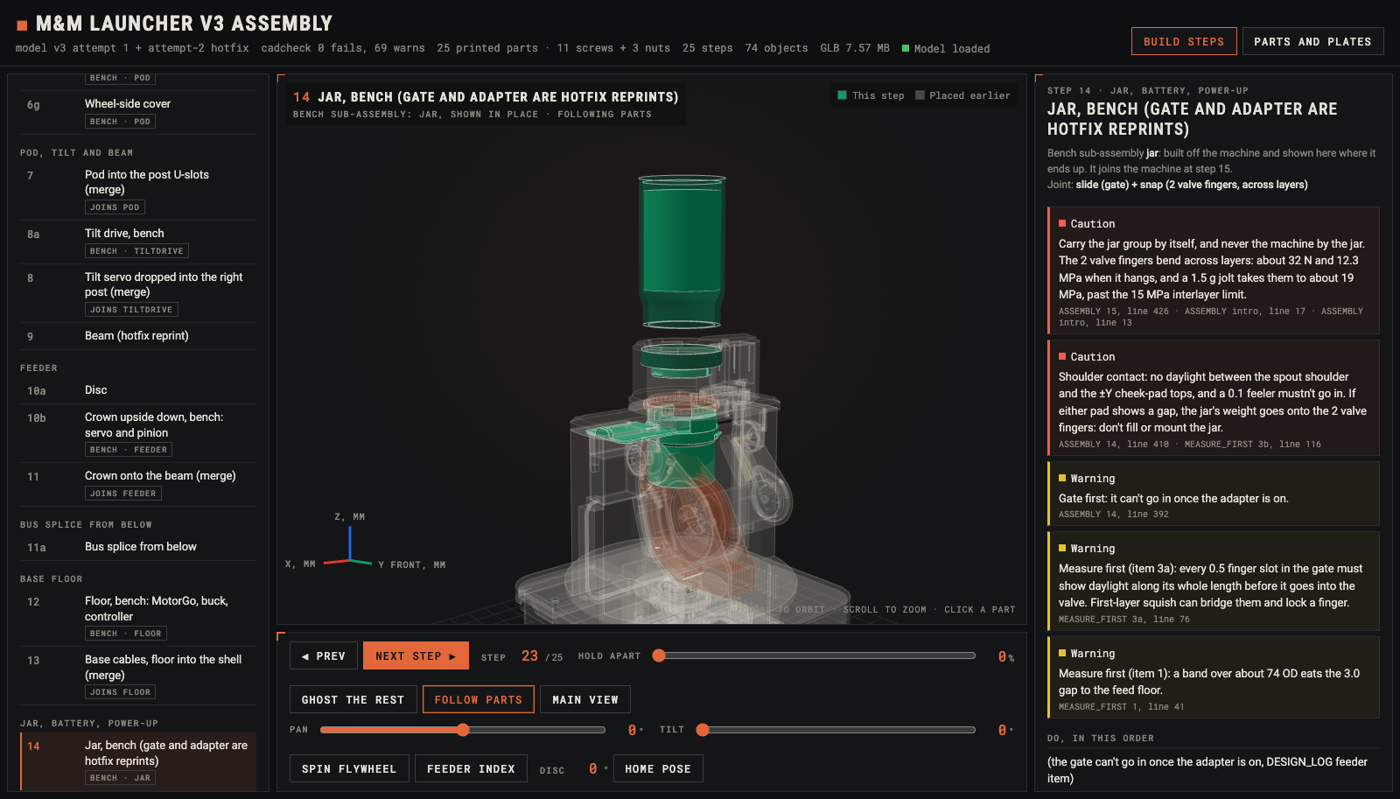
mm-launch-hw/v3/BUILD/guide/screenshots/steps/22_14_midflight.png
