Every-Flavor-Robotics/mm-launcher/mm-launch-hw/v3/BUILD/guide/screenshots/steps/23_15_midflight.png

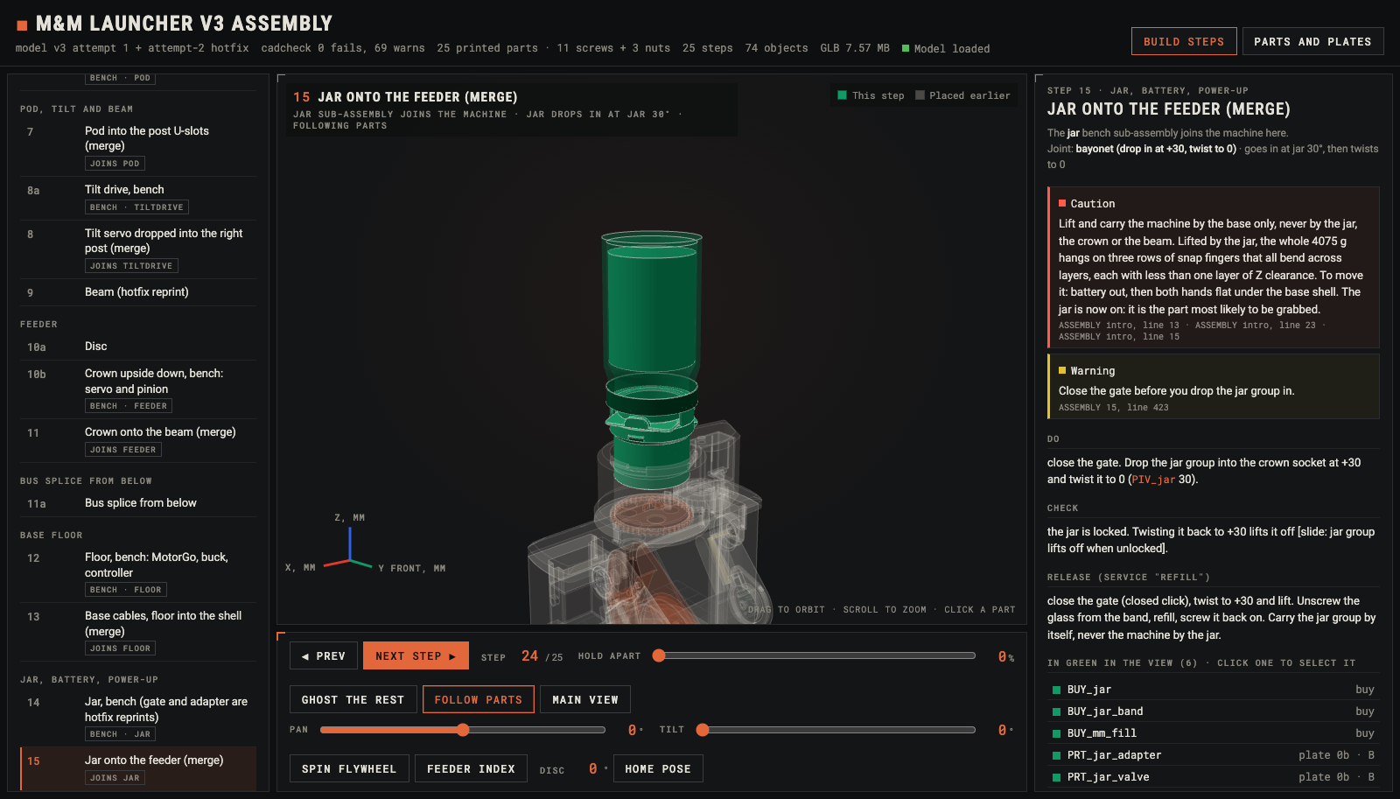
mm-launch-hw/v3/BUILD/guide/screenshots/steps/23_15_midflight.png
