Every-Flavor-Robotics/mm-launcher/mm-launch-hw/v3/BUILD/guide/screenshots/steps/24_16_midflight.png

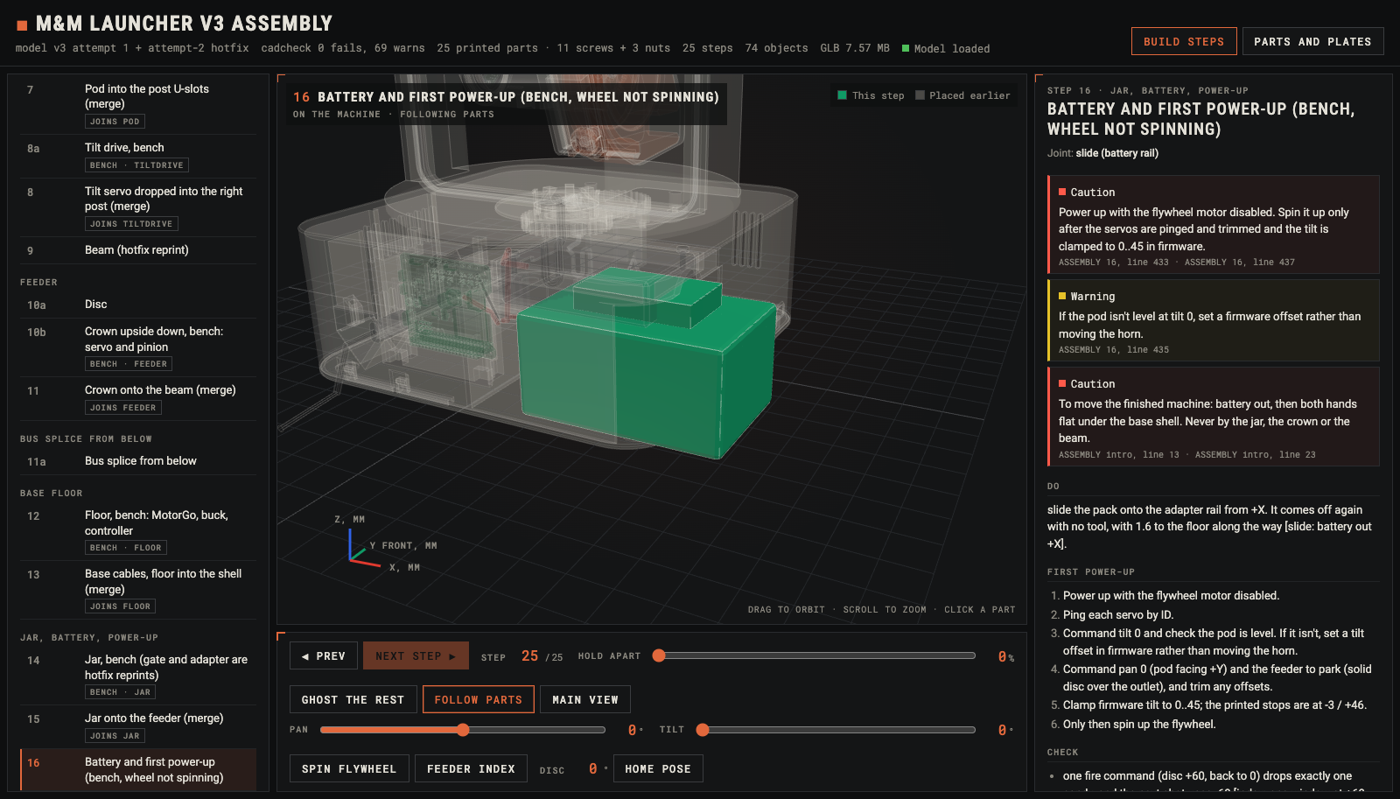
mm-launch-hw/v3/BUILD/guide/screenshots/steps/24_16_midflight.png
