Every-Flavor-Robotics/mm-launcher/mm-launch-hw/v3/BUILD/renders/s01a_pan_drive_bench.png

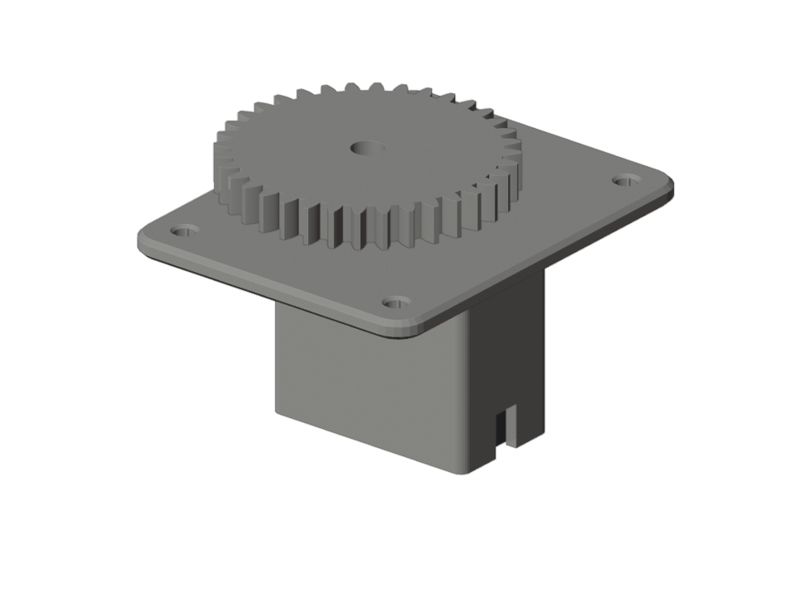
mm-launch-hw/v3/BUILD/renders/s01a_pan_drive_bench.png
