Every-Flavor-Robotics/mm-launcher/mm-launch-hw/v3/BUILD/renders/s02b_hub_gear_from_below.png

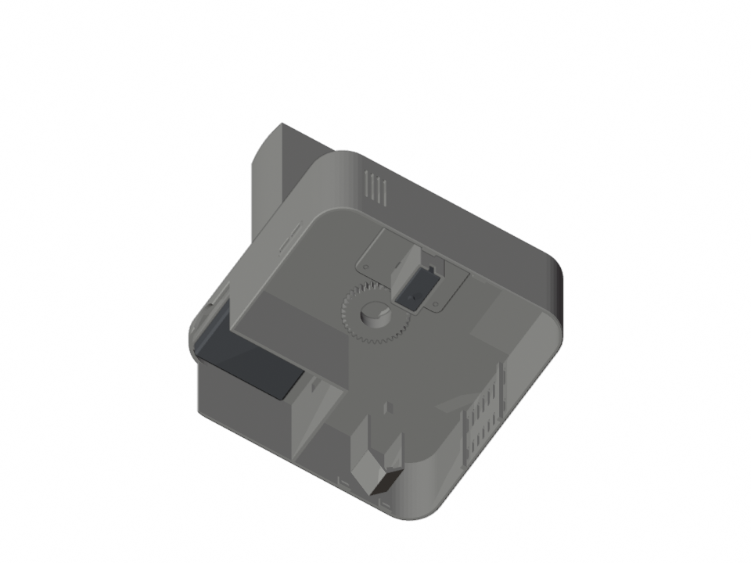
mm-launch-hw/v3/BUILD/renders/s02b_hub_gear_from_below.png
