Every-Flavor-Robotics/mm-launcher/mm-launch-hw/v3/BUILD/renders/s06_pod_bench.png

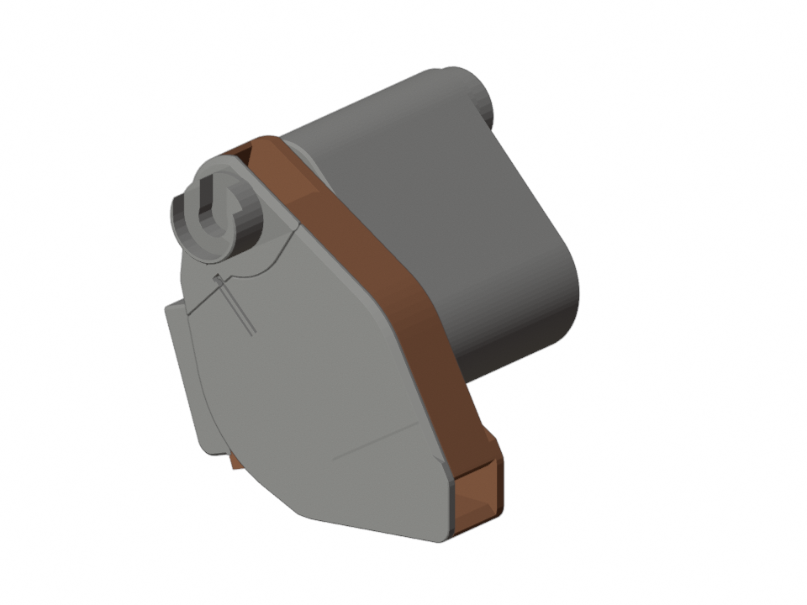
mm-launch-hw/v3/BUILD/renders/s06_pod_bench.png
