Every-Flavor-Robotics/mm-launcher/mm-launch-hw/v3/BUILD/renders/s08_tilt_servo_in_post.png

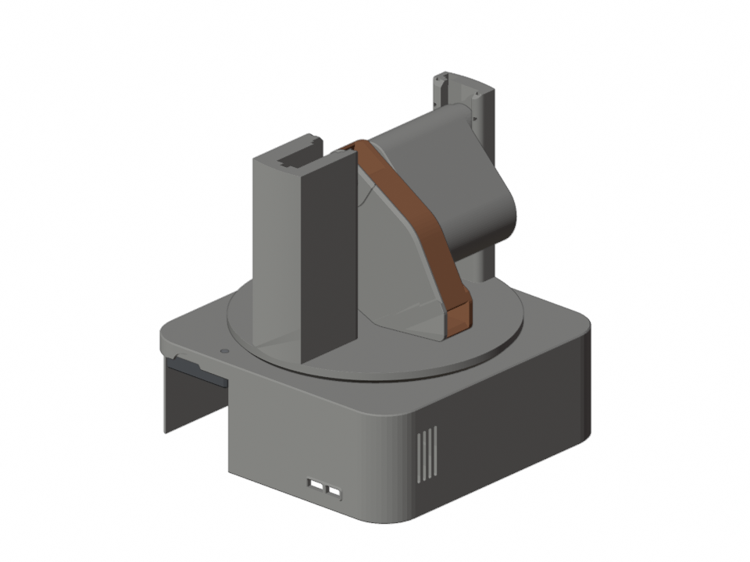
mm-launch-hw/v3/BUILD/renders/s08_tilt_servo_in_post.png
