Every-Flavor-Robotics/mm-launcher/mm-launch-hw/v3/BUILD/renders/s11_crown_on_beam.png

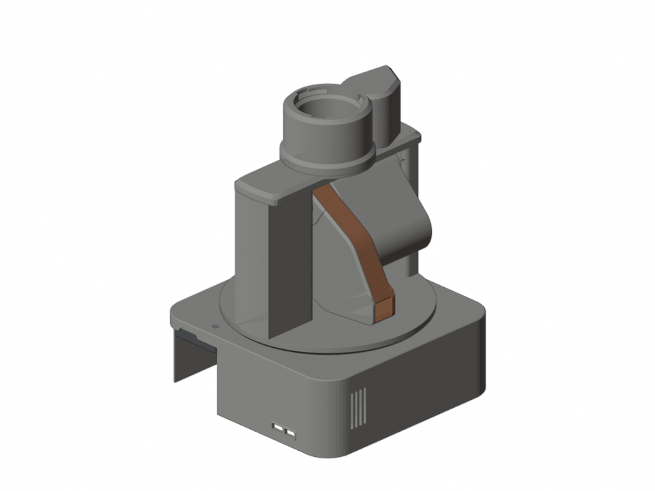
mm-launch-hw/v3/BUILD/renders/s11_crown_on_beam.png
