Every-Flavor-Robotics/mm-launcher/mm-launch-hw/v3/BUILD/renders/s12_floor_bench.png

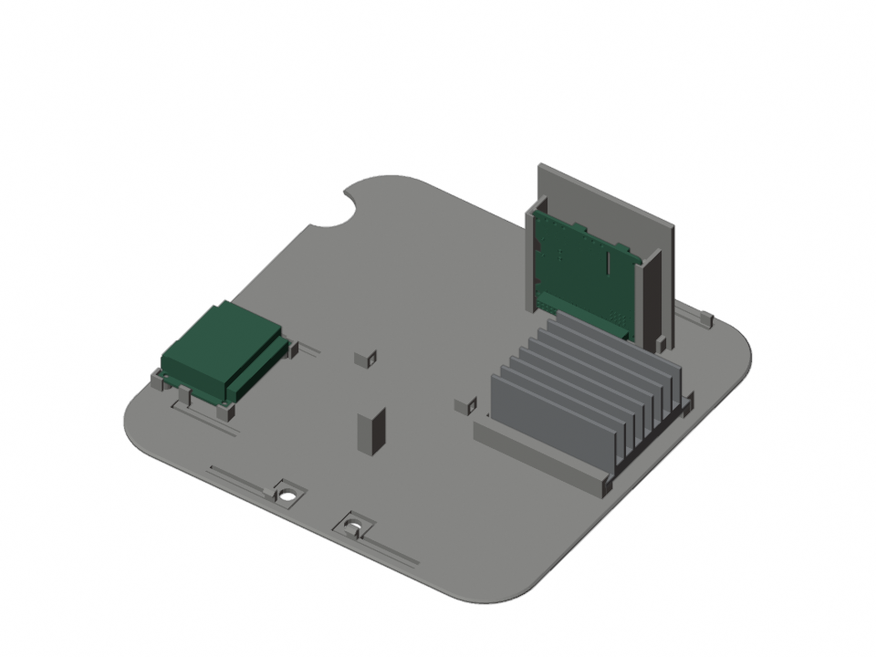
mm-launch-hw/v3/BUILD/renders/s12_floor_bench.png
