Every-Flavor-Robotics/mm-launcher/(commit log)

2026-11-02 M&M launcher: v1 and v2 hardware, MotorGo firmware and control panel, design loop
    - mm-launch-hw: v1 attempts 1-3, the design brief, purchased-part references and the launch test rig.
    - mm-launch-hw/v2: the modular v2 model frozen at attempt 7 (review 9/8/9, cadcheck 0 fails), with its
    bench build package and interactive assembly guide in v2/BUILD.
    - mm-launch-fw: MotorGo Axis (ESP32-S3) firmware and the WebUSB control panel, as they stood before the
    PACE RACER port.
    - orchestration: the plan/build/review workflow that produced v2.
    - README with the assembly guide and control panel.
    [arm_cap_l.stl, arm_cap_r.stl, arm_cover_l.stl, arm_cover_r.stl, backplate.stl, base.stl, base_floor.stl, base_partition.stl]
2026-11-02 v3 min-hardware attempt 1: printed joints replace 93 of 107 metal parts
    Starts from v2 attempt 7 (103 screws, 4 nuts, 36 printed parts). Attempt 1: 11 screws + 3 nuts,
    4 specs, 25 printed parts; cadcheck 0 fails / 61 warns; review 8/8/8, hardware elegance 7.
    Tools: alex-3d-skills next c2c282d.
    [base_floor.stl, base_shell.stl, beam.stl, encoder_cap.stl, encoder_jig.stl, feeder_crown.stl, feeder_disc.stl, feeder_pinion.stl]
2026-11-02 v3 attempt 2 hotfix: beam hook seats in its slot, valve key rib clears, gate detents open and closed
    Closes review v3-A1-01 and v3-A1-03. Full cadcheck 0 fails / 69 warns (11 untriaged insertion/clearance
    warns, the set newer tools raise on the attempt-1 geometry). Counts unchanged: 14 metal, 4 specs,
    25 printed parts. Reprint beam, jar_adapter, jar_gate. Tools: alex-3d-skills next 64c5947.
    [base_floor.3mf, base_floor.stl, base_shell.3mf, base_shell.stl, beam.3mf, beam.stl, encoder_cap.3mf, encoder_cap.stl]
2026-11-02 v3 build package: bench assembly, measure-first, shopping list, print plan, plates, interactive guide
    Modelled on v2/BUILD. Documents attempt 1 + the attempt-2 hotfix: 25 printed parts, 11 screws + 3 nuts.
    Print plan: 8 plates, about 29.5 h and 1.8 kg (geometry estimates, no slicer). Fit-coupon plates 0a/0b
    print first. Interactive guide (guide/assembly_guide.html): 25 steps, all clean; headless test 85/85.
    [base_floor.stl, base_shell.stl, beam.stl, c1_beam_hook_beam.stl, c1_beam_hook_post.stl, c2_hub_socket.stl, c3_crown_hook_beam.stl, c3_crown_hook_crown.stl]
